uge/ew-1/hardware/exports/voltage_map_heatmap.png

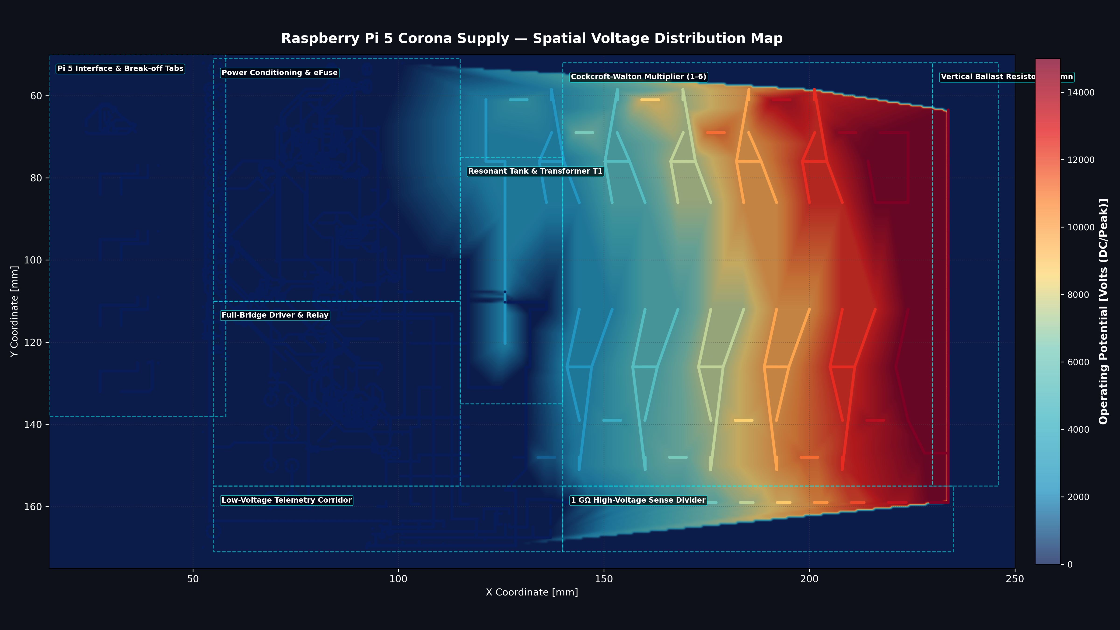
hardware/exports/voltage_map_heatmap.png
