uge/ew-1/hardware/pi5_corona_hat_direct/exports/voltage_map_heatmap.png

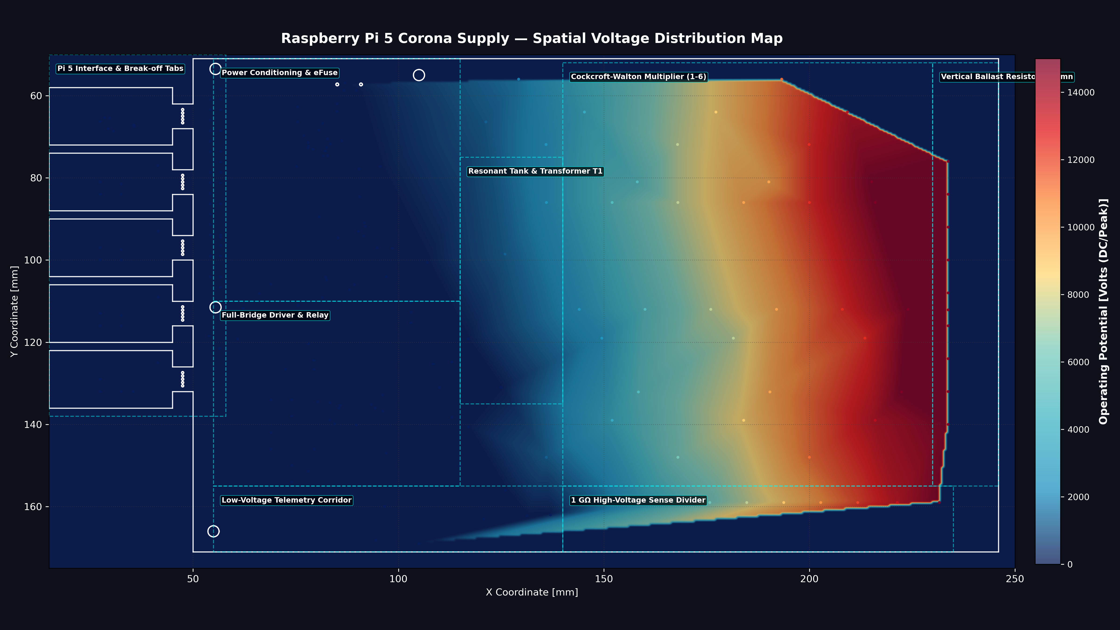
hardware/pi5_corona_hat_direct/exports/voltage_map_heatmap.png
