uge/ew-1/hardware/erc_report.txt

ERC report (2026-09-27T11:31:40, Encoding UTF8)
Report includes: Errors, Warnings

***** Sheet /
[lib_symbol_mismatch]: Symbol 'SRN6028-3R9M' doesn't match copy in library 'ionic_thrust_hv'
    ; warning
    @(76.20 mm, 88.90 mm): Symbol L1 [SRN6028-3R9M]

***** Sheet /01_power_mcu/

***** Sheet /02_drive_transformer/

***** Sheet /03_multiplier/

***** Sheet /04_sense_safety/

 ** ERC messages: 1  Errors 0  Warnings 1

 ** Ignored checks:
    - Global label only appears once in the schematic
    - Four connection points are joined together
    - SPICE model issue
    - Assigned footprint doesn't match footprint filters
