uge/ew-1/docs/ionic_thrust_hv_kicad_handoff.docx

# Ionic Thrust High Voltage Supply KiCad Engineering Handoff

ESP32 controlled 12 V to 15 kV DC corona supply

Item | Value
Document status | Pre schematic engineering handoff
Revision | A
Prepared | 27 September 2026
Intended use | Supervised ionic plasma thrust demonstration in a closed polycarbonate enclosure
Electrical target | 12 V input, approximately 10 to 15 kV positive DC, 150 microampere maximum intended corona current
Primary CAD target | KiCad project with JLCPCB assembly outputs and manually installed high voltage parts

Release condition. Do not order the PCB from this document alone. The KiCad project must complete the open electrical decisions, add the listed safety ECOs, pass ERC and custom high voltage DRC, and complete footprint and polarity reviews.

# Purpose and handoff decision

This document converts the current component workbook and design discussion into a KiCad implementation specification. The baseline is a low current corona source for ionic thrust experiments. It is not an arc generator and should shut down on an arc. The main design path is viable, but the schematic is not ready for fabrication until the bleeder network, current sensing, hardware interlock, exact multiplier polarity, and output connector arrangement are resolved.

The KiCad designer should preserve the existing selected parts unless a conflict is found, annotate all symbols from the schematic, and regenerate the BOM from KiCad. Reference designators in the current workbook are provisional where no schematic yet exists.

## Current design status

Area | Status | Handoff requirement
Power and controller | Defined | Capture AP63203 typical application, ESP32 boot and programming circuits, and always on 3.3 V rail.
Bridge and transformer | Defined with verification | Use DRV8220 DSG and FL2015-4LD. Confirm the primary connection and C11 series resonance on the bench.
Multiplier | Topology pending capture | Draw a positive six stage Cockcroft Walton ladder and independently review every diode and capacitor orientation.
Voltage measurement | Defined | Implement the 1 G ohm divider, TLV9001 follower, ADC isolation resistor, clamp, and RC filtering.
Current measurement | Incomplete | Add a protected ADC path from the 10 k ohm return shunt before claiming active current limiting.
Stored energy discharge | Incomplete | Add one 100 M ohm 3.5 kV resistor across each multiplier capacitor.
Lid interlock | Specified but absent from BOM | Add two normally open lid switches and a DPDT 12 V relay that removes bridge power in hardware.
HV connector | Off board choice | Use a recessed source side socket and prevent energization while disconnected.

# System architecture

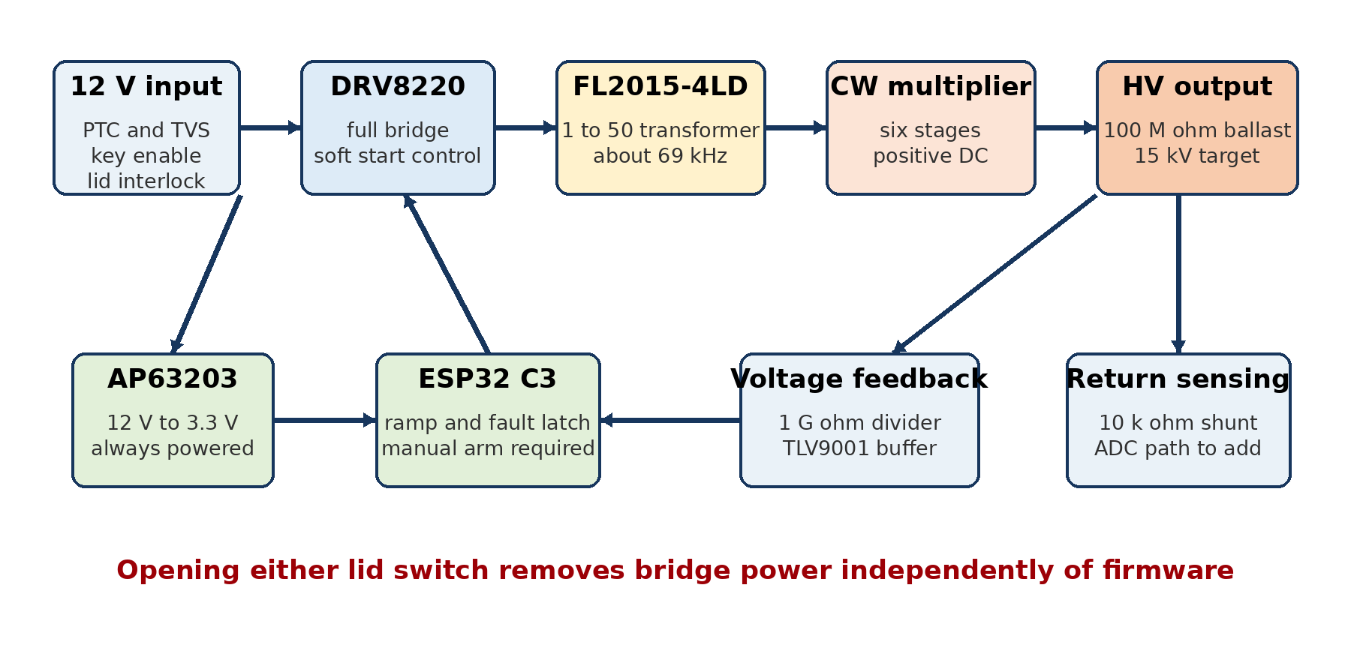
[picture p3: figure]

Figure 1 Electrical and safety architecture

## Nominal calculations

Check | Basis | Nominal result
Primary resonance | 44 microhenry and 120 nanofarad | 69.3 kHz
Ideal unloaded multiplier | 2 times 6 stages times 1000 V RMS times square root of 2 | 17.0 kV
Output setting | Firmware regulated below ideal no load voltage | 10 to 15 kV
Ballast short circuit limit | 15 kV divided by 100 megohm | 150 microampere
Ballast dissipation at short circuit | 15 kV squared divided by 100 megohm | 2.25 W total or 0.225 W per resistor
Divider output at 15 kV | 1 G ohm high side and 164 k ohm low side | 2.46 V
Divider current and loss | 15 kV across 1.000164 G ohm | 15.0 microampere and 0.225 W
Current shunt at target current | 150 microampere through 10 k ohm | 1.50 V

# KiCad project organization

Create one hierarchical project with the high voltage boundary visible at the top level. Avoid a single flat schematic because the physical isolation, return path, and interlock are easier to review when each function has a dedicated sheet.

File or sheet | Purpose | Primary contents
ionic_thrust_hv.kicad_pro | Project configuration | ERC exclusions, text variables, board setup, net classes, fabrication settings
ionic_thrust_hv.kicad_sch | Top level | Functional blocks, hierarchical labels, power partition, test points
01_power_mcu.kicad_sch | Always on low voltage | J1, F1, D2, AP63203, ESP32, reset, boot, UART header, arm switch and LED
02_drive_transformer.kicad_sch | Isolated AC generation | DRV8220, local bypassing, MODE and nSLEEP, C11 and T1
03_multiplier.kicad_sch | High voltage generation | D10 through D21, C20 through C31, per capacitor bleeders and ladder test nodes
04_sense_safety.kicad_sch | Feedback and shutdown | Ballast, voltage divider, TLV9001, current shunt ADC path, interlock relay and connector
ionic_thrust_hv.kicad_sym | Project symbols | FL2015-4LD and any field installable HV device symbols
ionic_thrust_hv.pretty | Project footprints | Transformer, HV diode, HV capacitors, HV resistors, slots and warning markings

## Named nets

Net | Meaning | Layout treatment
VIN_12 | Unprotected 12 V input | Short path to PTC and TVS
VIN_PROTECTED | Protected 12 V and relay coil source | Feeds always on buck and safety chain
HV_VM | Relay switched bridge supply | Bulk and 100 nF bypass at DRV8220
3V3 | Controller and analog rail | Solid low voltage ground reference
DRV_A and DRV_B | Bridge outputs | Short symmetric high di dt loop
PRI_A and PRI_B | Transformer primary ends | C11 is in the chosen resonant path
SEC_A and SEC_B | Floating transformer secondary | Enter multiplier without crossing low voltage copper
CW_P1 through CW_P6 | Multiplier pump nodes | Number explicitly in the schematic and silk
CW_S1 through CW_S6 | Multiplier stack nodes | Use stage based voltage spacing
HV_RAW | Multiplier output before ballast | No external connector
HV_OUT | Current limited positive output | After the ten resistor ballast string
HV_RETURN | Experiment and multiplier return | Connect to GND only through the defined shunt path
HV_SENSE_RAW | Divider low node | Guard from switching nodes and buffer immediately
HV_SENSE_ADC | Protected ESP32 ADC input | After R7 and D1 clamps
INTERLOCK_OK | Hardware interlock feedback | 3.3 V contact logic with physical pulldown

## Proposed ESP32 pin map

This map avoids the GPIO8 and GPIO9 boot strap combination except for the dedicated boot button. Confirm peripheral routing in firmware before final annotation.

Module signal | Function | Notes
GPIO0 ADC1 CH0 | HV voltage sense | Existing design assignment
GPIO1 ADC1 CH1 | HV return current sense | Required ECO with input protection
GPIO3 | INTERLOCK_OK | Pulldown gives open or unpowered state as false
GPIO4 | DRV IN1 or PH | Driver control
GPIO5 | DRV IN2 or EN | Driver control
GPIO6 | ARM input | Momentary switch, active level documented in firmware
GPIO7 | Status LED | Do not use as the only HV safe indication
GPIO9 | BOOT | Momentary switch to ground; retain normal boot pullup
GPIO20 and GPIO21 | UART RX and TX | 3.3 V programming header
EN | Reset | Pullup and reset switch

# Schematic capture requirements

## Power and controller sheet

- Route J1 through F1 to VIN_PROTECTED. Place D2 across VIN_PROTECTED and GND with the cathode at VIN_PROTECTED.
- Implement the AP63203 fixed 3.3 V application from the manufacturer reference: 3.9 microhenry L1, 10 microfarad input capacitance, two 22 microfarad output capacitors, 100 nanofarad bootstrap capacitor, and local grounding.
- Keep the ESP32 module antenna at the board edge and reproduce the manufacturer antenna keepout in every copper, mask, and component layer.
- J2 is a 3.3 V UART programming header for 3V3, GND, TX, RX, EN, and GPIO9. Label the connector pin one and voltage on silk.
- The MCU rail remains powered while the hardware interlock removes HV_VM. This allows fault logging and discharge monitoring after a lid trip.

## Bridge and transformer sheet

- Use the DRV8220 DSG WSON package and include the exposed pad in the footprint and ground connection. Place 100 nanofarad and bulk capacitance directly at VM and GND.
- Provide a physical pulldown on nSLEEP. The relay auxiliary contact must force nSLEEP low when the enclosure is open, regardless of MCU state.
- Select and document one DRV8220 interface mode. The baseline workbook assumes complementary IN1 and IN2 drive. PH and EN mode is an acceptable alternative only after firmware and startup behavior are reviewed.
- Use T1 primary pins 1 and 3 for full winding excitation and leave primary center tap pin 2 unused for the full bridge configuration. Confirm this mapping against Coilcraft schematic A and by continuity before assembly.
- Treat C11 as a provisional series resonant component in the full bridge path. Simulate and bench verify switching current before final release. Add a DNI option or jumper arrangement if direct drive must be compared during bring up.
- T1 secondary pins are 5 and 8 and feedback pins are 4 and 9 under Coilcraft schematic A. Unused physical pads remain present and marked no connect only after the footprint review.

## Multiplier and polarity review

Capture a standard positive half wave six stage Cockcroft Walton multiplier using D10 through D21 and C20 through C31. Use explicit SEC_A, SEC_B, CW_Pn, and CW_Sn labels instead of relying on wire shape. Place a polarity arrow beside every diode and identify HV_RAW and HV_RETURN on both schematic and silk.

- Simulate the ladder with the intended transformer amplitude before assigning the final PCB. Confirm positive HV_OUT relative to HV_RETURN.
- Add one 100 megohm 3.5 kV resistor directly across each C20 through C31. Suggested designators are R40 through R51.
- Do not series connect ordinary low voltage capacitors as substitutes. The selected 1 nanofarad 6 kV parts are manually installed.
- Expose no finger accessible test point. Any HV test pad stays inside the interlocked enclosure and receives a danger marking and keepout.

## Voltage and current measurement

- Place R30 through R39 as a physical ten resistor 1 G ohm string from HV_OUT to HV_SENSE_RAW. Maintain stage appropriate spacing between every resistor body and adjacent copper.
- Use R8 and R9 in series for the 164 k ohm low leg. Place C13 and the TLV9001 input at the low end of the divider, not beside the HV string.
- Configure U4 as a unity gain follower. Route its output through R7 to HV_SENSE_ADC and place the BAT54S clamp at the ESP32 side of R7.
- Add a separate protected current sense path from the 10 k ohm HV_RETURN shunt to GPIO1. Include a series resistor, RC filter, and clamp sized for plausible fault transients. Do not reuse the voltage sense clamp without checking simultaneous injection current.
- Use ADC calibration against a rated external HV probe. Firmware conversion starts near 6.099 kV per ADC volt but must use measured resistor ratios and ADC calibration data.

# Hardware safety interlock

Use two mechanically actuated normally open lid switches at opposite corners. Both must be depressed before the 12 V relay can energize. The switches and relay act only on the low voltage side. No inexpensive microswitch or PCB relay in this design is permitted to switch the 15 kV output.

Reference | Suggested part | LCSC | Connection
S3 and S4 | Omron D2F L lever microswitch | C231337 | COM and NO contacts in series with K1 coil
K1 | N4078 2C DC12V 0.2W DPDT relay | C52195125 | Pole A switches HV_VM; pole B provides nSLEEP and interlock logic
D3 | 1N4148WS or suitable coil flyback diode | Select during capture | Across K1 coil, cathode toward positive supply
S5 | Key enable or latching emergency stop | Off board | In series ahead of the lid switch chain
S6 | Momentary ARM switch | Select during capture | MCU input only; closing the lid must not restart HV

## Interlock sequence

1. Closing and latching the lid depresses both S3 and S4 and permits K1 to energize.

2. K1 supplies HV_VM and releases the hard nSLEEP pulldown. The ESP32 remains disarmed.

3. The operator presses ARM. Firmware checks both interlock state and measured discharge state before starting a controlled voltage ramp.

4. Opening either side of the lid drops K1, removes HV_VM, drives nSLEEP low, and records an interlock fault independently of firmware control outputs.

5. Closing the lid again does not restart the bridge. A new ARM action is required after the measured voltage is safe.

## Mechanical requirements

- Mount the two switches near opposite corners so a flexible lid cannot remain energized when partly open.
- Set the actuators to open within the first 1 to 2 mm of lid travel. Use an overlapping 25 to 40 mm lip so the circuit opens before a hand can reach the HV area.
- Use two latches. Do not use a magnet and reed switch as the sole interlock because a loose magnet can defeat it.
- Polycarbonate is preferred to acrylic for impact resistance. Account for ozone and nitrogen oxide ventilation without creating a finger access path.

# High voltage output connection

For the 15 kV baseline, the stocked TE LGH pair 5-861610-3 and 5-862197-3 is rated 20 kVDC. Because the bulkhead receptacle uses a pin contact, do not place an energized exposed pin on the generator panel. Use a permanently attached generator pigtail terminated in the recessed socket plug, or select a source side female bulkhead system.

Option | Use | Decision
TE LGH 20 kV | Baseline at a controlled 15 kV maximum | Accept only with recessed source contact, clean dry mating surfaces, and interlock disable while disconnected
Amphenol Alden B series 35 to 40 kV | Preferred where arcs or contamination are expected | Higher margin and cost; suitable upgrade before intentional arc tests
Permanent potted HV lead | Lowest cost supervised prototype | Often safer and cheaper than a removable connector when the electrode assembly is fixed

# PCB layout and KiCad design rules

Use a two layer board unless a later review establishes an inner layer isolation strategy. Keep low voltage ground pours in the controller and driver region only. Do not place copper, vias, planes, mounting hardware, or silkscreen text beneath the multiplier, divider string, transformer secondary, or HV connector region.

Rule group | Starting rule | Implementation note
LV_SIGNAL | 0.20 mm clearance and 0.20 mm track | ESP32, analog, UART and control
12V_POWER | 0.25 mm clearance and at least 0.50 mm track | Increase bridge supply width from measured input current
PRIMARY_SWITCH | 0.50 mm clearance and 0.75 to 1.00 mm track | Minimize DRV8220, C11 and T1 loop area
HV_STAGE | At least 4 mm between adjacent ladder stage copper | Assumes about 2.8 kV maximum capacitor stress; enlarge where board area permits
HV_HIGH_TO_LV | At least 20 mm plus routed isolation slots | Use 25 mm if operation may reach 20 kV
HV_OUT_TO_EDGE | At least 10 mm | More near mounting holes, fasteners, vents, and enclosure seams
HV_DIVIDER | Stage the resistor string physically | No single resistor or pad sees the entire output voltage

These are conservative project rules for a clean, enclosed laboratory prototype, not an IEC or UL compliance claim. Pollution degree, altitude, material group, coating qualification, enclosure geometry, and manufacturing residue can require larger distances. Do not reduce spacing because conformal coating is planned.

## Placement order

1. Place ESP32 and its antenna keepout at one board edge.

2. Place J1, F1, D2, AP63203, and the low voltage controls together.

3. Place DRV8220, local bypassing, C11, and T1 primary as one compact switching region.

4. Rotate T1 so its secondary faces directly into the first multiplier stage.

5. Arrange the six multiplier stages as a straight or gently folded ladder with monotonically increasing physical voltage.

6. Place the output ballast and divider as separate long strings leading away from the low voltage section.

7. Place U4 and low side sensing at the grounded end of the divider behind an isolation slot.

## Custom footprint requirements

Footprint | Requirement
Coilcraft FL2015-4LD Package 1 | Create from the current manufacturer drawing. Package uses 2.50 mm terminal pitch and manufacturer recommended lands. Include complete pad numbering, courtyard, pin one mark, body outline, and secondary side marking. Print 1 to 1 and verify against a sample.
DO 722 HVM12 | Use the manufacturer body and lead dimensions. Provide adequate lead forming and keep the body raised only if the assembly procedure specifies it.
6 kV disc capacitor | Verify lead pitch, body diameter, thickness, and body to board spacing from the selected Vishay part. Do not substitute a generic 10 mm pitch footprint without the body check.
3.5 kV axial resistor | Use the actual body length and 15.24 mm lead pitch. Keep exposed leads short while preserving pad to pad clearance.
Isolation slots | Use Edge Cuts geometry with rounded slot ends. Obtain JLCPCB minimum routed slot capability before finalizing width.

# Existing component mapping

The following tables reproduce the current workbook selections. KiCad annotation remains authoritative after schematic capture. Any changed reference, quantity, footprint, or MPN must be reconciled back into the assembly BOM.

Ref | MPN or value | Footprint | LCSC | Qty
U1 | ESP32-C3-WROOM-02-H4 | ESP32-C3-WROOM-02 | C2944070 | 1
U2 | DRV8220DSGR | WSON-8-EP_2x2mm_P0.5mm | C3681269 | 1
U3 | AP63203WU-7 | TSOT-23-6 | C780769 | 1
L1 | SRN6028-3R9M | Inductor_SMD_6x6mm | C2046441 | 1
C1,C2 | CC0805KKX5R8BB106 | C_0805_2012Metric | C89831 | 2
C3,C4 | TCC0805X5R226M100FT | C_0805_2012Metric | C380338 | 2
C5,C6,C7,C8,C9,C10,C12,C13 | CC0603KRX7R9BB104 | C_0603_1608Metric | C14663 | 8
R1,R2,R3,R4,R5 | 0603WAF1002T5E | R_0603_1608Metric | C25804 | 5
R6,R7 | 0603WAF1001T5E | R_0603_1608Metric | C21190 | 2
R8,R9 | 0603WAF8202T5E | R_0603_1608Metric | C23254 | 2
D1 | BAT54S | SOT-23 | C83935 | 1
D2 | SMAJ18A | SMA | C173513 | 1
F1 | nSMD100-16V | Fuse_1206_3216Metric | C70082 | 1
LED1 | 19-217/GHC-YR1S2/3T | LED_0603_1608Metric | C72043 | 1
SW1,SW2 | TS-1187A-B-A-B | SW_SMD_5.1x5.1mm | C318884 | 2
U4 | TLV9001IDBVR | SOT-23-5 | C398363 | 1

## Manual high voltage and through hole parts

Ref | MPN | Footprint | LCSC or source | Qty
J1 | WJ500V-5.08-2P | TerminalBlock_1x02_P5.08mm | C8465 | 1
J2 | DS1021-1x6SF11-B | PinHeader_1x06_P2.54mm_Vertical | C7430362 | 1
T1 | FL2015-4LD | Coilcraft_FL2015-4L_custom | Customer supplied | 1
C11 | BFC236821124 | C_Radial_P10.0mm | C3771644 | 1
D10-D21 | HVM12 | DO-722_custom | C7436450 | 12
C20-C31 | S102M59Z5UU83L0R | C_Disc_P10.0mm | C1620009 | 12
R20-R29 | MGR0W2J0106A10 | R_Axial_D3.5xL9.5_P15.24mm | C51904770 | 10
R30-R39 | MGR0W2J0107A10 | R_Axial_D3.5xL9.5_P15.24mm | C51904773 | 10

## Required BOM changes before fabrication

Change | Part or quantity | Reason
Add | 12 additional 100 M ohm 3.5 kV resistors, suggested R40 to R51 | One permanent bleeder across every multiplier capacitor
Add | Two Omron D2F L lid switches | Redundant case closure detection
Add | One 12 V DPDT relay and one coil diode | Hardware removal of bridge power and nSLEEP release
Add | Current sense filter and clamp parts | Protected ADC measurement of the 10 k ohm return shunt
Add | MODE strap and optional tuning or DNI components | Unambiguous DRV8220 interface selection and controlled bring up
Add or document | ARM switch, key enable or emergency stop, HV cable and connector | Off board safety and enclosure wiring
Review | F1 1 A trip margin | Confirm against measured resonant startup and steady state current

# Firmware interface and fault behavior

Firmware supports the electrical safety system but does not replace it. K1 must remove HV_VM even if the ESP32 is halted, rebooting, or holding a driver input active.

State | Bridge action | Exit condition
SAFE | HV_VM removed or nSLEEP low; PWM outputs low | Both lid switches closed and operator requests ARM
ARMED | K1 energized, bridge still idle | Interlock stable and measured voltage below safe threshold
RAMP | Increase drive gradually from zero | Target voltage reached or any limit trips
CORONA RUN | Regulate at the lowest stable corona voltage | Stop request, interlock opening, overvoltage, overcurrent, or arc signature
FAULT | PWM low and nSLEEP low; K1 drops where hardware chain is open | Voltage verified safe and operator manually rearms

- Start near the measured transformer resonance, expected around 69 kHz, and tune only within the validated transformer and driver range.
- Set the software voltage ceiling at or below 15 kV for the 20 kV connector baseline.
- Treat a rapid voltage collapse accompanied by rising current as an arc. Disable the bridge and latch the fault instead of attempting to sustain the arc.
- Do not display HV SAFE until the calibrated divider reports below 50 V continuously for at least one second. The indicator is supplemental; the discharge procedure still requires verification during service.
- Closing the lid never causes automatic restart.

# Bring up and validation plan

1. Run KiCad ERC. Resolve every power input, unconnected pin, and hierarchical label warning deliberately. Do not blanket suppress warnings.

2. Run standard DRC and the project specific HV clearance rules. Inspect the Gerbers and drill files for copper under slots, unexpected pours, and solder mask openings.

3. Assemble only the low voltage supply and ESP32. Verify 3.3 V, reset, boot mode, UART programming, and arm input behavior from a current limited 12 V source.

4. Populate DRV8220 without T1. Verify nSLEEP defaults low and opening either lid switch removes HV_VM. Exercise both switches separately and flex the lid at every edge.

5. Install T1 and test at reduced input voltage. Observe primary current with isolated instrumentation. Tune frequency and duty while remaining below transformer and driver limits.

6. Install the multiplier, ballast, divider, and bleeders. Begin with low drive and use only a probe rated above the maximum output. Never attach a normal oscilloscope ground lead to an HV node.

7. Calibrate voltage ADC gain and offset. Verify current sense at several known microampere loads made from suitably rated resistor strings.

8. Measure discharge time after shutdown and after an interlock trip. Require less than 50 V within five seconds or revise the bleeder network and indication logic.

9. Operate into the intended corona electrode inside the closed enclosure. Confirm stable corona, no visible arc, no surface tracking, and no reset or communication upset.

## Acceptance checklist

Check | Acceptance
Low voltage rail | 3.3 V remains within regulator tolerance during WiFi activity and bridge startup
Interlock | Either lid switch independently removes HV_VM and forces driver sleep without firmware cooperation
No automatic restart | Lid reclosure leaves the bridge idle until a new ARM command
Voltage limit | Calibrated output cannot exceed the approved 15 kV setting in normal control
Current limit | Ballast and measured current hold the intended corona current at or below 150 microampere
Arc response | Intentional small fault gap causes prompt shutdown and a latched fault, not repeated striking
Discharge | All multiplier sections and HV_OUT measure below 50 V within the approved interval
EMI behavior | ESP32 does not reset and interlock input does not chatter during corona operation
Thermal | DRV8220, transformer, resistors, and regulator remain within rated temperature at continuous operation
Documentation | Schematic, PCB, BOM, CPL, Gerbers, drill files, firmware pin map, calibration constants, and test results share one revision

# KiCad release deliverables

Deliverable | Required content
Schematic PDF | All hierarchical sheets, net names, resistor chain order, diode polarity, interlock contacts, connector pinout, and design notes
KiCad source | Project, schematic sheets, PCB, project symbol library, project footprint library, 3D models where available
Fabrication package | Gerbers, drill and route files, board drawing, stackup note, HV slot dimensions, and fabrication readme
JLCPCB assembly package | BOM and CPL generated from the released PCB with LCSC numbers and DNP status
Manual assembly list | Transformer, film capacitor, multiplier components, HV resistor strings, connector, relay, switches, wire, and enclosure hardware
Firmware interface | GPIO assignment, driver mode, fault thresholds, ADC calibration, arm sequence, and safe state behavior
Test record | Rail checks, waveforms, calibrated HV readings, current readings, interlock tests, discharge time, thermal observations

# Open decisions requiring signoff

Decision | Owner evidence needed
DRV8220 control mode and C11 placement | Schematic simulation and reduced voltage primary current waveform
Exact Cockcroft Walton node topology and polarity | Independent schematic review plus simulated positive output
Current sense input protection | Worst case transient calculation and bench injection test
HV connector or permanent lead | Enclosure drawing showing recessed source contact and interlock relationship
Final creepage and clearance | PCB review using actual enclosure, altitude, contamination, materials, and fabrication constraints
Discharge network | Measured capacitor and output decay to below 50 V
Arc testing scope | If intentional arcs remain required, upgrade the connector and protection plan before testing

# Manufacturer references

- Texas Instruments DRV8220 datasheet, https://www.ti.com/lit/ds/symlink/drv8220.pdf
- Diodes Incorporated AP63200 AP63201 AP63203 AP63205 datasheet, https://www.diodes.com/assets/Datasheets/AP63200-AP63201-AP63203-AP63205.pdf
- Espressif ESP32 C3 WROOM 02 datasheet, https://documentation.espressif.com/esp32-c3-wroom-02_datasheet_en.html
- Coilcraft FL Series CCFL transformer datasheet, https://www.coilcraft.com/getmedia/6651db01-d153-47d9-8a27-4758c28bff0d/fl.pdf
- TE Connectivity LGH 20 kV plug 5-861610-3 and receptacle 5-862197-3 product documentation
- Current project BOM workbook, jlcpcb_ionic_thrust_hv_supply_bom.xlsx, version 1

High voltage warning. This circuit can retain hazardous charge after input power is removed. Work only with the enclosure closed during operation, use appropriately rated probes and insulated tools, and verify discharge before service. Corona and arcs generate ozone, nitrogen oxides, heat, ultraviolet light, and electromagnetic interference.

Revision A | 27 September 2026 | Page

Ionic thrust high voltage supply KiCad engineering handoff
