uge/ew-1/docs/README.md

# Reference documents

The active editable project is [N-layout-17-hv-warnings](../hardware/pi5_corona_hat_direct/README.md).
Use its [validation workflow](../hardware/pi5_corona_hat_direct/layout/README.md)
and [current design status](../hardware/pi5_corona_hat_direct/AUDIT.md).

The original handoff documents, PDF, media and older runbook in this directory
are historical reference. Their older controller, layer-stack, filenames and
production-readiness statements do not override the active native design.
