uge/ew-1/hardware/archives/README.md

# Project archives

- `pi5-corona-hv-N-layout-14-surge-2026-10-19.tar.gz`: complete versioned working-tree checkpoint of **N-layout-14-surge**, created 2026-10-19. Includes 542 project files plus an archive README and per-file SHA-256 manifest.

Verify the archive with `sha256sum -c pi5-corona-hv-N-layout-14-surge-2026-10-19.tar.gz.sha256` from this directory. Extract it and open `pi5_corona_hat_direct/pi5_corona_hv.kicad_pro` in KiCad 10. Standard KiCad libraries are required.

This is a design checkpoint. Existing HV insulation/arc qualification remains open; included manufacturing exports may represent earlier revisions.
