uge/ew-1/hardware/pi5_corona_hat_direct/01_power_mcu.png

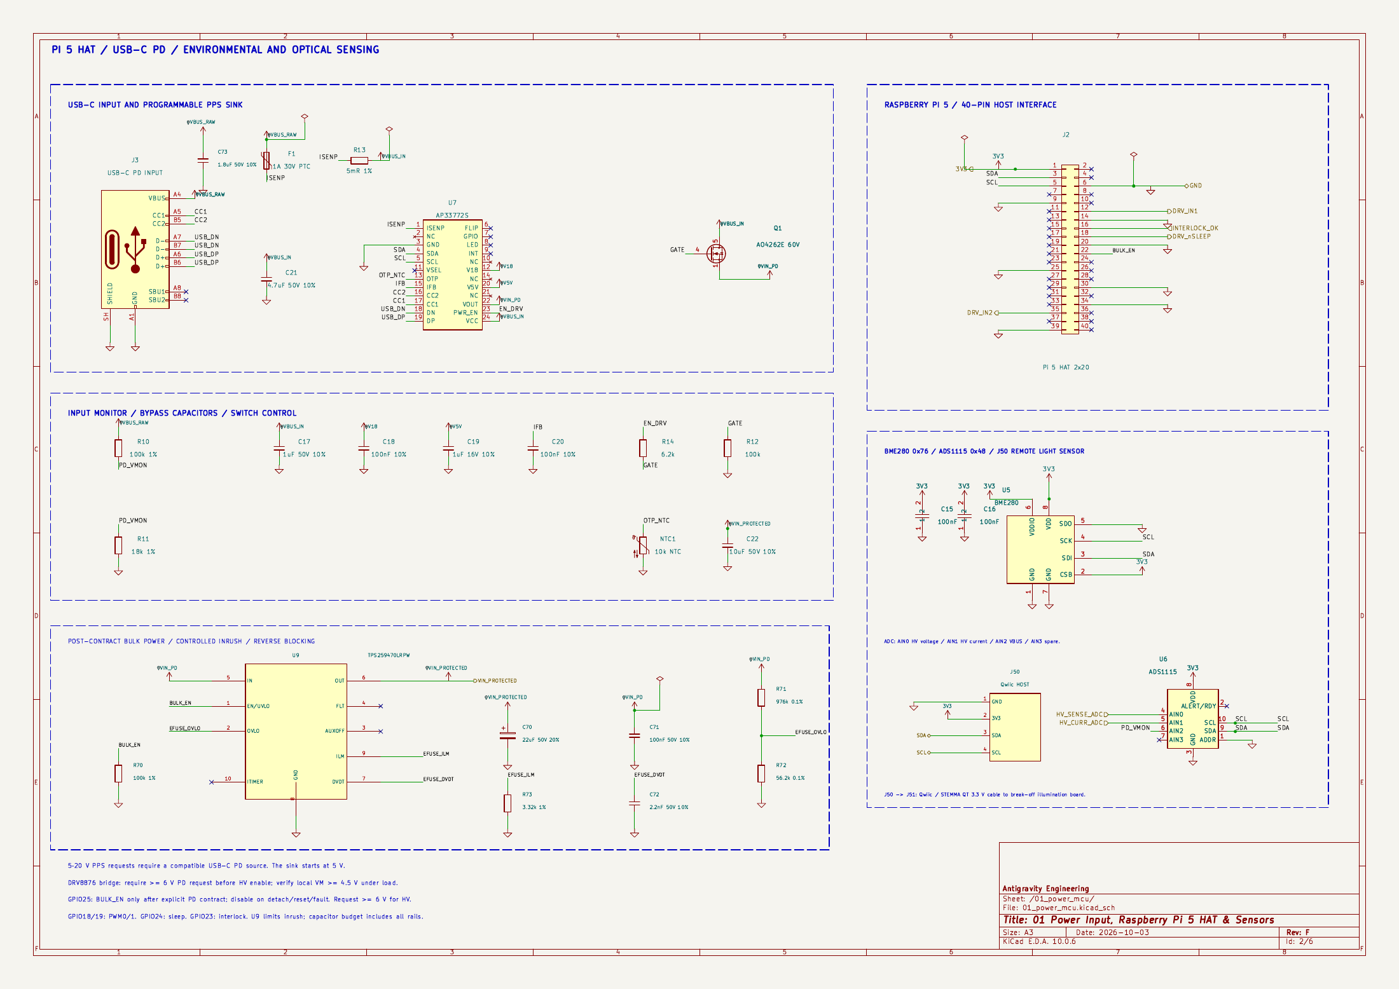
hardware/pi5_corona_hat_direct/01_power_mcu.png
