uge/ew-1/hardware/pi5_corona_hat_direct/exports/00_system_overview.png

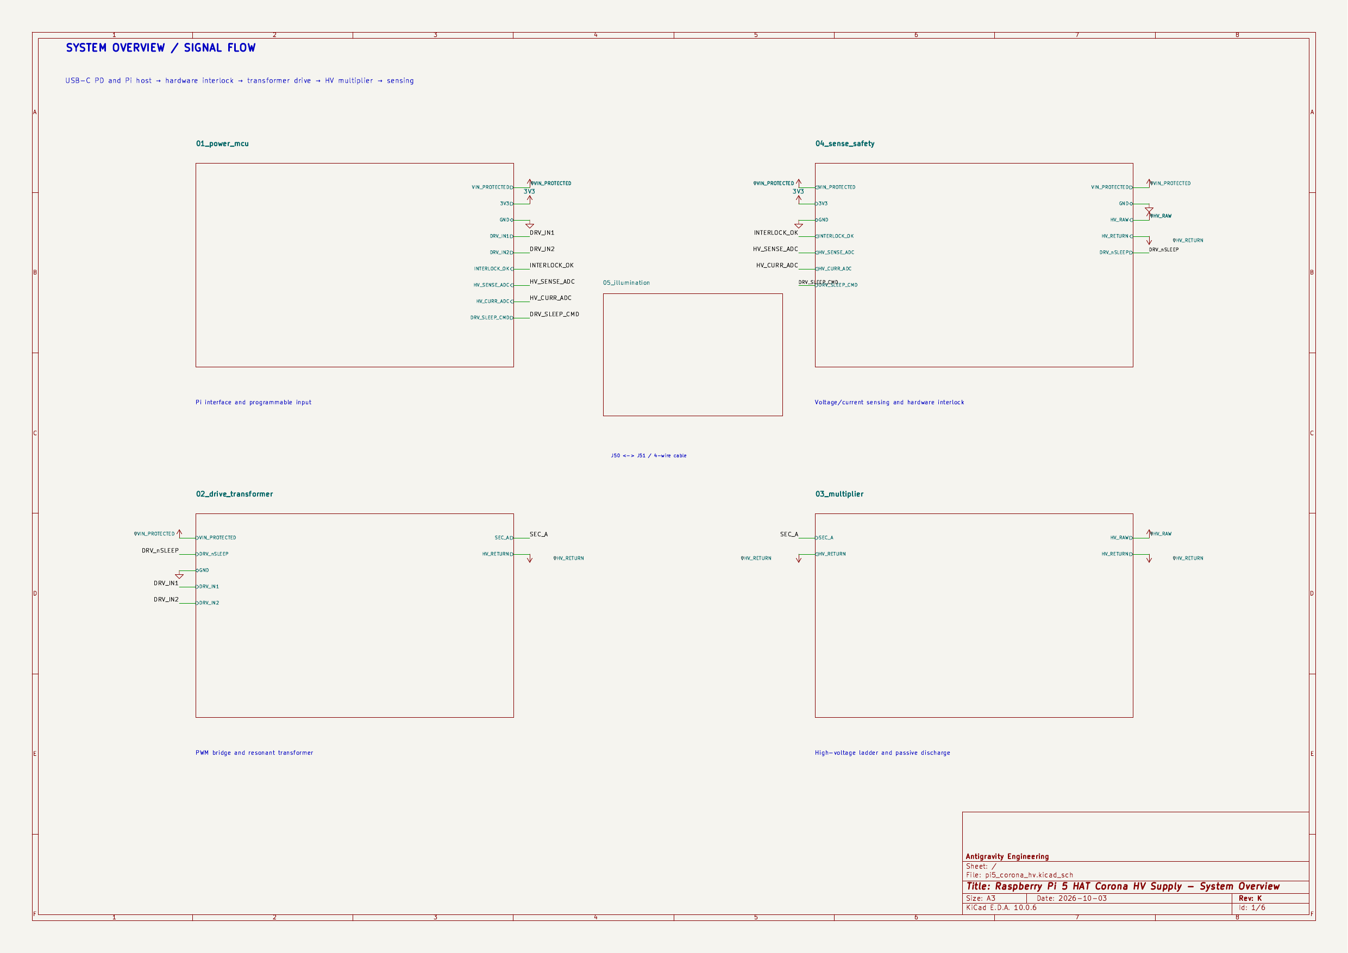
hardware/pi5_corona_hat_direct/exports/00_system_overview.png
