uge/ew-1/hardware/pi5_corona_hat_direct/exports/02_drive_transformer.png

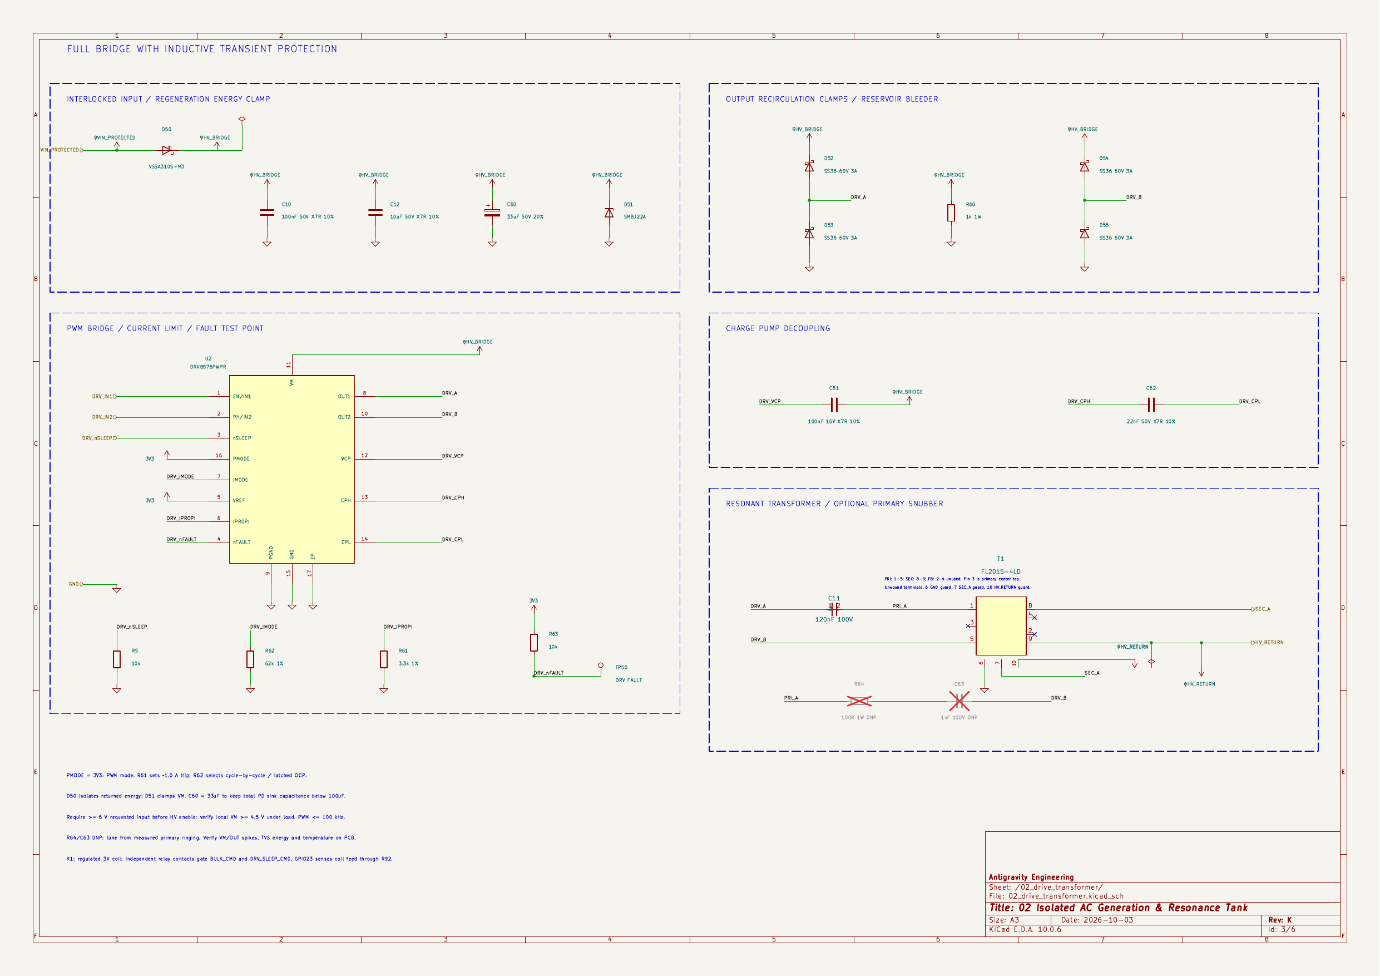
hardware/pi5_corona_hat_direct/exports/02_drive_transformer.png
