uge/ew-1/hardware/pi5_corona_hat_direct/exports/03_multiplier.png

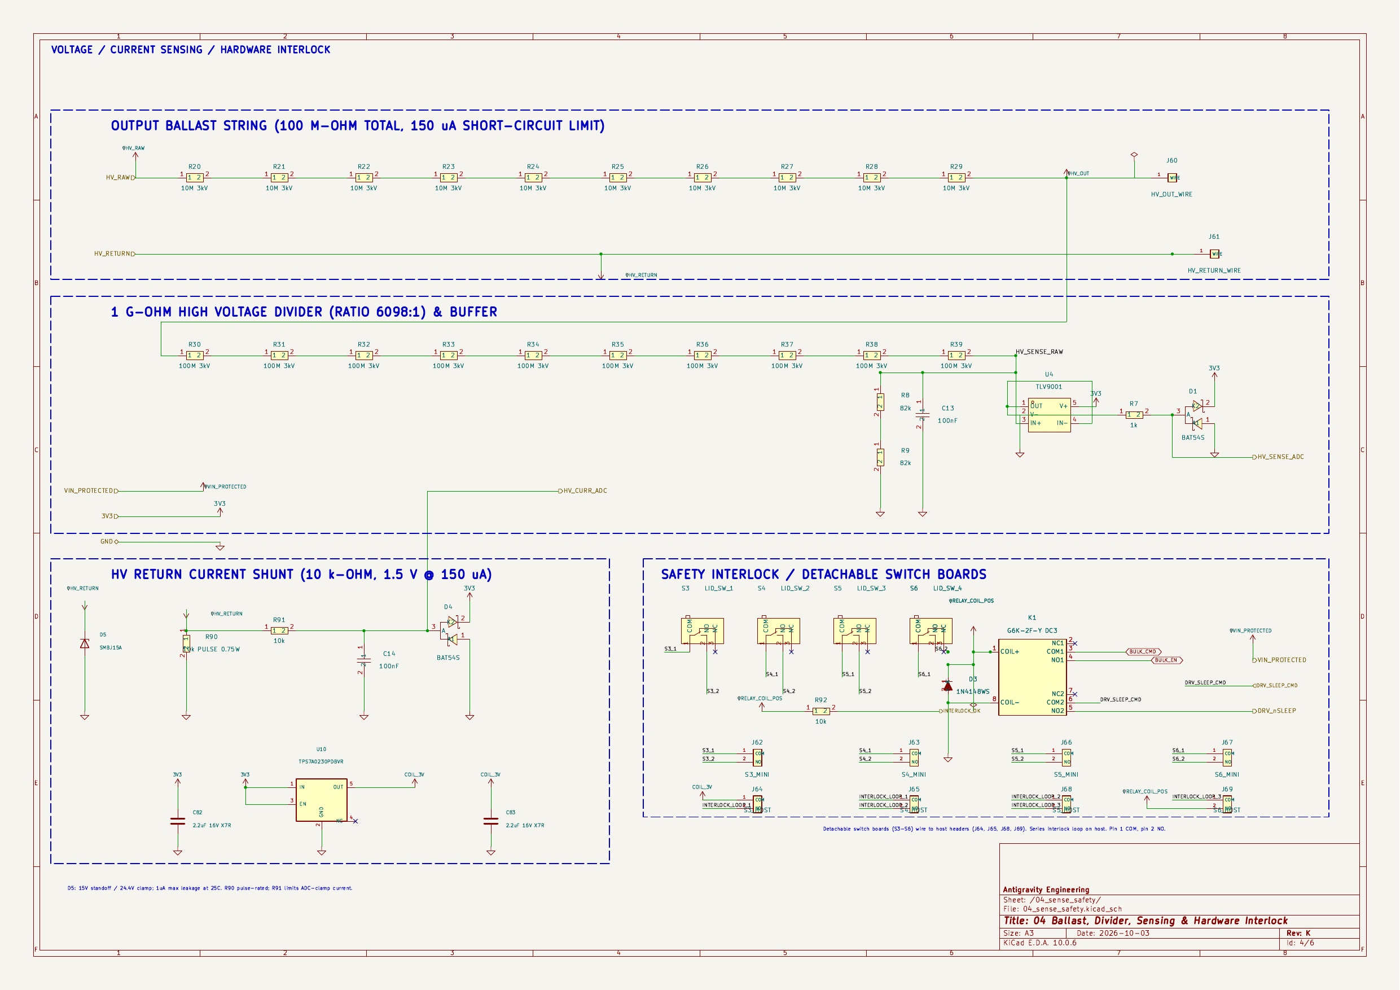
hardware/pi5_corona_hat_direct/exports/03_multiplier.png
