uge/ew-1/hardware/pi5_corona_hat_direct/exports/04_sense_safety.png

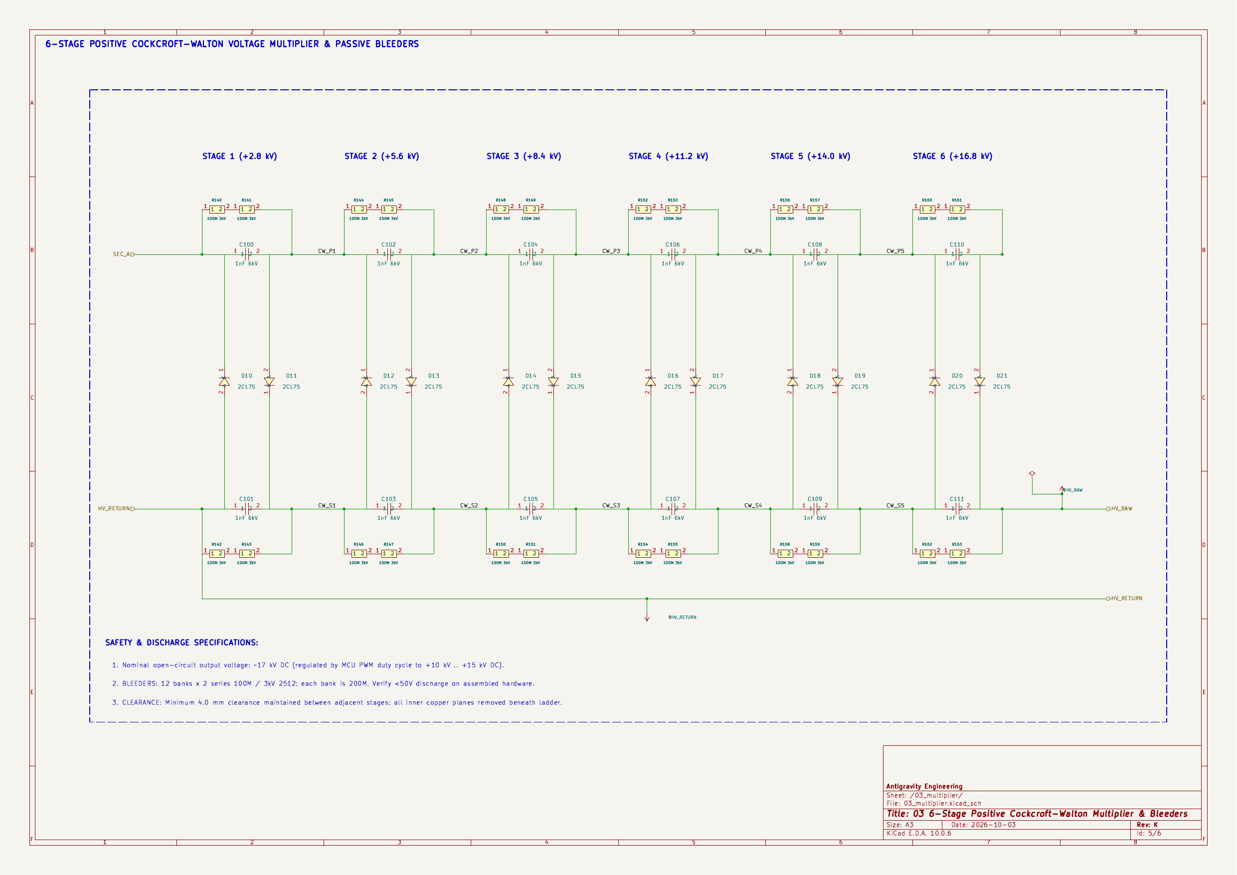
hardware/pi5_corona_hat_direct/exports/04_sense_safety.png
