uge/ew-1/hardware/pi5_corona_hat_direct/exports/05_illumination.png

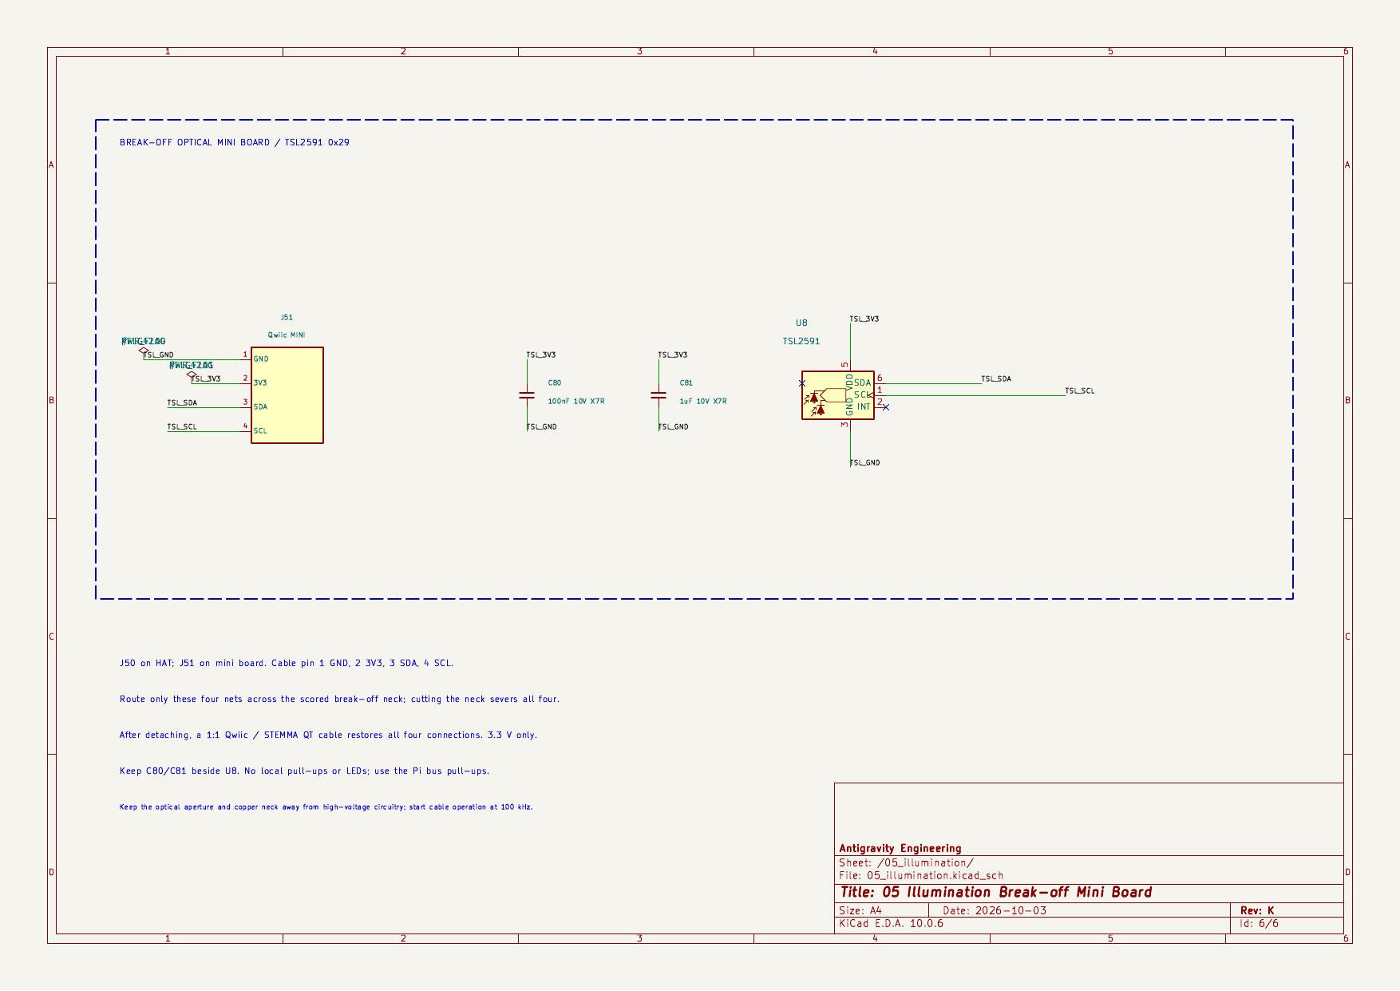
hardware/pi5_corona_hat_direct/exports/05_illumination.png
