uge/ew-1/hardware/pi5_corona_hat_direct/exports/hv-return-layout.png

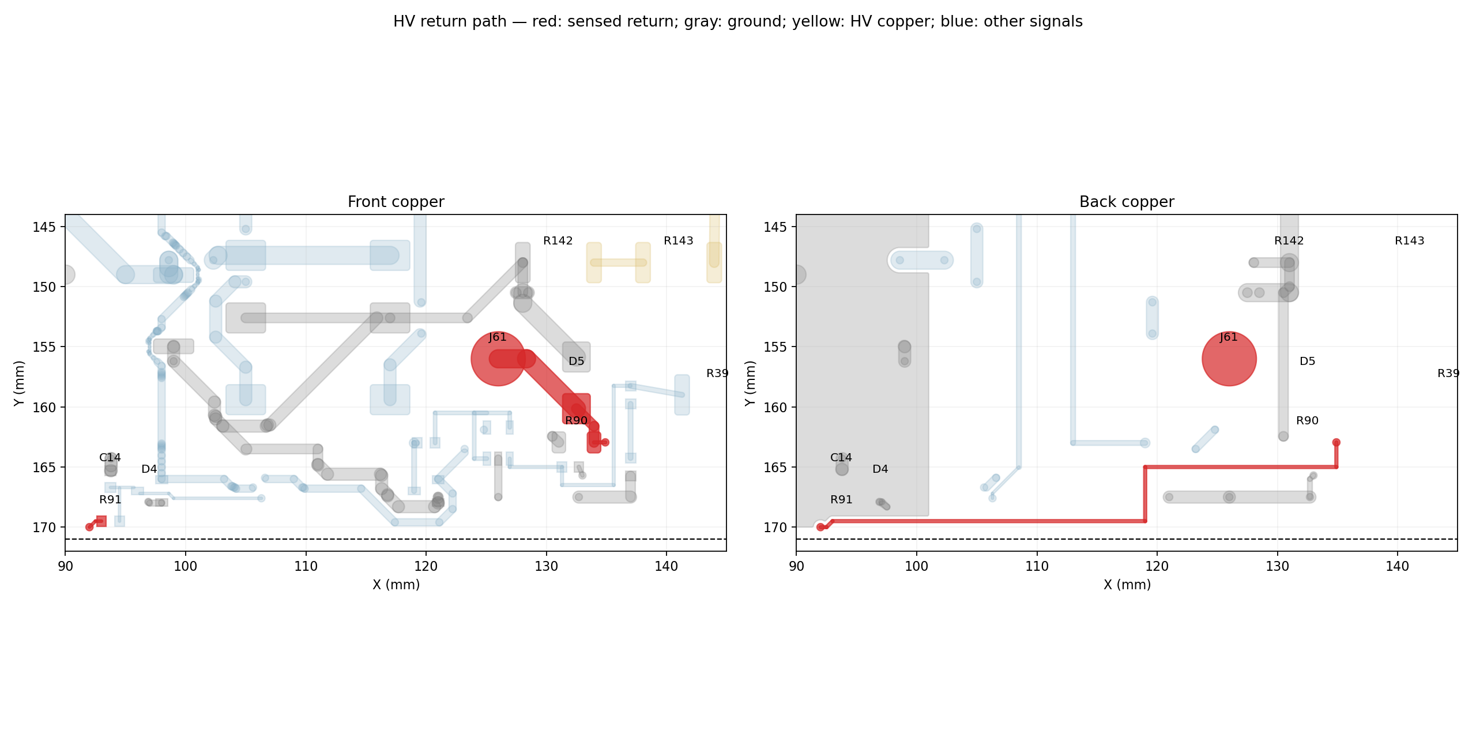
hardware/pi5_corona_hat_direct/exports/hv-return-layout.png
