uge/ew-1/hardware/pi5_corona_hat_direct/exports/initial-pcb-layout.png

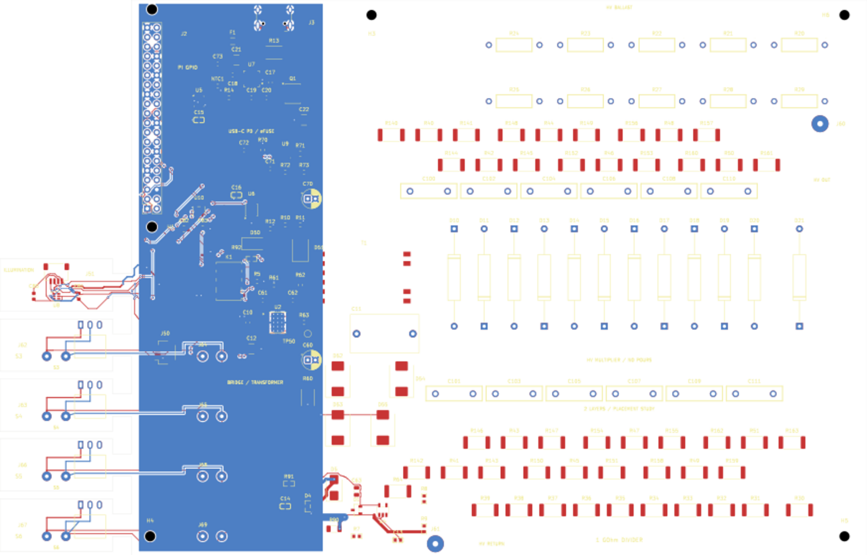
hardware/pi5_corona_hat_direct/exports/initial-pcb-layout.png
