uge/ew-1/hardware/pi5_corona_hat_direct/exports/jlcpcb-N-layout-17-hv-warnings/hv-warning-back.png

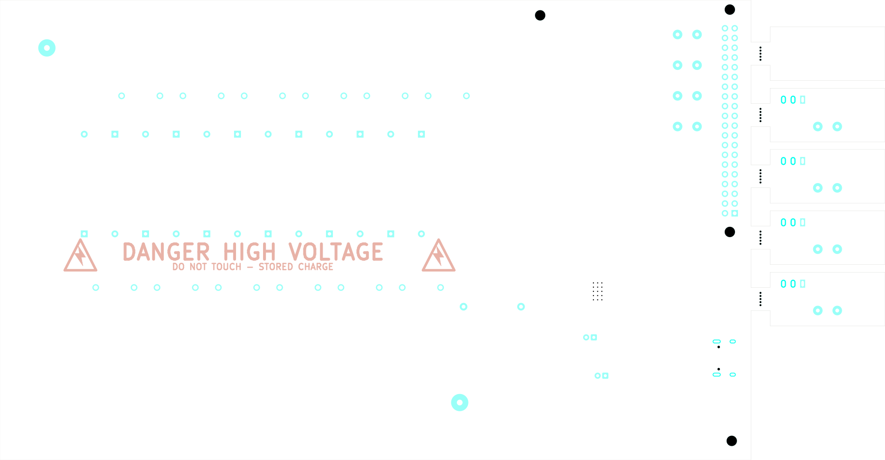
hardware/pi5_corona_hat_direct/exports/jlcpcb-N-layout-17-hv-warnings/hv-warning-back.png
