uge/ew-1/hardware/pi5_corona_hat_direct/exports/pi5-mechanical-bottom.png

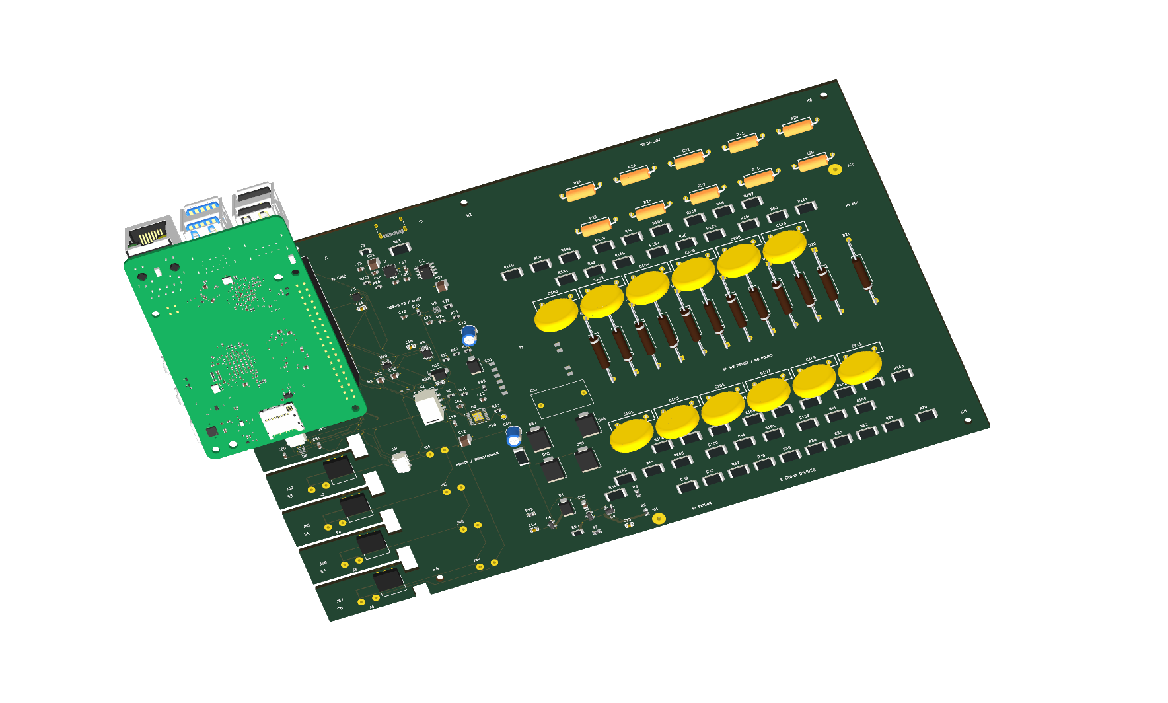
hardware/pi5_corona_hat_direct/exports/pi5-mechanical-bottom.png
