uge/ew-1/hardware/pi5_corona_hat_direct/exports/spice_multiplier_analysis.png

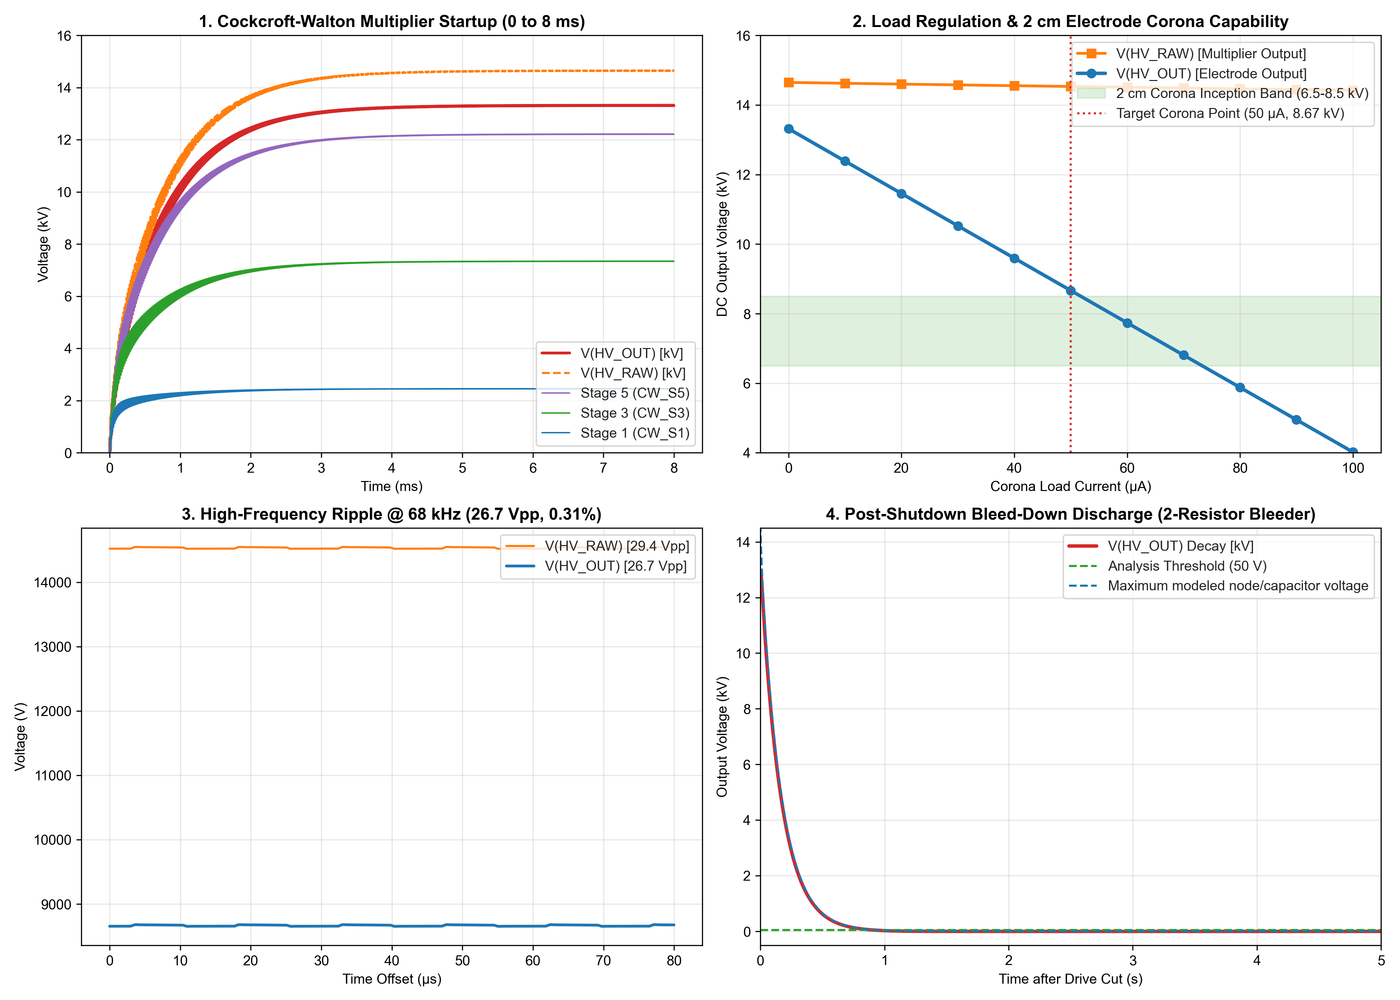
hardware/pi5_corona_hat_direct/exports/spice_multiplier_analysis.png
