uge/ew-1/hardware/pi5_corona_hat_direct/renders/board_bottom.png

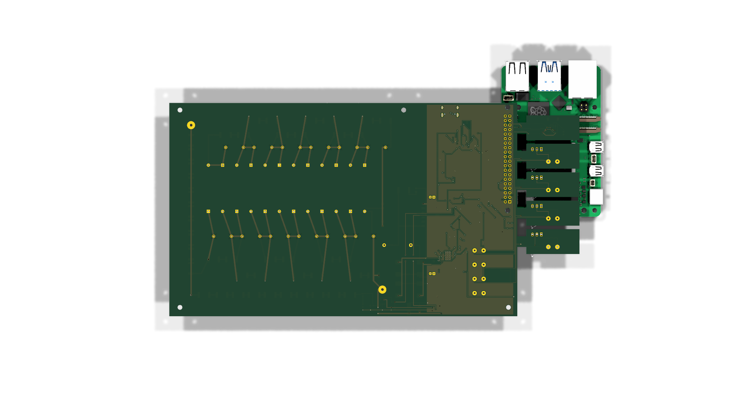
hardware/pi5_corona_hat_direct/renders/board_bottom.png
