uge/ew-1/hardware/pi5_corona_hat_direct/renders/hv-warning-front.png

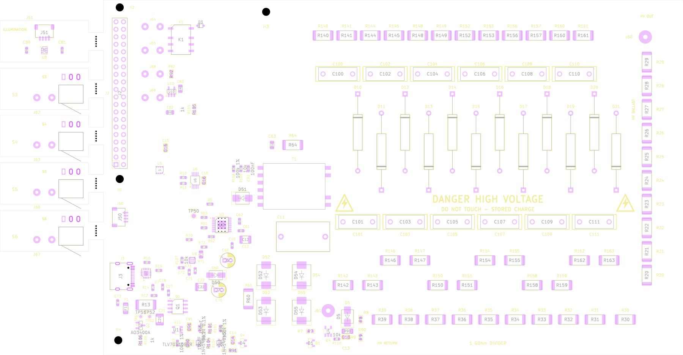
hardware/pi5_corona_hat_direct/renders/hv-warning-front.png
