uge/ew-1/hardware/pi5_corona_hat_direct/renders/pcb_render_iso.png

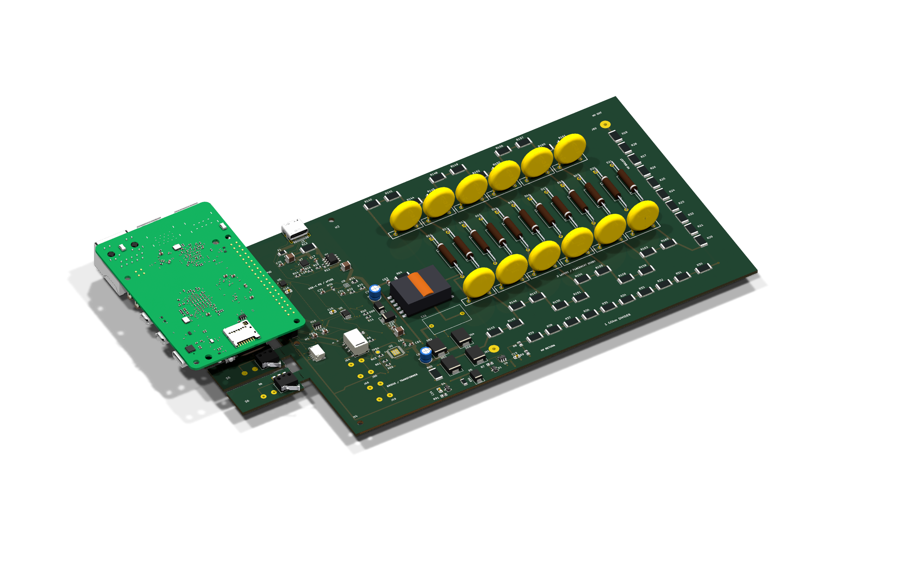
hardware/pi5_corona_hat_direct/renders/pcb_render_iso.png
