uge/ew-1/hardware/pi5_corona_hat_direct/renders/tabs_microswitches_closeup.png

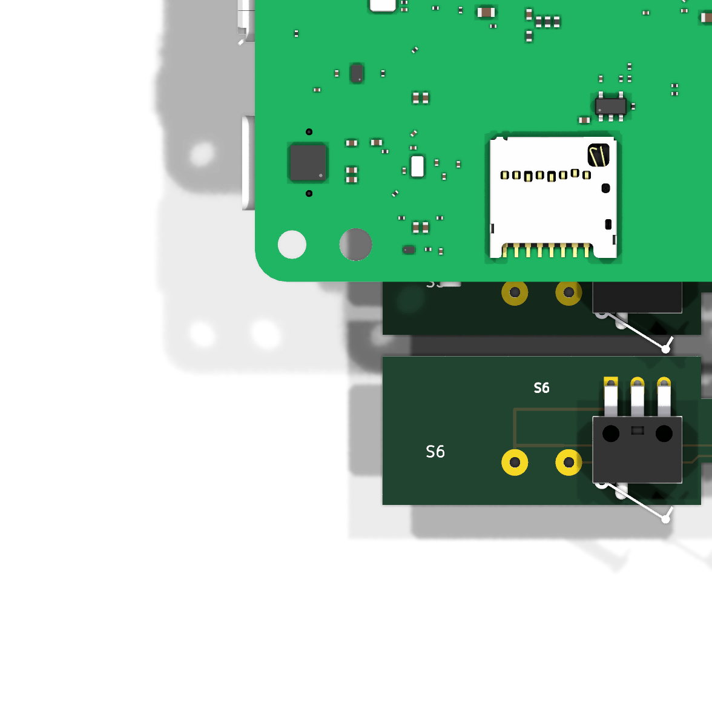
hardware/pi5_corona_hat_direct/renders/tabs_microswitches_closeup.png
