uge/ew-1/hardware/renders/sheet-1.png

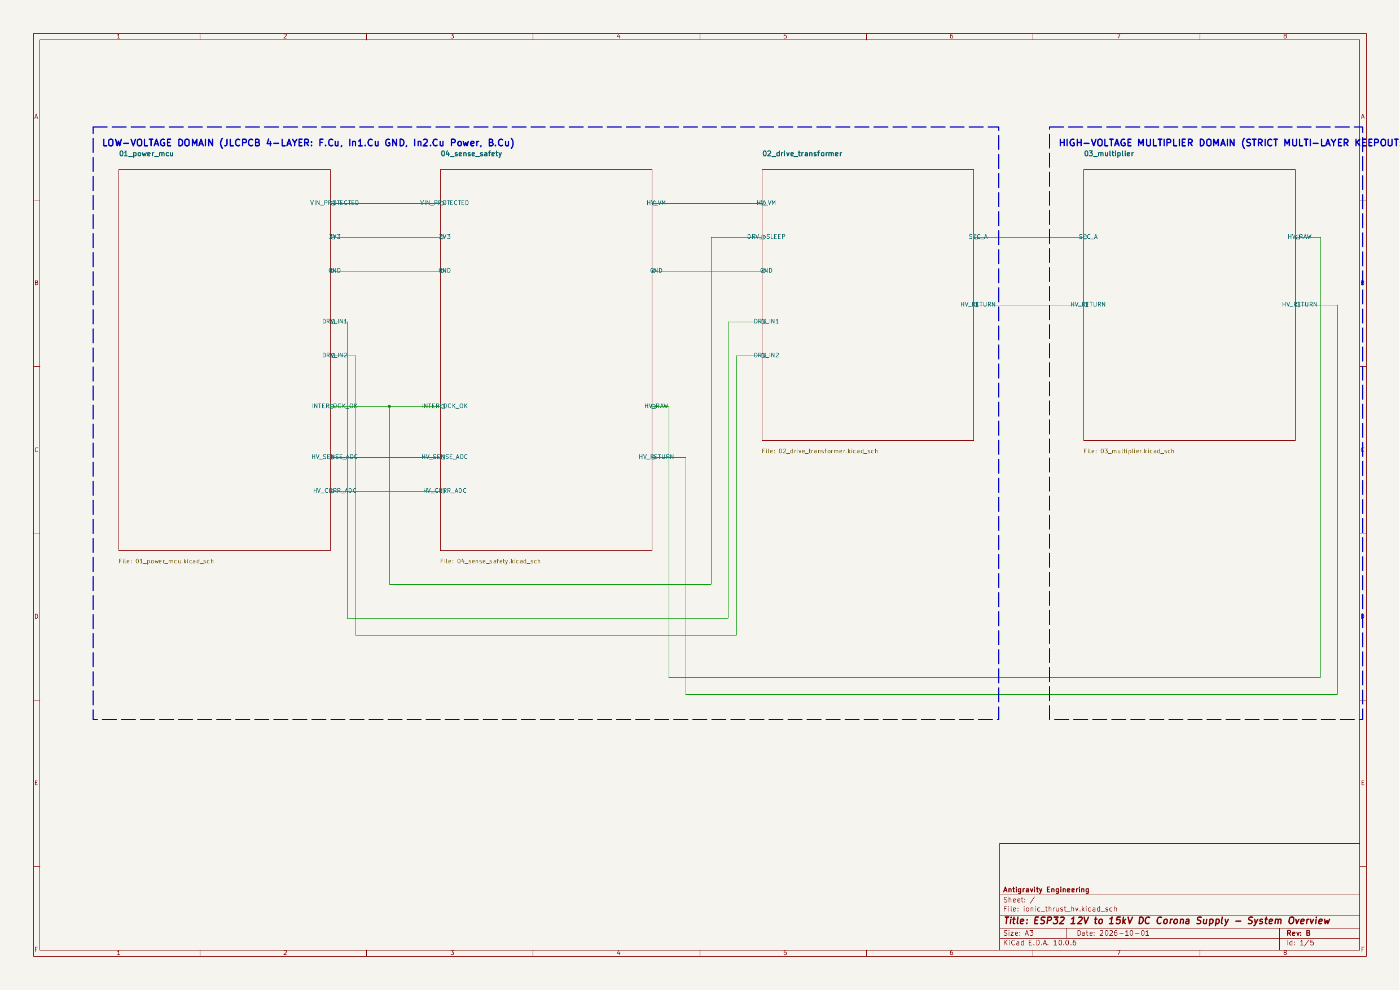
hardware/renders/sheet-1.png
