uge/ew-1/hardware/renders/sheet-2.png

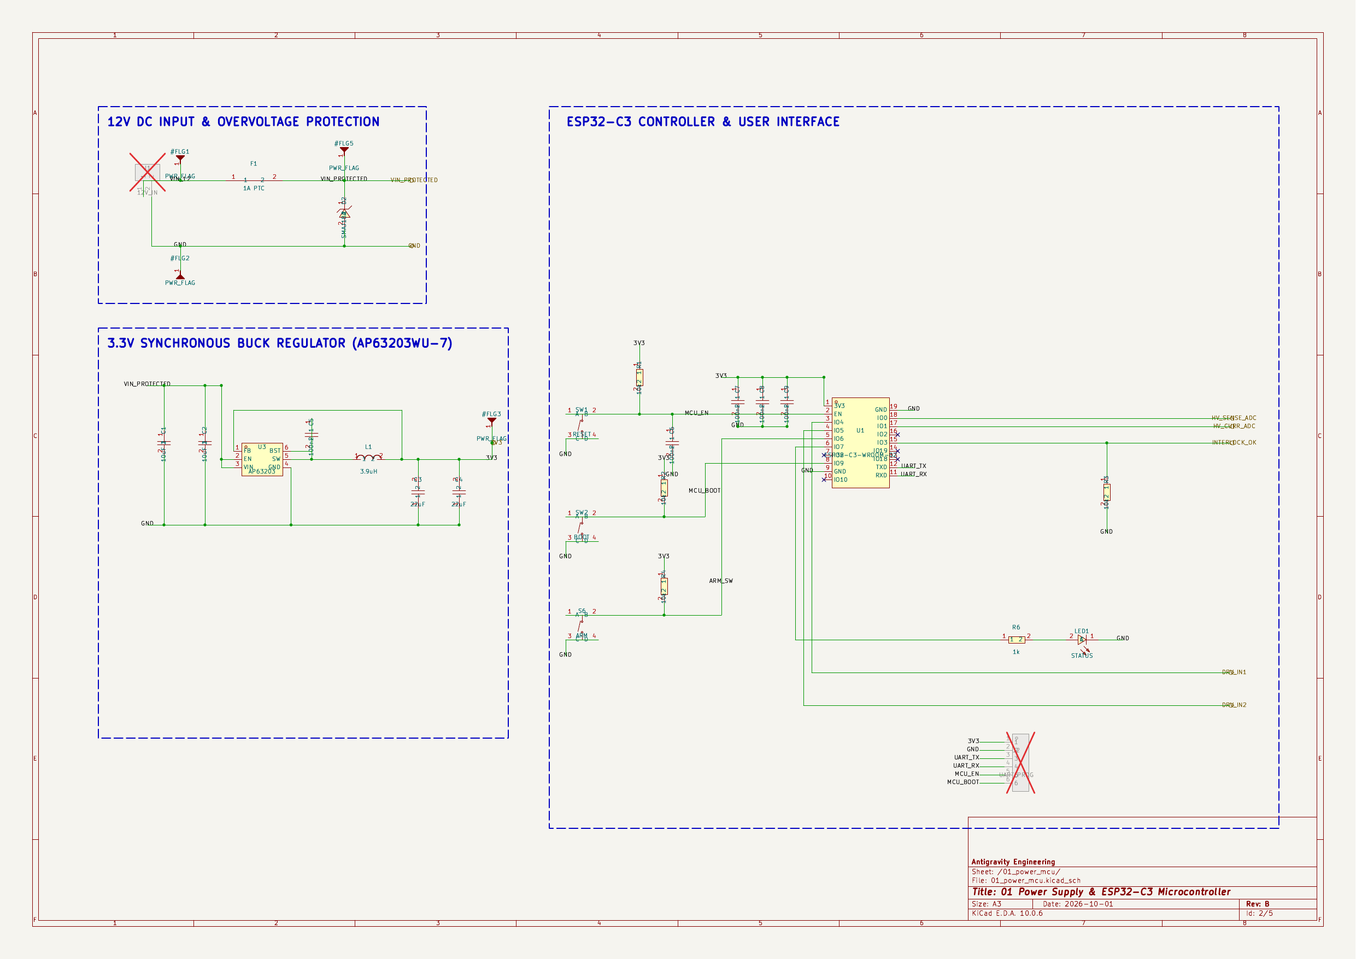
hardware/renders/sheet-2.png
