uge/ew-1/hardware/renders/sheet-3.png

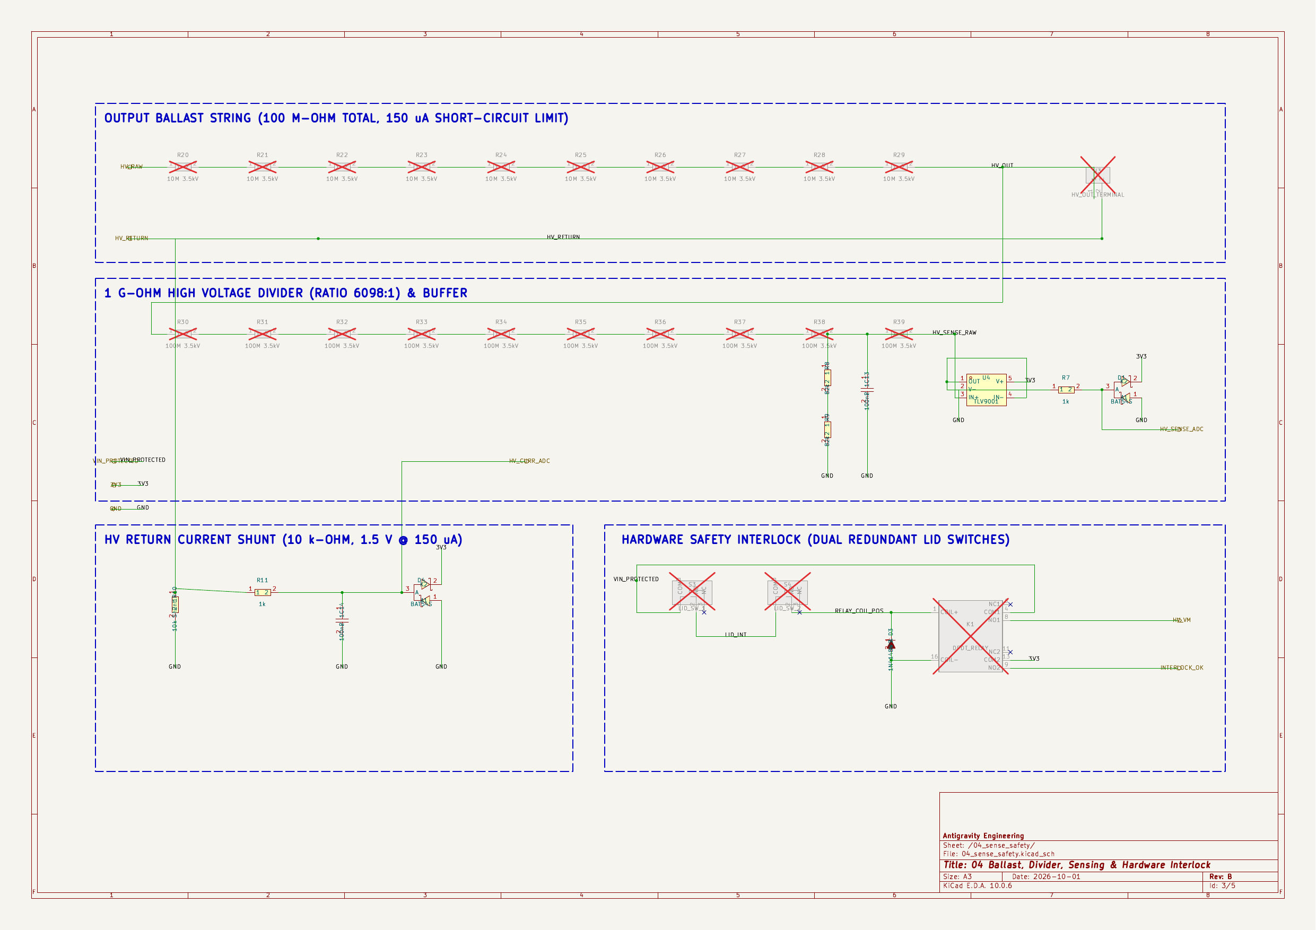
hardware/renders/sheet-3.png
