uge/ew-1/hardware/renders/sheet-4.png

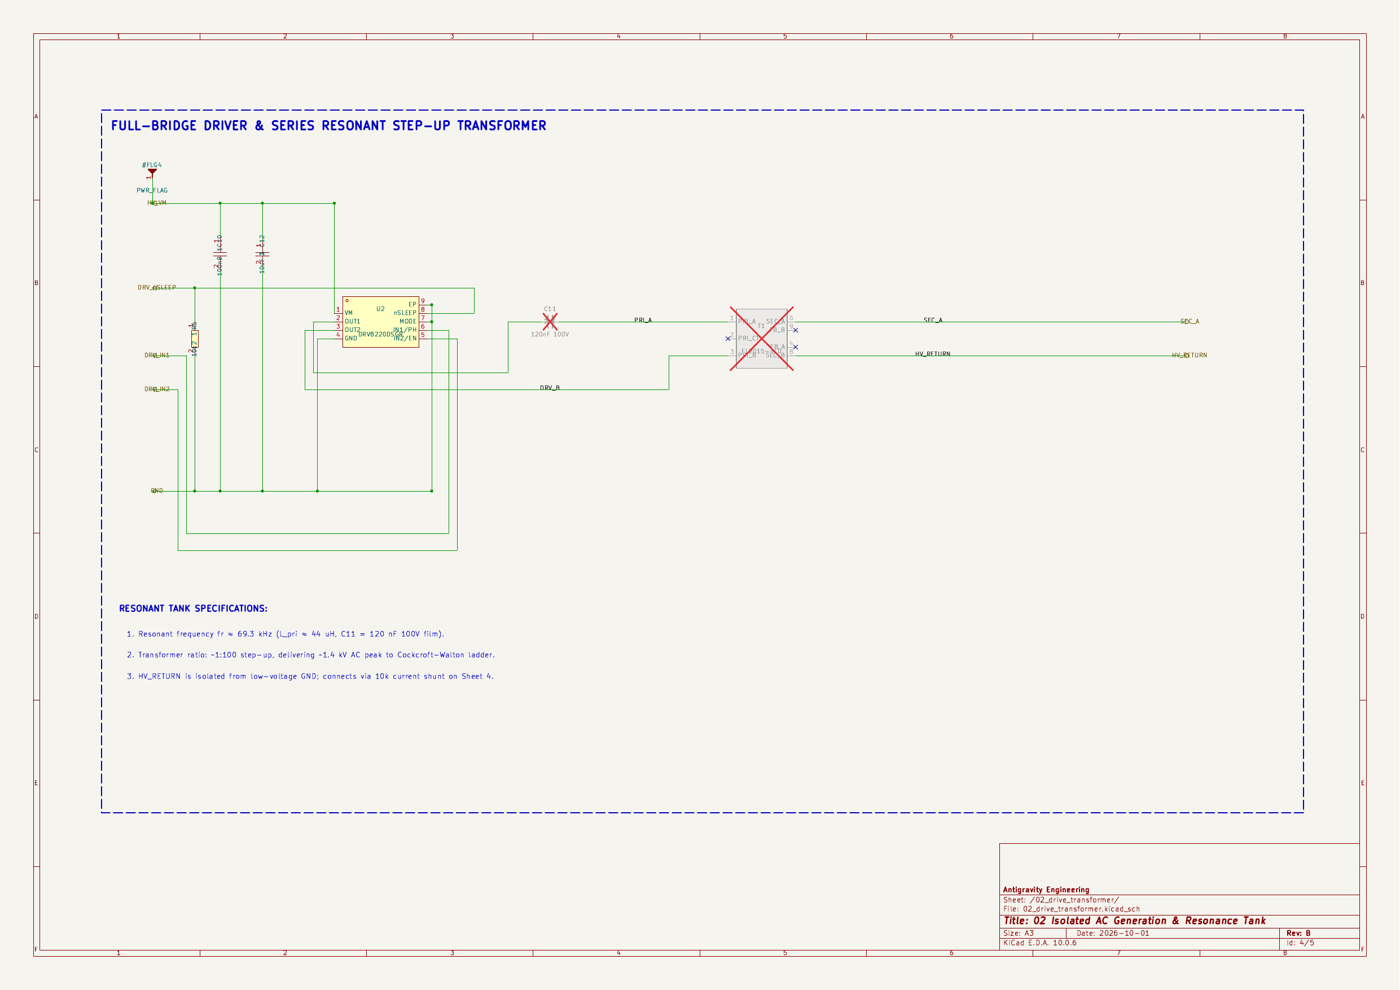
hardware/renders/sheet-4.png
