uge/ew-1/hardware/renders/sheet-5.png

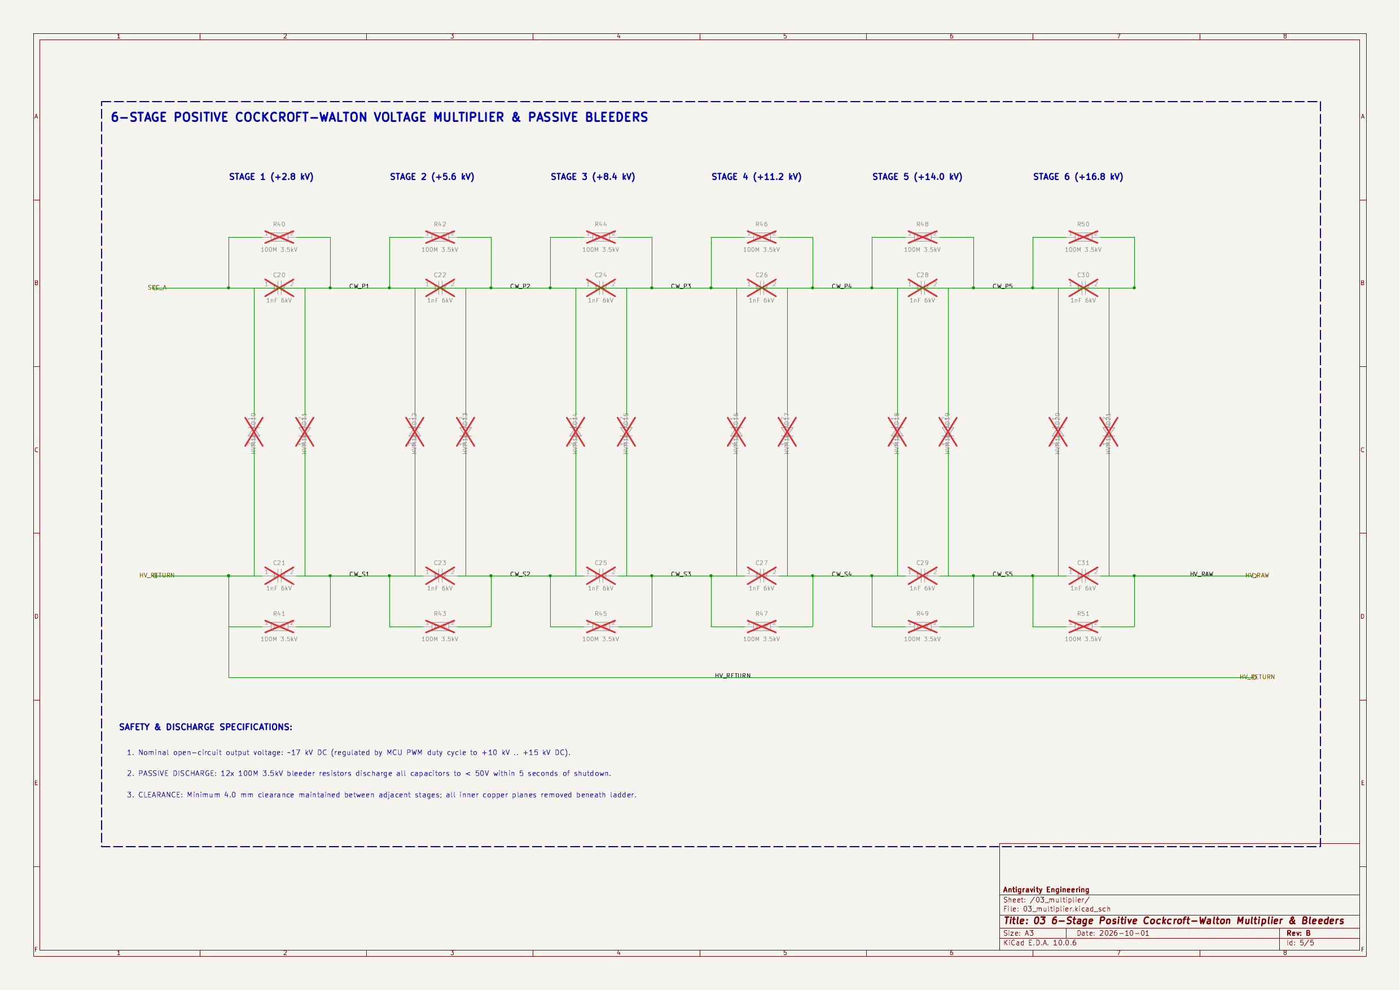
hardware/renders/sheet-5.png
