uge/ew-1/hardware/pi5_corona_hat_direct/exports/jlcpcb-bom.csv

Comment | Designator | Footprint | LCSC Part #
4.7uF 50V 10% | C21 | Capacitor_SMD:C_1210_3225Metric | C126618
VSSA310S-M3 | D50 | Diode_SMD:D_SMA | C145232
100nF | C10,C13,C14,C15,C16,C61,C71,C80 | ionic_thrust_hv:C0603 | C14663
1uF 16V 10% | C18 | Capacitor_SMD:C_0603_1608Metric | C15849
2.2nF 50V 10% | C72 | Capacitor_SMD:C_0603_1608Metric | C1604
SM04B-SRSS-TB(LF)(SN) | J50,J51 | Connector_JST:JST_SH_SM04B-SRSS-TB_1x04-1MP_P1.00mm_Horizontal | C160404
AO4407A | Q1 | Package_SO:SO-8_3.9x4.9mm_P1.27mm | C16072
SS36 60V 3A | D52,D53,D54,D55 | Diode_SMD:D_SMC | C16237
USB-C PD INPUT | J3 | ionic_thrust_hv:USB_C_Receptacle_HRO_TYPE-C-31-M-12 | C165948
TSL2591 | U8 | OptoDevice:AMS_TSL25911FN | C176812
TK-0013-R | S3,S4,S5,S6 | ionic_thrust_hv:SW_TK-0013-R | C19724218
100M 3kV | R30,R31,R32,R33,R34,R35,R36,R37,R38,R39,R140,R141,R142,R143,R144,R145,R146,R147,R148,R149,R150,R151,R152,R153,R154,R155,R156,R157,R158,R159,R160,R161,R162,R163 | Resistor_SMD:R_2512_6332Metric | C2089706
22nF 50V X7R 10% | C62 | Capacitor_SMD:C_0603_1608Metric | C21122
1k | R7 | ionic_thrust_hv:R0603 | C21190
1N4148WS | D3 | ionic_thrust_hv:D_SOD-323 | C2128
SMBJ22A | D51 | Diode_SMD:D_SMB | C224015
1.2k 1% | R73 | Resistor_SMD:R_0603_1608Metric | C22765
1.5k 1% | R61 | Resistor_SMD:R_0603_1608Metric | C22843
1M 1% | R15,R16 | Resistor_SMD:R_0603_1608Metric | C22935
62k 1% | R62 | Resistor_SMD:R_0603_1608Metric | C23221
82k | R8,R9 | ionic_thrust_hv:R0603 | C23254
HUSB238A-BB001-QN16R | U7 | ionic_thrust_hv:QFN-16-1EP_3x3mm_P0.5mm_EP1.7x1.7mm | C24833806
100k 1% | R10,R12,R70 | Resistor_SMD:R_0603_1608Metric | C25803
10k | R5,R63,R91,R92 | Resistor_SMD:R_0603_1608Metric | C25804
18k 1% | R11 | Resistor_SMD:R_0603_1608Metric | C25810
47k 1% | R14 | Resistor_SMD:R_0603_1608Metric | C25816
33uF 50V 20% | C60 | Capacitor_THT:CP_Radial_D5.0mm_P2.00mm | C2839476
SMBJ15A | D5 | Diode_SMD:D_SMB | C2912077
Pi 5 HAT 2x20 | J2 | Connector_PinSocket_2.54mm:PinSocket_2x20_P2.54mm_Vertical | C2977589
120nF 630V | C11 | ionic_thrust_hv:Film_KYET_18x10mm_P15mm | C2991056
10k PULSE 0.75W | R90 | Resistor_SMD:R_1206_3216Metric | C313977
TPS259470LRPW | U9 | ionic_thrust_hv:Texas_RPW0010A_VQFN-HR-10_2x2mm | C3662793
TPS7A0230PDBVR | U10 | Package_TO_SOT_SMD:SOT-23-5 | C3747031
ADS1115 | U6 | Package_SO:TSSOP-10_3x3mm_P0.5mm | C37593
2.2uF 50V X5R | C82,C83 | Capacitor_SMD:C_0805_2012Metric | C377773
10uF 50V 10% | C12,C22 | Capacitor_SMD:C_1210_3225Metric | C386166
5mR 1% | R13 | Resistor_SMD:R_2512_6332Metric | C393074
TLV9001 | U4 | ionic_thrust_hv:SOT-23-5_L3.0-W1.7-P0.95-LS2.8-BR | C398363
2A 24V PTC | F1 | Fuse:Fuse_1206_3216Metric | C42396578
2CL75 | D10,D11,D12,D13,D14,D15,D16,D17,D18,D19,D20,D21 | ionic_thrust_hv:Sunmate_2CL75_D3_L12_P26 | C424512
1uF 50V 10% | C17,C73,C81 | Capacitor_SMD:C_0603_1608Metric | C5199872
1k 1W | R60 | Resistor_SMD:R_2512_6332Metric | C54315
DRV8876PWPR | U2 | Package_SO:HTSSOP-16-1EP_4.4x5mm_P0.65mm_EP3.4x5mm_Mask3x3mm_ThermalVias | C575551
56.2k 0.1% | R72 | Resistor_SMD:R_0603_1608Metric | C705784
BAT54S | D1,D4 | ionic_thrust_hv:SOT-23-3_L2.9-W1.3-P1.90-LS2.4-BR | C83935
976k 0.1% | R71 | Resistor_SMD:R_0805_2012Metric | C865713
22uF 50V 20% | C70 | Capacitor_THT:CP_Radial_D5.0mm_P2.00mm | C88755
BME280 | U5 | Package_LGA:Bosch_LGA-8_2.5x2.5mm_P0.65mm_ClockwisePinNumbering | C92489
G6K-2F-Y DC3 | K1 | Relay_SMD:Relay_DPDT_Omron_G6K-2F-Y | C93168
