uge/ew-1/hardware/pi5_corona_hat_direct/exports/pi5_corona_hv_bom.csv

Refs | Value | Footprint | Qty | DNP
C10 | 100nF 50V X7R 10% | Capacitor_SMD:C_0603_1608Metric | 1
C11 | 120nF 100V | ionic_thrust_hv:Film_KYET_18x10mm_P15mm | 1
C12 | 10uF 50V X7R 10% | Capacitor_SMD:C_1210_3225Metric | 1
C13 | 100nF | ionic_thrust_hv:C0603 | 1
C14 | 100nF | ionic_thrust_hv:C0603 | 1
C15 | 100nF | ionic_thrust_hv:C0603 | 1
C16 | 100nF | ionic_thrust_hv:C0603 | 1
C17 | 1uF 50V 10% | Capacitor_SMD:C_0603_1608Metric | 1
C18 | 1uF 16V 10% | Capacitor_SMD:C_0603_1608Metric | 1
C21 | 4.7uF 50V 10% | Capacitor_SMD:C_1210_3225Metric | 1
C22 | 10uF 50V 10% | Capacitor_SMD:C_1210_3225Metric | 1
C60 | 33uF 50V 20% | Capacitor_THT:CP_Radial_D5.0mm_P2.00mm | 1
C61 | 100nF 16V X7R 10% | Capacitor_SMD:C_0603_1608Metric | 1
C62 | 22nF 50V X7R 10% | Capacitor_SMD:C_0603_1608Metric | 1
C63 | 1nF 100V DNP | Capacitor_SMD:C_0805_2012Metric | 1 | DNP
C70 | 22uF 50V 20% | Capacitor_THT:CP_Radial_D5.0mm_P2.00mm | 1
C71 | 100nF 50V 10% | Capacitor_SMD:C_0603_1608Metric | 1
C72 | 2.2nF 50V 10% | Capacitor_SMD:C_0603_1608Metric | 1
C73 | 1uF 50V X7R 10% | Capacitor_SMD:C_0603_1608Metric | 1
C80 | 100nF 10V X7R | Capacitor_SMD:C_0603_1608Metric | 1
C81 | 1uF 10V X7R | Capacitor_SMD:C_0603_1608Metric | 1
C82 | 2.2uF 50V X5R | Capacitor_SMD:C_0805_2012Metric | 1
C83 | 2.2uF 50V X5R | Capacitor_SMD:C_0805_2012Metric | 1
C100 | 1nF 6kV | ionic_thrust_hv:CAP-TH_L15.0-W4.0-P10.00-D0.6 | 1
C101 | 1nF 6kV | ionic_thrust_hv:CAP-TH_L15.0-W4.0-P10.00-D0.6 | 1
C102 | 1nF 6kV | ionic_thrust_hv:CAP-TH_L15.0-W4.0-P10.00-D0.6 | 1
C103 | 1nF 6kV | ionic_thrust_hv:CAP-TH_L15.0-W4.0-P10.00-D0.6 | 1
C104 | 1nF 6kV | ionic_thrust_hv:CAP-TH_L15.0-W4.0-P10.00-D0.6 | 1
C105 | 1nF 6kV | ionic_thrust_hv:CAP-TH_L15.0-W4.0-P10.00-D0.6 | 1
C106 | 1nF 6kV | ionic_thrust_hv:CAP-TH_L15.0-W4.0-P10.00-D0.6 | 1
C107 | 1nF 6kV | ionic_thrust_hv:CAP-TH_L15.0-W4.0-P10.00-D0.6 | 1
C108 | 1nF 6kV | ionic_thrust_hv:CAP-TH_L15.0-W4.0-P10.00-D0.6 | 1
C109 | 1nF 6kV | ionic_thrust_hv:CAP-TH_L15.0-W4.0-P10.00-D0.6 | 1
C110 | 1nF 6kV | ionic_thrust_hv:CAP-TH_L15.0-W4.0-P10.00-D0.6 | 1
C111 | 1nF 6kV | ionic_thrust_hv:CAP-TH_L15.0-W4.0-P10.00-D0.6 | 1
D1 | BAT54S | ionic_thrust_hv:SOT-23-3_L2.9-W1.3-P1.90-LS2.4-BR | 1
D3 | 1N4148WS | ionic_thrust_hv:D_SOD-323 | 1
D4 | BAT54S | ionic_thrust_hv:SOT-23-3_L2.9-W1.3-P1.90-LS2.4-BR | 1
D5 | SMBJ15A | Diode_SMD:D_SMB | 1
D10 | 2CL75 | ionic_thrust_hv:Sunmate_2CL75_D3_L12_P26 | 1
D11 | 2CL75 | ionic_thrust_hv:Sunmate_2CL75_D3_L12_P26 | 1
D12 | 2CL75 | ionic_thrust_hv:Sunmate_2CL75_D3_L12_P26 | 1
D13 | 2CL75 | ionic_thrust_hv:Sunmate_2CL75_D3_L12_P26 | 1
D14 | 2CL75 | ionic_thrust_hv:Sunmate_2CL75_D3_L12_P26 | 1
D15 | 2CL75 | ionic_thrust_hv:Sunmate_2CL75_D3_L12_P26 | 1
D16 | 2CL75 | ionic_thrust_hv:Sunmate_2CL75_D3_L12_P26 | 1
D17 | 2CL75 | ionic_thrust_hv:Sunmate_2CL75_D3_L12_P26 | 1
D18 | 2CL75 | ionic_thrust_hv:Sunmate_2CL75_D3_L12_P26 | 1
D19 | 2CL75 | ionic_thrust_hv:Sunmate_2CL75_D3_L12_P26 | 1
D20 | 2CL75 | ionic_thrust_hv:Sunmate_2CL75_D3_L12_P26 | 1
D21 | 2CL75 | ionic_thrust_hv:Sunmate_2CL75_D3_L12_P26 | 1
D50 | VSSA310S-M3 | Diode_SMD:D_SMA | 1
D51 | SMBJ22A | Diode_SMD:D_SMB | 1
D52 | SS36 60V 3A | Diode_SMD:D_SMC | 1
D53 | SS36 60V 3A | Diode_SMD:D_SMC | 1
D54 | SS36 60V 3A | Diode_SMD:D_SMC | 1
D55 | SS36 60V 3A | Diode_SMD:D_SMC | 1
F1 | 2A 24V PTC | Fuse:Fuse_1206_3216Metric | 1
J2 | Pi 5 HAT 2x20 | Connector_PinSocket_2.54mm:PinSocket_2x20_P2.54mm_Vertical | 1
J3 | USB-C PD INPUT | ionic_thrust_hv:USB_C_Receptacle_HRO_TYPE-C-31-M-12 | 1
J50 | Qwiic HOST | Connector_JST:JST_SH_SM04B-SRSS-TB_1x04-1MP_P1.00mm_Horizontal | 1
J51 | Qwiic MINI | Connector_JST:JST_SH_SM04B-SRSS-TB_1x04-1MP_P1.00mm_Horizontal | 1
J60 | HV_OUT_WIRE | ionic_thrust_hv:HV_Wire_Termination_1P | 1
J61 | HV_RETURN_WIRE | ionic_thrust_hv:HV_Wire_Termination_1P | 1
J62 | S3_MINI | ionic_thrust_hv:Solder_Pads_2P_P5.08 | 1
J63 | S4_MINI | ionic_thrust_hv:Solder_Pads_2P_P5.08 | 1
J64 | S3_HOST | ionic_thrust_hv:Solder_Pads_2P_P5.08 | 1
J65 | S4_HOST | ionic_thrust_hv:Solder_Pads_2P_P5.08 | 1
J66 | S5_MINI | ionic_thrust_hv:Solder_Pads_2P_P5.08 | 1
J67 | S6_MINI | ionic_thrust_hv:Solder_Pads_2P_P5.08 | 1
J68 | S5_HOST | ionic_thrust_hv:Solder_Pads_2P_P5.08 | 1
J69 | S6_HOST | ionic_thrust_hv:Solder_Pads_2P_P5.08 | 1
K1 | G6K-2F-Y DC3 | Relay_SMD:Relay_DPDT_Omron_G6K-2F-Y | 1
Q1 | AO4407A | Package_SO:SO-8_3.9x4.9mm_P1.27mm | 1
R5 | 10k | Resistor_SMD:R_0603_1608Metric | 1
R7 | 1k | ionic_thrust_hv:R0603 | 1
R8 | 82k | ionic_thrust_hv:R0603 | 1
R9 | 82k | ionic_thrust_hv:R0603 | 1
R10 | 100k 1% | Resistor_SMD:R_0603_1608Metric | 1
R11 | 18k 1% | Resistor_SMD:R_0603_1608Metric | 1
R12 | 100k 1% | Resistor_SMD:R_0603_1608Metric | 1
R13 | 5mR 1% | Resistor_SMD:R_2512_6332Metric | 1
R14 | 47k 1% | Resistor_SMD:R_0603_1608Metric | 1
R15 | 1M 1% | Resistor_SMD:R_0603_1608Metric | 1
R16 | 1M 1% | Resistor_SMD:R_0603_1608Metric | 1
R20 | 10M 3kV | Resistor_SMD:R_2512_6332Metric | 1
R21 | 10M 3kV | Resistor_SMD:R_2512_6332Metric | 1
R22 | 10M 3kV | Resistor_SMD:R_2512_6332Metric | 1
R23 | 10M 3kV | Resistor_SMD:R_2512_6332Metric | 1
R24 | 10M 3kV | Resistor_SMD:R_2512_6332Metric | 1
R25 | 10M 3kV | Resistor_SMD:R_2512_6332Metric | 1
R26 | 10M 3kV | Resistor_SMD:R_2512_6332Metric | 1
R27 | 10M 3kV | Resistor_SMD:R_2512_6332Metric | 1
R28 | 10M 3kV | Resistor_SMD:R_2512_6332Metric | 1
R29 | 10M 3kV | Resistor_SMD:R_2512_6332Metric | 1
R30 | 100M 3kV | Resistor_SMD:R_2512_6332Metric | 1
R31 | 100M 3kV | Resistor_SMD:R_2512_6332Metric | 1
R32 | 100M 3kV | Resistor_SMD:R_2512_6332Metric | 1
R33 | 100M 3kV | Resistor_SMD:R_2512_6332Metric | 1
R34 | 100M 3kV | Resistor_SMD:R_2512_6332Metric | 1
R35 | 100M 3kV | Resistor_SMD:R_2512_6332Metric | 1
R36 | 100M 3kV | Resistor_SMD:R_2512_6332Metric | 1
R37 | 100M 3kV | Resistor_SMD:R_2512_6332Metric | 1
R38 | 100M 3kV | Resistor_SMD:R_2512_6332Metric | 1
R39 | 100M 3kV | Resistor_SMD:R_2512_6332Metric | 1
R60 | 1k 1W | Resistor_SMD:R_2512_6332Metric | 1
R61 | 1.2k 1% | Resistor_SMD:R_0603_1608Metric | 1
R62 | 62k 1% | Resistor_SMD:R_0603_1608Metric | 1
R63 | 10k | Resistor_SMD:R_0603_1608Metric | 1
R64 | 100R 1W DNP | Resistor_SMD:R_2512_6332Metric | 1 | DNP
R70 | 100k 1% | Resistor_SMD:R_0603_1608Metric | 1
R71 | 976k 0.1% | Resistor_SMD:R_0805_2012Metric | 1
R72 | 56.2k 0.1% | Resistor_SMD:R_0603_1608Metric | 1
R73 | 4.99k 1% | Resistor_SMD:R_0603_1608Metric | 1
R90 | 10k PULSE 0.75W | Resistor_SMD:R_1206_3216Metric | 1
R91 | 10k | ionic_thrust_hv:R0603 | 1
R92 | 10k | ionic_thrust_hv:R0603 | 1
R140 | 100M 3kV | Resistor_SMD:R_2512_6332Metric | 1
R141 | 100M 3kV | Resistor_SMD:R_2512_6332Metric | 1
R142 | 100M 3kV | Resistor_SMD:R_2512_6332Metric | 1
R143 | 100M 3kV | Resistor_SMD:R_2512_6332Metric | 1
R144 | 100M 3kV | Resistor_SMD:R_2512_6332Metric | 1
R145 | 100M 3kV | Resistor_SMD:R_2512_6332Metric | 1
R146 | 100M 3kV | Resistor_SMD:R_2512_6332Metric | 1
R147 | 100M 3kV | Resistor_SMD:R_2512_6332Metric | 1
R148 | 100M 3kV | Resistor_SMD:R_2512_6332Metric | 1
R149 | 100M 3kV | Resistor_SMD:R_2512_6332Metric | 1
R150 | 100M 3kV | Resistor_SMD:R_2512_6332Metric | 1
R151 | 100M 3kV | Resistor_SMD:R_2512_6332Metric | 1
R152 | 100M 3kV | Resistor_SMD:R_2512_6332Metric | 1
R153 | 100M 3kV | Resistor_SMD:R_2512_6332Metric | 1
R154 | 100M 3kV | Resistor_SMD:R_2512_6332Metric | 1
R155 | 100M 3kV | Resistor_SMD:R_2512_6332Metric | 1
R156 | 100M 3kV | Resistor_SMD:R_2512_6332Metric | 1
R157 | 100M 3kV | Resistor_SMD:R_2512_6332Metric | 1
R158 | 100M 3kV | Resistor_SMD:R_2512_6332Metric | 1
R159 | 100M 3kV | Resistor_SMD:R_2512_6332Metric | 1
R160 | 100M 3kV | Resistor_SMD:R_2512_6332Metric | 1
R161 | 100M 3kV | Resistor_SMD:R_2512_6332Metric | 1
R162 | 100M 3kV | Resistor_SMD:R_2512_6332Metric | 1
R163 | 100M 3kV | Resistor_SMD:R_2512_6332Metric | 1
S3 | TK-0013-R | ionic_thrust_hv:SW_TK-0013-R | 1
S4 | TK-0013-R | ionic_thrust_hv:SW_TK-0013-R | 1
S5 | TK-0013-R | ionic_thrust_hv:SW_TK-0013-R | 1
S6 | TK-0013-R | ionic_thrust_hv:SW_TK-0013-R | 1
T1 | FL2015-4LD | ionic_thrust_hv:Coilcraft_FL2015_Package1_SMT | 1
TP50 | DRV FAULT | TestPoint:TestPoint_Pad_D1.5mm | 1
U2 | DRV8876PWPR | Package_SO:HTSSOP-16-1EP_4.4x5mm_P0.65mm_EP3.4x5mm_Mask3x3mm_ThermalVias | 1
U4 | TLV9001 | ionic_thrust_hv:SOT-23-5_L3.0-W1.7-P0.95-LS2.8-BR | 1
U5 | BME280 | Package_LGA:Bosch_LGA-8_2.5x2.5mm_P0.65mm_ClockwisePinNumbering | 1
U6 | ADS1115 | Package_SO:TSSOP-10_3x3mm_P0.5mm | 1
U7 | HUSB238A-BB001-QN16R | ionic_thrust_hv:QFN-16-1EP_3x3mm_P0.5mm_EP1.7x1.7mm | 1
U8 | TSL2591 | OptoDevice:AMS_TSL25911FN | 1
U9 | TPS259470LRPW | ionic_thrust_hv:Texas_RPW0010A_VQFN-HR-10_2x2mm | 1
U10 | TPS7A0230PDBVR | Package_TO_SOT_SMD:SOT-23-5 | 1
