uge/ew-1/hardware/pi5_corona_hat_direct/exports/procurement-bom.csv

Comment | Designator | Footprint | LCSC Part # | Manufacturer | MPN | Quantity | DNP | Procurement Status | Catalog Stock | JLCPCB Library | Assembly Process | Source | Notes
18k 1% | R11 | Resistor_SMD:R_0603_1608Metric | C25810 | UNI-ROYAL(Uniroyal Elec) | 0603WAF1802T5E | 1 | No | CATALOG_MATCH | 832401 | Basic | smtWeld | https://jlcpcb.com/partdetail/C25810
AO4407A | Q1 | Package_SO:SO-8_3.9x4.9mm_P1.27mm | C16072 | Alpha & Omega Semicon | AO4407A | 1 | No | CATALOG_MATCH | 25000 | Basic | smtWeld | https://jlcpcb.com/partdetail/C16072 | P-MOSFET: G=4, S=1/2/3 on VBUS_IN, D=5/6/7/8 on VIN_PD. Driven by HUSB238A GATE pin.
10uF 50V 10% | C12,C22 | Capacitor_SMD:C_1210_3225Metric | C386166 | Taiyo Yuden | UMK325AB7106KMHP | 2 | No | CATALOG_MATCH | 176509 | Extended | smtWeld | https://jlcpcb.com/partdetail/C386166
100k 1% | R10,R12,R70 | Resistor_SMD:R_0603_1608Metric | C25803 | UNI-ROYAL(Uniroyal Elec) | 0603WAF1003T5E | 3 | No | CATALOG_MATCH | 22123082 | Basic | smtWeld | https://jlcpcb.com/partdetail/C25803
1M 1% | R15,R16 | Resistor_SMD:R_0603_1608Metric | C22935 | UNI-ROYAL(Uniroyal Elec) | 0603WAF1004T5E | 2 | No | CATALOG_MATCH | 1000000 | Basic | smtWeld | https://jlcpcb.com/partdetail/C22935 | 1M 1% 0603 pulldown resistor on HUSB238A DEBUG_N pin.
USB-C PD INPUT | J3 | ionic_thrust_hv:USB_C_Receptacle_HRO_TYPE-C-31-M-12 | C165948 | Korean Hroparts Elec | TYPE-C-31-M-12 | 1 | No | CATALOG_MATCH | 408639 | Extended | smtWeld | https://jlcpcb.com/partdetail/Korean_Hroparts_Elec-TYPE_C_31_M_12/C165948
5mR 1% | R13 | Resistor_SMD:R_2512_6332Metric | C393074 | TA-I Tech | RLP25FEGMR005 | 1 | No | CATALOG_MATCH | 222289 | Extended | smtWeld | https://jlcpcb.com/partdetail/C393074
SM04B-SRSS-TB(LF)(SN) | J50,J51 | Connector_JST:JST_SH_SM04B-SRSS-TB_1x04-1MP_P1.00mm_Horizontal | C160404 | JST | SM04B-SRSS-TB(LF)(SN) | 2 | No | CATALOG_MATCH | 34960 | Extended | smtWeld | https://jlcpcb.com/partdetail/C160404
4.7uF 50V 10% | C21 | Capacitor_SMD:C_1210_3225Metric | C126618 | Murata Electronics | GCM32ER71H475KA55L | 1 | No | CATALOG_MATCH | 202439 | Extended | smtWeld | https://jlcpcb.com/partdetail/C126618
47k 1% | R14 | Resistor_SMD:R_0603_1608Metric | C25816 | UNI-ROYAL(Uniroyal Elec) | 0603WAF4702T5E | 1 | No | CATALOG_MATCH | 1000000 | Basic | smtWeld | https://jlcpcb.com/partdetail/C25816 | 47k 1% 0603 series gate resistor between GATE and EN_DRV.
1uF 50V 10% | C17,C73,C81 | Capacitor_SMD:C_0603_1608Metric | C5199872 | Samsung Electro-Mechanics | CL10B105KB8NQNC | 3 | No | CATALOG_MATCH | 2633183 | Extended | smtWeld | https://jlcpcb.com/partdetail/C5199872
HUSB238A-BB001-QN16R | U7 | ionic_thrust_hv:QFN-16-1EP_3x3mm_P0.5mm_EP1.7x1.7mm | C24833806 | Hynetek(慧能泰) | HUSB238A-BB001-QN16R | 1 | No | CATALOG_MATCH | 2934 | Extended | smtWeld | https://jlcpcb.com/partdetail/C24833806 | HUSB238A-BB001-QN16R in QFN-16 (3x3mm). VDD powered by 3V3; default 5V startup, I2C programmable (0x42) from 5V to 20V with PPS support.
976k 0.1% | R71 | Resistor_SMD:R_0805_2012Metric | C865713 | YAGEO | RT0805BRD07976KL | 1 | No | CATALOG_MATCH | 2652 | Extended | smtWeld | https://jlcpcb.com/partdetail/C865713 | 0805 selected to preserve 976k / 0.1% requirement.
ADS1115 | U6 | Package_SO:TSSOP-10_3x3mm_P0.5mm | C37593 | Texas Instruments | ADS1115IDGSR | 1 | No | CATALOG_MATCH | 25963 | Extended | smtWeld | https://jlcpcb.com/partdetail/C37593
2.2nF 50V 10% | C72 | Capacitor_SMD:C_0603_1608Metric | C1604 | FH (Guangdong Fenghua Advanced Tech) | 0603B222K500NT | 1 | No | CATALOG_MATCH | 1146919 | Basic | smtWeld | https://jlcpcb.com/partdetail/C1604
2A 24V PTC | F1 | Fuse:Fuse_1206_3216Metric | C42396578 | LUTE | 1206L200/24NR | 1 | No | CATALOG_MATCH | 35961 | Extended | smtWeld | https://jlcpcb.com/partdetail/C42396578 | 2A hold, 3.5A trip, 24V PPTC resettable fuse in 1206 footprint. Rated across 5V-20V VBUS range and coordinated with U9 eFuse (2.78A limit) and U2 DRV8876 (2.20A limit).
1.2k 1% | R73 | Resistor_SMD:R_0603_1608Metric | C22765 | UNI-ROYAL(Uniroyal Elec) | 0603WAF1201T5E | 1 | No | CATALOG_MATCH | 2480437 | Basic | smtWeld | https://jlcpcb.com/partdetail/C22765 | 1.2k 1% 0603 sets U9 TPS259470 eFuse current limit to 2.78A typ (2.53A min), above U2 2.20A IPROPI limit.
100nF | C10,C13,C14,C15,C16,C61,C71,C80 | ionic_thrust_hv:C0603 | C14663 | YAGEO | CC0603KRX7R9BB104 | 8 | No | CATALOG_MATCH | 58124227 | Basic | smtWeld | https://jlcpcb.com/partdetail/C14663
BME280 | U5 | Package_LGA:Bosch_LGA-8_2.5x2.5mm_P0.65mm_ClockwisePinNumbering | C92489 | Bosch Sensortec | BME280 | 1 | No | CATALOG_MATCH | 4363 | Extended | smtWeld | https://jlcpcb.com/partdetail/C92489
TPS259470LRPW | U9 | ionic_thrust_hv:Texas_RPW0010A_VQFN-HR-10_2x2mm | C3662793 | Texas Instruments | TPS259470LRPWR | 1 | No | CATALOG_MATCH | 2745 | Extended | smtWeld | https://jlcpcb.com/partdetail/C3662793
56.2k 0.1% | R72 | Resistor_SMD:R_0603_1608Metric | C705784 | YAGEO | RT0603BRD0756K2L | 1 | No | CATALOG_MATCH | 9905 | Extended | smtWeld | https://jlcpcb.com/partdetail/C705784
Pi 5 HAT 2x20 | J2 | Connector_PinSocket_2.54mm:PinSocket_2x20_P2.54mm_Vertical | C2977589 | ZHOURI | 2.54-2*20 | 1 | No | CATALOG_MATCH | 35073 | Extended | manualWeld | https://jlcpcb.com/partdetail/C2977589 | 8.5mm female socket; verify HAT standoff and Pi 5 clearance in PCB/mechanical layout.
22uF 50V 20% | C70 | Capacitor_THT:CP_Radial_D5.0mm_P2.00mm | C88755 | Rubycon | 50YXF22MEFC5X11 | 1 | No | CATALOG_MATCH | 167801 | Extended | manualWeld | https://jlcpcb.com/partdetail/C88755
1uF 16V 10% | C18 | Capacitor_SMD:C_0603_1608Metric | C15849 | SAMSUNG | CL10A105KA8NNNC | 1 | No | CATALOG_MATCH | 100000 | Basic | smtWeld | https://jlcpcb.com/partdetail/C15849 | 1uF 16V 0603 X5R ceramic bypass for HUSB238A VDD.
100R 1W DNP | R64 | Resistor_SMD:R_2512_6332Metric | C35218 | UNI-ROYAL(Uniroyal Elec) | 25121WF1000T4E | 1 | Yes | CATALOG_MATCH | 32164 | Extended | smtWeld | https://jlcpcb.com/partdetail/C35218
SMBJ22A | D51 | Diode_SMD:D_SMB | C224015 | Littelfuse | SMBJ22A | 1 | No | CATALOG_MATCH | 66 | Extended | smtWeld | https://jlcpcb.com/partdetail/C224015
10k | R5,R63,R91,R92 | Resistor_SMD:R_0603_1608Metric | C25804 | UNI-ROYAL(Uniroyal Elec) | 0603WAF1002T5E | 4 | No | CATALOG_MATCH | 23027280 | Basic | smtWeld | https://jlcpcb.com/partdetail/C25804
SS36 60V 3A | D52,D53,D54,D55 | Diode_SMD:D_SMC | C16237 | MDD(Microdiode Semiconductor) | SS36C | 4 | No | CATALOG_MATCH | 77392 | Extended | smtWeld | https://jlcpcb.com/partdetail/C16237 | SS36C is the SMC package version; 60V / 3A retained.
1nF 100V DNP | C63 | Capacitor_SMD:C_0805_2012Metric | C162289 | Murata Electronics | GRM2165C2A102JA01D | 1 | Yes | CATALOG_MATCH | 0 | Extended | smtWeld | https://jlcpcb.com/partdetail/C162289
DRV8876PWPR | U2 | Package_SO:HTSSOP-16-1EP_4.4x5mm_P0.65mm_EP3.4x5mm_Mask3x3mm_ThermalVias | C575551 | Texas Instruments | DRV8876PWPR | 1 | No | CATALOG_MATCH | 29786 | Extended | smtWeld | https://jlcpcb.com/partdetail/C575551
FL2015-4LD | T1 | ionic_thrust_hv:Coilcraft_FL2015_Package1_SMT |  | Coilcraft | FL2015-4LD | 1 | No | EXTERNAL_SOURCE |  | Unknown |  | https://www.coilcraft.com/en-us/products/transformers/power-transformers/ccfl-transformers/fl/fl2015-4l/ | No exact FL2015-4LD JLCPCB catalog match found. Coilcraft sourcing/consignment or manual fit; do not substitute a PFL2015 inductor.
120nF 630V | C11 | ionic_thrust_hv:Film_KYET_18x10mm_P15mm | C2991056 | KYET | MMKP124J2J1501 | 1 | No | CATALOG_MATCH | 1631 | Extended | manualWeld | https://jlcpcb.com/partdetail/C2991056 | 120nF 630V / 5% metallized polypropylene. 18x10mm body, 15mm pitch; validate resonant RMS current and heating.
62k 1% | R62 | Resistor_SMD:R_0603_1608Metric | C23221 | UNI-ROYAL(Uniroyal Elec) | 0603WAF6202T5E | 1 | No | CATALOG_MATCH | 417242 | Extended | smtWeld | https://jlcpcb.com/partdetail/C23221
22nF 50V X7R 10% | C62 | Capacitor_SMD:C_0603_1608Metric | C21122 | Samsung Electro-Mechanics | CL10B223KB8NNNC | 1 | No | CATALOG_MATCH | 882069 | Basic | smtWeld | https://jlcpcb.com/partdetail/C21122
1k 1W | R60 | Resistor_SMD:R_2512_6332Metric | C54315 | UNI-ROYAL(Uniroyal Elec) | 25121WF1001T4E | 1 | No | CATALOG_MATCH | 87498 | Extended | smtWeld | https://jlcpcb.com/partdetail/C54315
1.5k 1% | R61 | Resistor_SMD:R_0603_1608Metric | C22843 | UNI-ROYAL(Uniroyal Elec) | 0603WAF1501T5E | 1 | No | CATALOG_MATCH | 4118584 | Basic | smtWeld | https://jlcpcb.com/partdetail/C22843 | 1.5k 1% 0603 sets U2 DRV8876 IPROPI trip threshold to 2.20A, above primary magnetizing current and below U9 eFuse 2.78A limit.
DRV FAULT | TP50 | TestPoint:TestPoint_Pad_D1.5mm |  |  |  | 1 | No | PCB_FEATURE |  | Unknown |  |  | Copper test pad; no purchased or placed component.
VSSA310S-M3 | D50 | Diode_SMD:D_SMA | C145232 | Vishay Intertech | VSSA310S-M3/61T | 1 | No | CATALOG_MATCH | 1021 | Extended | smtWeld | https://jlcpcb.com/partdetail/C145232
33uF 50V 20% | C60 | Capacitor_THT:CP_Radial_D5.0mm_P2.00mm | C2839476 | Rubycon | 50YXJ33M5X11 | 1 | No | CATALOG_MATCH | 14482 | Extended | manualWeld | https://jlcpcb.com/partdetail/C2839476 | 33uF 50V / 20%, Rubycon YXJ, 5x11mm, 2mm pitch. Validate ripple/ESR against measured transformer current.
100M 3kV | R30,R31,R32,R33,R34,R35,R36,R37,R38,R39,R140,R141,R142,R143,R144,R145,R146,R147,R148,R149,R150,R151,R152,R153,R154,R155,R156,R157,R158,R159,R160,R161,R162,R163 | Resistor_SMD:R_2512_6332Metric | C2089706 | Bourns | CHV2512-JW-107ELF | 34 | No | CATALOG_MATCH | 5109 | Extended | smtWeld | https://jlcpcb.com/partdetail/C2089706 | Bourns 100M / 5%, 1W, 3kV continuous maximum. VCR calibration/voltage sharing and PCB leakage require bench validation.
1nF 6kV | C100,C101,C102,C103,C104,C105,C106,C107,C108,C109,C110,C111 | ionic_thrust_hv:CAP-TH_L15.0-W4.0-P10.00-D0.6 |  | Generic / STE / JEC | CT81-6KV-Y5P-102K | 12 | No | DIRECT_PROCUREMENT | 0 | Manual | manualWeld | https://www.lcsc.com/datasheet/CT81.pdf | 1nF 6kV / 20%, 10mm pitch; THT/manual assembly. Domestic equivalent CT81.
2CL75 | D10,D11,D12,D13,D14,D15,D16,D17,D18,D19,D20,D21 | ionic_thrust_hv:Sunmate_2CL75_D3_L12_P26 | C424512 | SUNMATE Elec | 2CL75 | 12 | No | CATALOG_MATCH | 1006 | Extended | manualWeld | https://jlcpcb.com/partdetail/SUNMATEElec-2CL75/C424512 | 16 kV, 5 mA average, 0.5 A surge; trr max 100 ns at 25 C; Cj 1 pF at 0 V / 1 MHz. 3 x 12 mm axial body, 0.6 mm leads, mounted at 26 mm pitch. Validate startup and repetitive charging-pulse currents before release.
HV_RETURN_WIRE | J61 | ionic_thrust_hv:HV_Wire_Termination_1P |  |  |  | 1 | No | PCB_FEATURE |  | PCB feature | Hand-soldered wire | Native PCB feature; no purchased component | Separate single solder-wire termination, far from J60. HV_RETURN is isolated from logic ground.
S6_HOST | J69 | ionic_thrust_hv:Solder_Pads_2P_P5.08 |  |  |  | 1 | No | PCB_FEATURE |  | PCB feature | Hand-soldered wire | Native PCB feature; no purchased component | J69: pin 1 COM, pin 2 NO; matching mini/host solder-pad pair for four-switch interlock.
TK-0013-R | S3,S4,S5,S6 | ionic_thrust_hv:SW_TK-0013-R | C19724218 | DEALON | TK-0013-R | 4 | No | CATALOG_MATCH | 910 | Extended | manualWeld | https://jlcpcb.com/partdetail/DEALON-TK_0013R/C19724218 | User-approved selection. Right-angle through-hole, parallel PCB actuation. Drawing shows COM/NO/NC despite SPST-NC catalog; electrical ratings absent from supplied drawing. Confirm actual contacts and ratings before production. Manual assembly; populated.
10M 3kV | R20,R21,R22,R23,R24,R25,R26,R27,R28,R29 | Resistor_SMD:R_2512_6332Metric |  | Bourns | CHV2512-FX-1005ELF | 10 | No | EXTERNAL_SOURCE | 46000 | Extended | smtWeld | https://www.digikey.com/en/products/detail/bourns-inc/CHV2512-FX-1005ELF/16892550 | Bourns 10M / 1%, 1W, 3kV continuous. DigiKey/Mouser global sourcing / consignment for automated SMT.
S5_MINI | J66 | ionic_thrust_hv:Solder_Pads_2P_P5.08 |  |  |  | 1 | No | PCB_FEATURE |  | PCB feature | Hand-soldered wire | Native PCB feature; no purchased component | J66: pin 1 COM, pin 2 NO; matching mini/host solder-pad pair for four-switch interlock.
S4_HOST | J65 | ionic_thrust_hv:Solder_Pads_2P_P5.08 |  |  |  | 1 | No | PCB_FEATURE |  | PCB feature | Hand-soldered wire | Native PCB feature; no purchased component | S4_HOST: pin 1 COM, pin 2 NO. Paired solderable plated holes; connect the matching host/mini pair with two wires after cutting its two-net neck. NC stays unused.
S3_HOST | J64 | ionic_thrust_hv:Solder_Pads_2P_P5.08 |  |  |  | 1 | No | PCB_FEATURE |  | PCB feature | Hand-soldered wire | Native PCB feature; no purchased component | S3_HOST: pin 1 COM, pin 2 NO. Paired solderable plated holes; connect the matching host/mini pair with two wires after cutting its two-net neck. NC stays unused.
S6_MINI | J67 | ionic_thrust_hv:Solder_Pads_2P_P5.08 |  |  |  | 1 | No | PCB_FEATURE |  | PCB feature | Hand-soldered wire | Native PCB feature; no purchased component | J67: pin 1 COM, pin 2 NO; matching mini/host solder-pad pair for four-switch interlock.
S4_MINI | J63 | ionic_thrust_hv:Solder_Pads_2P_P5.08 |  |  |  | 1 | No | PCB_FEATURE |  | PCB feature | Hand-soldered wire | Native PCB feature; no purchased component | S4_MINI: pin 1 COM, pin 2 NO. Paired solderable plated holes; connect the matching host/mini pair with two wires after cutting its two-net neck. NC stays unused.
HV_OUT_WIRE | J60 | ionic_thrust_hv:HV_Wire_Termination_1P |  |  |  | 1 | No | PCB_FEATURE |  | PCB feature | Hand-soldered wire | Native PCB feature; no purchased component | Single isolated solder-wire termination. External wire insulation, strain relief and enclosure must be validated for 15 kV; no generic low-voltage pin header.
1N4148WS | D3 | ionic_thrust_hv:D_SOD-323 | C2128 | Jiangsu Changjing Electronics Technology Co., Ltd. | 1N4148WS | 1 | No | CATALOG_MATCH | 2445156 | Basic | smtWeld | https://jlcpcb.com/partdetail/C2128
BAT54S | D1,D4 | ionic_thrust_hv:SOT-23-3_L2.9-W1.3-P1.90-LS2.4-BR | C83935 | ST(Semtech) | BAT54S | 2 | No | CATALOG_MATCH | 16790 | Extended | smtWeld | https://jlcpcb.com/partdetail/C83935
TLV9001 | U4 | ionic_thrust_hv:SOT-23-5_L3.0-W1.7-P0.95-LS2.8-BR | C398363 | Texas Instruments | TLV9001IDBVR | 1 | No | CATALOG_MATCH | 45046 | Extended | smtWeld | https://jlcpcb.com/partdetail/C398363
82k | R8,R9 | ionic_thrust_hv:R0603 | C23254 | UNI-ROYAL(Uniroyal Elec) | 0603WAF8202T5E | 2 | No | CATALOG_MATCH | 1317994 | Basic | smtWeld | https://jlcpcb.com/partdetail/C23254
2.2uF 50V X5R | C82,C83 | Capacitor_SMD:C_0805_2012Metric | C377773 | Samsung Electro-Mechanics | CL21A225KBQNNNE | 2 | No | CATALOG_MATCH | 50000 | Basic | smtWeld | https://jlcpcb.com/partdetail/C377773 | Samsung 2.2uF 50V X5R 10% 0805, JLCPCB Basic Library part. Pi rail only; no USB-PD capacitance increase. Verify effective capacitance >=0.5uF on COIL_3V.
SMBJ15A | D5 | Diode_SMD:D_SMB | C2912077 | LRC | SMBJ15A | 1 | No | CATALOG_MATCH | 3429 | Extended | smtWeld | https://jlcpcb.com/partdetail/C2912077 | Unidirectional TVS across HV_RETURN-GND; 15V standoff,24.4V clamp at24.6A,1uA max leakage at25C. Validate actual arc waveform and loop inductance.
TPS7A0230PDBVR | U10 | Package_TO_SOT_SMD:SOT-23-5 | C3747031 | Texas Instruments | TPS7A0230PDBVR | 1 | No | CATALOG_MATCH | 37473 | Extended | smtWeld | https://jlcpcb.com/partdetail/C3747031 | Pi 3V3 input, regulated 3.0V coil rail; DBV pin1 IN,2 GND,3 EN,4 NC,5 OUT.
S5_HOST | J68 | ionic_thrust_hv:Solder_Pads_2P_P5.08 |  |  |  | 1 | No | PCB_FEATURE |  | PCB feature | Hand-soldered wire | Native PCB feature; no purchased component | J68: pin 1 COM, pin 2 NO; matching mini/host solder-pad pair for four-switch interlock.
1k | R7 | ionic_thrust_hv:R0603 | C21190 | UNI-ROYAL(Uniroyal Elec) | 0603WAF1001T5E | 1 | No | CATALOG_MATCH | 21621023 | Basic | smtWeld | https://jlcpcb.com/partdetail/C21190
10k PULSE 0.75W | R90 | Resistor_SMD:R_1206_3216Metric | C313977 | Vishay Intertech | CRCW120610K0FKEAHP | 1 | No | CATALOG_MATCH | 11597 | Extended | smtWeld | https://jlcpcb.com/partdetail/C313977 | Vishay pulse-proof high power 1206,10k/1%,0.75W,200V. Parallel D5 limits pulse voltage; not an arc-energy certification.
S3_MINI | J62 | ionic_thrust_hv:Solder_Pads_2P_P5.08 |  |  |  | 1 | No | PCB_FEATURE |  | PCB feature | Hand-soldered wire | Native PCB feature; no purchased component | S3_MINI: pin 1 COM, pin 2 NO. Paired solderable plated holes; connect the matching host/mini pair with two wires after cutting its two-net neck. NC stays unused.
G6K-2F-Y DC3 | K1 | Relay_SMD:Relay_DPDT_Omron_G6K-2F-Y | C93168 | Omron Electronics | G6K-2F-Y DC3 | 1 | No | CATALOG_MATCH | 6440 | Extended | smtWeld | https://jlcpcb.com/partdetail/C93168 | Logic contacts only: pole 1 gates U9 BULK_CMD; pole 2 gates DRV_SLEEP_CMD. Coil is 3V regulated, 91 ohm nominal.
TSL2591 | U8 | OptoDevice:AMS_TSL25911FN | C176812 | AMS | TSL25911FN | 1 | No | CATALOG_MATCH | 182 | Extended | smtWeld | https://jlcpcb.com/partdetail/C176812
