uge/ew-1/hardware/pi5_corona_hat_direct/exports/breakoff-pd-bom.csv

Reference | Value | Footprint | Populate
U9 | TPS259470LRPW | ionic_thrust_hv:Texas_RPW0010A_VQFN-HR-10_2x2mm | Yes
J50 | Qwiic HOST | Connector_JST:JST_SH_SM04B-SRSS-TB_1x04-1MP_P1.00mm_Horizontal | Yes
J51 | Qwiic MINI | Connector_JST:JST_SH_SM04B-SRSS-TB_1x04-1MP_P1.00mm_Horizontal | Yes
C70 | 22uF 50V 20% | Capacitor_THT:CP_Radial_D5.0mm_P2.00mm | Yes
C71 | 100nF 50V 10% | Capacitor_SMD:C_0603_1608Metric | Yes
C72 | 2.2nF 50V 10% | Capacitor_SMD:C_0603_1608Metric | Yes
C73 | 1.8uF 50V 10% | Capacitor_SMD:C_2220_5750Metric | Yes
C80 | 100nF 10V X7R | Capacitor_SMD:C_0603_1608Metric | Yes
C81 | 1uF 10V X7R | Capacitor_SMD:C_0603_1608Metric | Yes
R70 | 100k 1% | Resistor_SMD:R_0603_1608Metric | Yes
R71 | 976k 0.1% | Resistor_SMD:R_0805_2012Metric | Yes
R72 | 56.2k 0.1% | Resistor_SMD:R_0603_1608Metric | Yes
R73 | 3.32k 1% | Resistor_SMD:R_0603_1608Metric | Yes
U8 | TSL2591 | OptoDevice:AMS_TSL25911FN | Yes
C21 | 4.7uF 50V 10% | Capacitor_SMD:C_1210_3225Metric | Yes
C17 | 1uF 50V 10% | Capacitor_SMD:C_0603_1608Metric | Yes
C18 | 100nF 10% | Capacitor_SMD:C_0603_1608Metric | Yes
C19 | 1uF 16V 10% | Capacitor_SMD:C_0603_1608Metric | Yes
C20 | 100nF 10% | Capacitor_SMD:C_0603_1608Metric | Yes
C22 | 10uF 50V 10% | Capacitor_SMD:C_1210_3225Metric | Yes
C10 | 100nF 50V X7R 10% | Capacitor_SMD:C_0603_1608Metric | Yes
C12 | 10uF 50V X7R 10% | Capacitor_SMD:C_1210_3225Metric | Yes
C60 | 33uF 50V 20% | Capacitor_THT:CP_Radial_D5.0mm_P2.00mm | Yes
C61 | 100nF 16V X7R 10% | Capacitor_SMD:C_0603_1608Metric | Yes
C62 | 22nF 50V X7R 10% | Capacitor_SMD:C_0603_1608Metric | Yes
