uge/ew-1/hardware/pi5_corona_hat_direct/exports/protection-bom.csv

Reference | Value | Footprint | Populate
D50 | VSSA310S-M3 | Diode_SMD:D_SMA | Yes
C10 | 100nF 50V X7R 10% | Capacitor_SMD:C_0603_1608Metric | Yes
C12 | 10uF 50V X7R 10% | Capacitor_SMD:C_1210_3225Metric | Yes
C60 | 33uF 50V 20% | Capacitor_THT:CP_Radial_D5.0mm_P2.00mm | Yes
D51 | SMBJ22A | Diode_SMD:D_SMB | Yes
D52 | SS36 60V 3A | Diode_SMD:D_SMC | Yes
D53 | SS36 60V 3A | Diode_SMD:D_SMC | Yes
D54 | SS36 60V 3A | Diode_SMD:D_SMC | Yes
D55 | SS36 60V 3A | Diode_SMD:D_SMC | Yes
U2 | DRV8876PWPR | Package_SO:HTSSOP-16-1EP_4.4x5mm_P0.65mm_EP3.4x5mm_Mask3x3mm_ThermalVias | Yes
R5 | 10k | Resistor_SMD:R_0603_1608Metric | Yes
R62 | 62k 1% | Resistor_SMD:R_0603_1608Metric | Yes
R61 | 3.3k 1% | Resistor_SMD:R_0603_1608Metric | Yes
R63 | 10k | Resistor_SMD:R_0603_1608Metric | Yes
TP50 | DRV FAULT | TestPoint:TestPoint_Pad_D1.5mm | Yes
C61 | 100nF 16V X7R 10% | Capacitor_SMD:C_0603_1608Metric | Yes
C62 | 22nF 50V X7R 10% | Capacitor_SMD:C_0603_1608Metric | Yes
R64 | 100R 1W DNP | Resistor_SMD:R_2512_6332Metric | No
C63 | 1nF 100V DNP | Capacitor_SMD:C_0805_2012Metric | No
R60 | 1k 1W | Resistor_SMD:R_2512_6332Metric | Yes
