uge/ew-1/hardware/ionic_thrust_hv_bom.csv

Refs | Value | Footprint | Qty | DNP
C1 | 10uF | ionic_thrust_hv:C0805 | 1
C2 | 10uF | ionic_thrust_hv:C0805 | 1
C3 | 22uF | ionic_thrust_hv:C0805 | 1
C4 | 22uF | ionic_thrust_hv:C0805 | 1
C5 | 100nF | ionic_thrust_hv:C0603 | 1
C6 | 100nF | ionic_thrust_hv:C0603 | 1
C7 | 100nF | ionic_thrust_hv:C0603 | 1
C8 | 100nF | ionic_thrust_hv:C0603 | 1
C9 | 100nF | ionic_thrust_hv:C0603 | 1
C10 | 100nF | ionic_thrust_hv:C0603 | 1
C11 | 120nF 100V | ionic_thrust_hv:C_Radial_P10.0mm | 1 | DNP
C12 | 10uF | ionic_thrust_hv:C0805 | 1
C13 | 100nF | ionic_thrust_hv:C0603 | 1
C14 | 100nF | ionic_thrust_hv:C0603 | 1
C15 | 100nF | ionic_thrust_hv:C0603 | 1
C16 | 100nF | ionic_thrust_hv:C0603 | 1
C20 | 1nF 6kV | ionic_thrust_hv:CAP-TH_L15.0-W4.0-P10.00-D0.6 | 1 | DNP
C21 | 1nF 6kV | ionic_thrust_hv:CAP-TH_L15.0-W4.0-P10.00-D0.6 | 1 | DNP
C22 | 1nF 6kV | ionic_thrust_hv:CAP-TH_L15.0-W4.0-P10.00-D0.6 | 1 | DNP
C23 | 1nF 6kV | ionic_thrust_hv:CAP-TH_L15.0-W4.0-P10.00-D0.6 | 1 | DNP
C24 | 1nF 6kV | ionic_thrust_hv:CAP-TH_L15.0-W4.0-P10.00-D0.6 | 1 | DNP
C25 | 1nF 6kV | ionic_thrust_hv:CAP-TH_L15.0-W4.0-P10.00-D0.6 | 1 | DNP
C26 | 1nF 6kV | ionic_thrust_hv:CAP-TH_L15.0-W4.0-P10.00-D0.6 | 1 | DNP
C27 | 1nF 6kV | ionic_thrust_hv:CAP-TH_L15.0-W4.0-P10.00-D0.6 | 1 | DNP
C28 | 1nF 6kV | ionic_thrust_hv:CAP-TH_L15.0-W4.0-P10.00-D0.6 | 1 | DNP
C29 | 1nF 6kV | ionic_thrust_hv:CAP-TH_L15.0-W4.0-P10.00-D0.6 | 1 | DNP
C30 | 1nF 6kV | ionic_thrust_hv:CAP-TH_L15.0-W4.0-P10.00-D0.6 | 1 | DNP
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
R49 | 100M 3.5kV | ionic_thrust_hv:RES-TH_BD3.5-L9.5-P13.50-D0.6 | 1 | DNP
R50 | 100M 3.5kV | ionic_thrust_hv:RES-TH_BD3.5-L9.5-P13.50-D0.6 | 1 | DNP
R51 | 100M 3.5kV | ionic_thrust_hv:RES-TH_BD3.5-L9.5-P13.50-D0.6 | 1 | DNP
S3 | LID_SW_1 | ionic_thrust_hv:SW-TH_D2F-L | 1 | DNP
S4 | LID_SW_2 | ionic_thrust_hv:SW-TH_D2F-L | 1 | DNP
S6 | ARM | ionic_thrust_hv:SW-SMD_4P-L5.1-W5.1-P3.70-LS6.5-TL_H1.5 | 1
SW1 | RESET | ionic_thrust_hv:SW-SMD_4P-L5.1-W5.1-P3.70-LS6.5-TL_H1.5 | 1
SW2 | BOOT | ionic_thrust_hv:SW-SMD_4P-L5.1-W5.1-P3.70-LS6.5-TL_H1.5 | 1
T1 | FL2015-4LD | ionic_thrust_hv:Coilcraft_FL2015-4L | 1 | DNP
U1 | ESP32-C3-WROOM-02 | ionic_thrust_hv:WIFIM-SMD_18P-L20.0-W18.0-P1.50 | 1
U2 | DRV8220DSGR | ionic_thrust_hv:WSON-8_L2.0-W2.0-P0.50-TL-EP | 1
U3 | AP63203 | ionic_thrust_hv:TSOT-26_L2.9-W1.6-P0.95-LS2.8-BL | 1
U4 | TLV9001 | ionic_thrust_hv:SOT-23-5_L3.0-W1.7-P0.95-LS2.8-BR | 1
U5 | BME280 | Package_LGA:Bosch_LGA-8_2.5x2.5mm_P0.65mm_ClockwisePinNumbering | 1
