uge/ew-1/(list of files, cad)

Other CAD files:
hardware/pi5_corona_hat_direct/exports/pi5_corona_hv.step
