uge/ew-1/hardware/pi5_corona_hat_direct/exports/compact-pi5-assembly.png

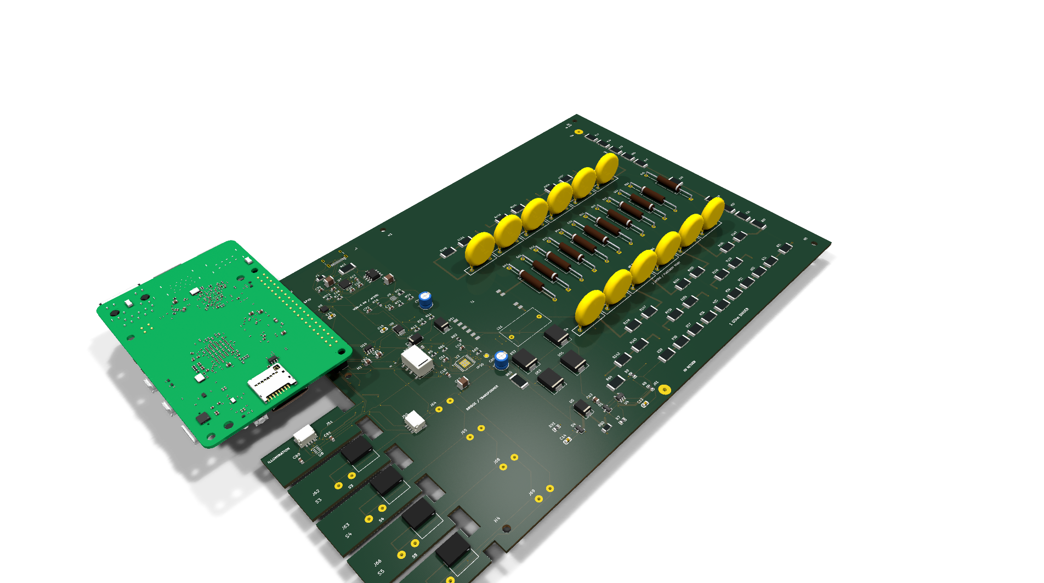
hardware/pi5_corona_hat_direct/exports/compact-pi5-assembly.png
