uge/ew-1/hardware/pi5_corona_hat_direct/exports/spice_sense_adc_verification.png

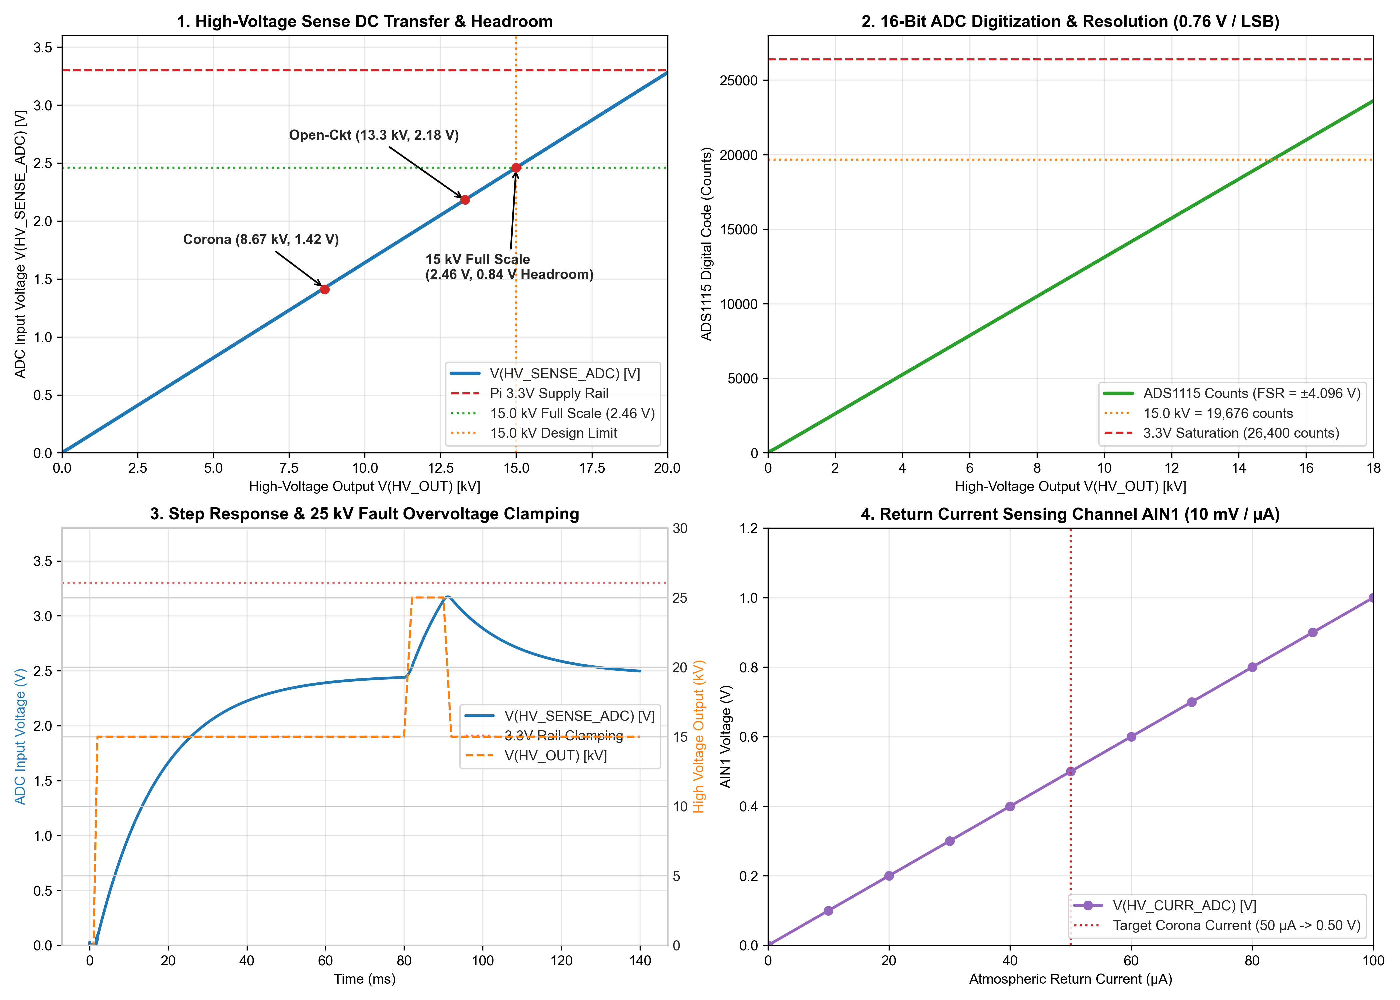
hardware/pi5_corona_hat_direct/exports/spice_sense_adc_verification.png
