uge/ew-1/hardware/pi5_corona_hat_direct/revisions/N-layout-12-before-LV-optimization/README.md

# Before low-voltage optimization

Exact working-board snapshot from 2026-10-19, including pre-existing uncommitted PCB/project edits. Baseline: 55 native DRC findings, 144 unconnected items. Preserved before N-layout-13-LV.
