uge/ew-1/hardware/pi5_corona_hat_direct/revisions/N-layout-13-before-surge-path/README.md

# N-layout-13-LV before surge-path improvement

Exact working-board/project/rules and HV-return review saved before N-layout-14-surge. Existing user edits and accepted LV routing are preserved in this snapshot.
