uge/ew-1/hardware/exports/arcing_risk_map.png

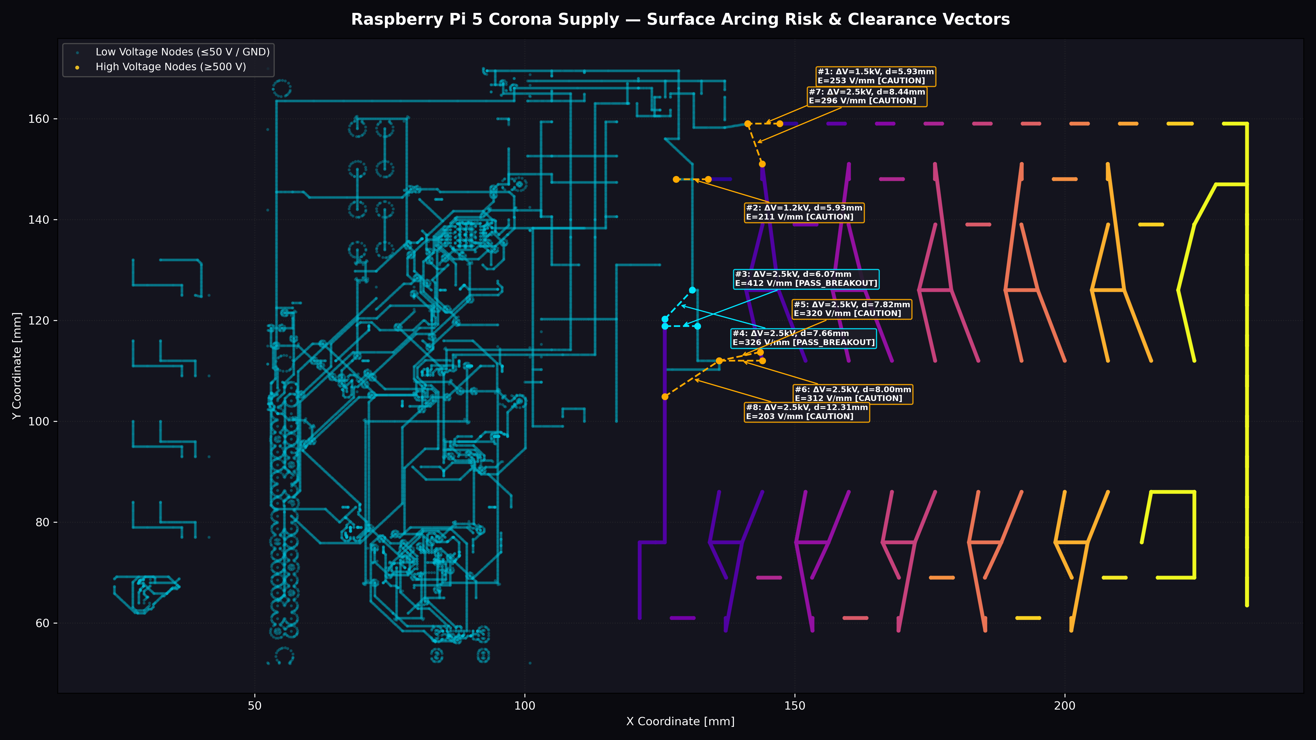
hardware/exports/arcing_risk_map.png
