uge/ew-1/hardware/pi5_corona_hat_direct/exports/arcing_risk_map.png

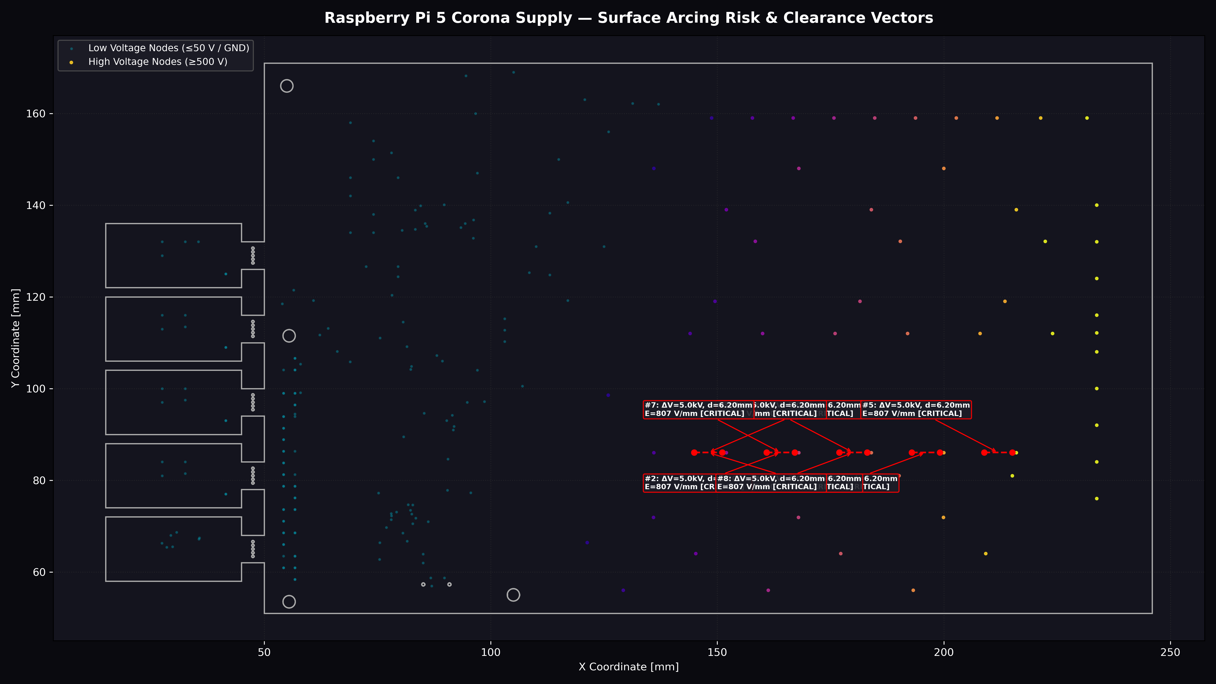
hardware/pi5_corona_hat_direct/exports/arcing_risk_map.png
