uge/ew-1/hardware/pi5_corona_hat_direct/revisions/N-layout-13-before-surge-path/hv-return-layout.png

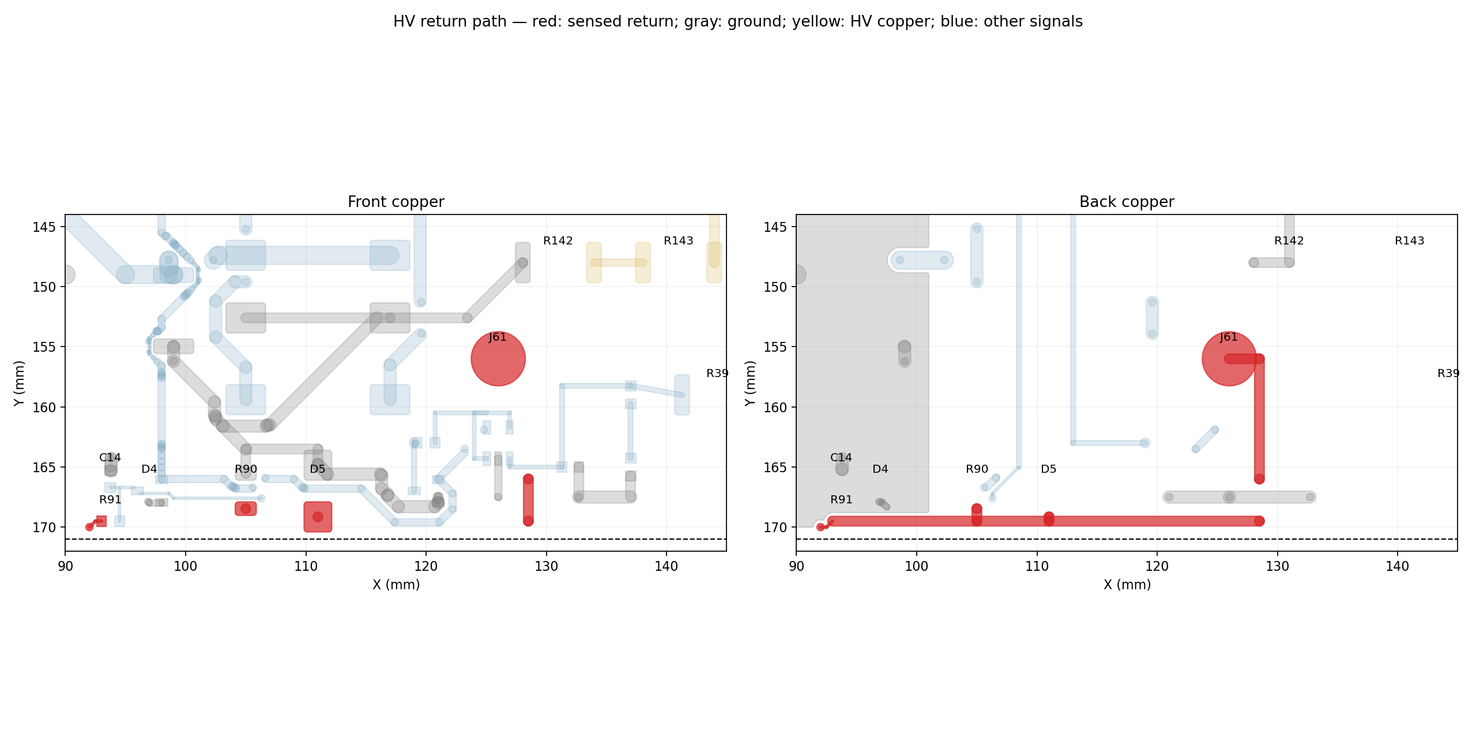
hardware/pi5_corona_hat_direct/revisions/N-layout-13-before-surge-path/hv-return-layout.png
