uge/ew-1/docs/ionic_thrust_hv_schematic.pdf

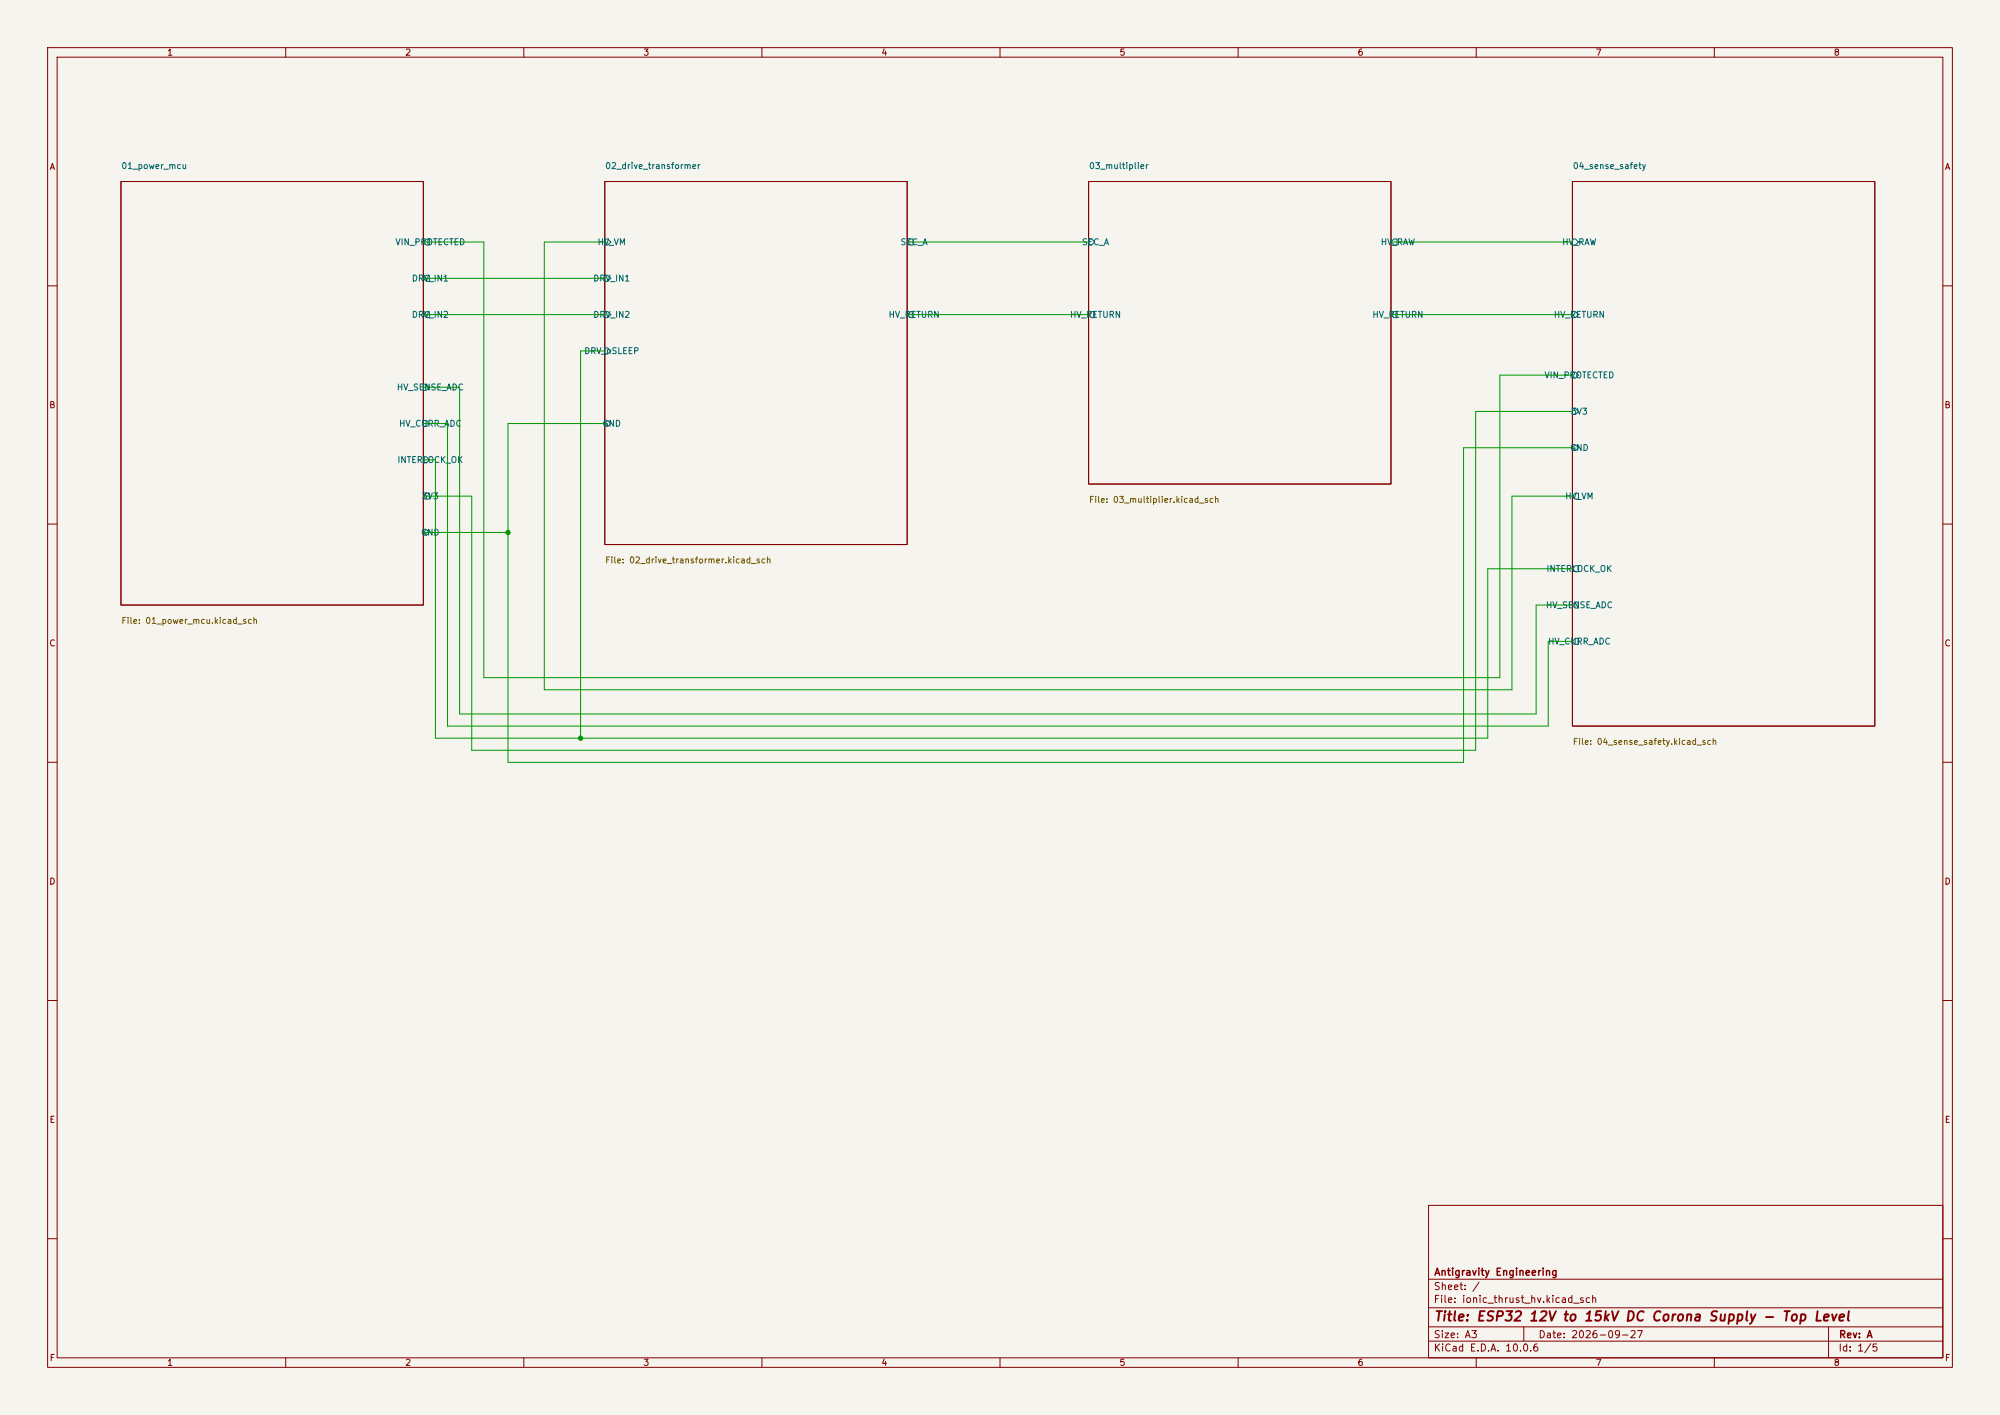
[picture p32: page 1]

Antigravity Engineering
Sheet: /
File: ionic_thrust_hv.kicad_sch
Title: ESP32 12V to 15kV DC Corona Supply - Top Level

Size: A3 | Rev: A | F Date: 2026-09-27
KiCad E.D.A. 10.0.6 | Id: 1/5

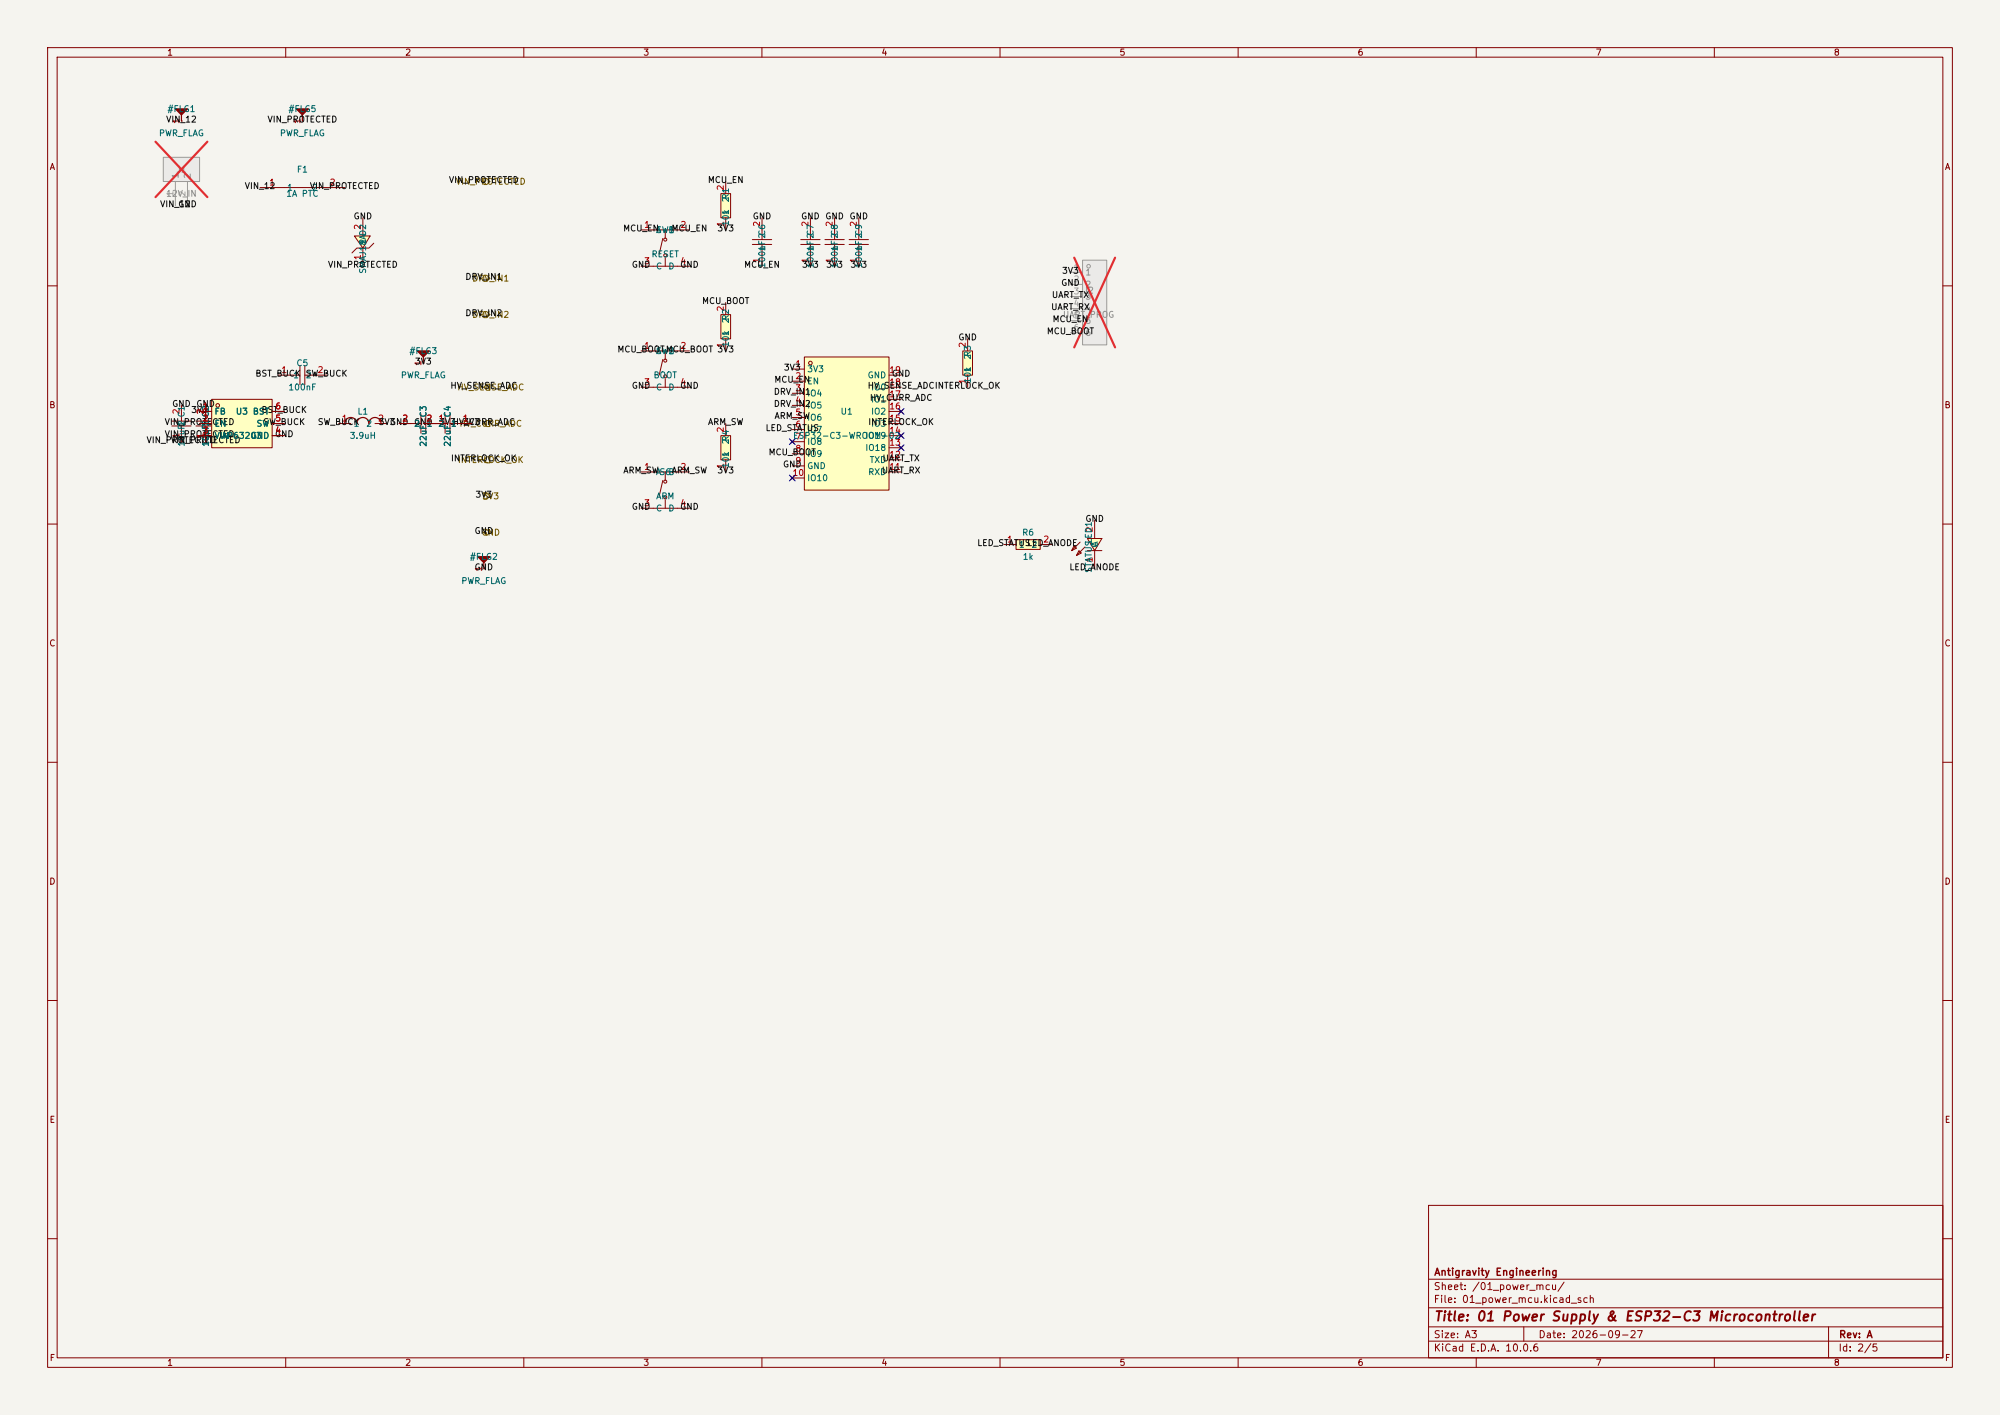
[picture p33: page 2]

Antigravity Engineering
Sheet: /01_power_mcu/
File: 01_power_mcu.kicad_sch
Title: 01 Power Supply & ESP32-C3 Microcontroller

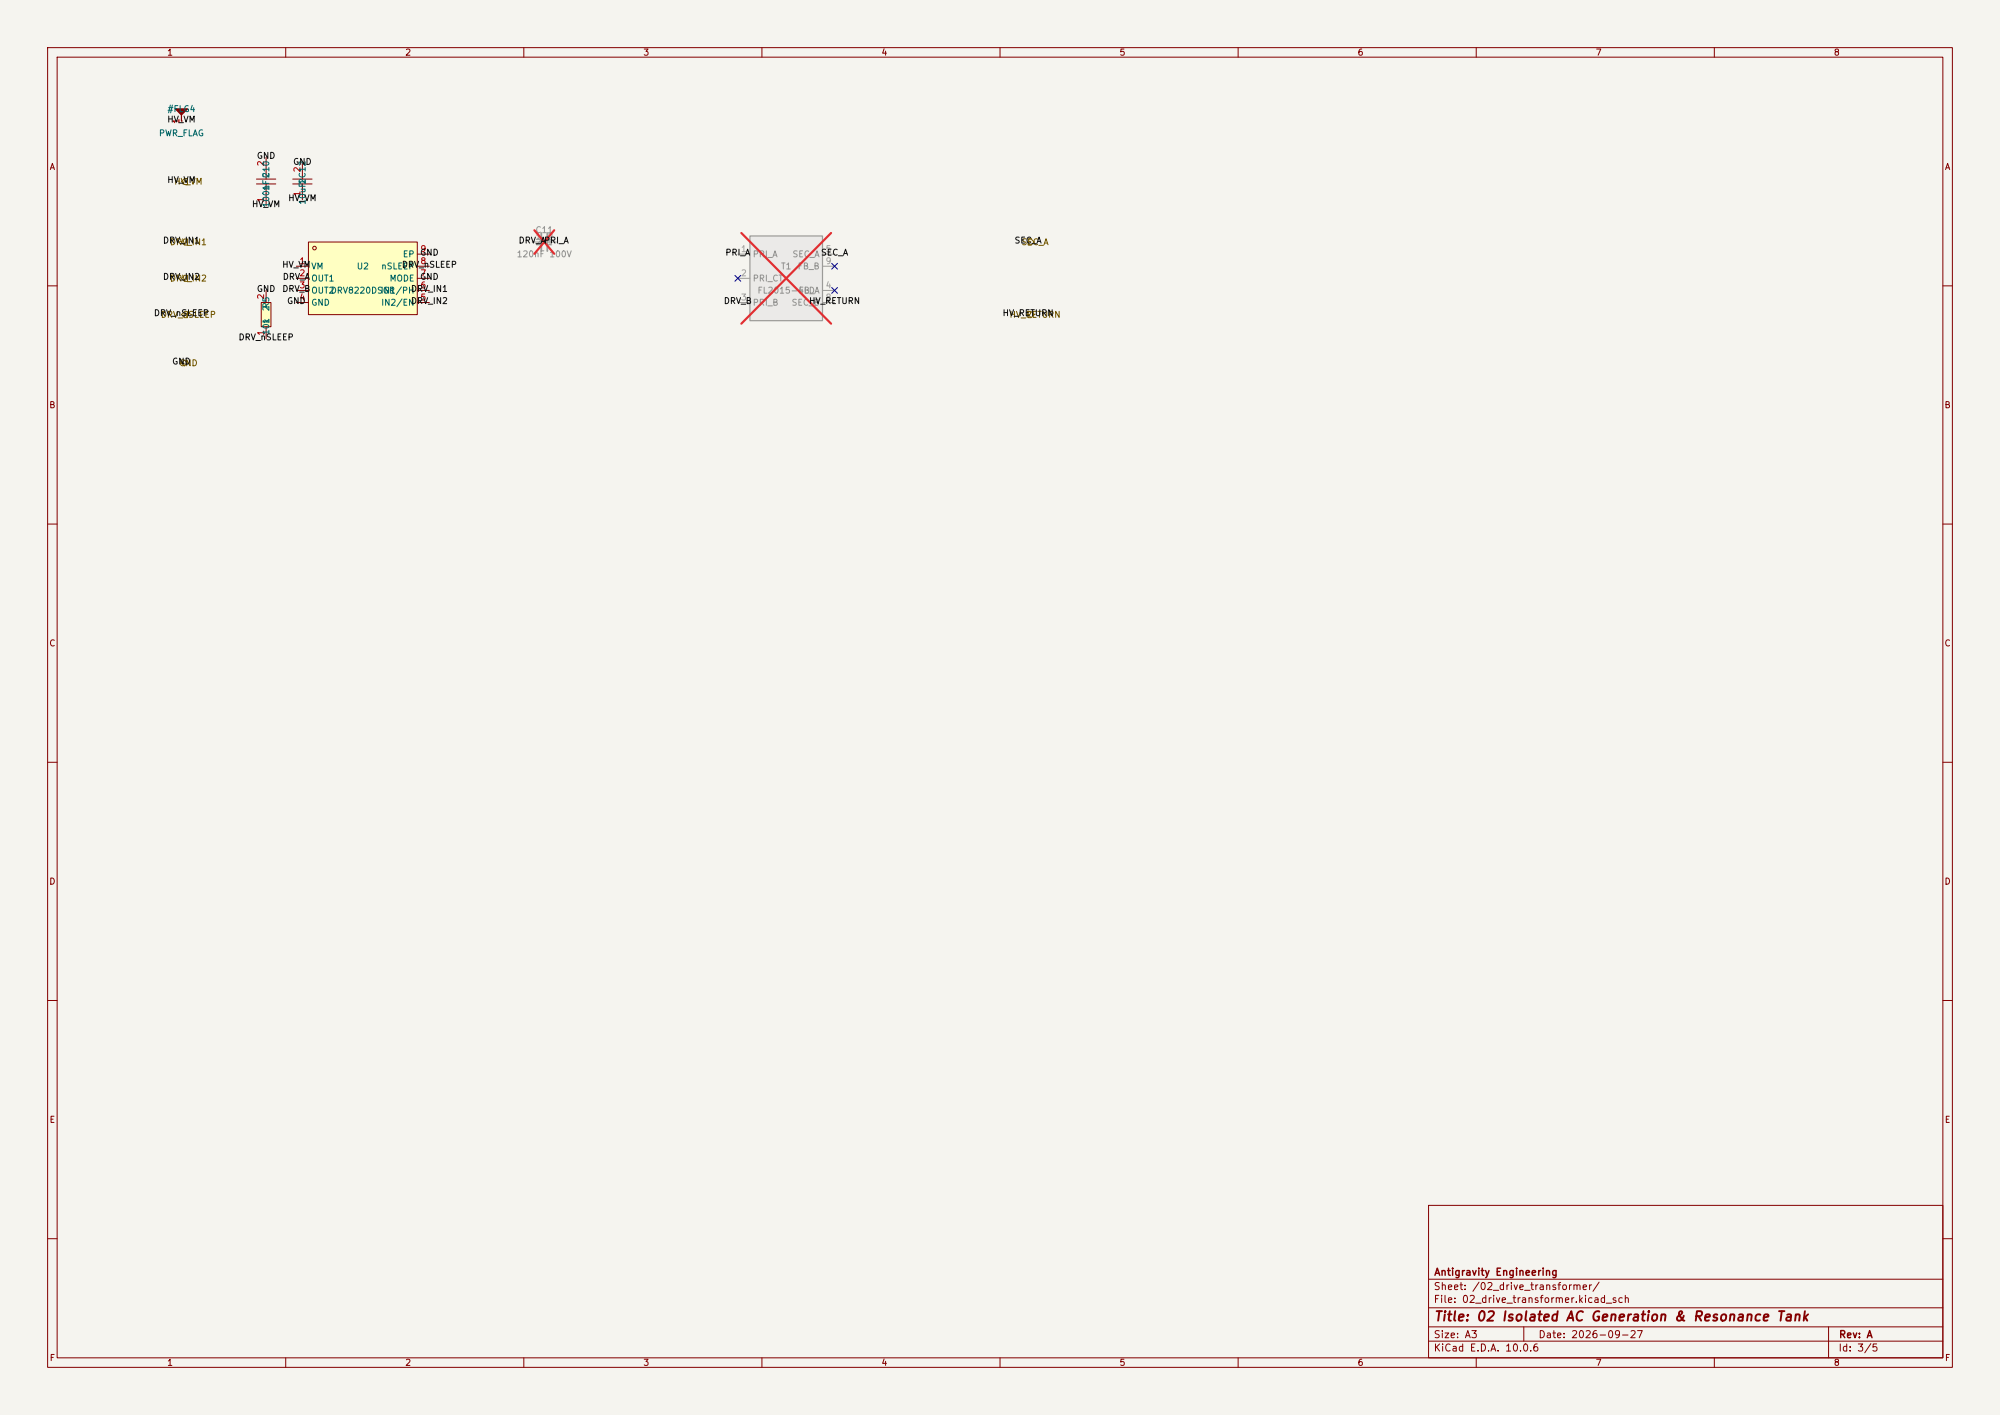
[picture p34: page 3]

Antigravity Engineering
Sheet: /02_drive_transformer/
File: 02_drive_transformer.kicad_sch
Title: 02 Isolated AC Generation & Resonance Tank

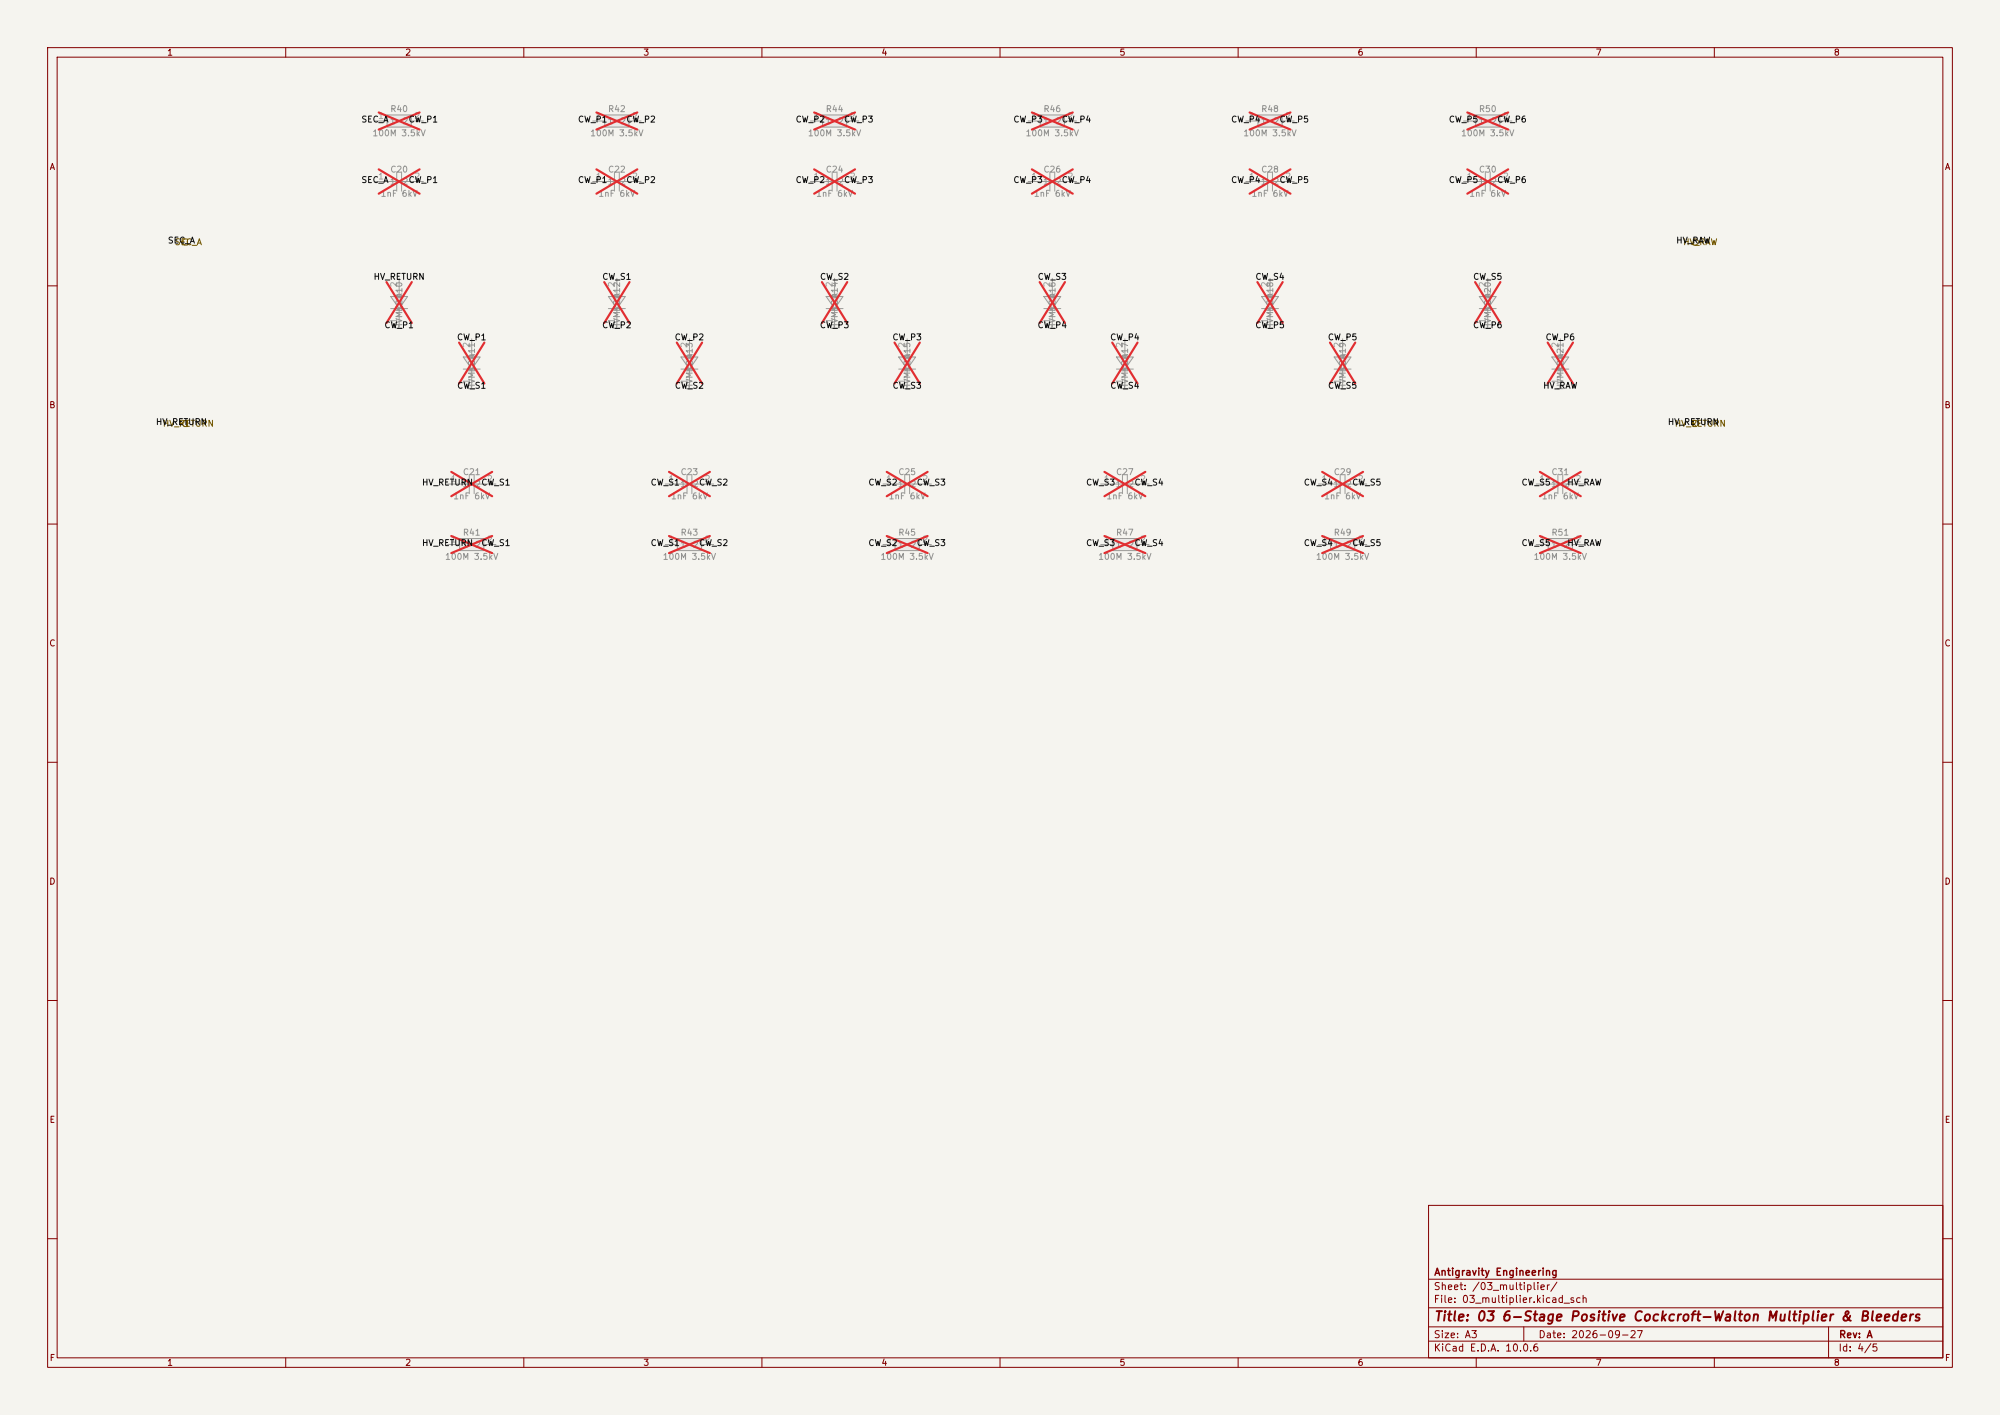
[picture p35: page 4]

Antigravity Engineering
Sheet: /03_multiplier/
File: 03_multiplier.kicad_sch
Title: 03 6-Stage Positive Cockcroft-Walton Multiplier & Bleeders

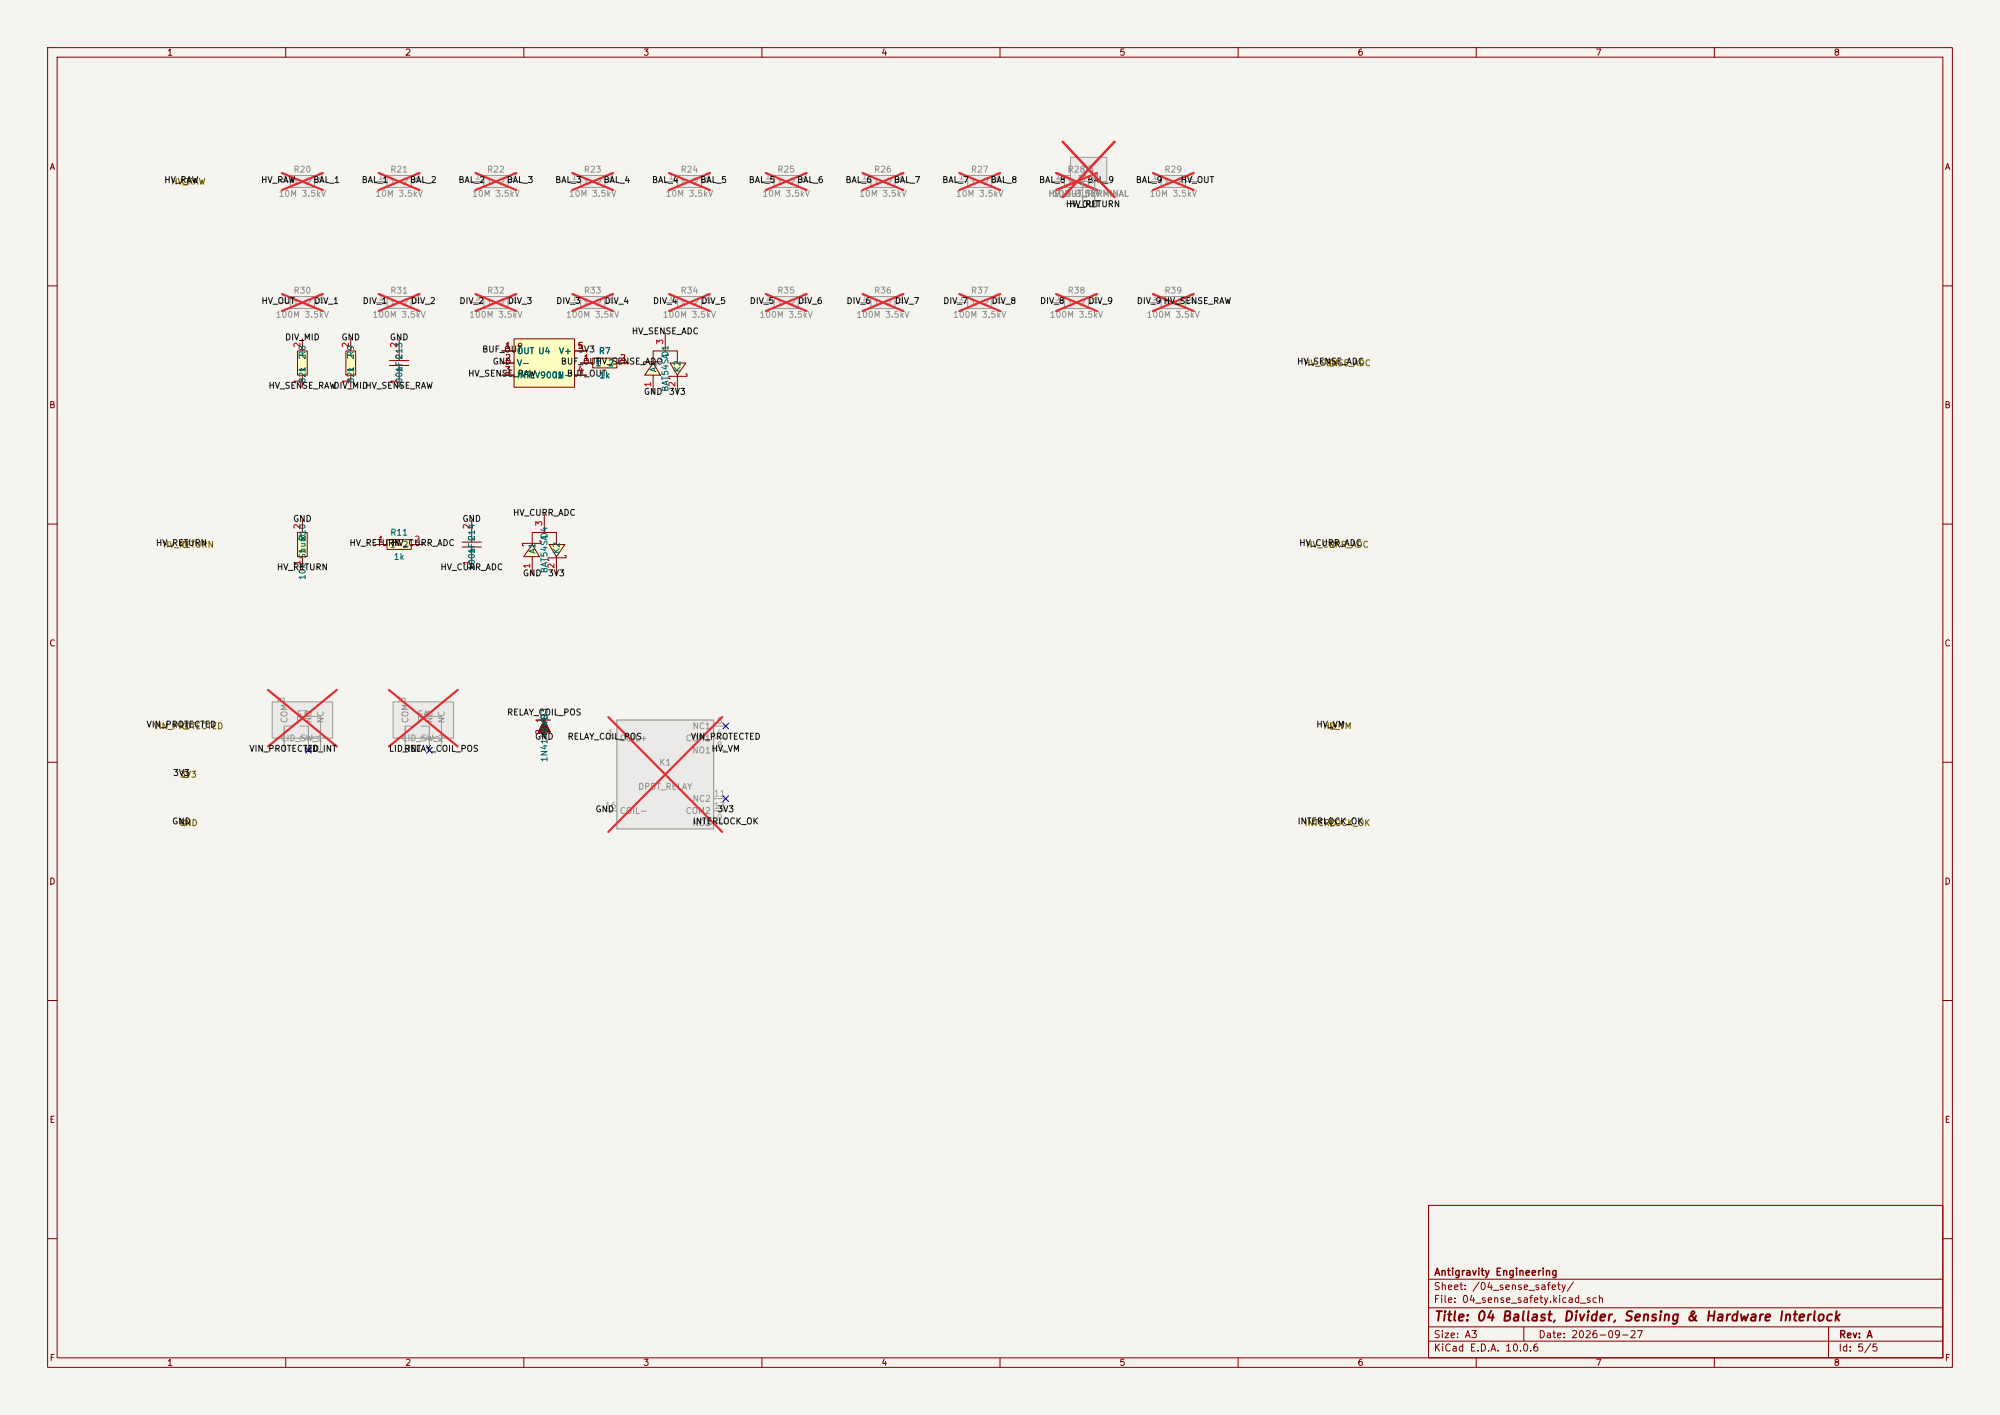
[picture p36: page 5]

Sheet: /04_sense_safety/
File: 04_sense_safety.kicad_sch
Title: 04 Ballast, Divider, Sensing & Hardware Interlock
