uge/ew-1/hardware/ionic_thrust_hv_schematic.pdf

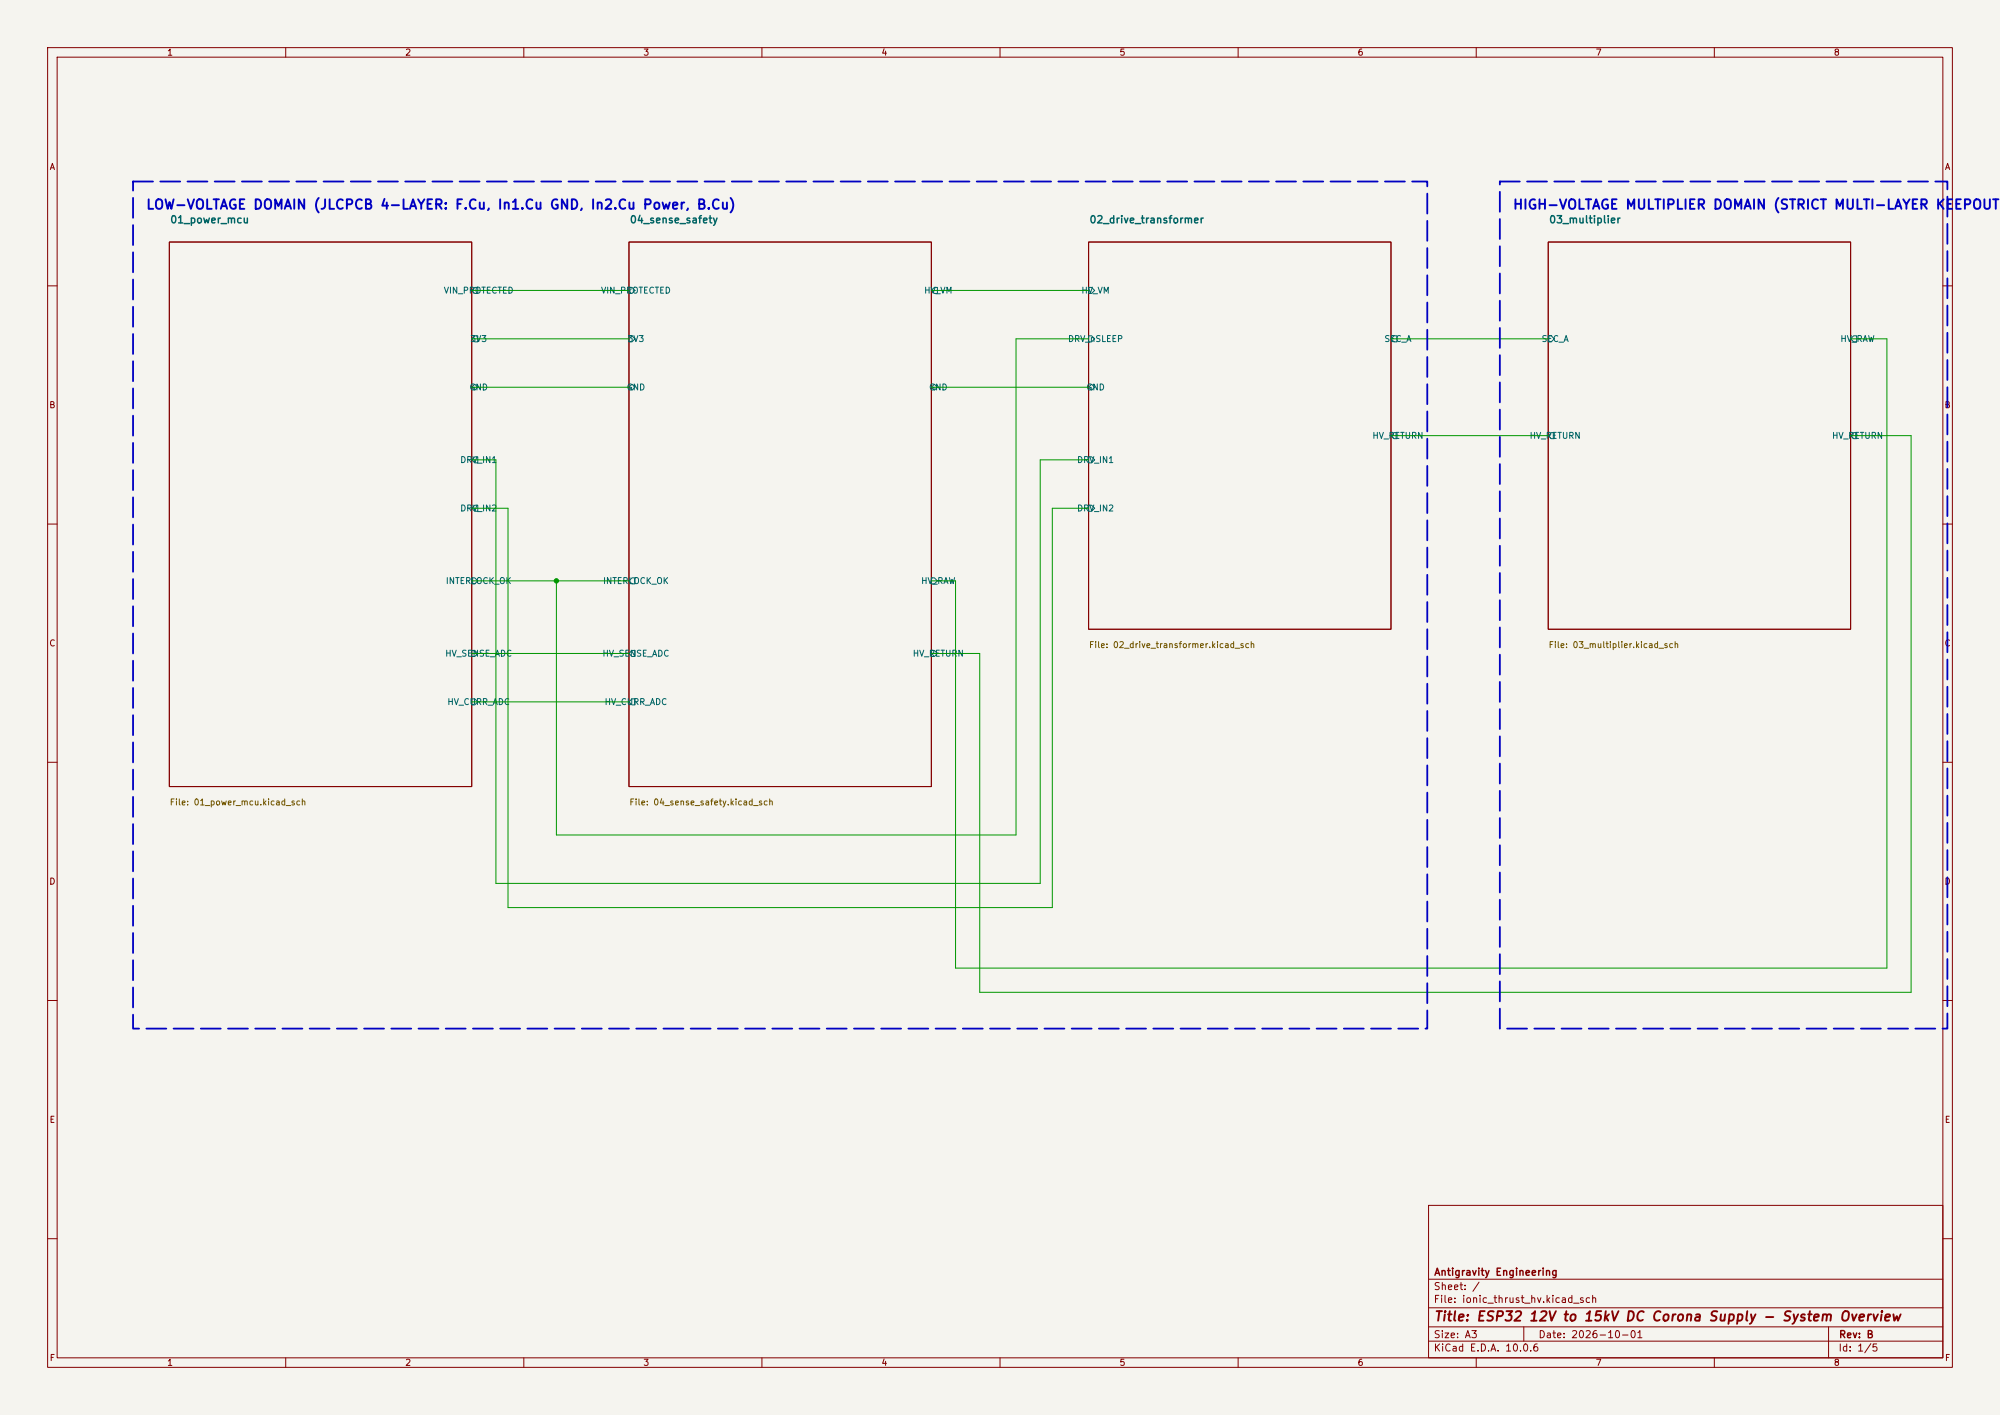
[picture p37: page 1]

Antigravity Engineering
Sheet: /
File: ionic_thrust_hv.kicad_sch
Title: ESP32 12V to 15kV DC Corona Supply - System Overview

Size: A3 | Rev: B | F Date: 2026-10-01
KiCad E.D.A. 10.0.6 | Id: 1/5

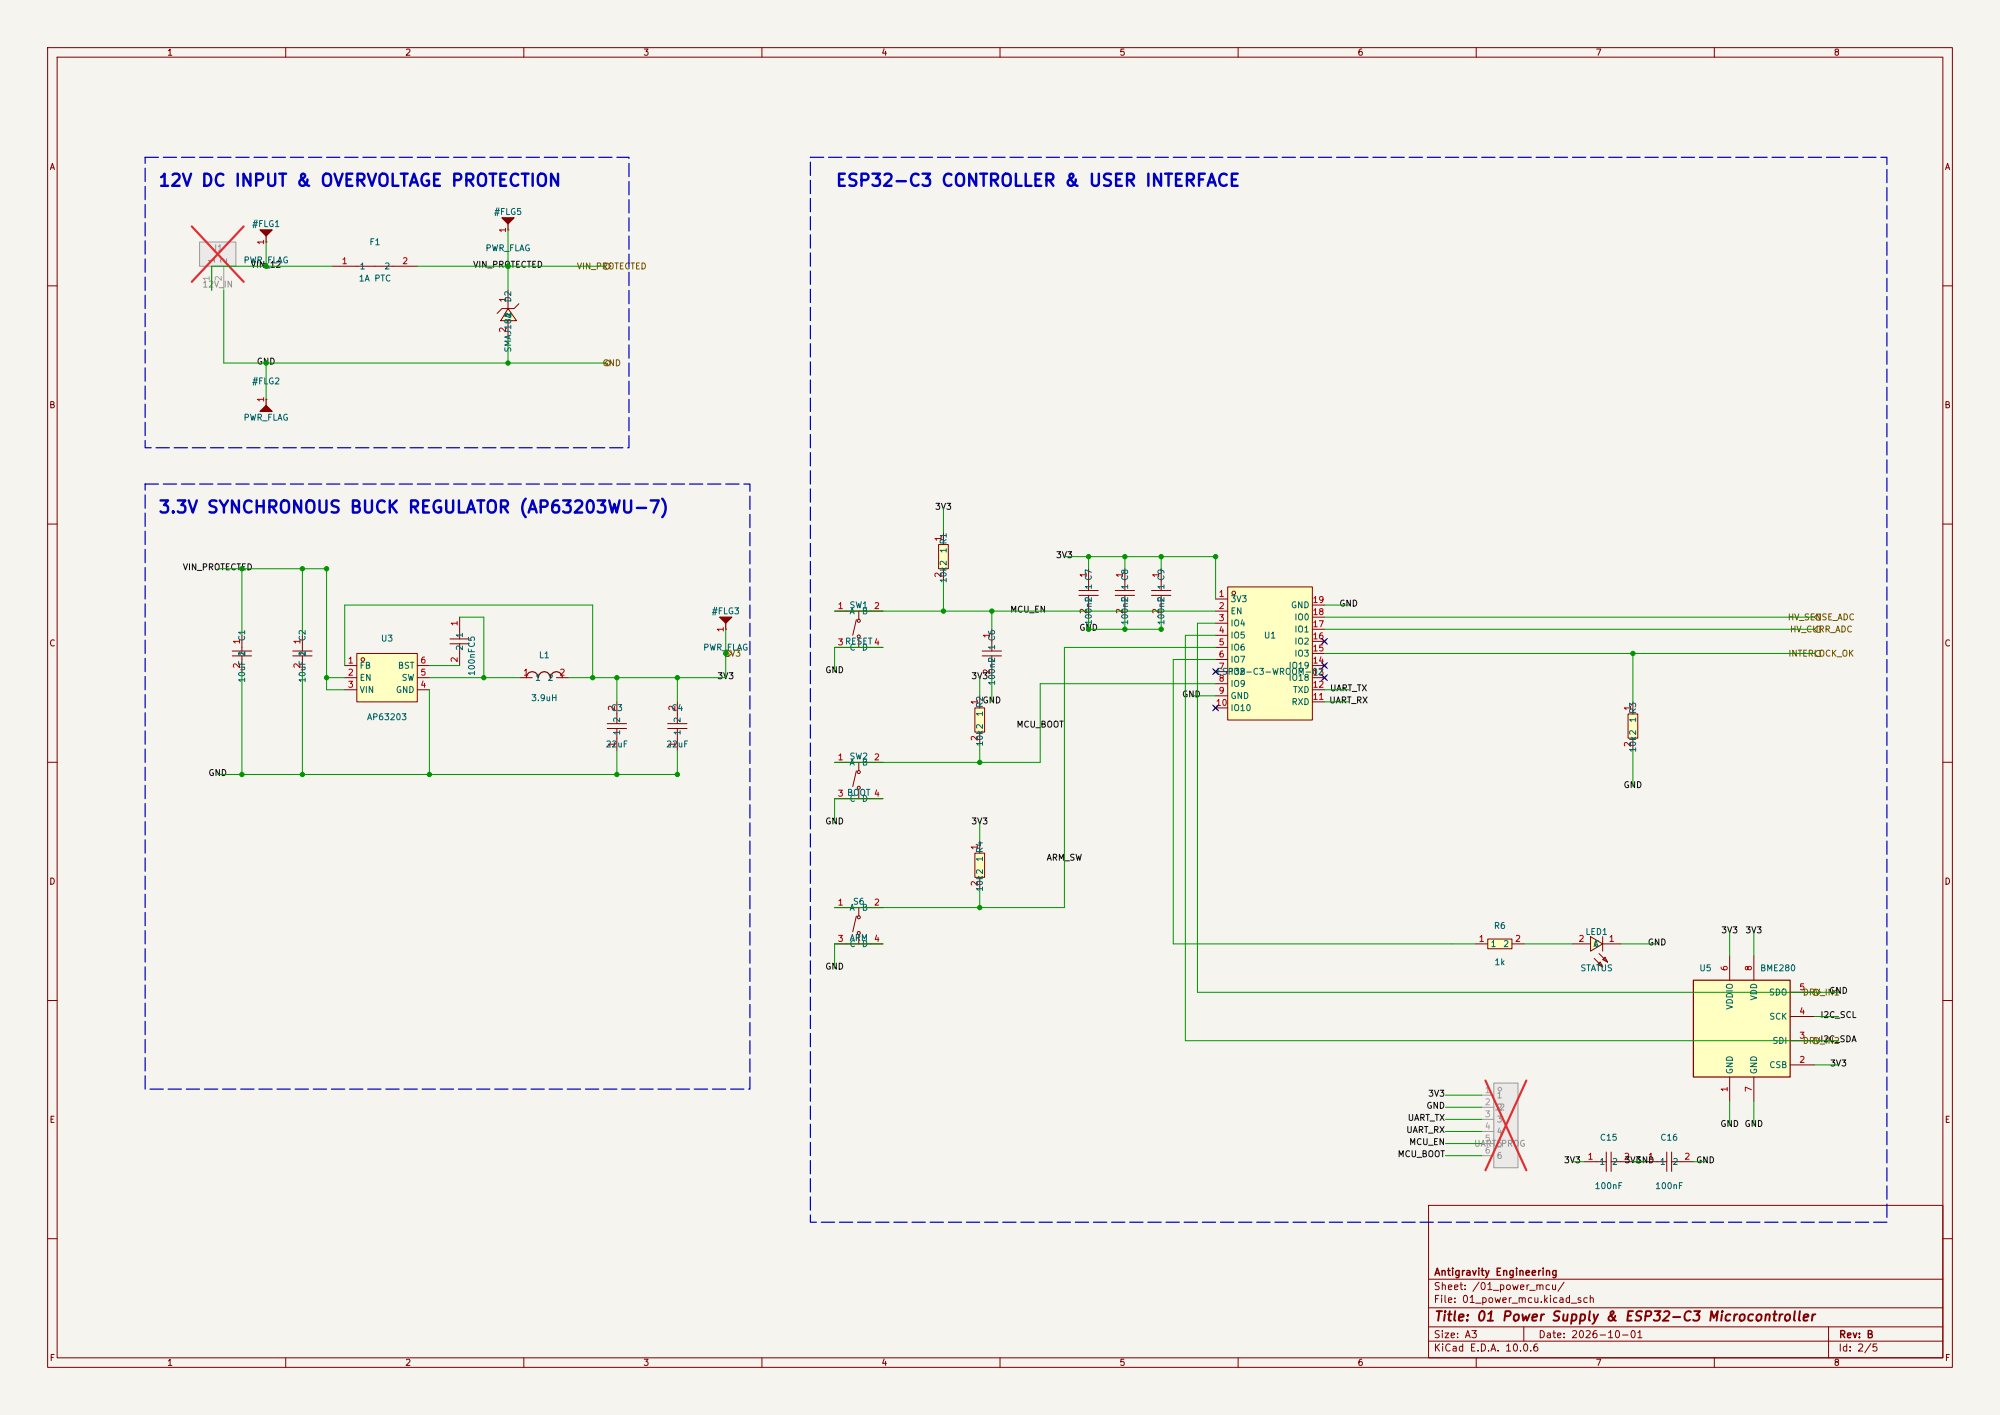
[picture p38: page 2]

12V DC INPUT & OVERVOLTAGE PROTECTION

IO6 5
IO7 6
IO8 7

Antigravity Engineering
Sheet: /01_power_mcu/
File: 01_power_mcu.kicad_sch
Title: 01 Power Supply & ESP32-C3 Microcontroller

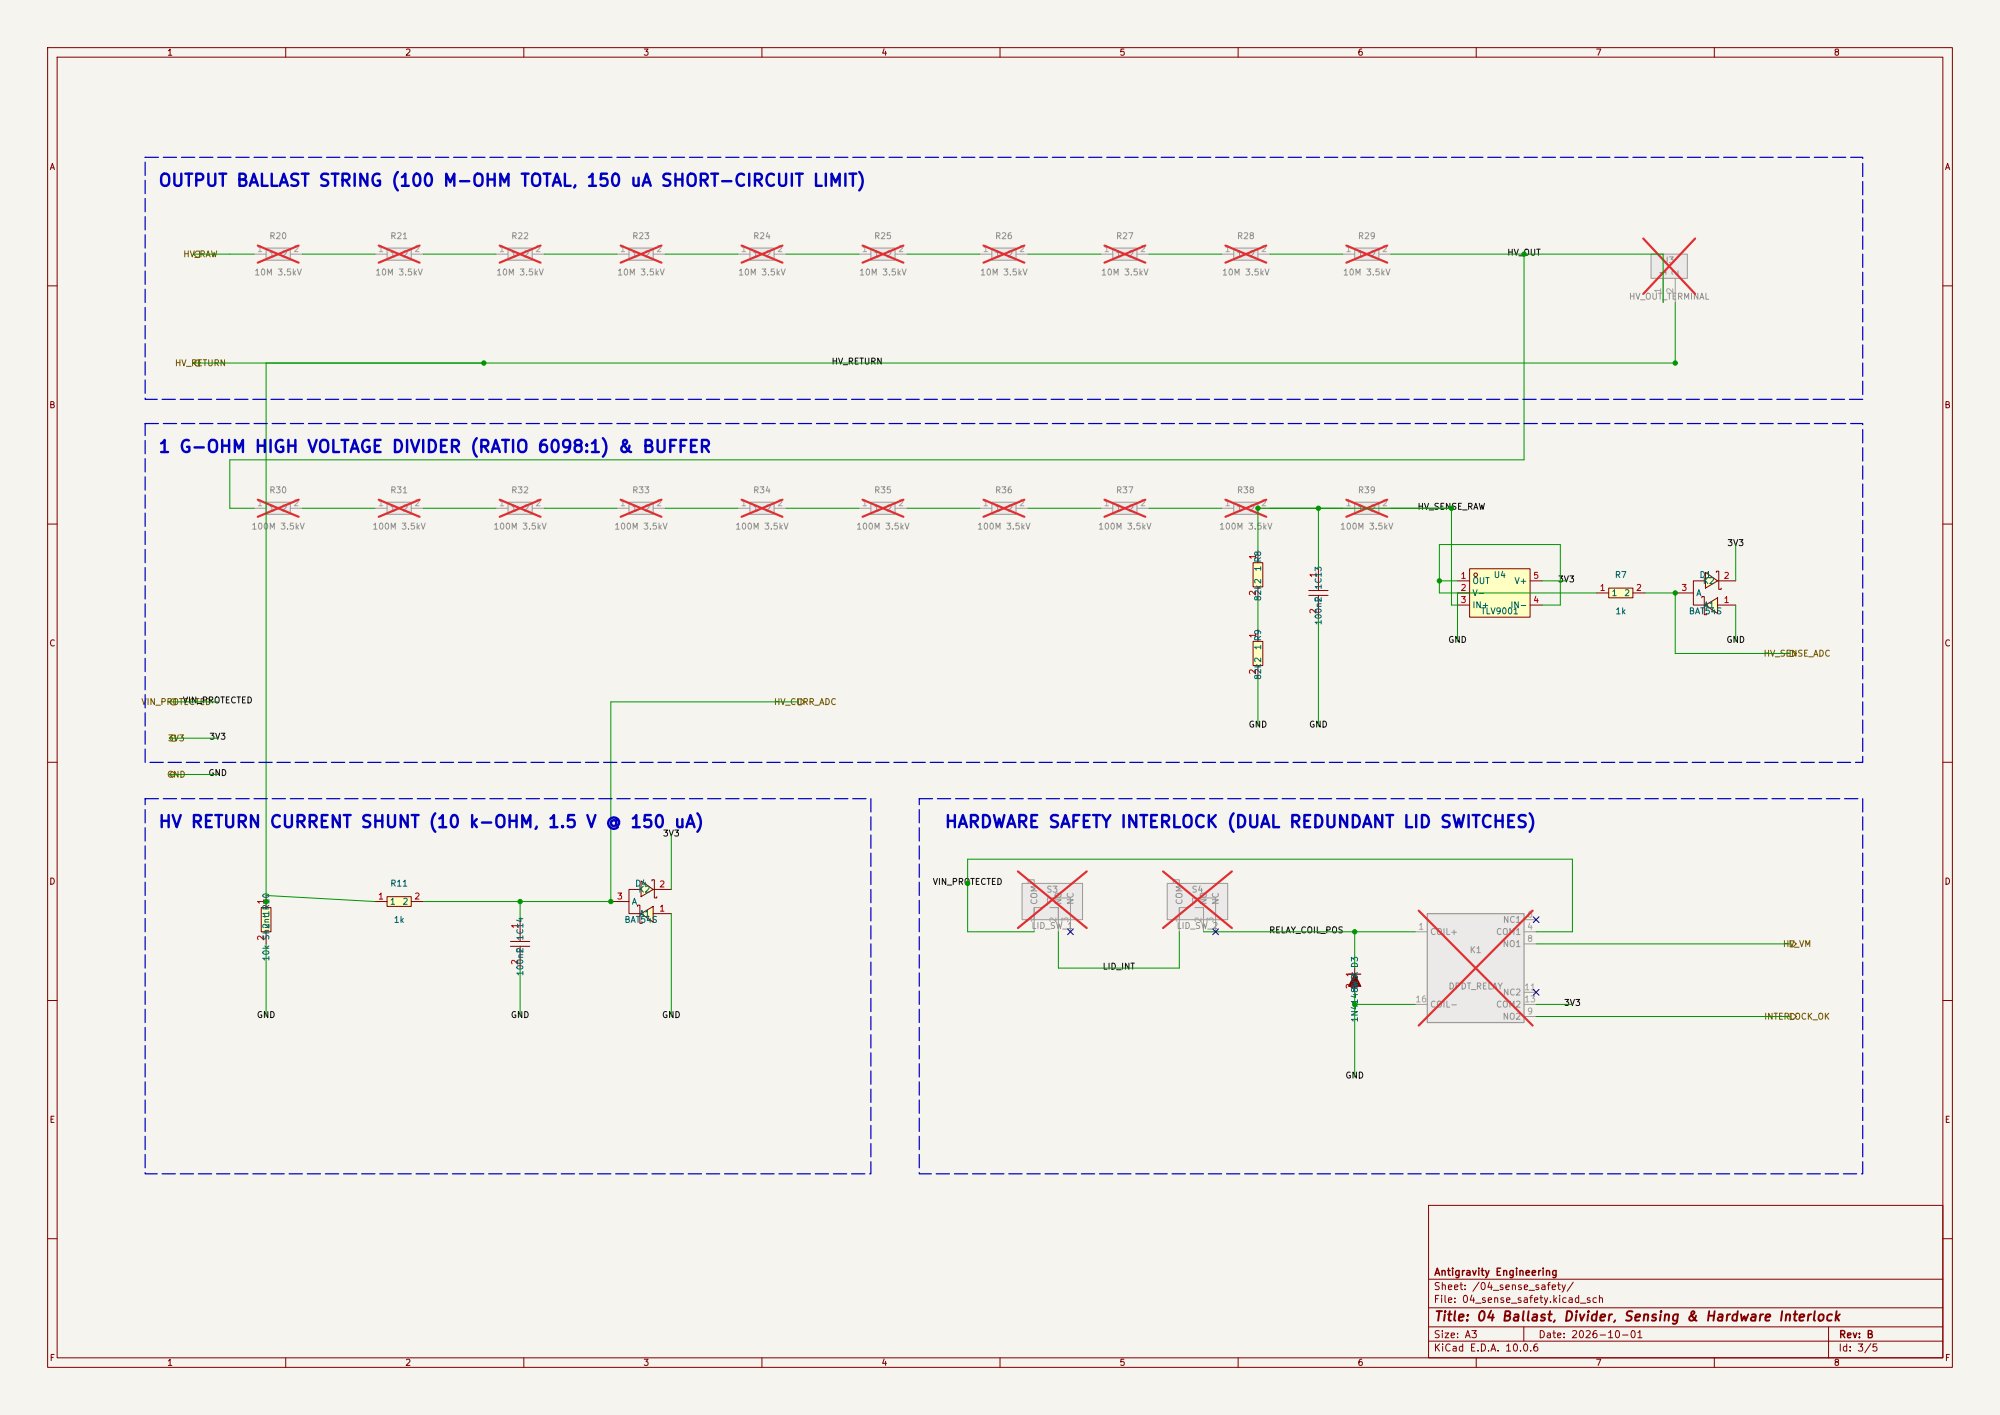
[picture p39: page 3]

OUTPUT BALLAST STRING (100 M-OHM TOTAL, 150 uA SHORT-CIRCUIT LIMIT)

3V3 1 G-OHM HIGH VOLTAGE DIVIDER (RATIO 6098:1) & BUFFER

V- 2
IN+ 3 TLV9001

Antigravity Engineering
Sheet: /04_sense_safety/
File: 04_sense_safety.kicad_sch
Title: 04 Ballast, Divider, Sensing & Hardware Interlock

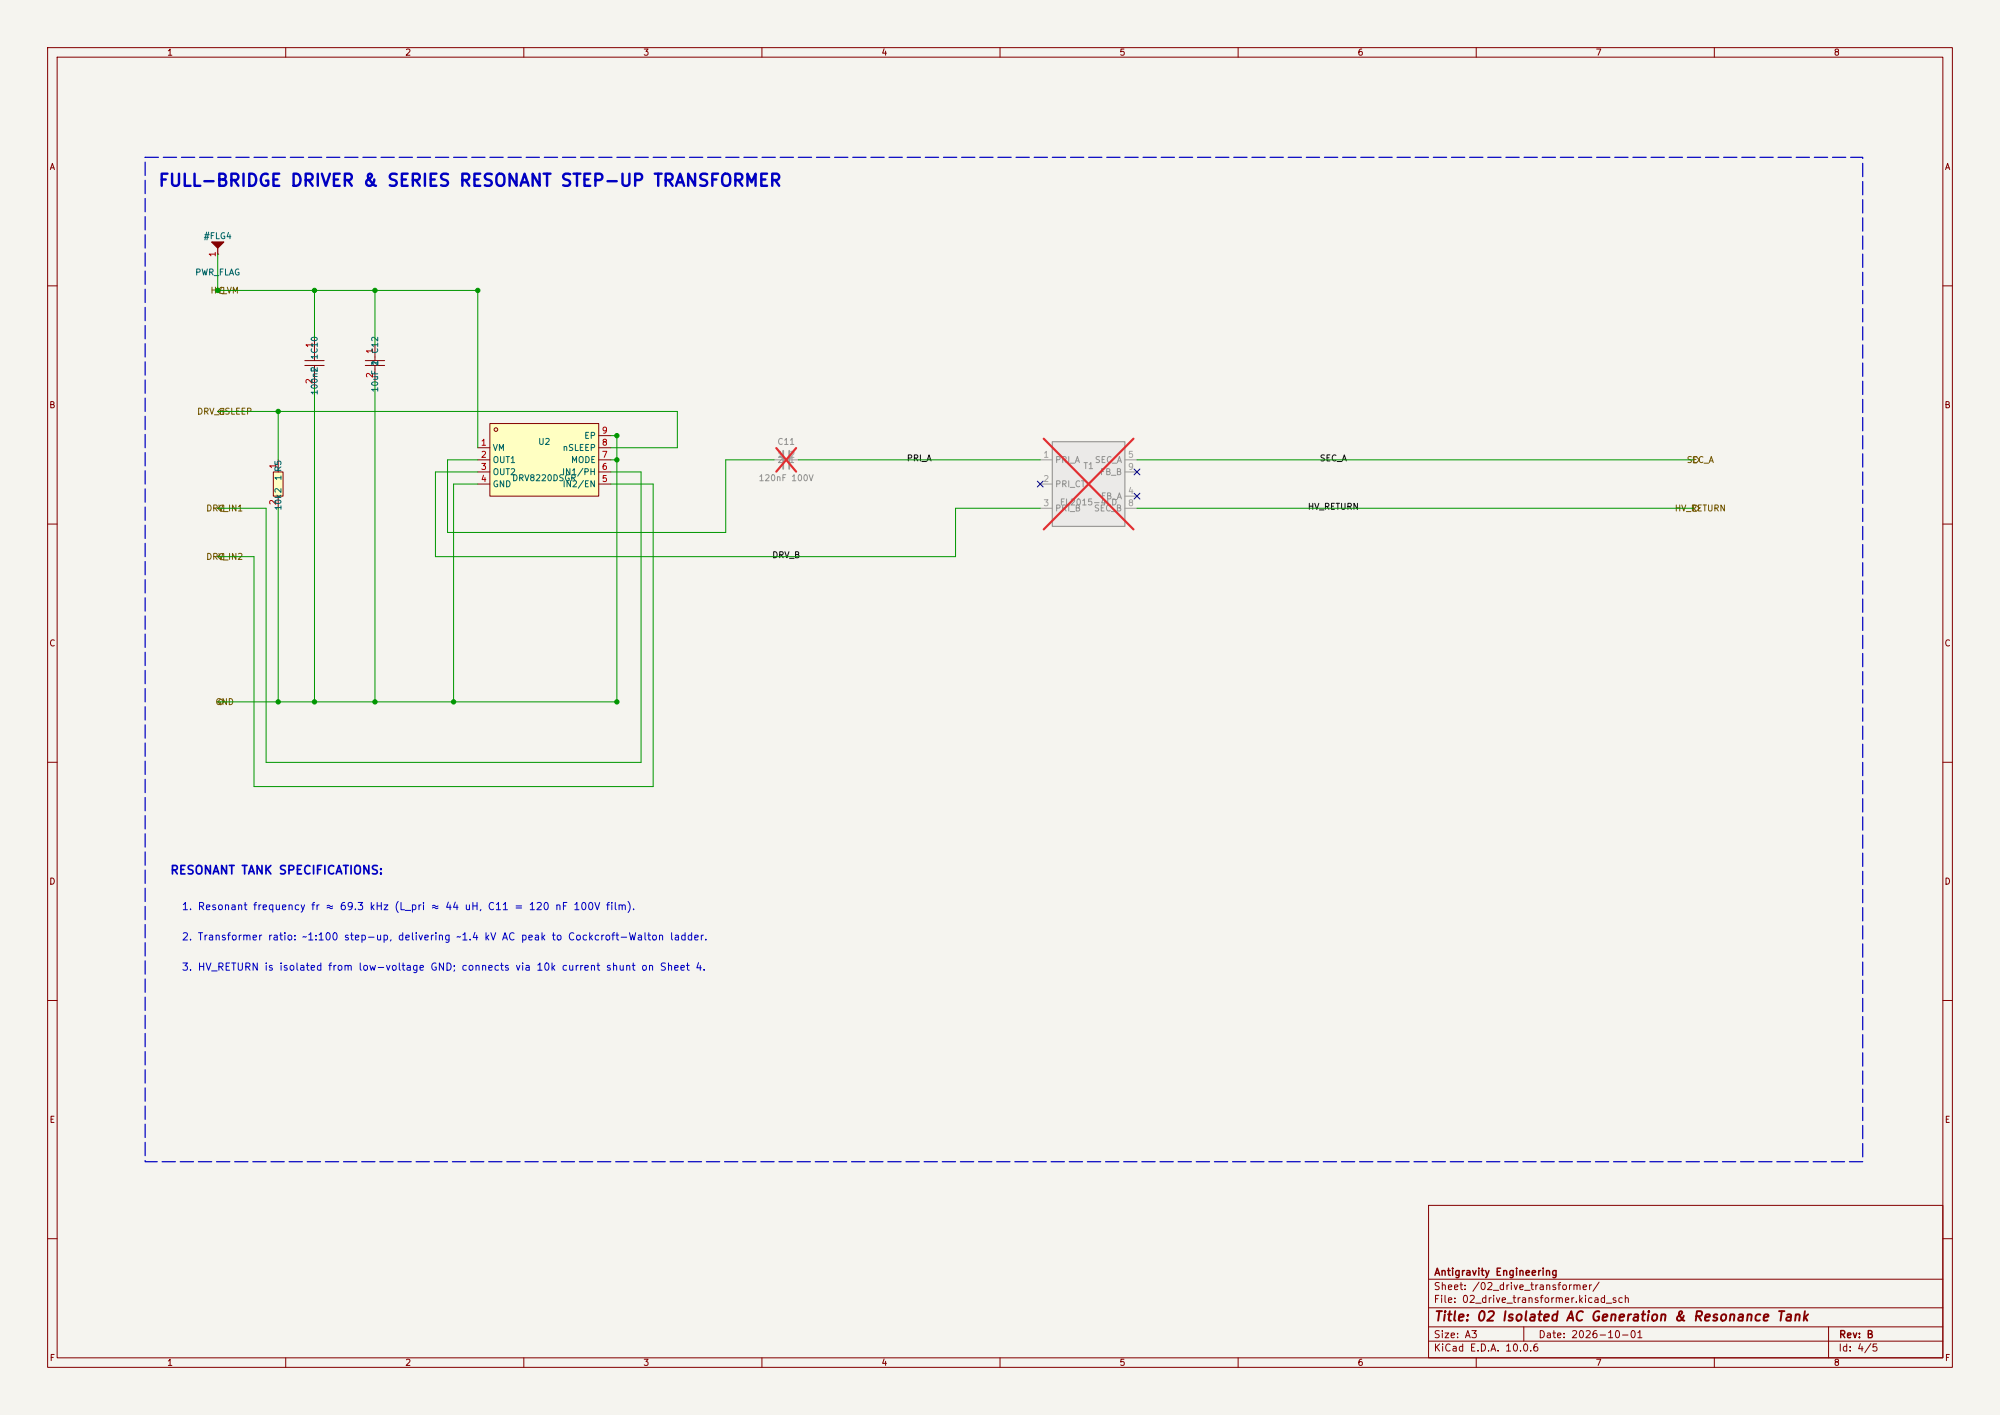
[picture p40: page 4]

FULL-BRIDGE DRIVER & SERIES RESONANT STEP-UP TRANSFORMER

SEC_A 1. Resonant frequency fr ≈ 69.3 kHz (L_pri ≈ 44 uH, C11 = 120 nF 100V film).

2. Transformer ratio: ~1:100 step-up, delivering ~1.4 kV AC peak to Cockcroft-Walton ladder.

3. HV_RETURN is isolated from low-voltage GND; connects via 10k current shunt on Sheet 4.

Antigravity Engineering
Sheet: /02_drive_transformer/
File: 02_drive_transformer.kicad_sch
Title: 02 Isolated AC Generation & Resonance Tank

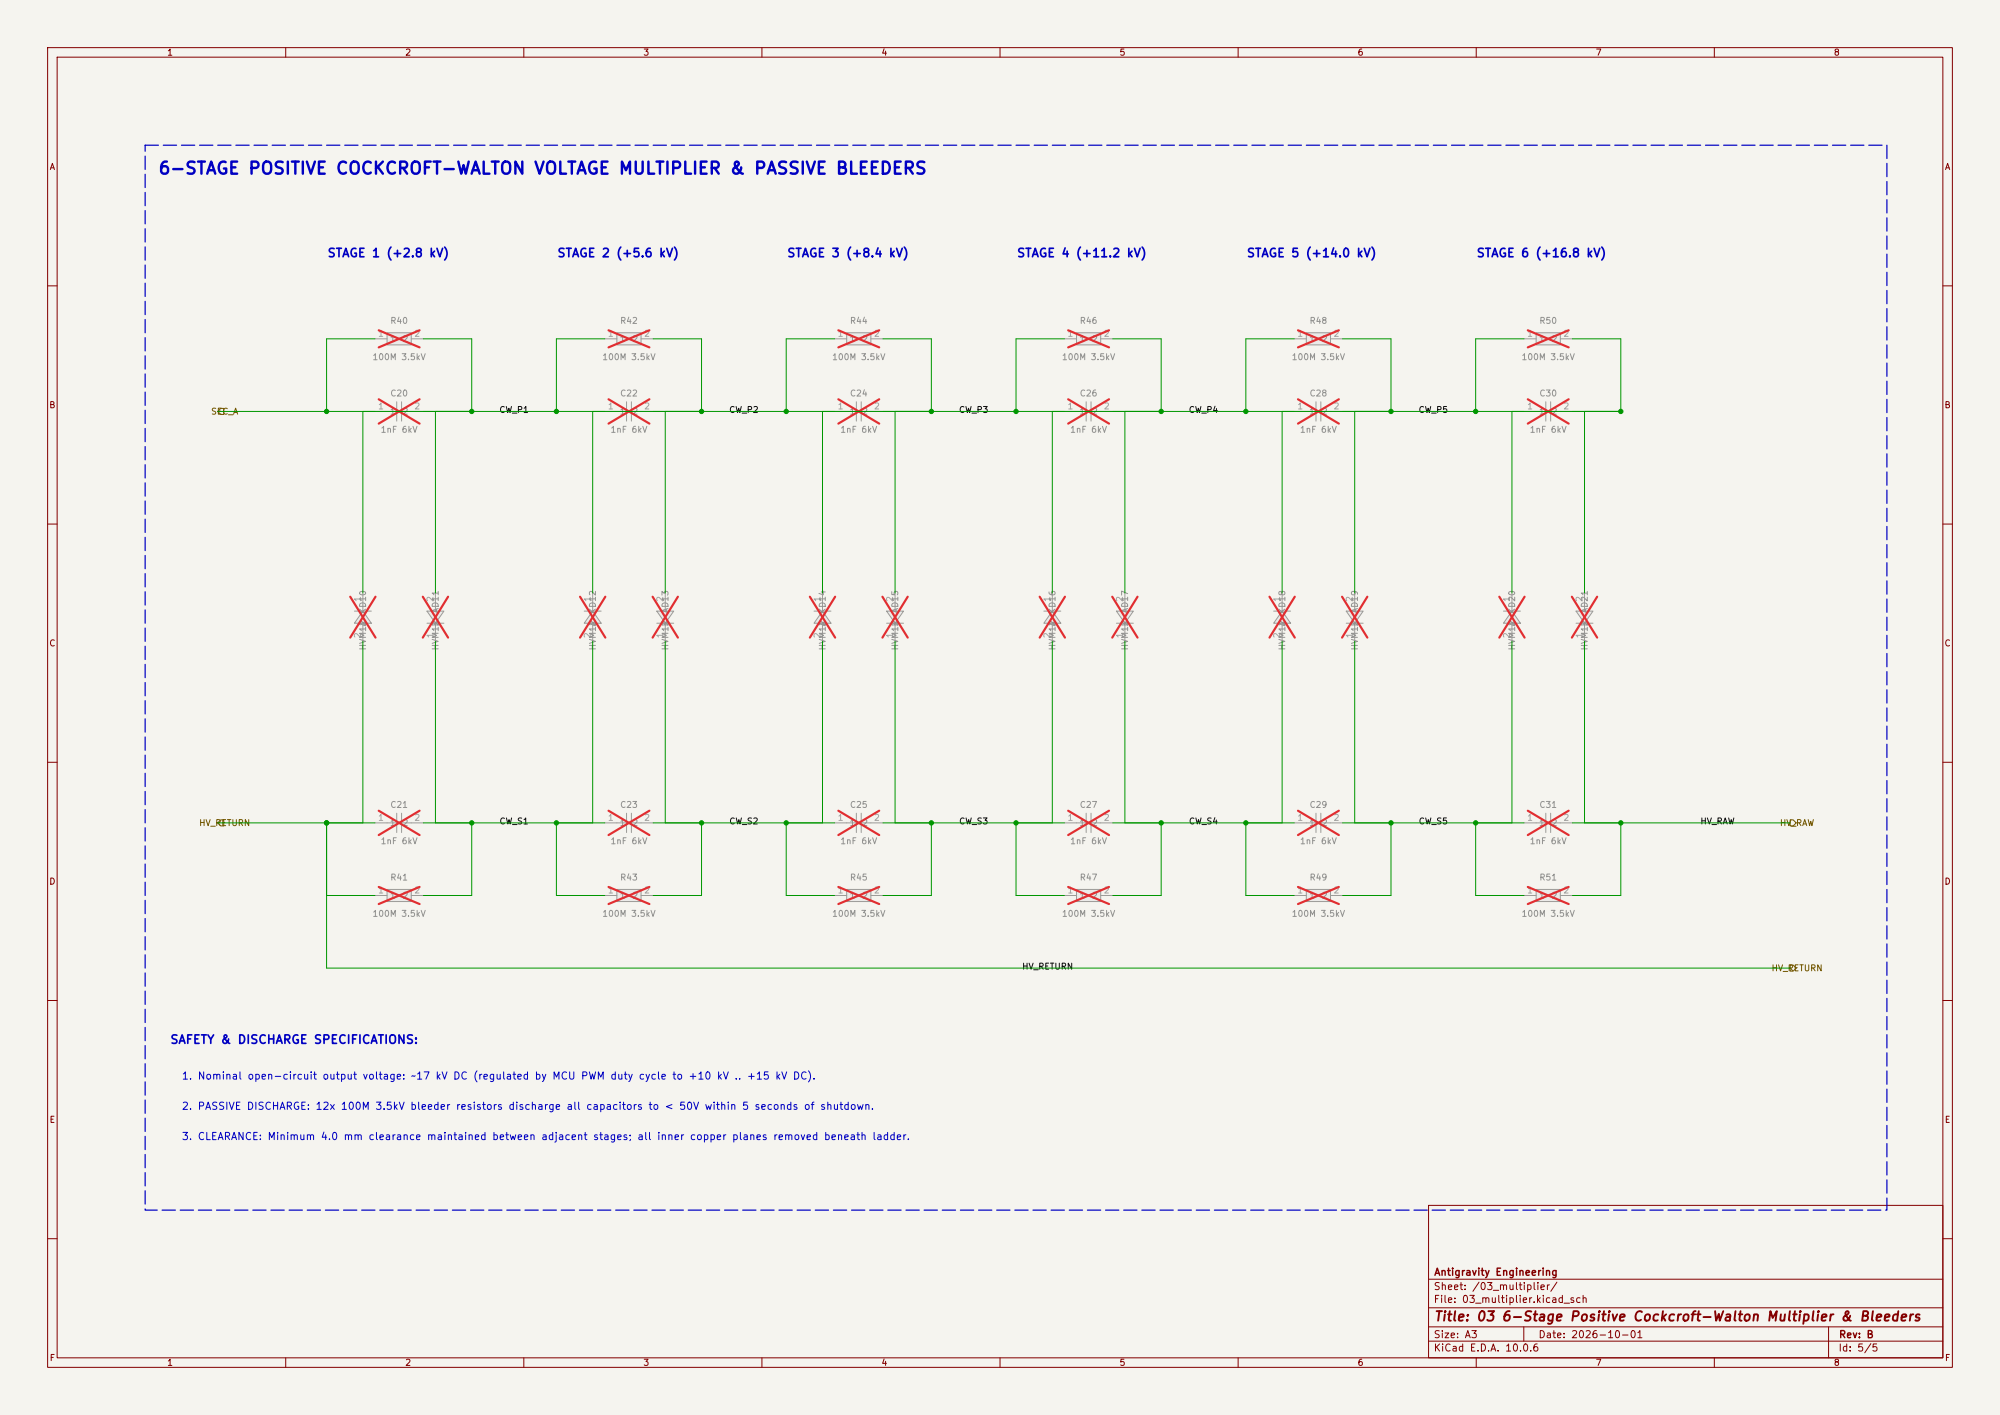
[picture p41: page 5]

6-STAGE POSITIVE COCKCROFT-WALTON VOLTAGE MULTIPLIER & PASSIVE BLEEDERS

1. Nominal open-circuit output voltage: ~17 kV DC (regulated by MCU PWM duty cycle to +10 kV .. +15 kV DC).

2. PASSIVE DISCHARGE: 12x 100M 3.5kV bleeder resistors discharge all capacitors to < 50V within 5 seconds of shutdown.

3. CLEARANCE: Minimum 4.0 mm clearance maintained between adjacent stages; all inner copper planes removed beneath ladder.

Antigravity Engineering
Sheet: /03_multiplier/
File: 03_multiplier.kicad_sch
Title: 03 6-Stage Positive Cockcroft-Walton Multiplier & Bleeders
