uge/ew-1/hardware/pi5_corona_hat_direct/exports/pi5_corona_hv_pcb.pdf

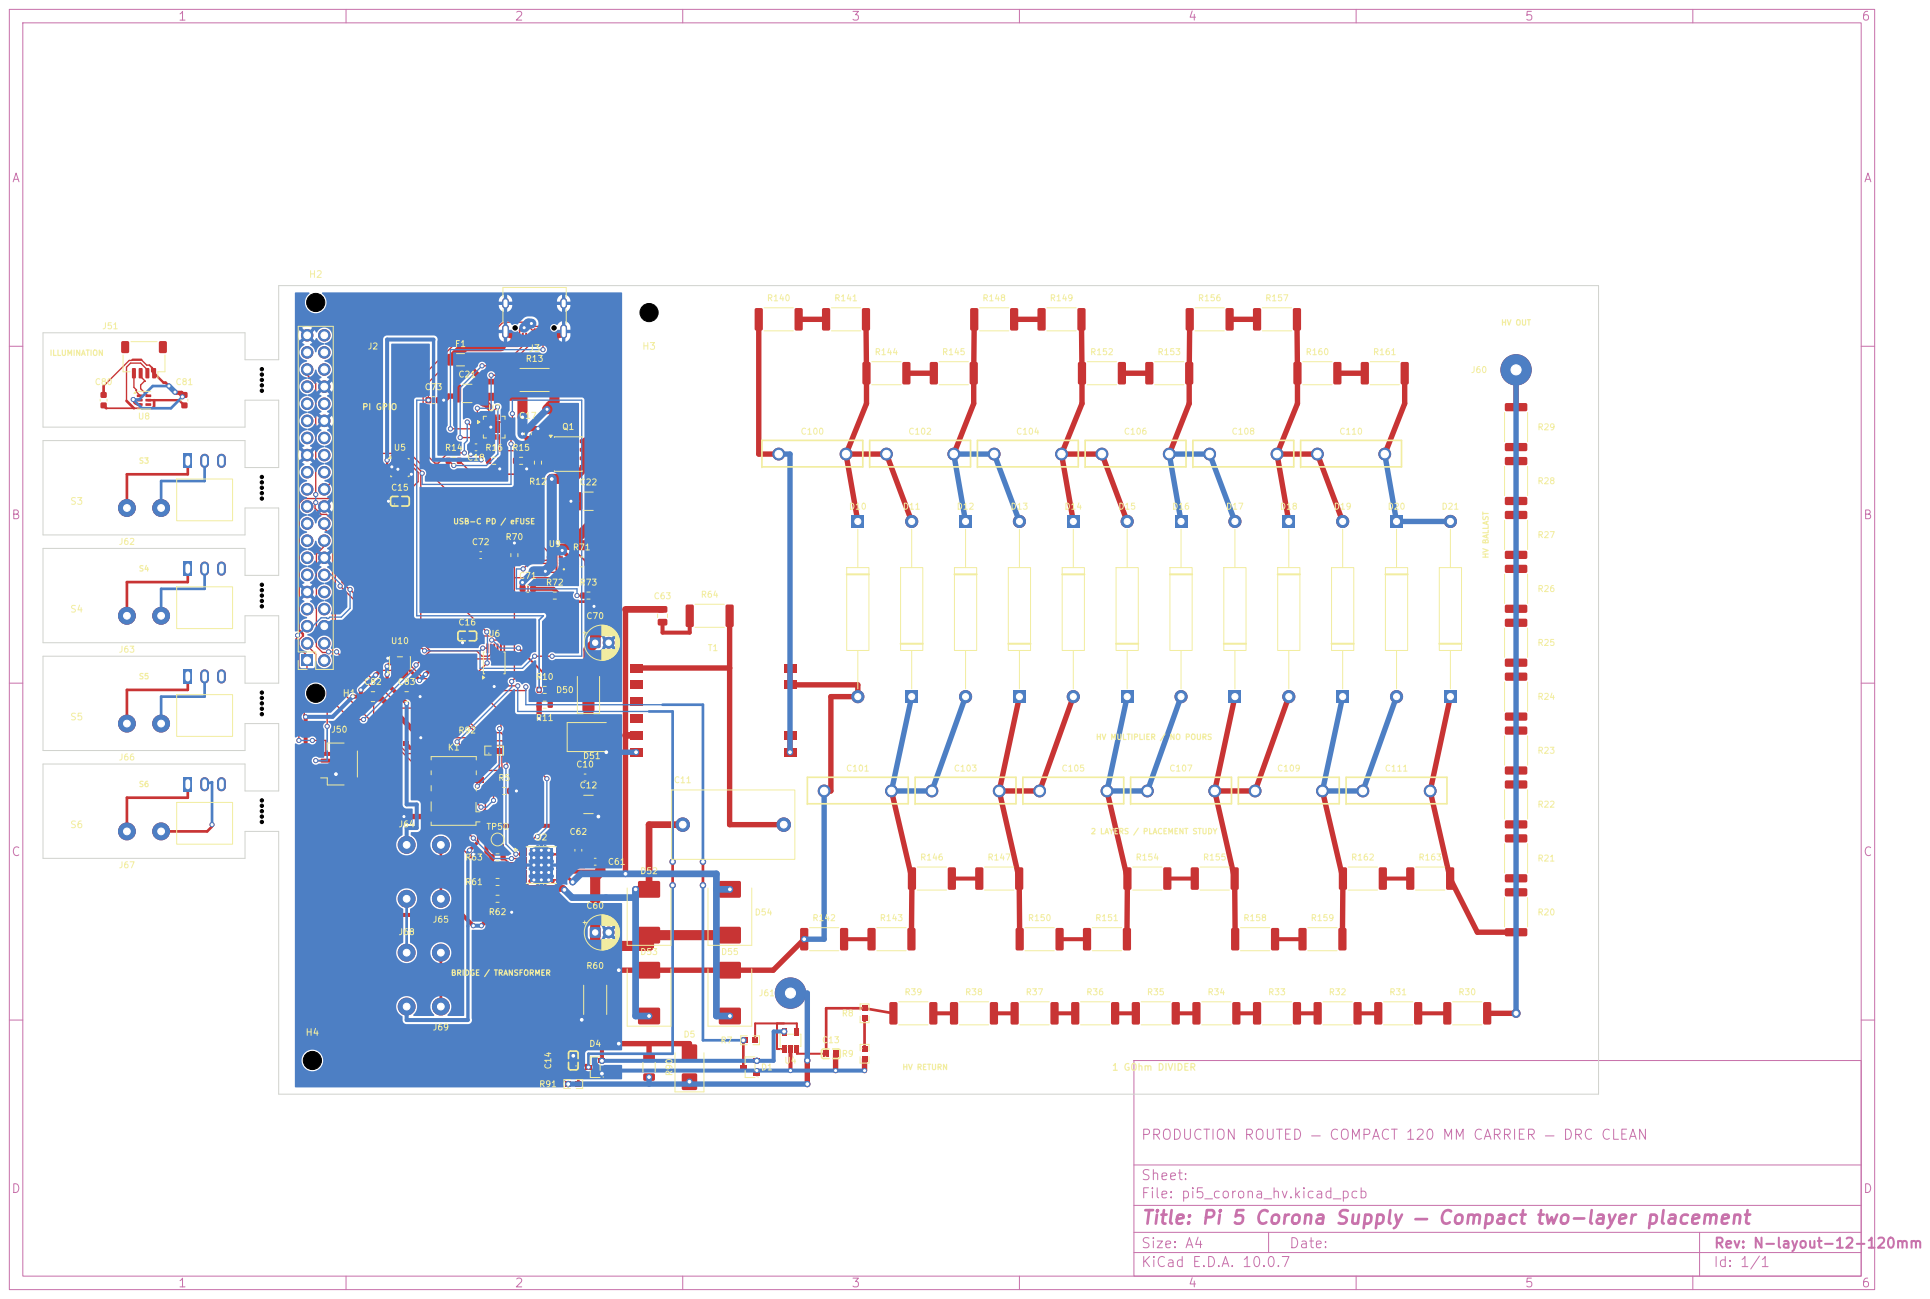
[picture p42: page 1]

HV OUT HV BALLAST

HV MULTIPLIER / NO POURS

PRODUCTION ROUTED — COMPACT 120 MM CARRIER — DRC CLEAN

Sheet:
File: pi5_corona_hv.kicad_pcb
Title: Pi 5 Corona Supply — Compact two-layer placement
KiCad E.D.A. 10.0.7
