uge/ew-1/hardware/pi5_corona_hat_direct/exports/pi5_corona_hv_sch.pdf

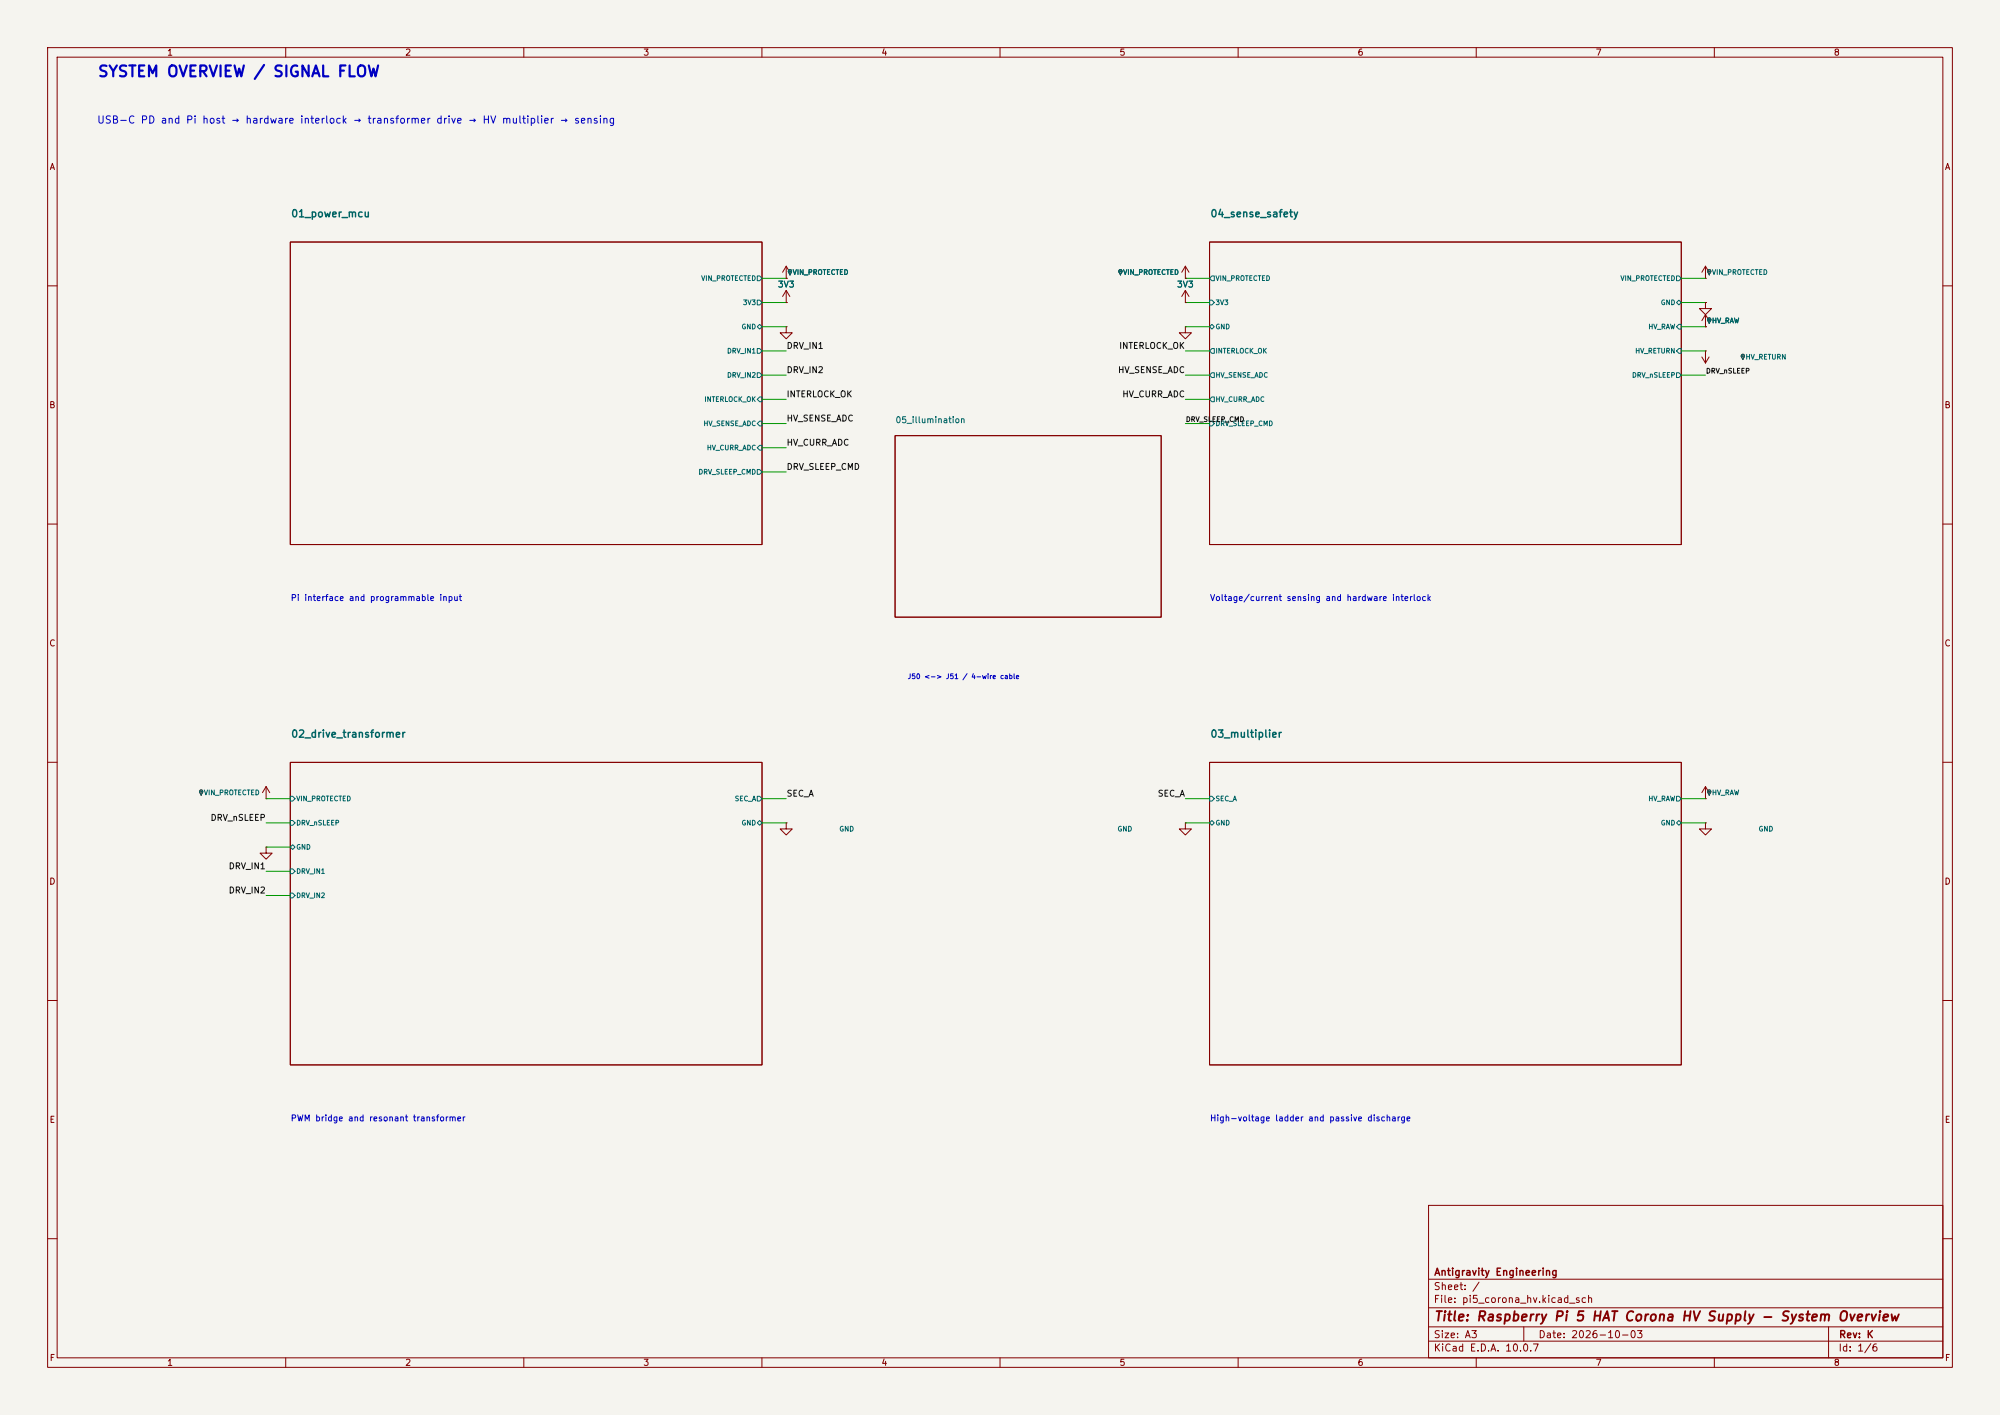
[picture p43: page 1]

Voltage/current sensing and hardware interlock SYSTEM OVERVIEW / SIGNAL FLOW

USB-C PD and Pi host → hardware interlock → transformer drive → HV multiplier → sensing

Pi interface and programmable input

PWM bridge and resonant transformer

Antigravity Engineering
Sheet: /
File: pi5_corona_hv.kicad_sch
Title: Raspberry Pi 5 HAT Corona HV Supply - System Overview

Size: A3 | Rev: K | F Date: 2026-10-03
KiCad E.D.A. 10.0.7 | Id: 1/6

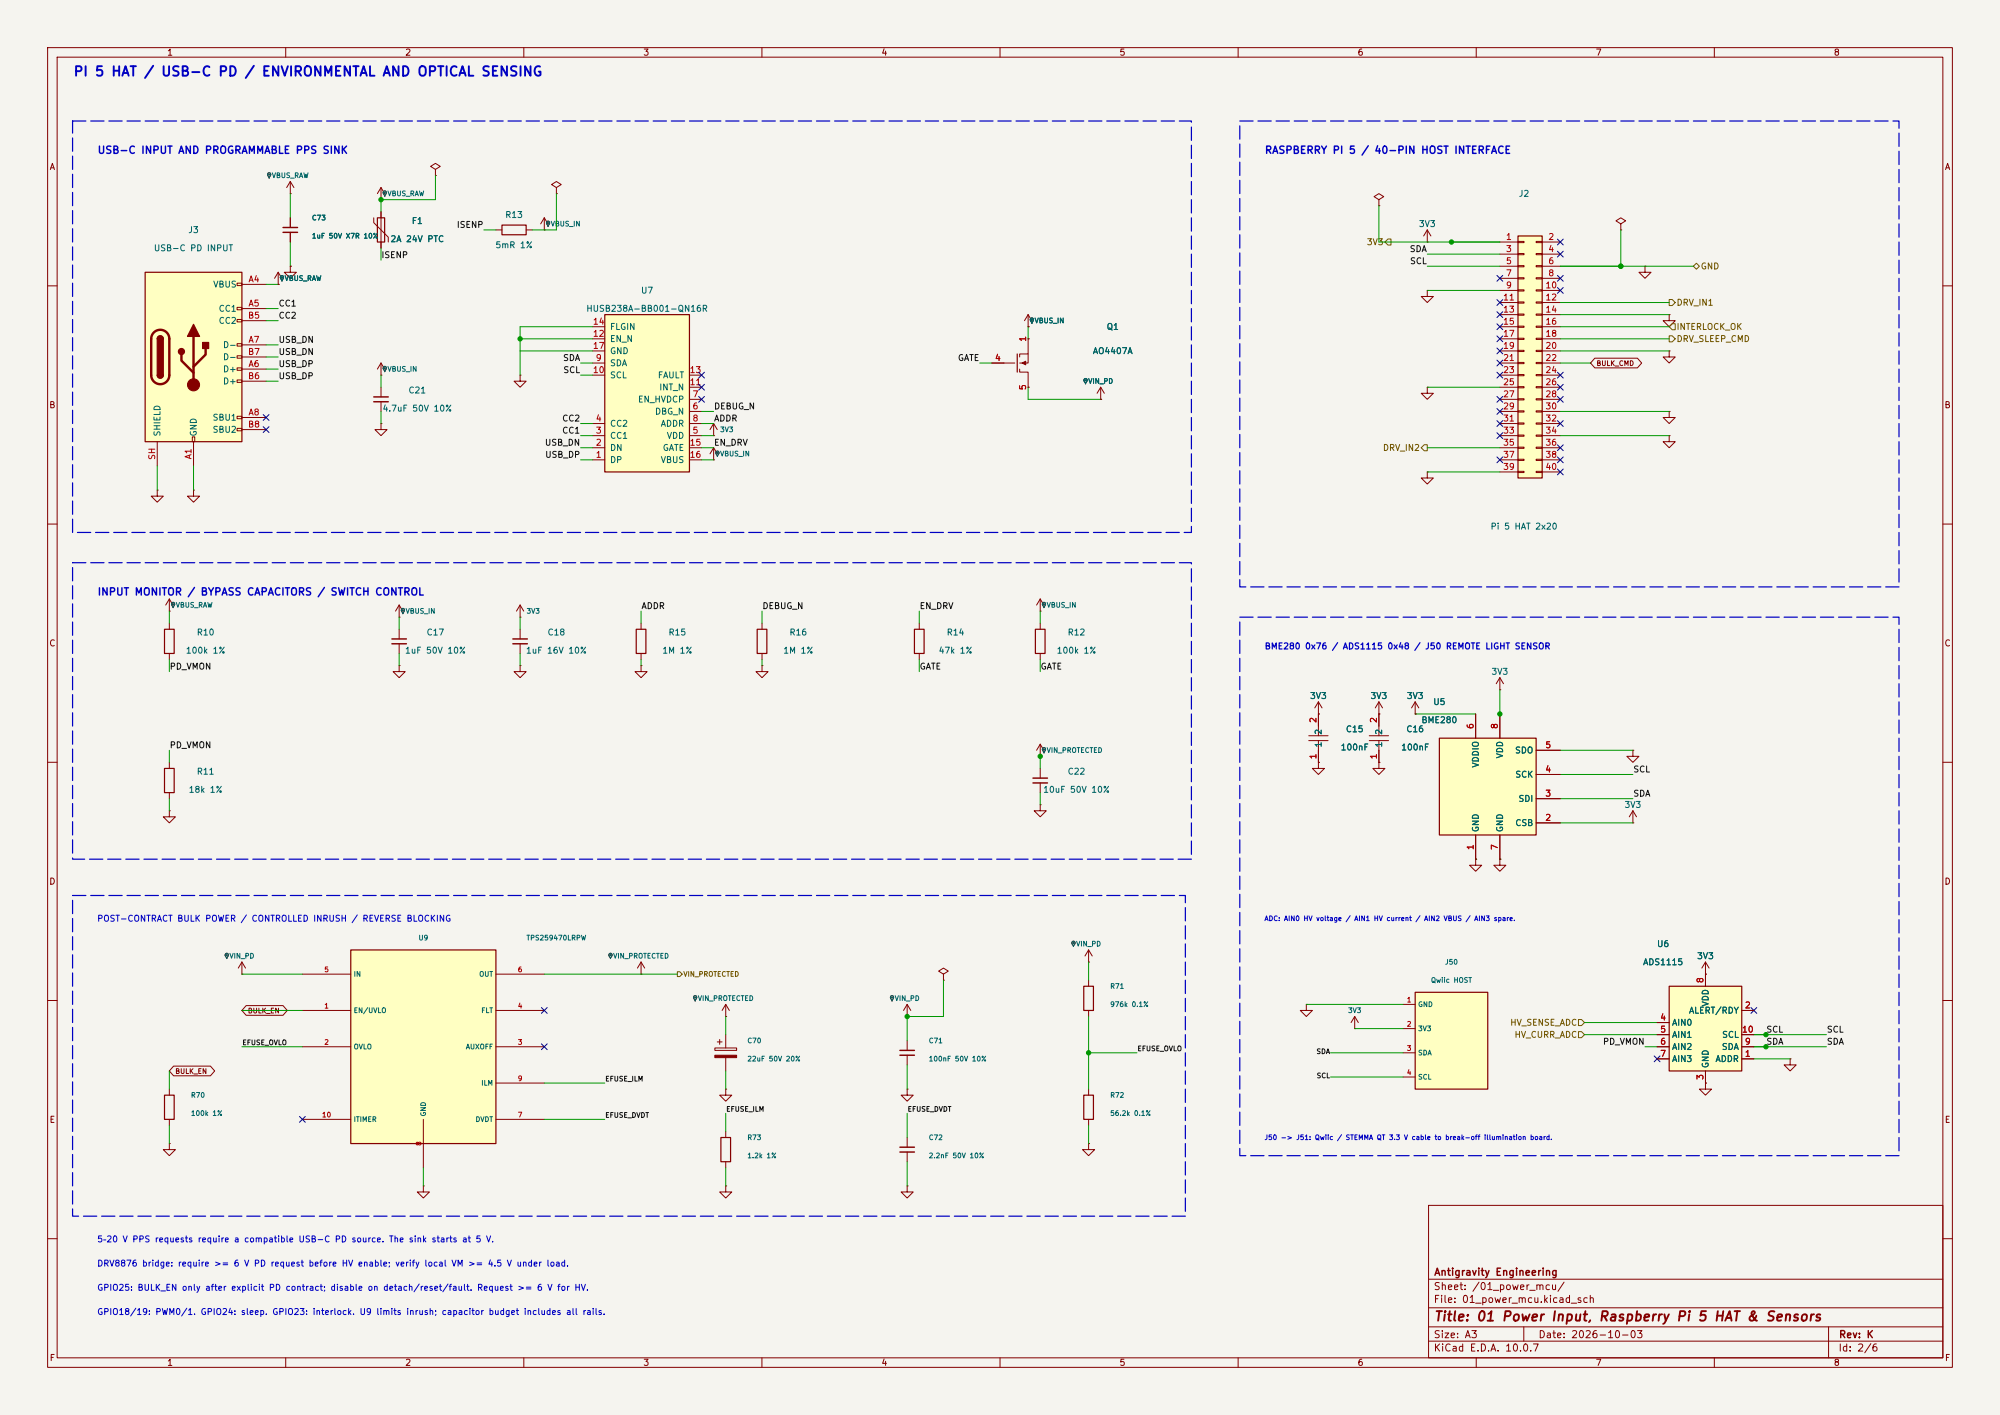
[picture p44: page 2]

PI 5 HAT / USB-C PD / ENVIRONMENTAL AND OPTICAL SENSING

USB-C INPUT AND PROGRAMMABLE PPS SINK

BME280 0x76 / ADS1115 0x48 / J50 REMOTE LIGHT SENSOR RASPBERRY PI 5 / 40-PIN HOST INTERFACE

SBU2 | B8 SHIELD SH

INPUT MONITOR / BYPASS CAPACITORS / SWITCH CONTROL

5–20 V PPS requests require a compatible USB-C PD source. The sink starts at 5 V. GPIO18/19: PWM0/1. GPIO24: sleep. GPIO23: interlock. U9 limits inrush; capacitor budget includes all rails. GPIO25: BULK_EN only after explicit PD contract; disable on detach/reset/fault. Request >= 6 V for HV. POST-CONTRACT BULK POWER / CONTROLLED INRUSH / REVERSE BLOCKING

ADC: AIN0 HV voltage / AIN1 HV current / AIN2 VBUS / AIN3 spare.

J50 -> J51: Qwiic / STEMMA QT 3.3 V cable to break-off illumination board.

DRV8876 bridge: require >= 6 V PD request before HV enable; verify local VM >= 4.5 V under load.

Antigravity Engineering
Sheet: /01_power_mcu/
File: 01_power_mcu.kicad_sch
Title: 01 Power Input, Raspberry Pi 5 HAT & Sensors

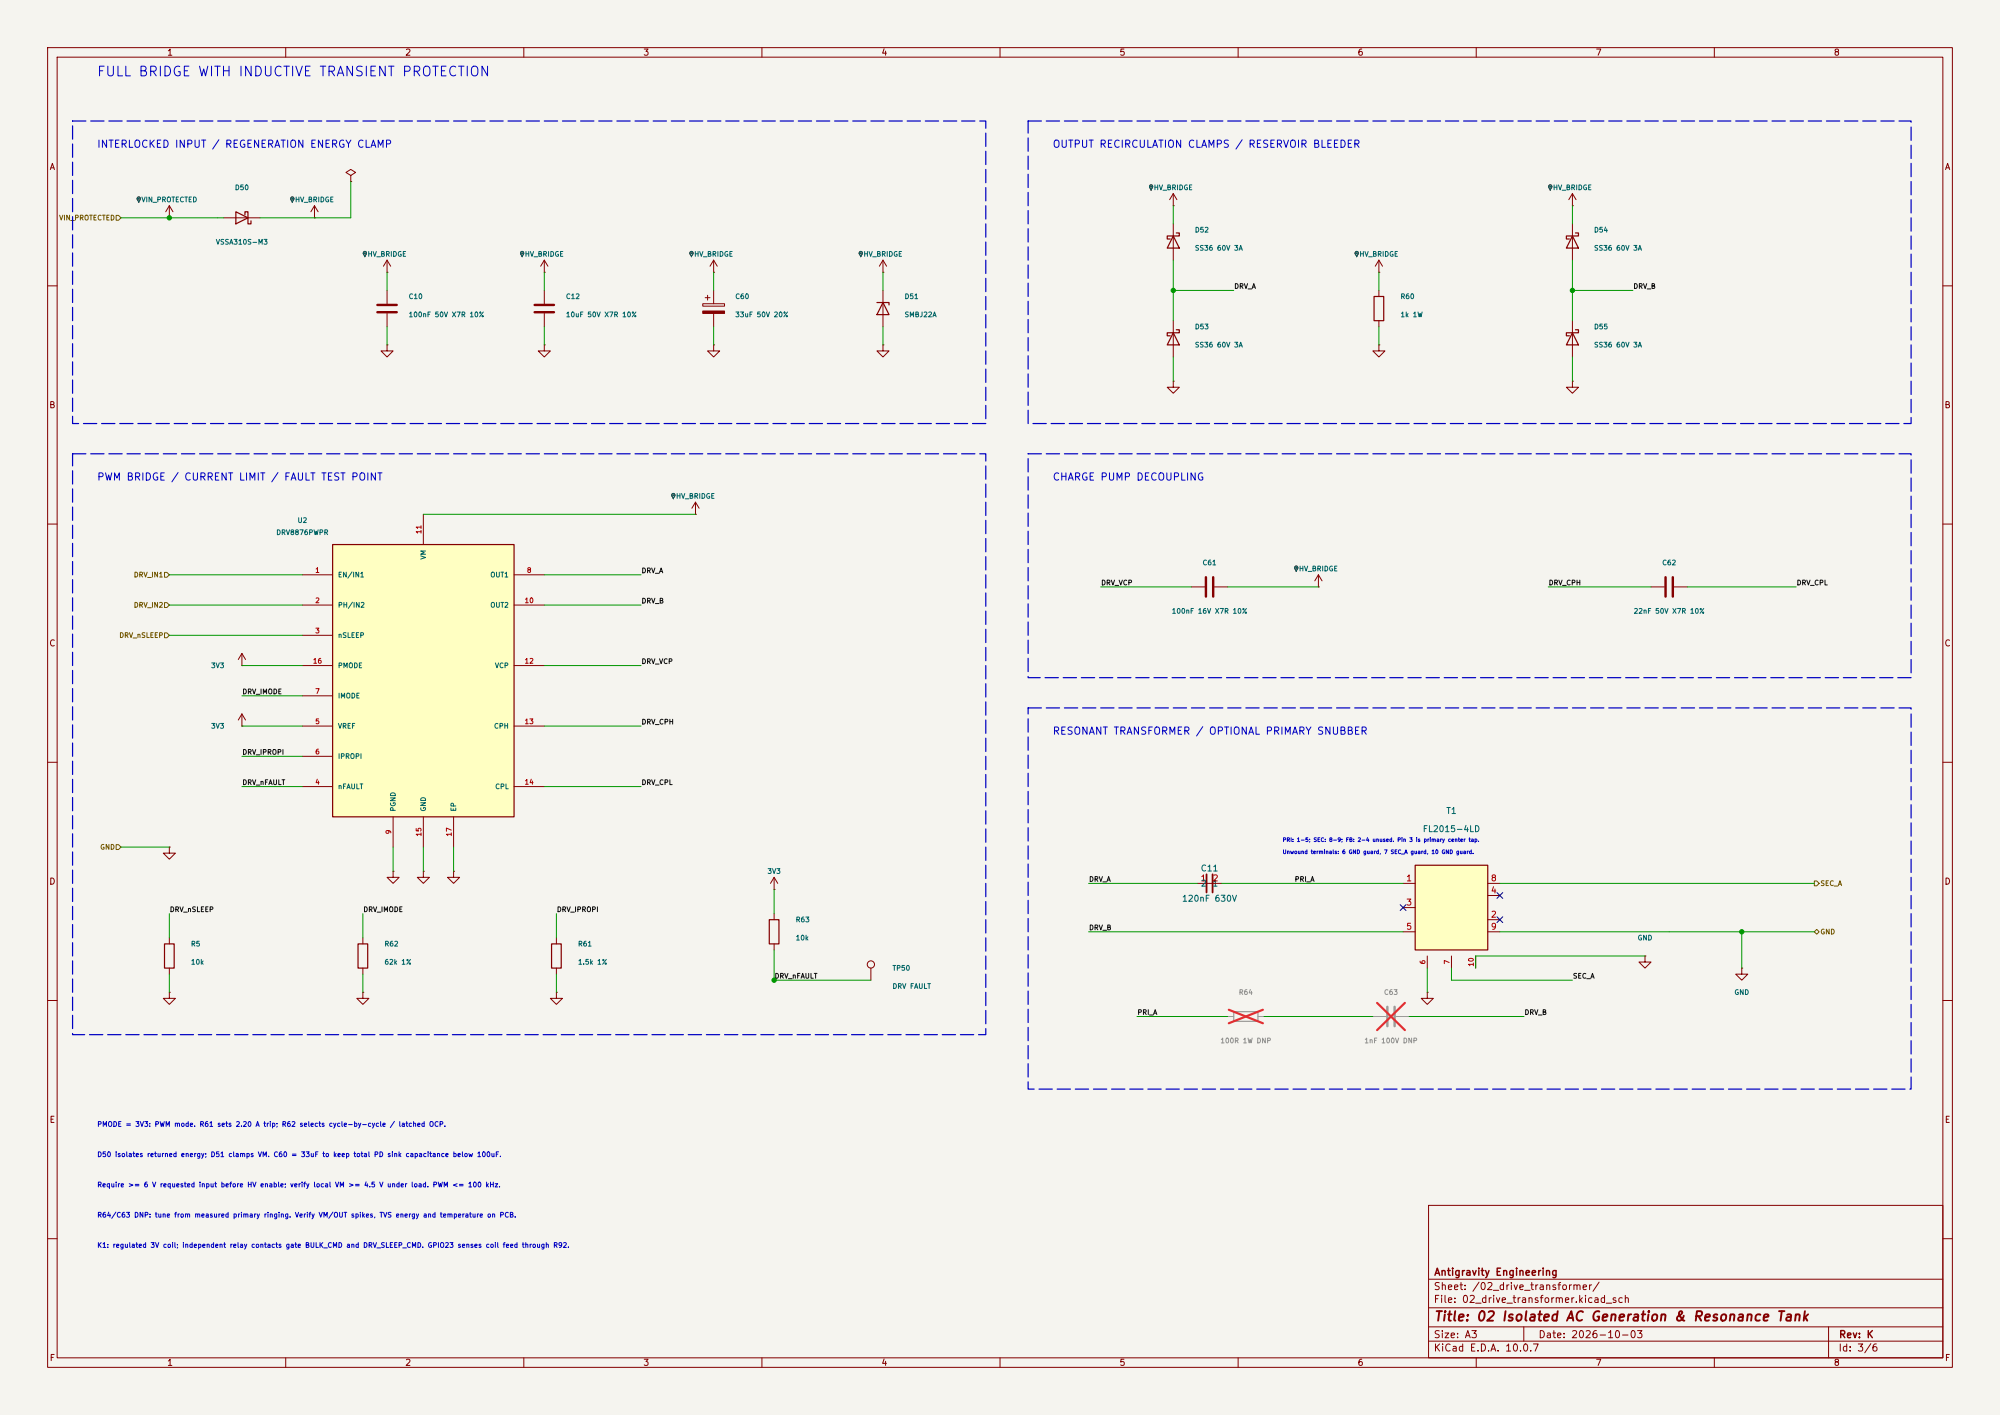
[picture p45: page 3]

FULL BRIDGE WITH INDUCTIVE TRANSIENT PROTECTION

RESONANT TRANSFORMER / OPTIONAL PRIMARY SNUBBER

Unwound terminals: 6 GND guard, 7 SEC_A guard, 10 GND guard. PRI: 1-5; SEC: 8-9; FB: 2-4 unused. Pin 3 is primary center tap. R64/C63 DNP: tune from measured primary ringing. Verify VM/OUT spikes, TVS energy and temperature on PCB. PMODE = 3V3: PWM mode. R61 sets 2.20 A trip; R62 selects cycle-by-cycle / latched OCP. K1: regulated 3V coil; independent relay contacts gate BULK_CMD and DRV_SLEEP_CMD. GPIO23 senses coil feed through R92. D50 isolates returned energy; D51 clamps VM. C60 = 33uF to keep total PD sink capacitance below 100uF. Require >= 6 V requested input before HV enable; verify local VM >= 4.5 V under load. PWM <= 100 kHz.
GND

Antigravity Engineering
Sheet: /02_drive_transformer/
File: 02_drive_transformer.kicad_sch
Title: 02 Isolated AC Generation & Resonance Tank

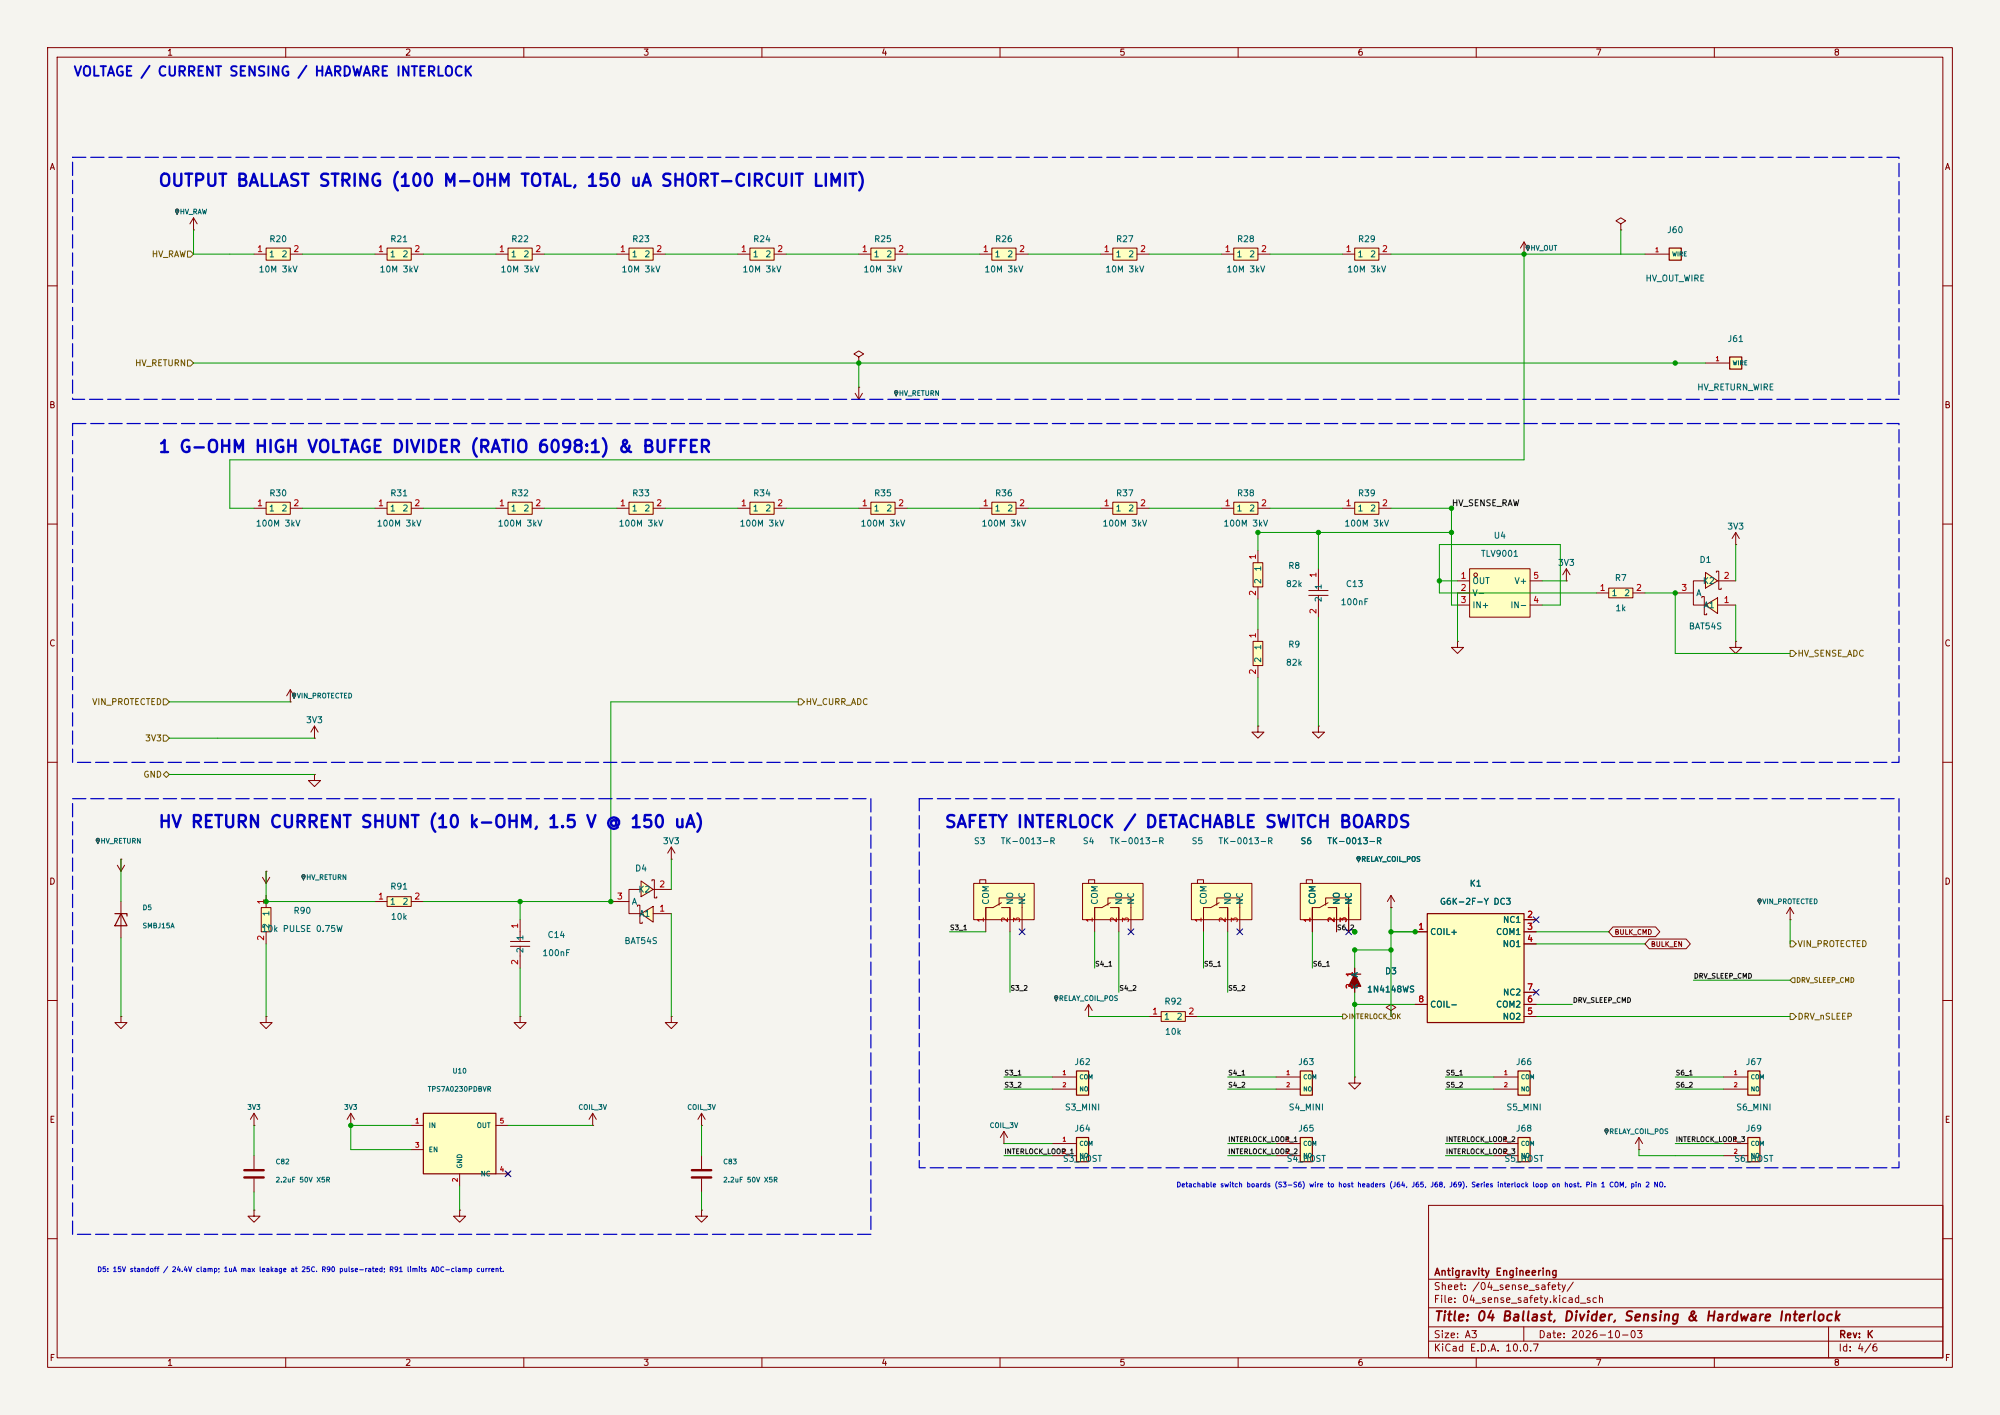
[picture p46: page 4]

VOLTAGE / CURRENT SENSING / HARDWARE INTERLOCK

OUTPUT BALLAST STRING (100 M-OHM TOTAL, 150 uA SHORT-CIRCUIT LIMIT)

1 G-OHM HIGH VOLTAGE DIVIDER (RATIO 6098:1) & BUFFER

HV RETURN CURRENT SHUNT (10 k-OHM, 1.5 V @ 150 uA)

Detachable switch boards (S3-S6) wire to host headers (J64, J65, J68, J69). Series interlock loop on host. Pin 1 COM, pin 2 NO.

Antigravity Engineering
Sheet: /04_sense_safety/
File: 04_sense_safety.kicad_sch
Title: 04 Ballast, Divider, Sensing & Hardware Interlock

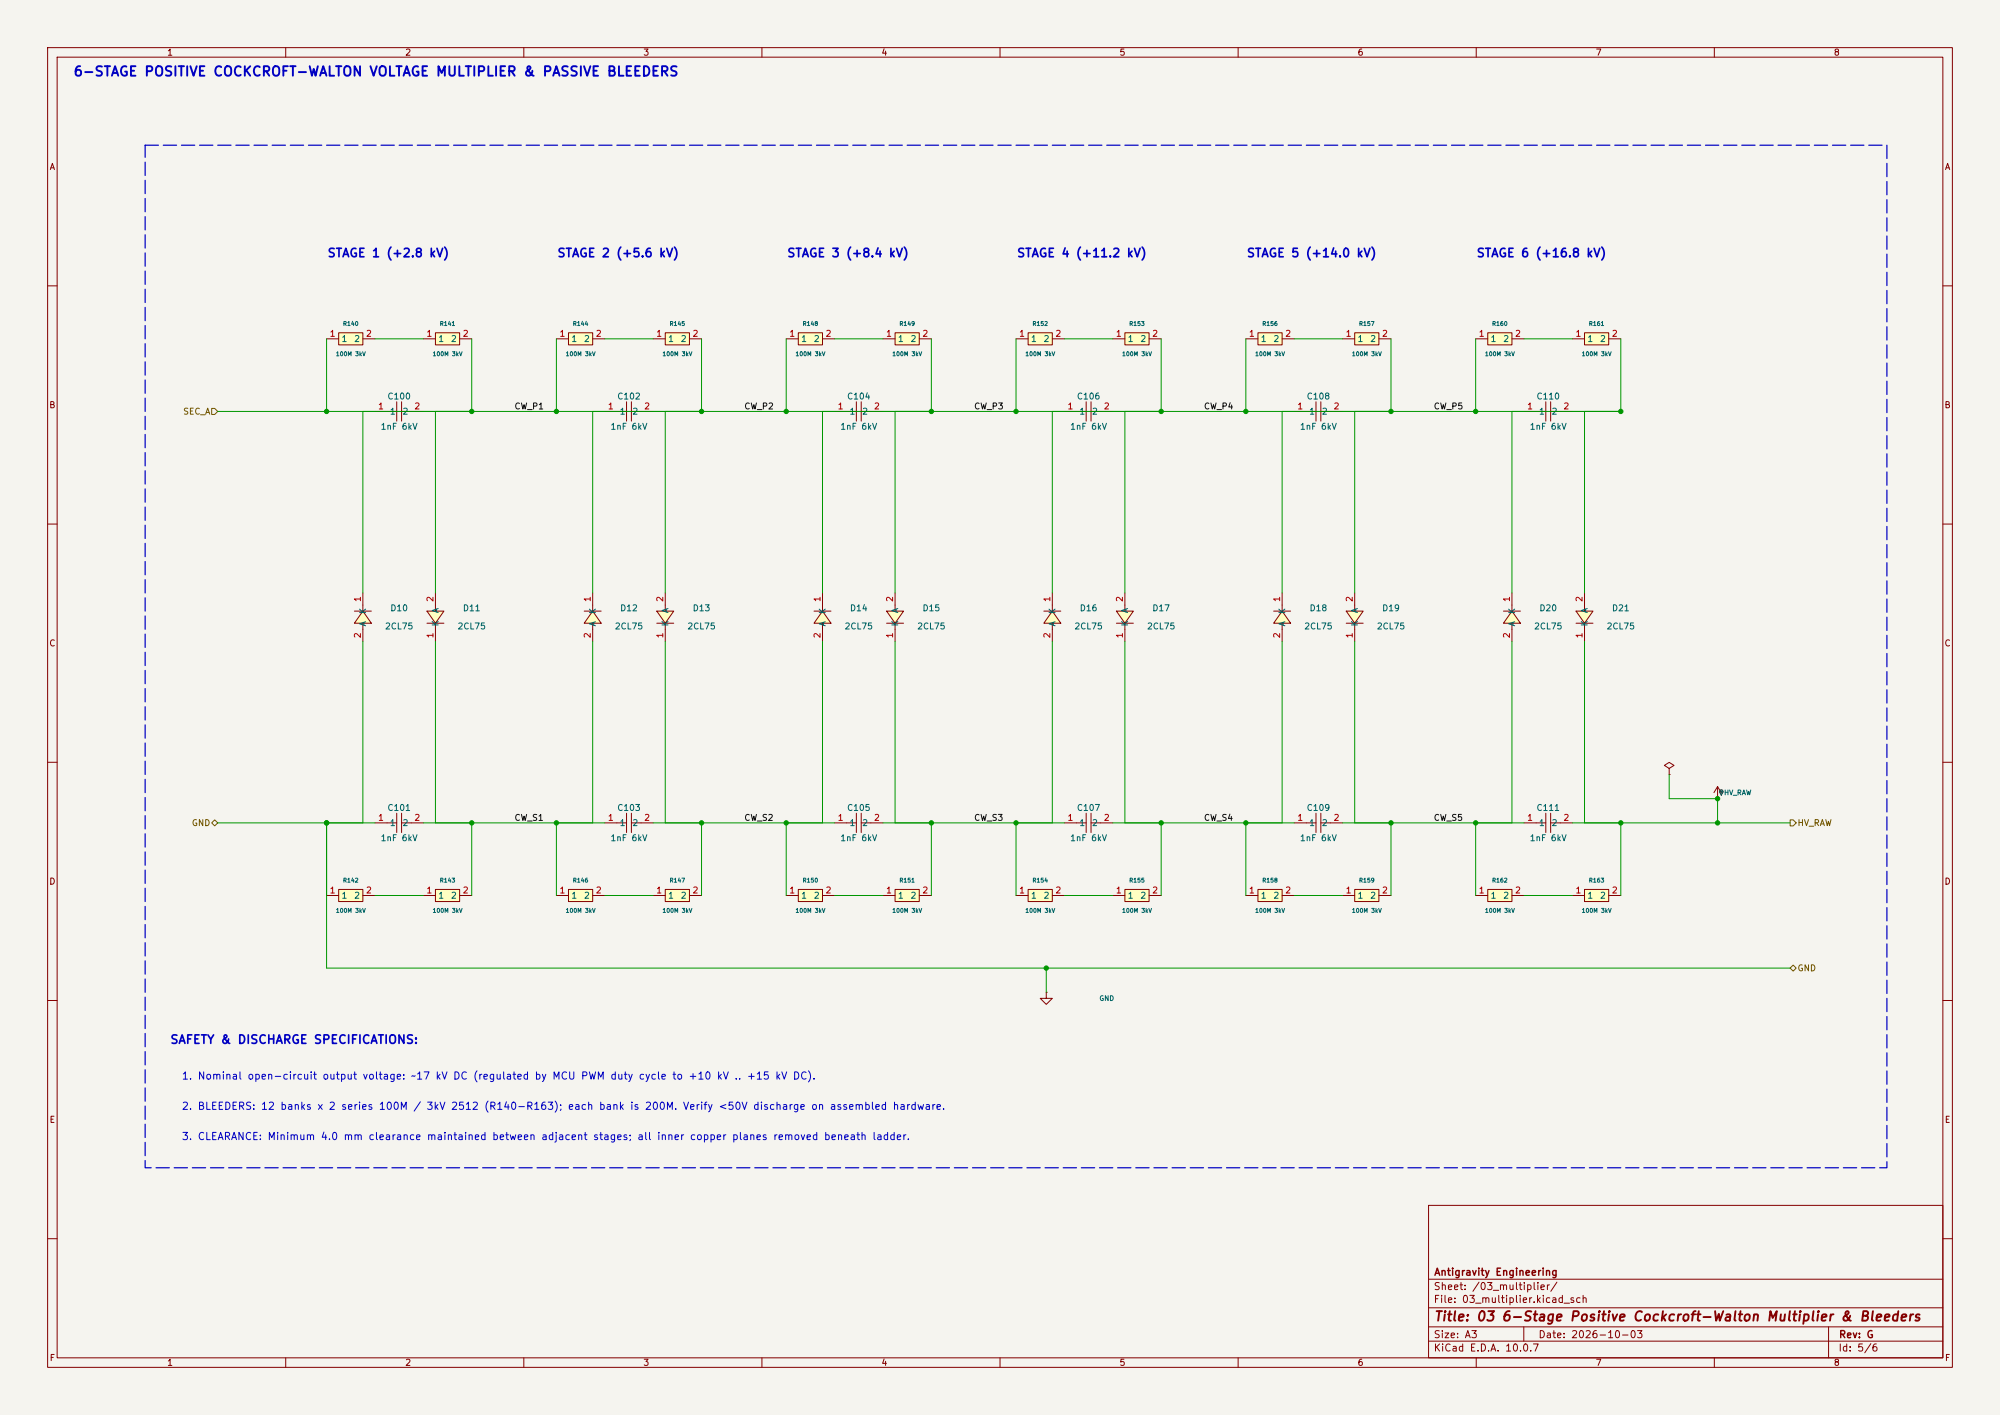
[picture p47: page 5]

6-STAGE POSITIVE COCKCROFT-WALTON VOLTAGE MULTIPLIER & PASSIVE BLEEDERS

2. BLEEDERS: 12 banks x 2 series 100M / 3kV 2512 (R140-R163); each bank is 200M. Verify <50V discharge on assembled hardware.

3. CLEARANCE: Minimum 4.0 mm clearance maintained between adjacent stages; all inner copper planes removed beneath ladder.

Antigravity Engineering
Sheet: /03_multiplier/
File: 03_multiplier.kicad_sch
Title: 03 6-Stage Positive Cockcroft-Walton Multiplier & Bleeders

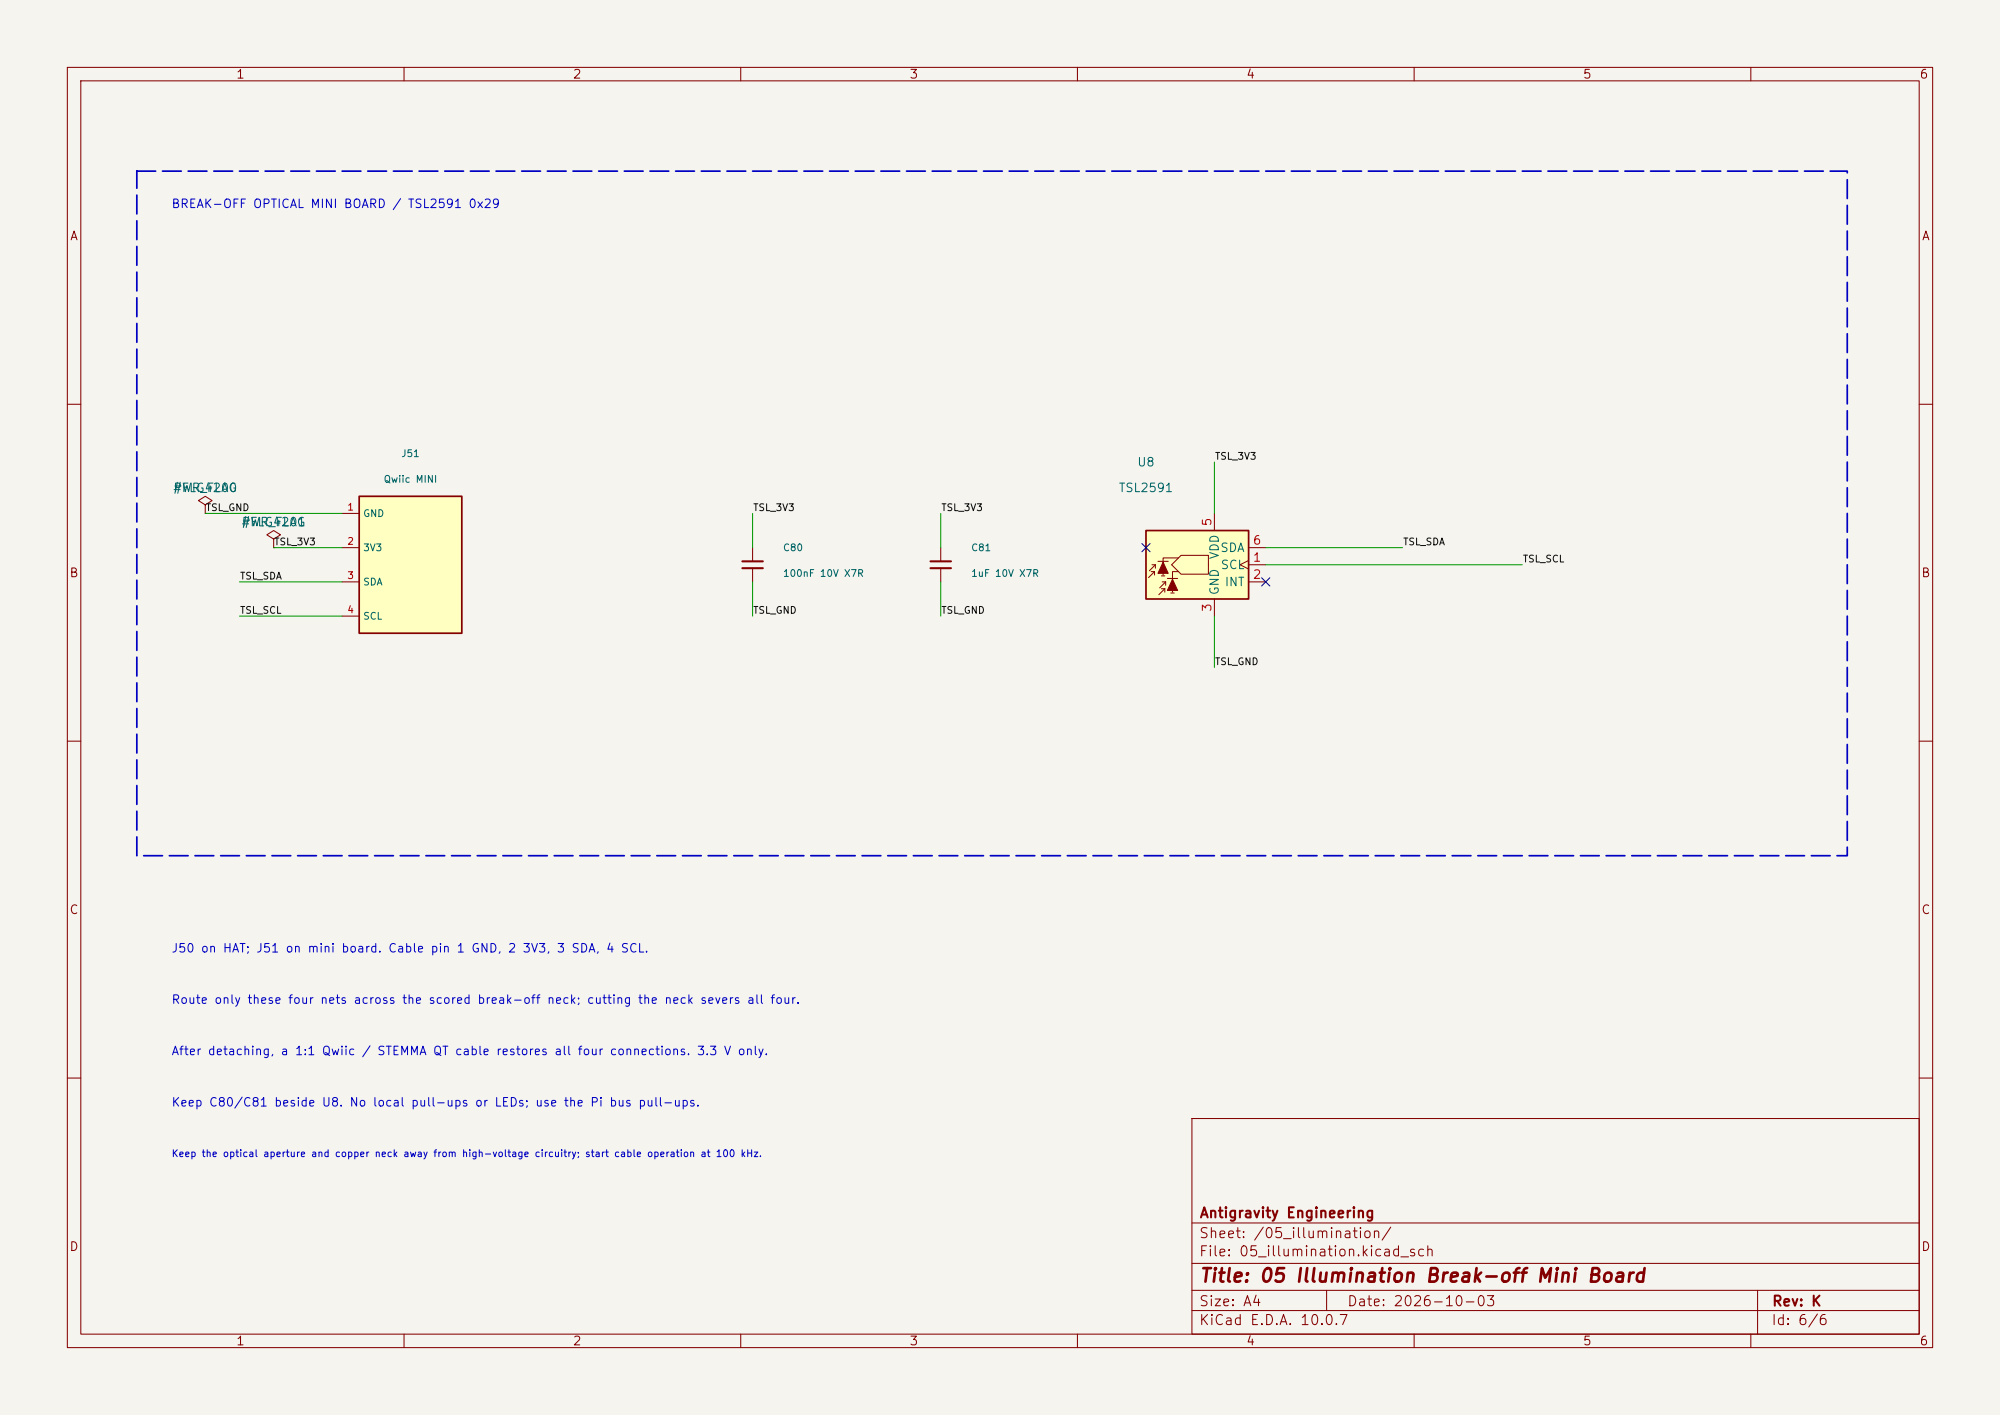
[picture p48: page 6]

TSL_SDA BREAK-OFF OPTICAL MINI BOARD / TSL2591 0x29 Route only these four nets across the scored break-off neck; cutting the neck severs all four. After detaching, a 1:1 Qwiic / STEMMA QT cable restores all four connections. 3.3 V only. Keep the optical aperture and copper neck away from high-voltage circuitry; start cable operation at 100 kHz. Keep C80/C81 beside U8. No local pull-ups or LEDs; use the Pi bus pull-ups. J50 on HAT; J51 on mini board. Cable pin 1 GND, 2 3V3, 3 SDA, 4 SCL.

Antigravity Engineering
Sheet: /05_illumination/
File: 05_illumination.kicad_sch
Title: 05 Illumination Break-off Mini Board
