uge/ew-1/hardware/pi5_corona_hat_direct/exports/pi5_corona_hv.pdf

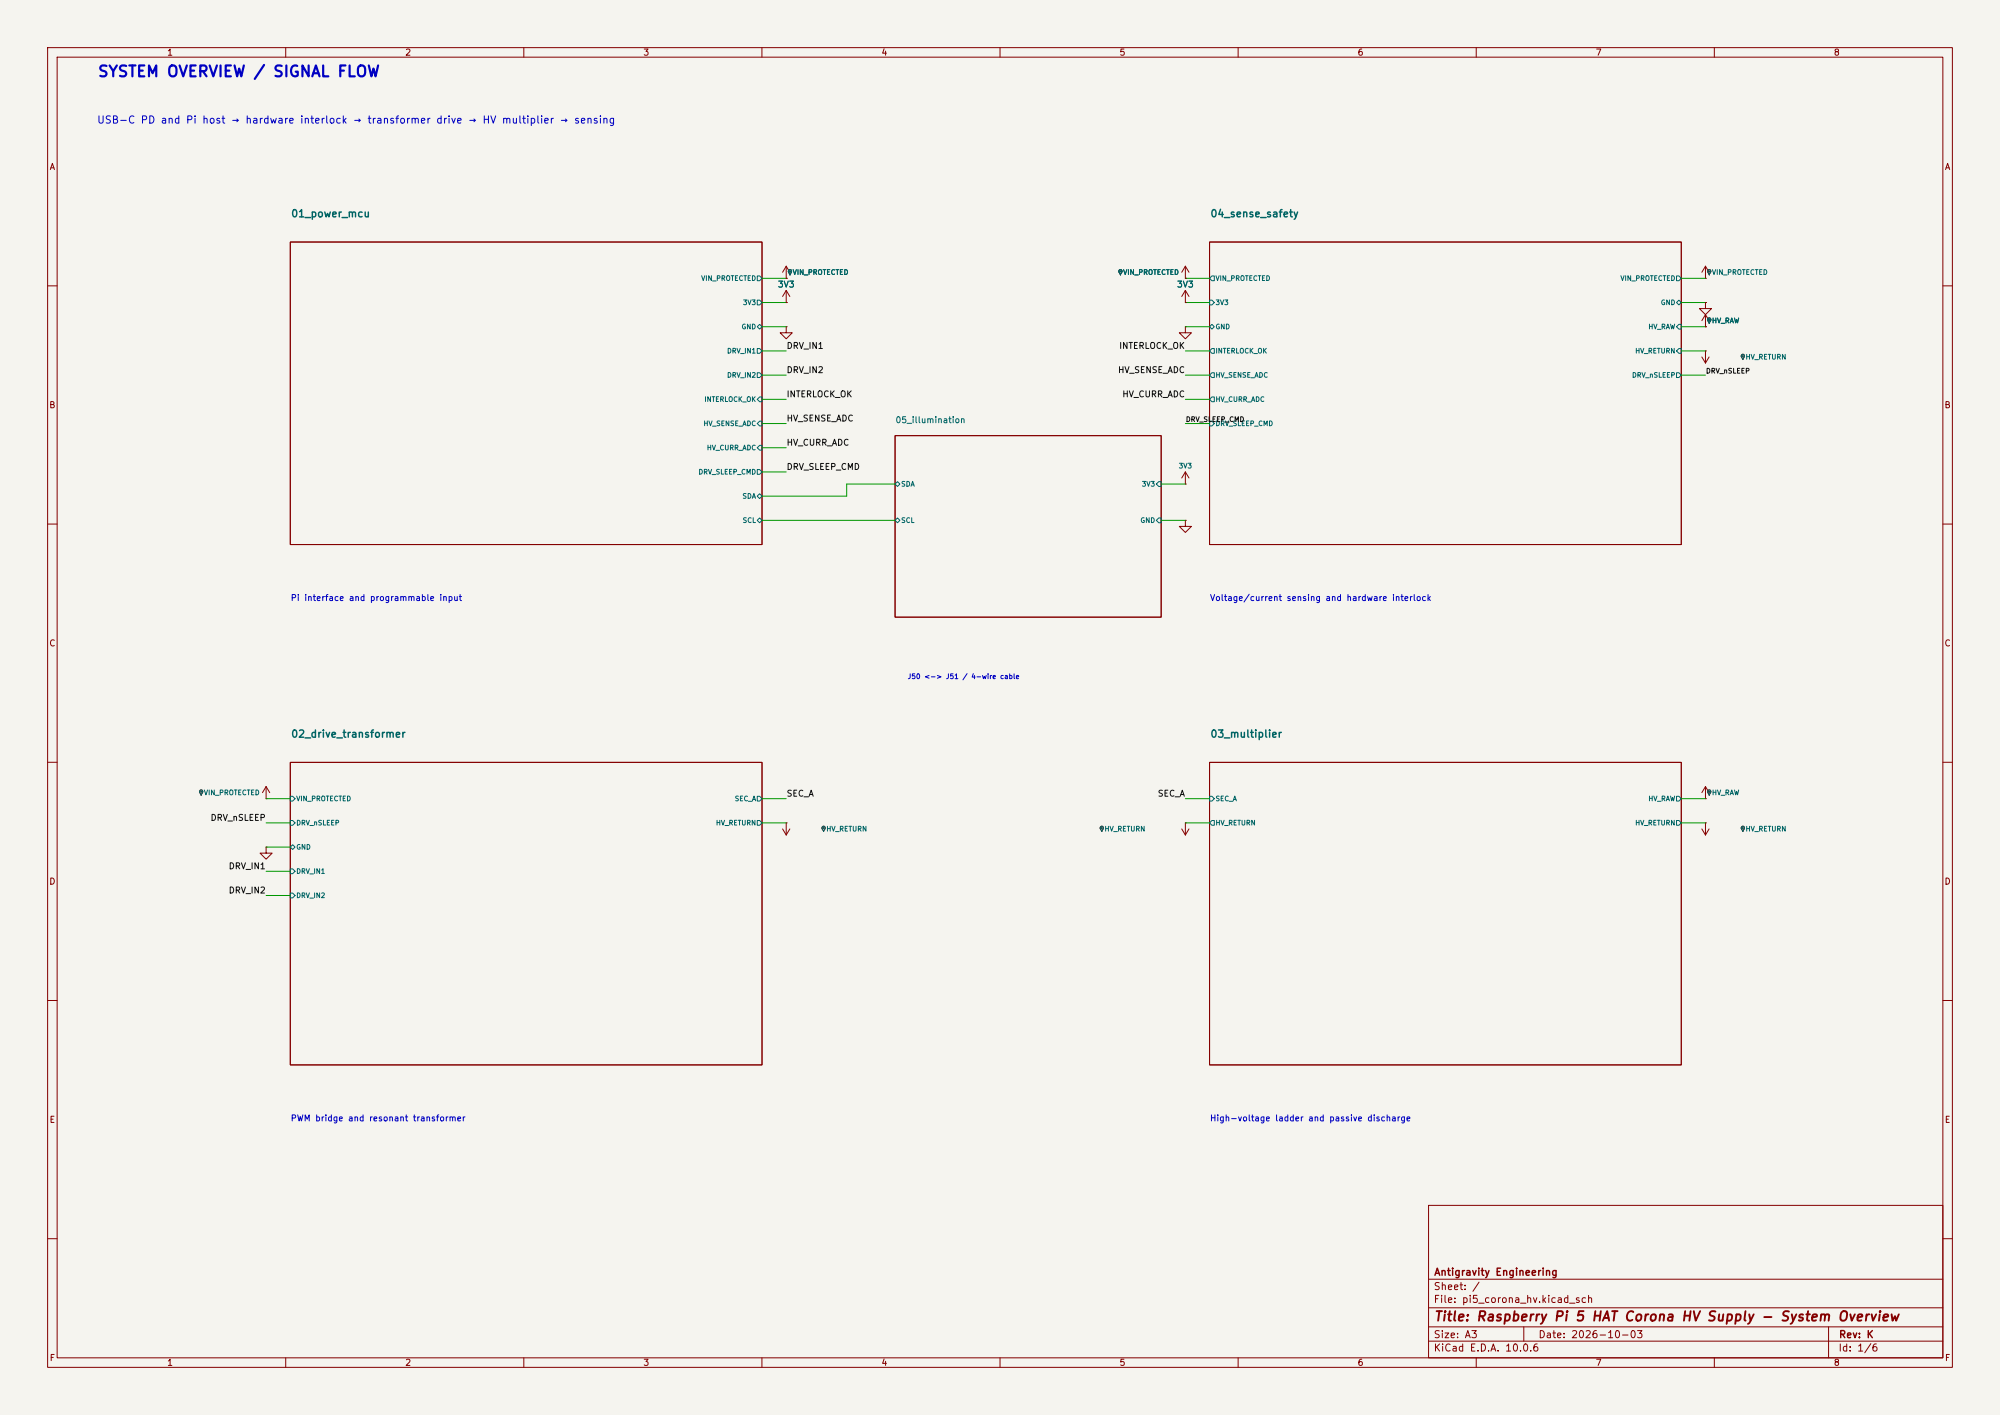
[picture p49: page 1]

SEC_A SYSTEM OVERVIEW / SIGNAL FLOW

USB-C PD and Pi host → hardware interlock → transformer drive → HV multiplier → sensing

High-voltage ladder and passive discharge

Antigravity Engineering
Sheet: /
File: pi5_corona_hv.kicad_sch
Title: Raspberry Pi 5 HAT Corona HV Supply - System Overview

Size: A3 | Rev: K | F Date: 2026-10-03
KiCad E.D.A. 10.0.6 | Id: 1/6

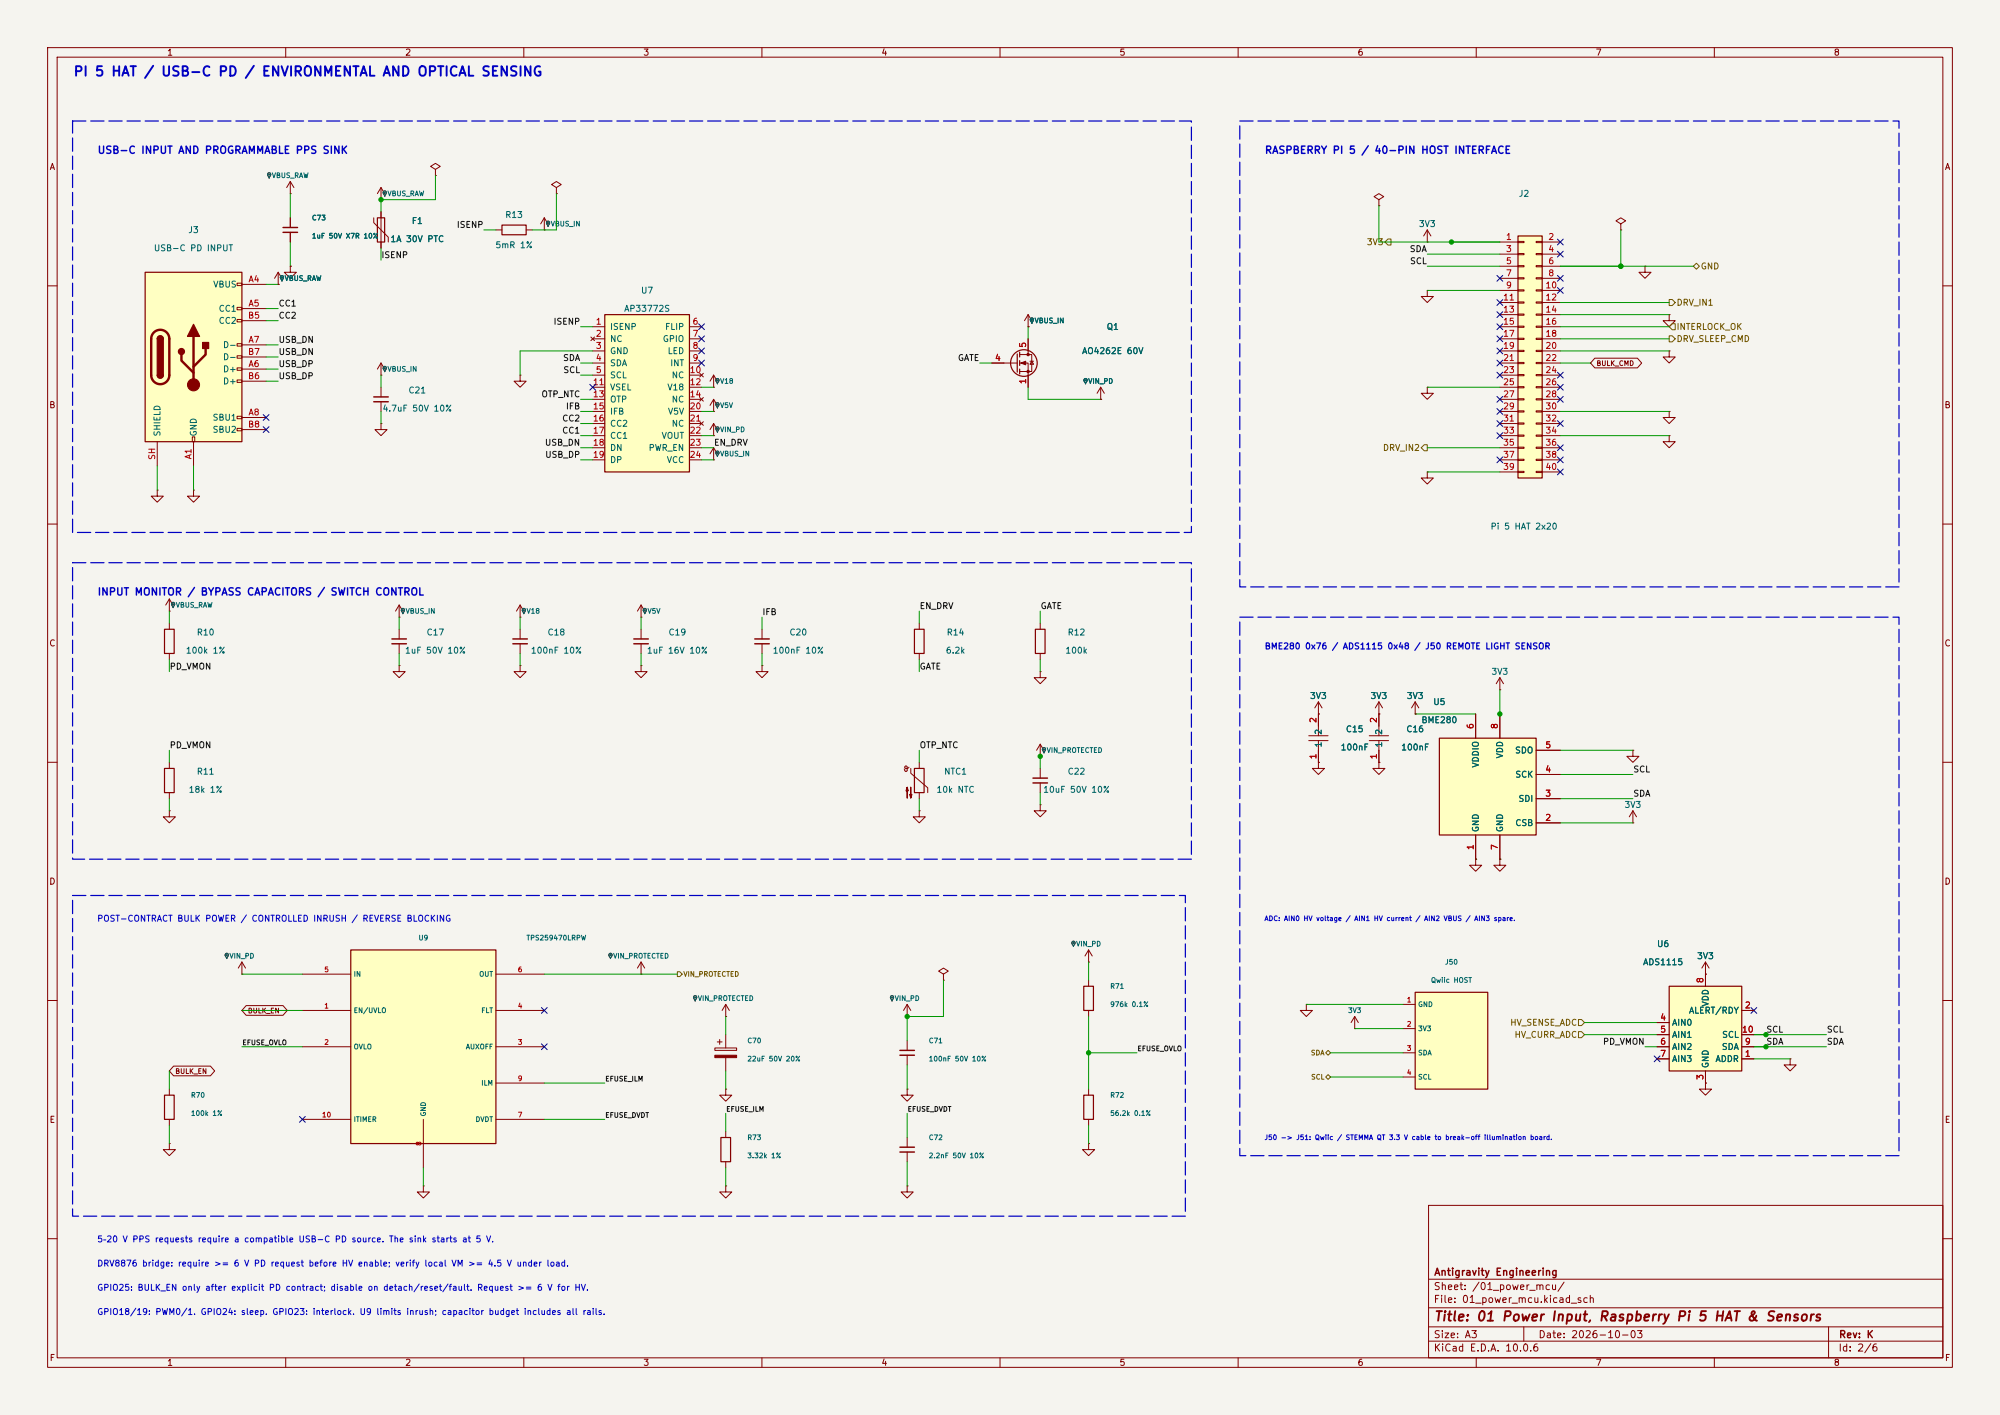
[picture p50: page 2]

PI 5 HAT / USB-C PD / ENVIRONMENTAL AND OPTICAL SENSING

USB-C INPUT AND PROGRAMMABLE PPS SINK

RASPBERRY PI 5 / 40-PIN HOST INTERFACE

INPUT MONITOR / BYPASS CAPACITORS / SWITCH CONTROL

POST-CONTRACT BULK POWER / CONTROLLED INRUSH / REVERSE BLOCKING

ADC: AIN0 HV voltage / AIN1 HV current / AIN2 VBUS / AIN3 spare.

J50 -> J51: Qwiic / STEMMA QT 3.3 V cable to break-off illumination board.

DRV8876 bridge: require >= 6 V PD request before HV enable; verify local VM >= 4.5 V under load. GPIO25: BULK_EN only after explicit PD contract; disable on detach/reset/fault. Request >= 6 V for HV. GPIO18/19: PWM0/1. GPIO24: sleep. GPIO23: interlock. U9 limits inrush; capacitor budget includes all rails.

Antigravity Engineering
Sheet: /01_power_mcu/
File: 01_power_mcu.kicad_sch
Title: 01 Power Input, Raspberry Pi 5 HAT & Sensors

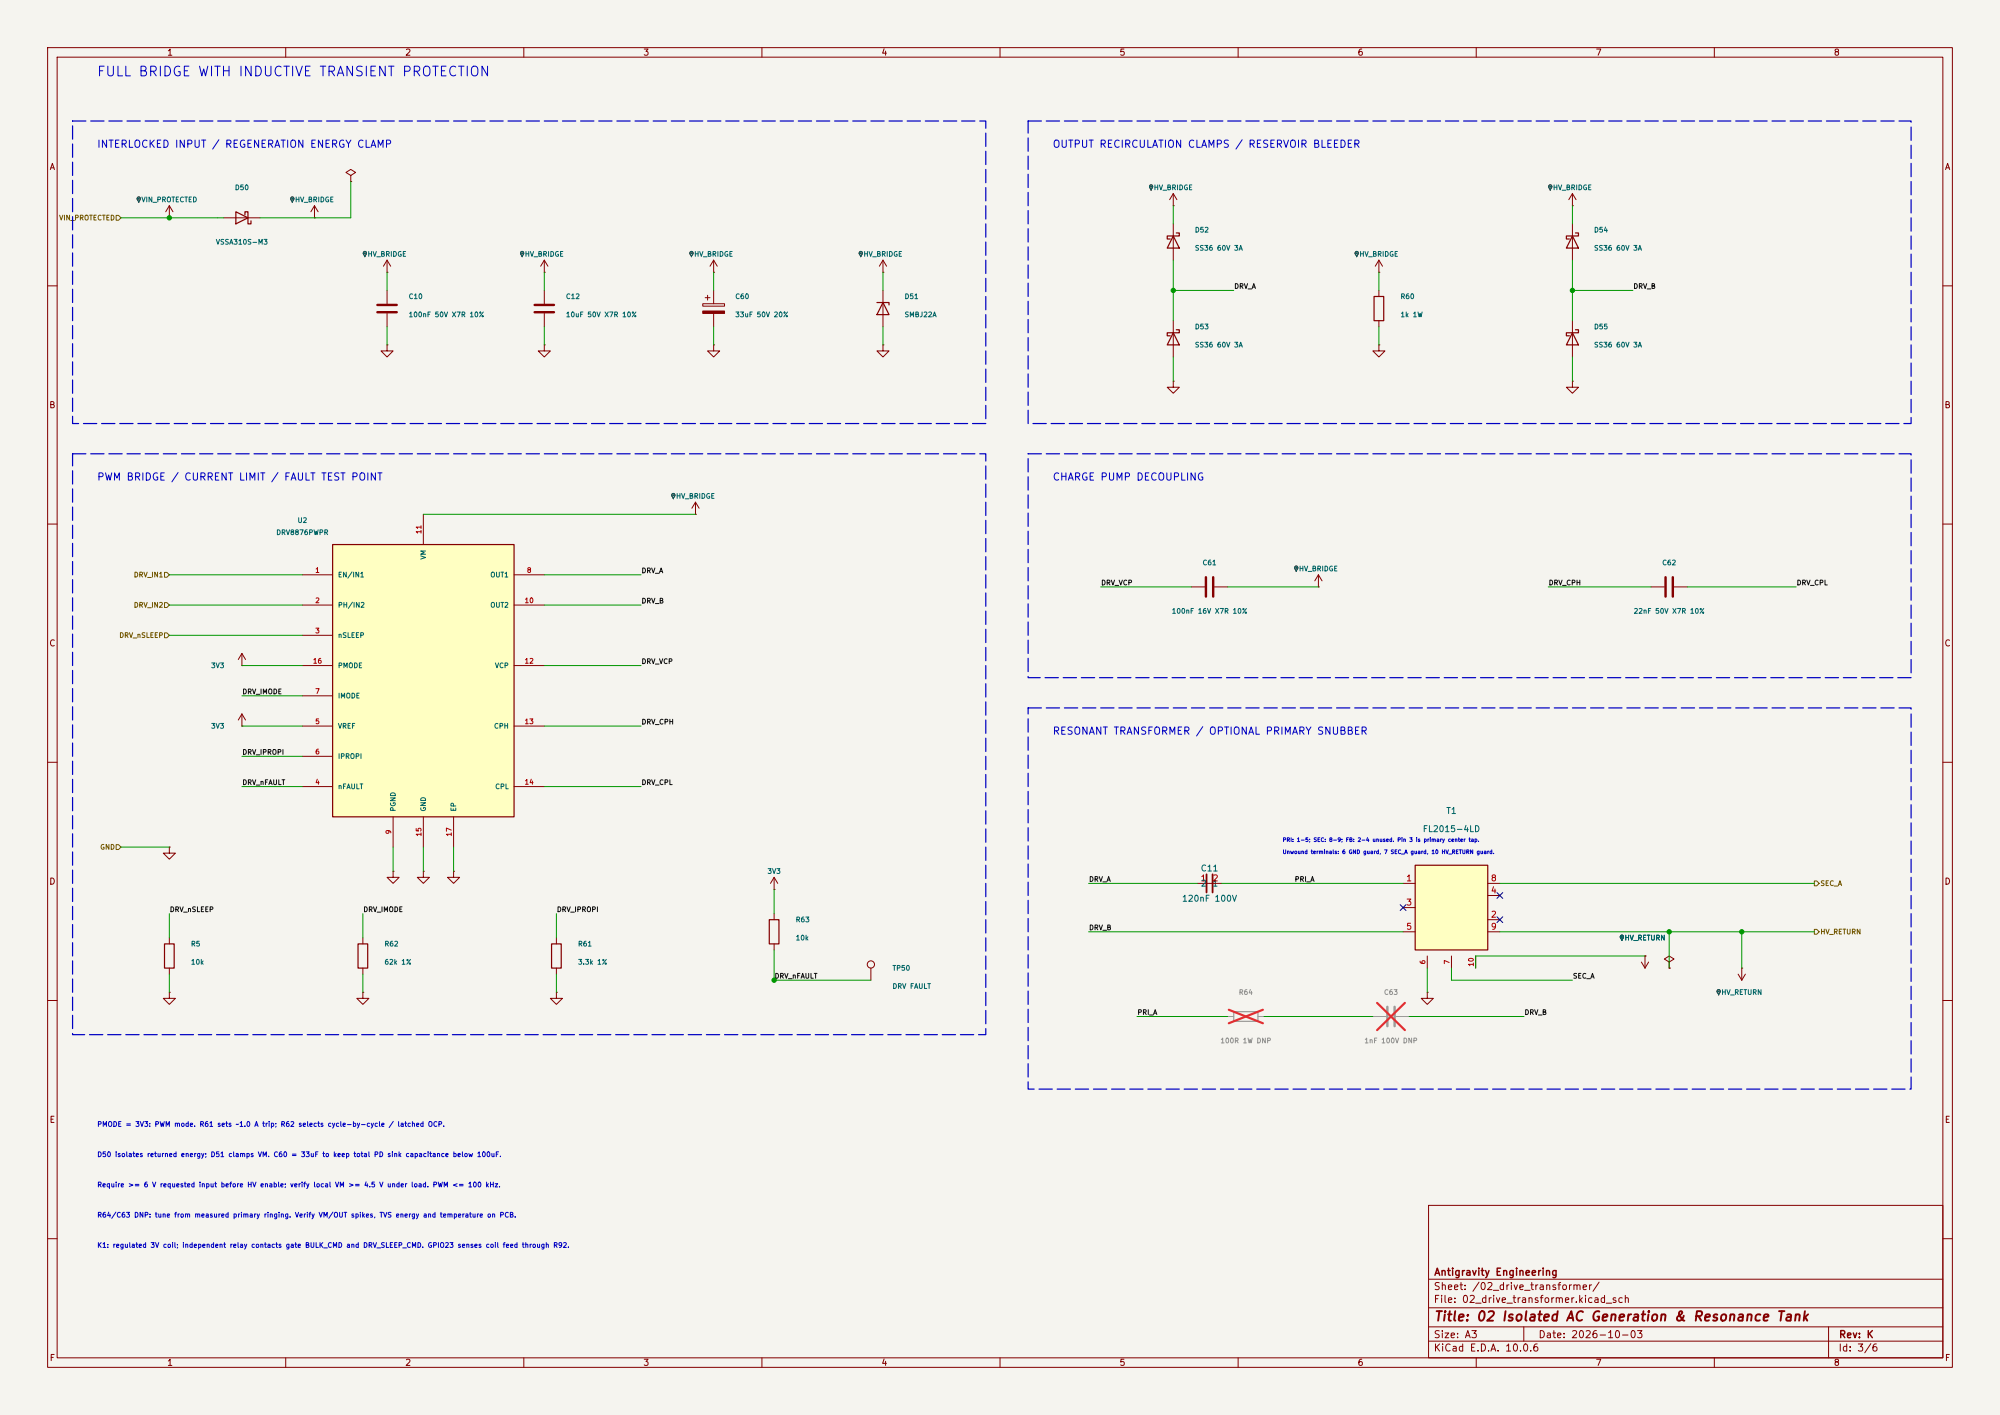
[picture p51: page 3]

FULL BRIDGE WITH INDUCTIVE TRANSIENT PROTECTION

INTERLOCKED INPUT / REGENERATION ENERGY CLAMP

OUTPUT RECIRCULATION CLAMPS / RESERVOIR BLEEDER

PRI: 1-5; SEC: 8-9; FB: 2-4 unused. Pin 3 is primary center tap. PWM BRIDGE / CURRENT LIMIT / FAULT TEST POINT

Unwound terminals: 6 GND guard, 7 SEC_A guard, 10 HV_RETURN guard. CHARGE PUMP DECOUPLING

Require >= 6 V requested input before HV enable; verify local VM >= 4.5 V under load. PWM <= 100 kHz.

R64/C63 DNP: tune from measured primary ringing. Verify VM/OUT spikes, TVS energy and temperature on PCB.

K1: regulated 3V coil; independent relay contacts gate BULK_CMD and DRV_SLEEP_CMD. GPIO23 senses coil feed through R92.

Antigravity Engineering
Sheet: /02_drive_transformer/
File: 02_drive_transformer.kicad_sch
Title: 02 Isolated AC Generation & Resonance Tank

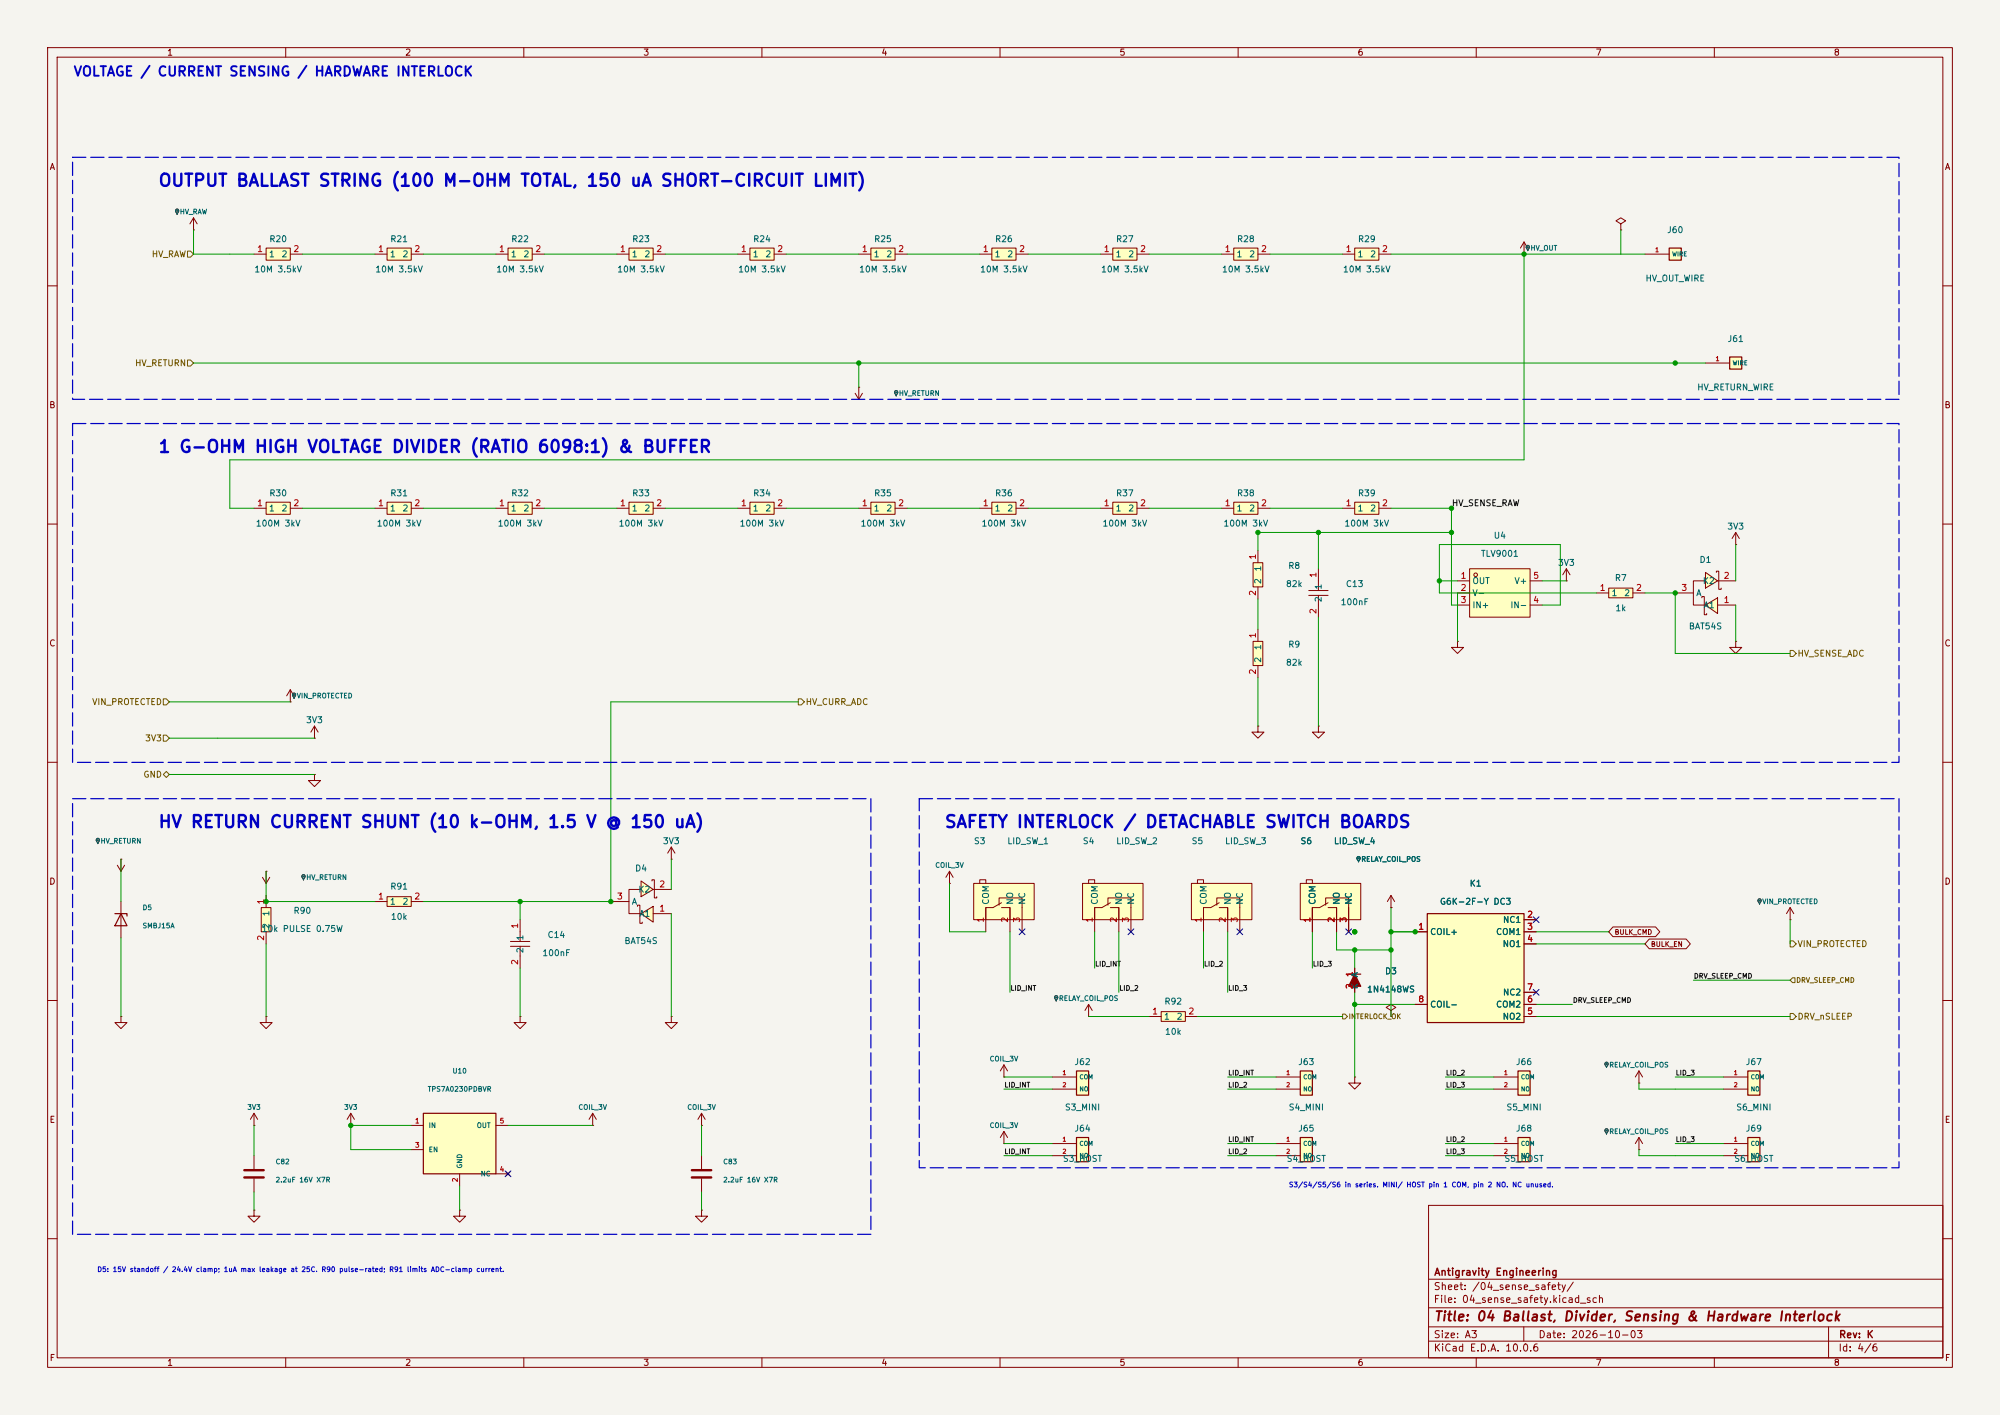
[picture p52: page 4]

VOLTAGE / CURRENT SENSING / HARDWARE INTERLOCK

OUTPUT BALLAST STRING (100 M-OHM TOTAL, 150 uA SHORT-CIRCUIT LIMIT)

1 G-OHM HIGH VOLTAGE DIVIDER (RATIO 6098:1) & BUFFER

D5: 15V standoff / 24.4V clamp; 1uA max leakage at 25C. R90 pulse-rated; R91 limits ADC-clamp current. HV RETURN CURRENT SHUNT (10 k-OHM, 1.5 V @ 150 uA)

SAFETY INTERLOCK / DETACHABLE SWITCH BOARDS

2 | TPS7A0230PDBVR

S3/S4/S5/S6 in series. MINI/ HOST pin 1 COM, pin 2 NO. NC unused.

Antigravity Engineering
Sheet: /04_sense_safety/
File: 04_sense_safety.kicad_sch
Title: 04 Ballast, Divider, Sensing & Hardware Interlock

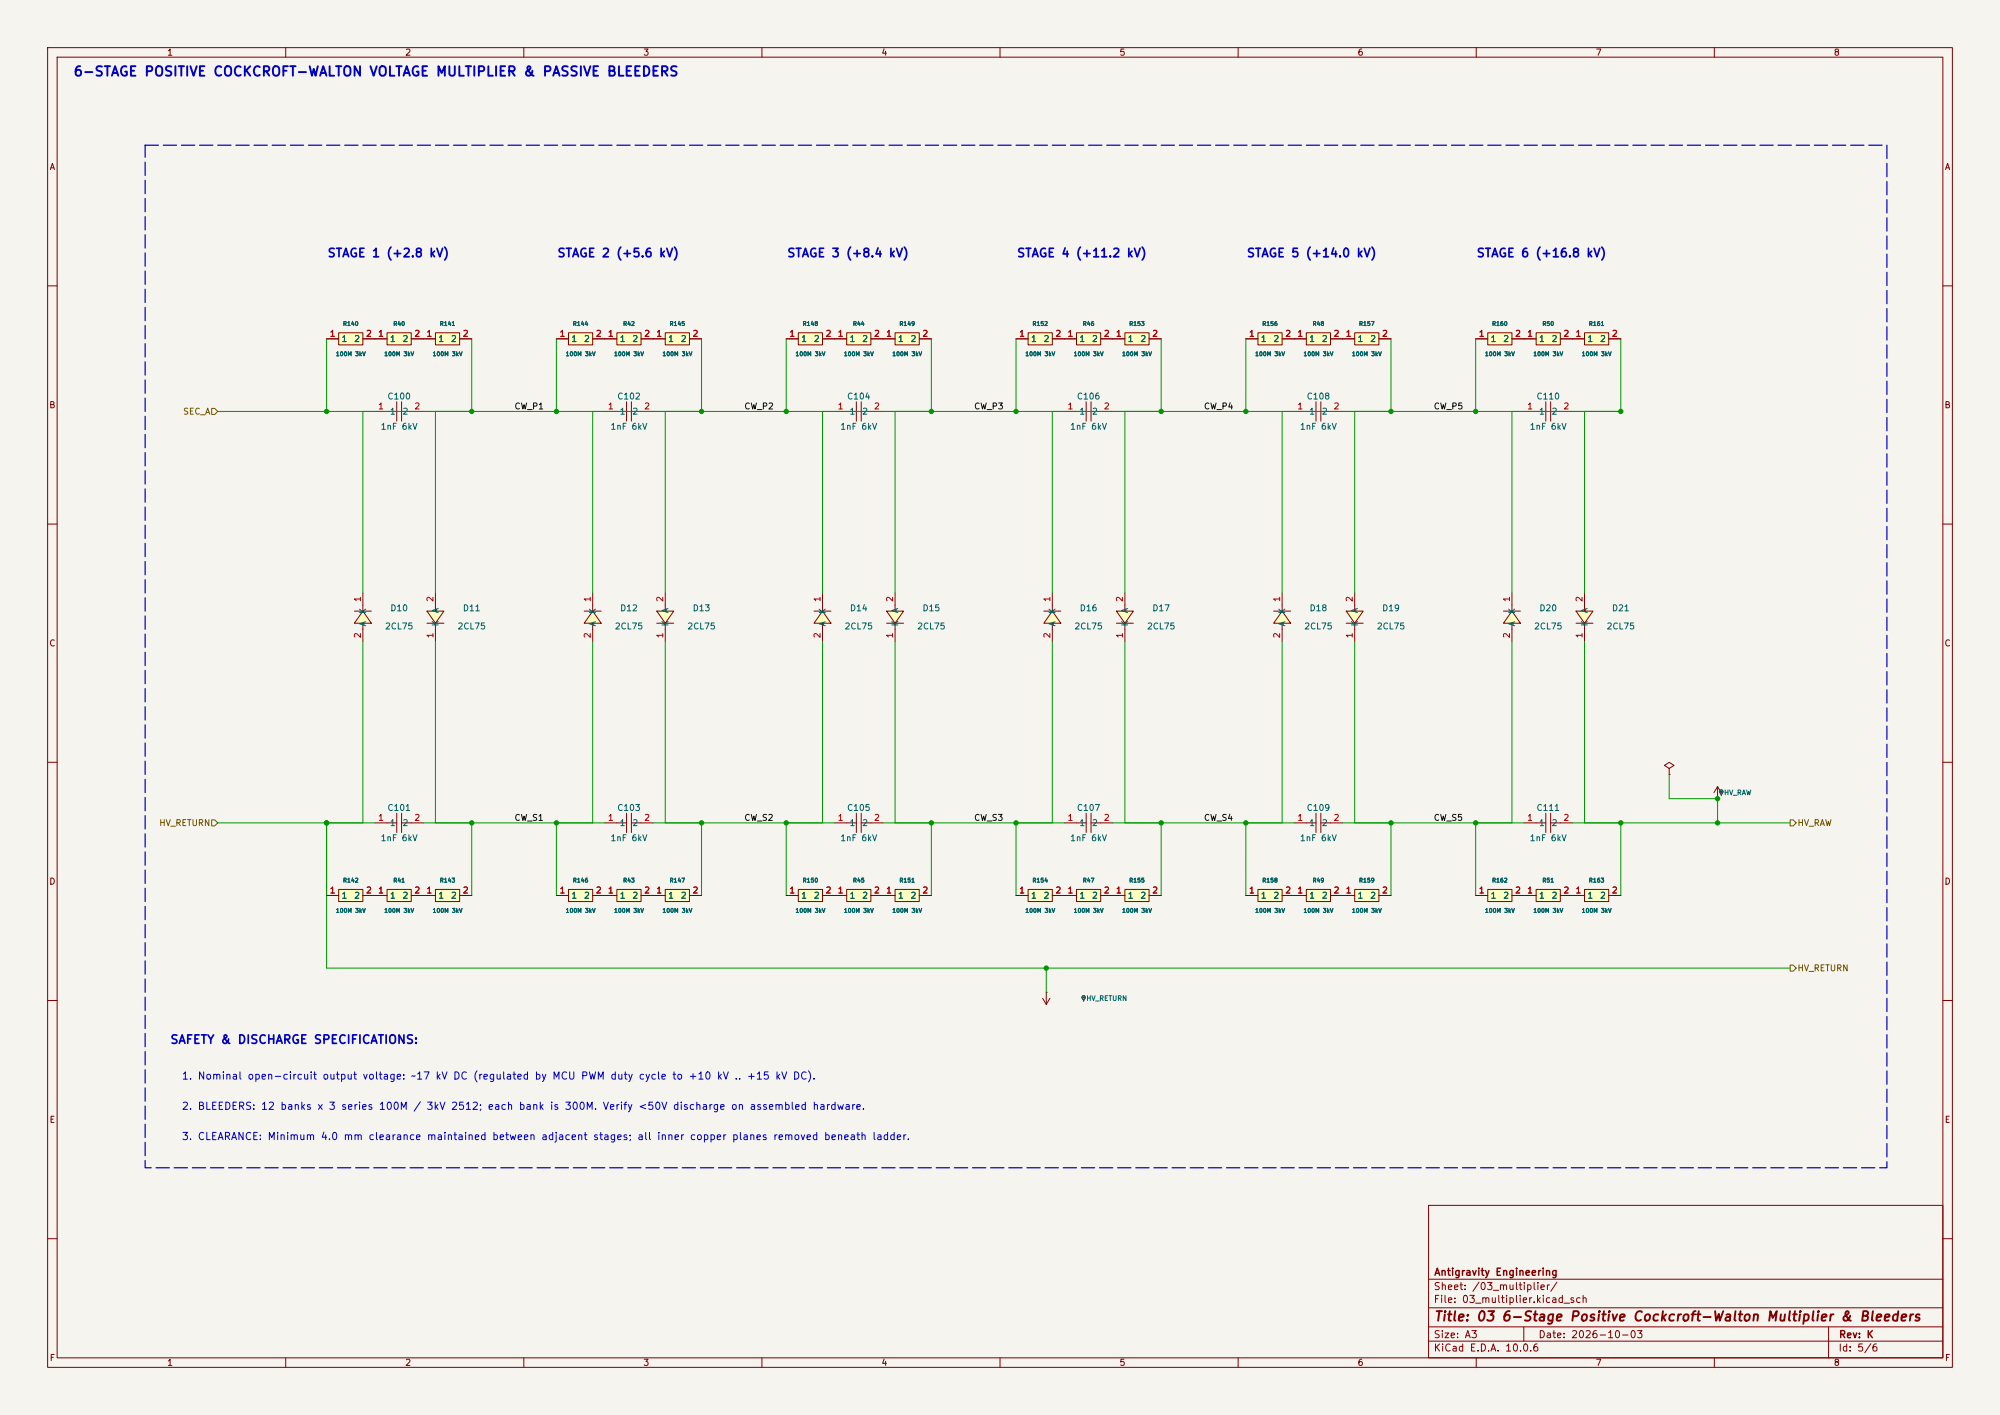
[picture p53: page 5]

6-STAGE POSITIVE COCKCROFT-WALTON VOLTAGE MULTIPLIER & PASSIVE BLEEDERS

1. Nominal open-circuit output voltage: ~17 kV DC (regulated by MCU PWM duty cycle to +10 kV .. +15 kV DC).

2. BLEEDERS: 12 banks x 3 series 100M / 3kV 2512; each bank is 300M. Verify <50V discharge on assembled hardware.

3. CLEARANCE: Minimum 4.0 mm clearance maintained between adjacent stages; all inner copper planes removed beneath ladder.

Antigravity Engineering
Sheet: /03_multiplier/
File: 03_multiplier.kicad_sch
Title: 03 6-Stage Positive Cockcroft-Walton Multiplier & Bleeders

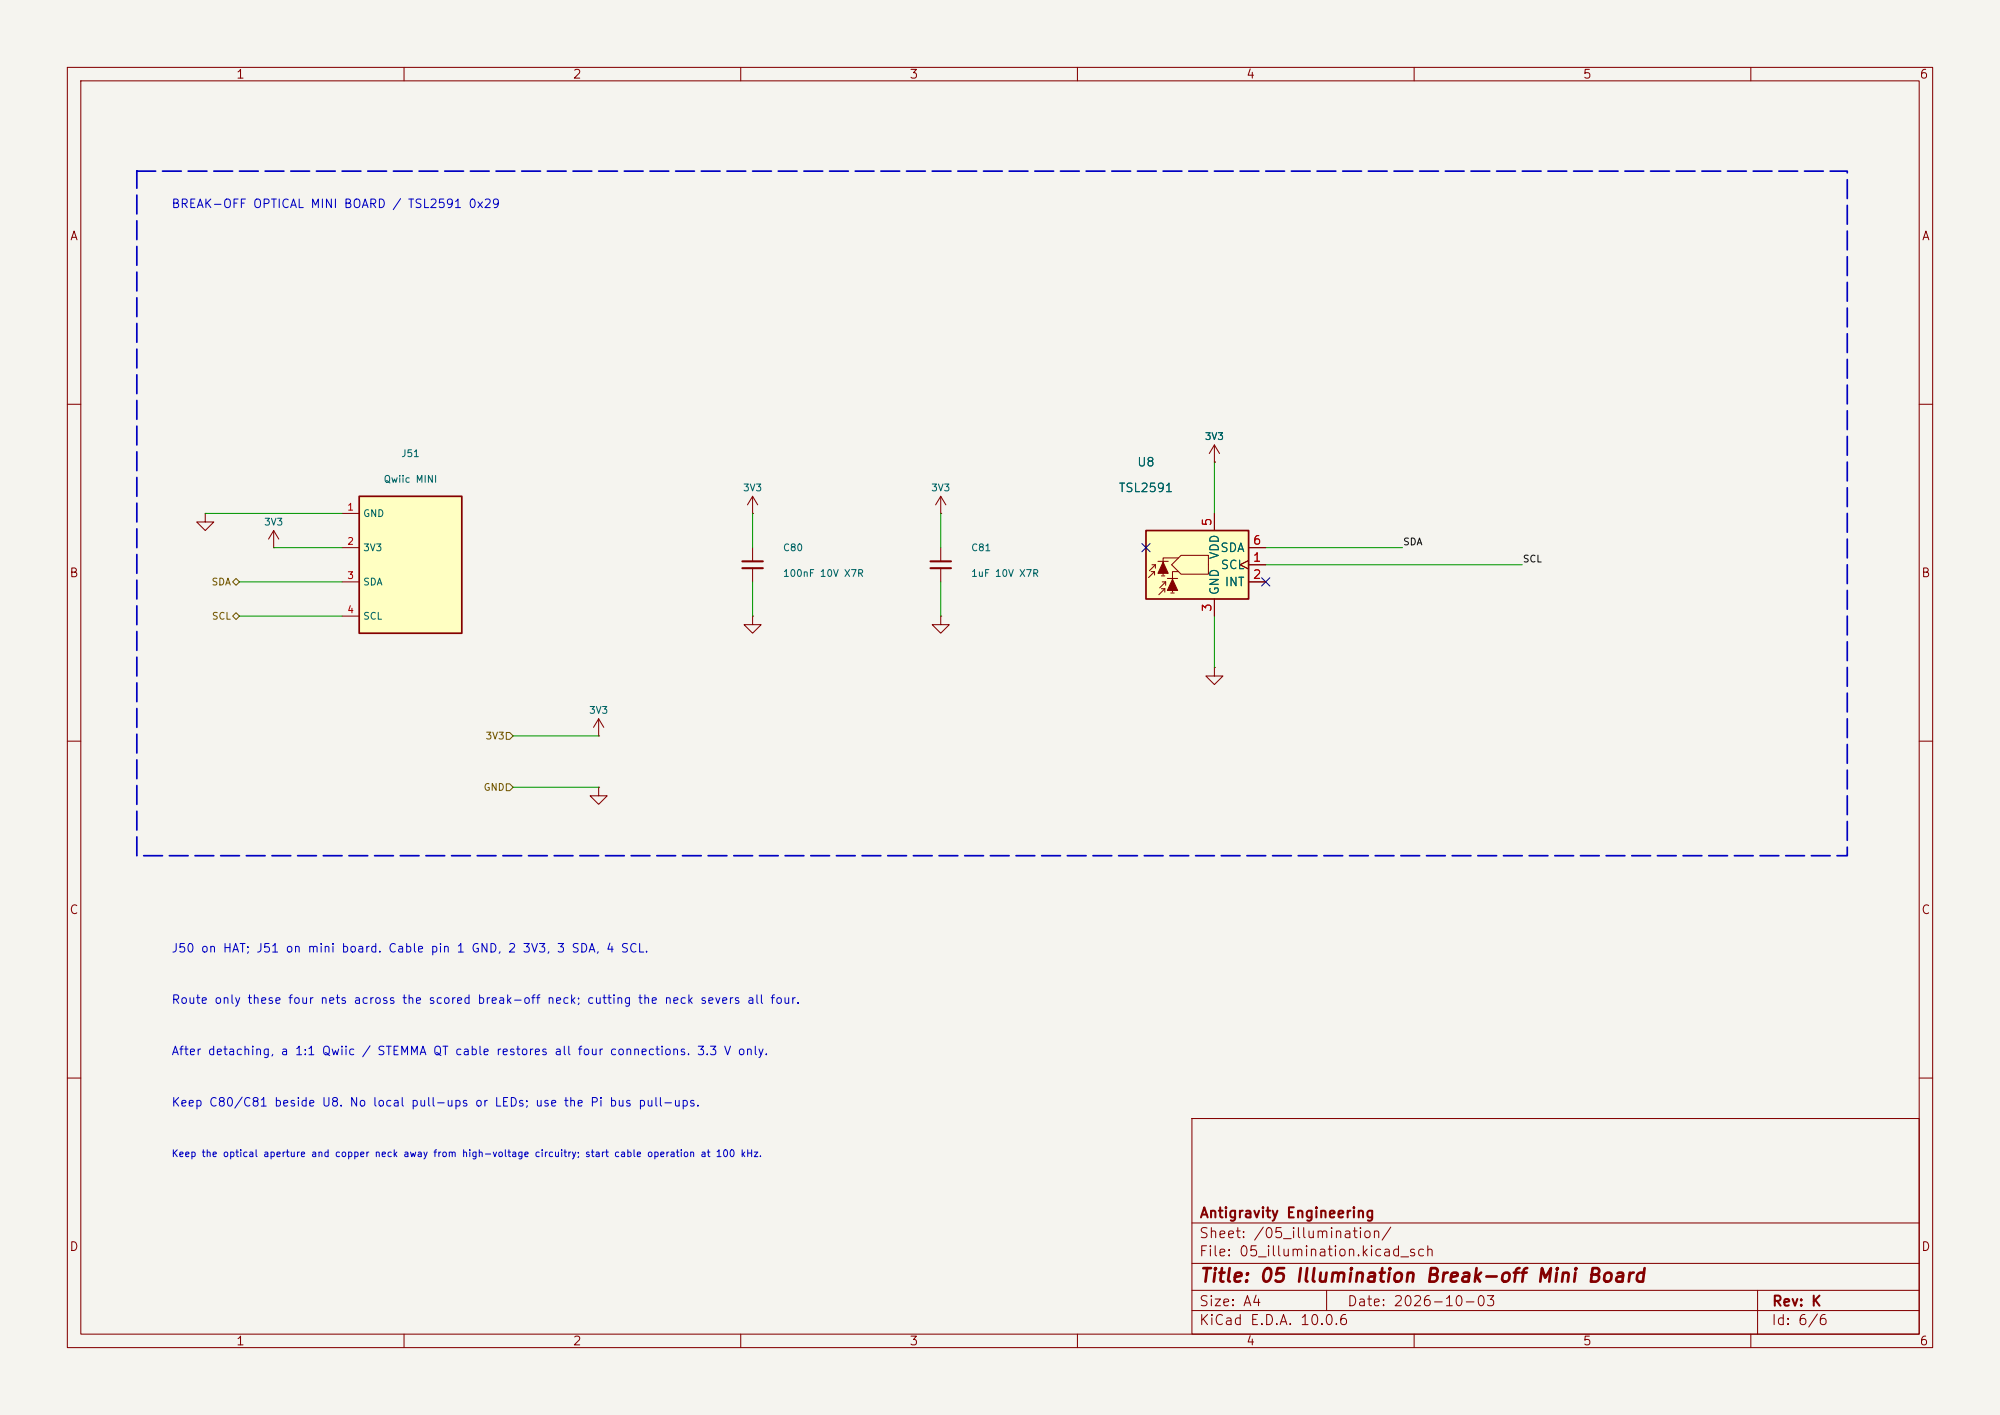
[picture p54: page 6]

BREAK-OFF OPTICAL MINI BOARD / TSL2591 0x29

Keep C80/C81 beside U8. No local pull-ups or LEDs; use the Pi bus pull-ups. Keep the optical aperture and copper neck away from high-voltage circuitry; start cable operation at 100 kHz.

Antigravity Engineering
Sheet: /05_illumination/
File: 05_illumination.kicad_sch
Title: 05 Illumination Break-off Mini Board
