uge/ew-1/hardware/pi5_corona_hat_direct/exports/compact-pcb-layout.pdf

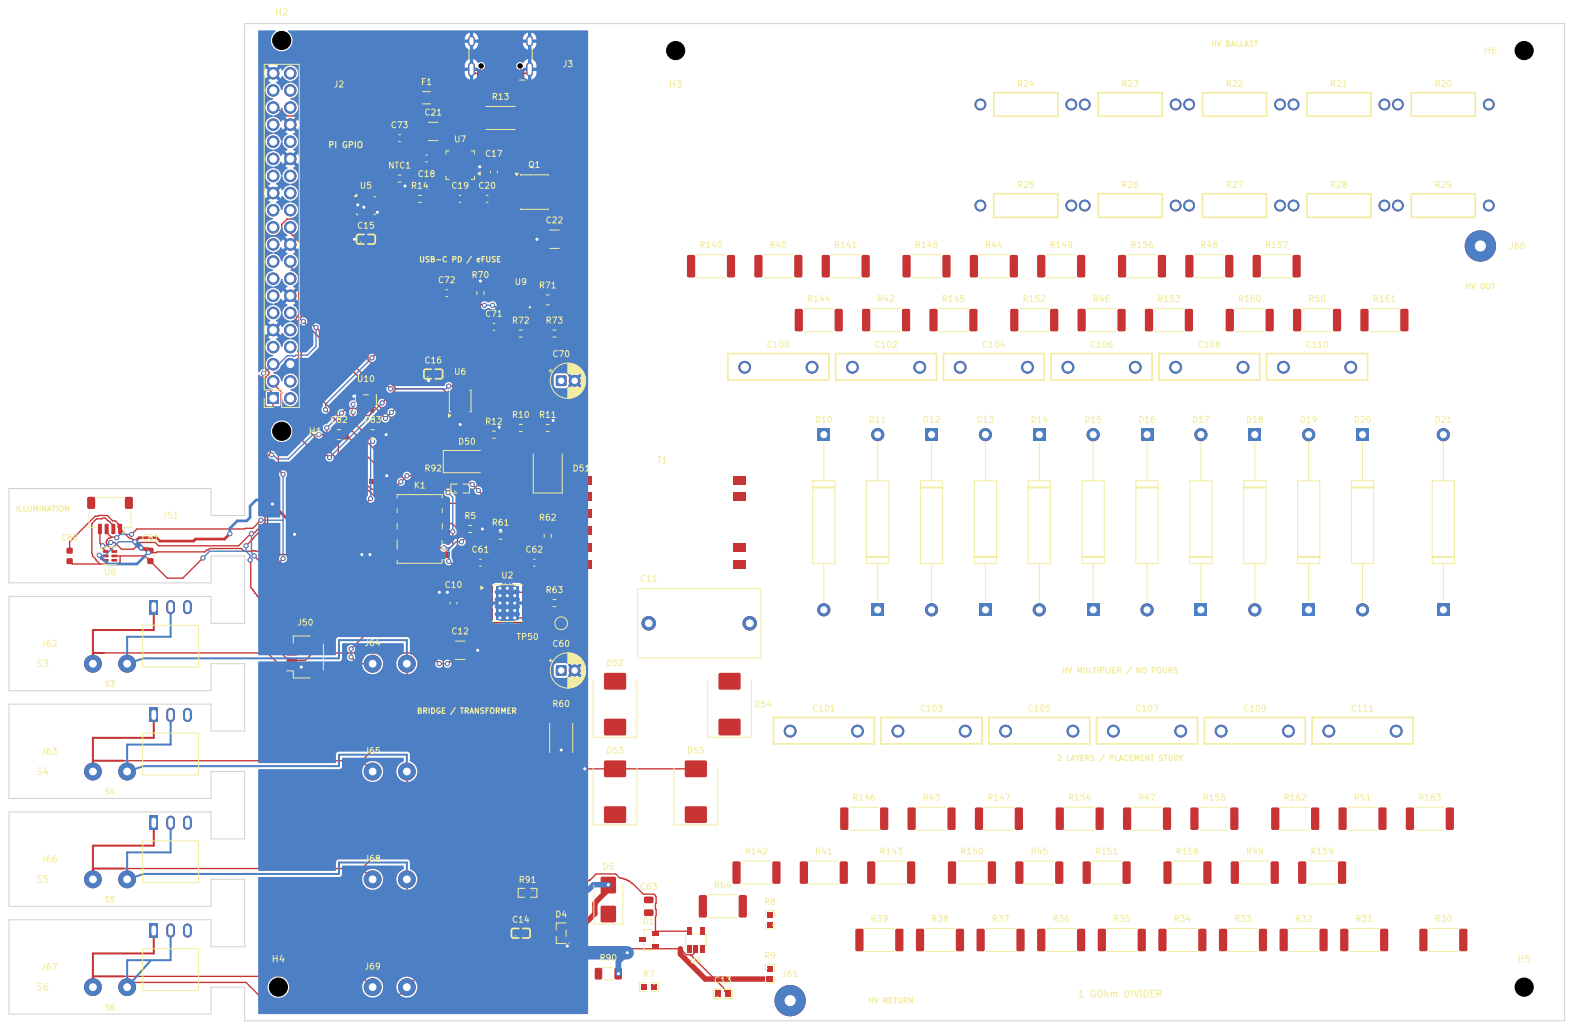
[picture p55: page 1]

HV MULTIPLIER / NO POURS
