uge/ew-1/hardware/pi5_corona_hat_direct/exports/initial-pcb-layout.pdf

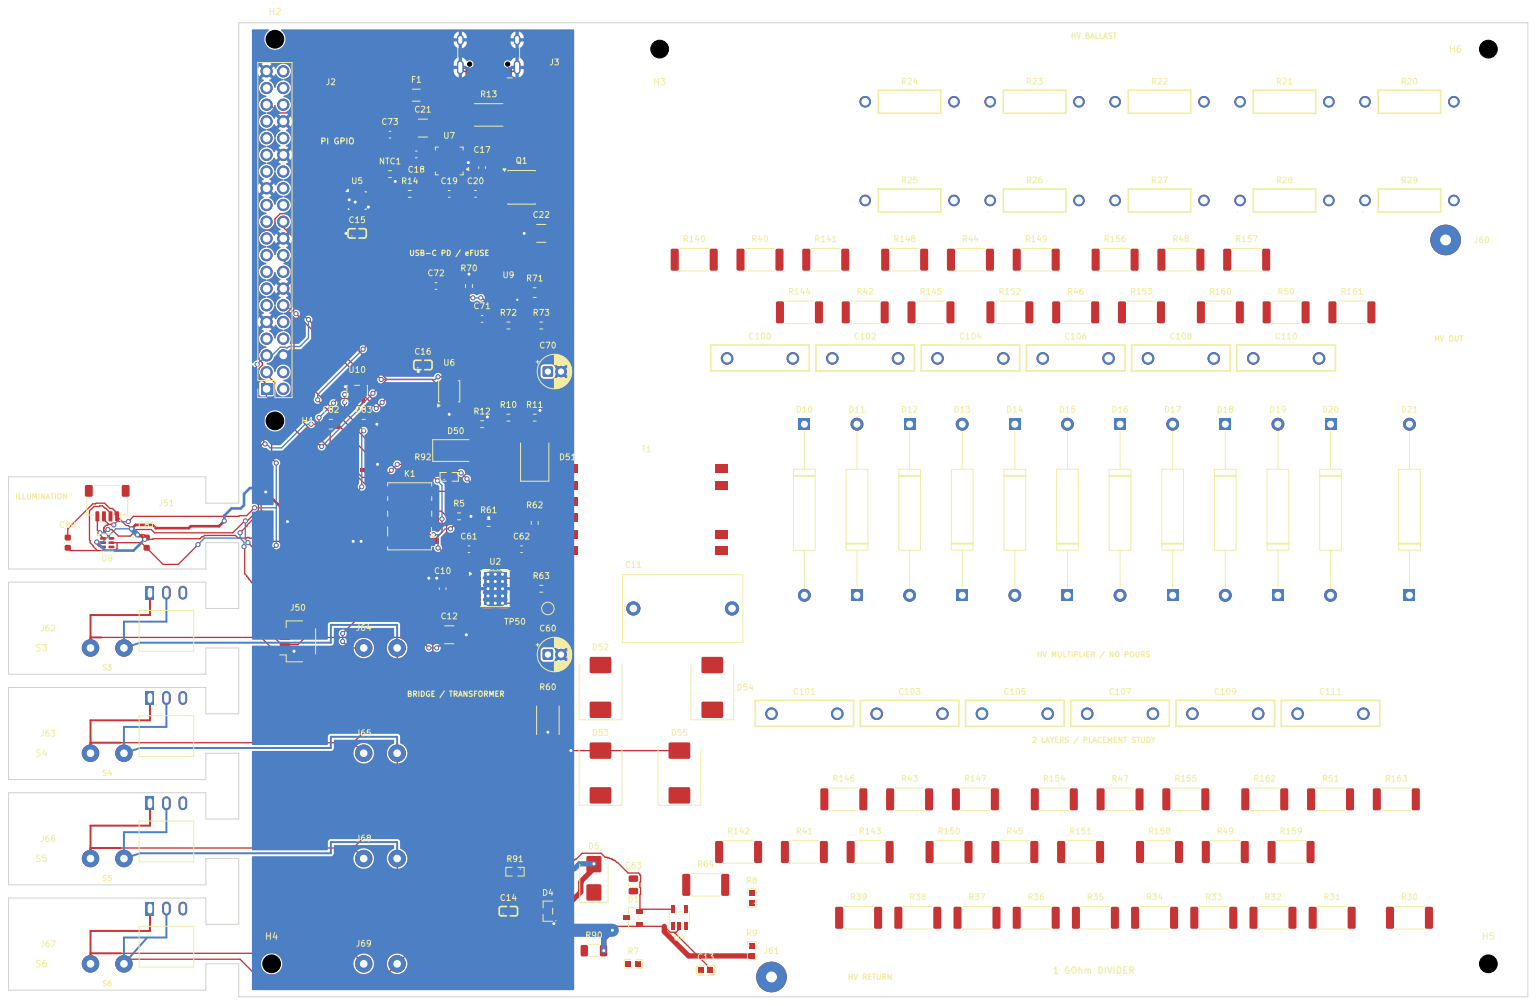
[picture p56: page 1]

HV OUT PI GPIO

HV MULTIPLIER / NO POURS
