uge/ew-1/hardware/pi5_corona_hat_direct/procurement/DEALON_TK-0013-R.pdf

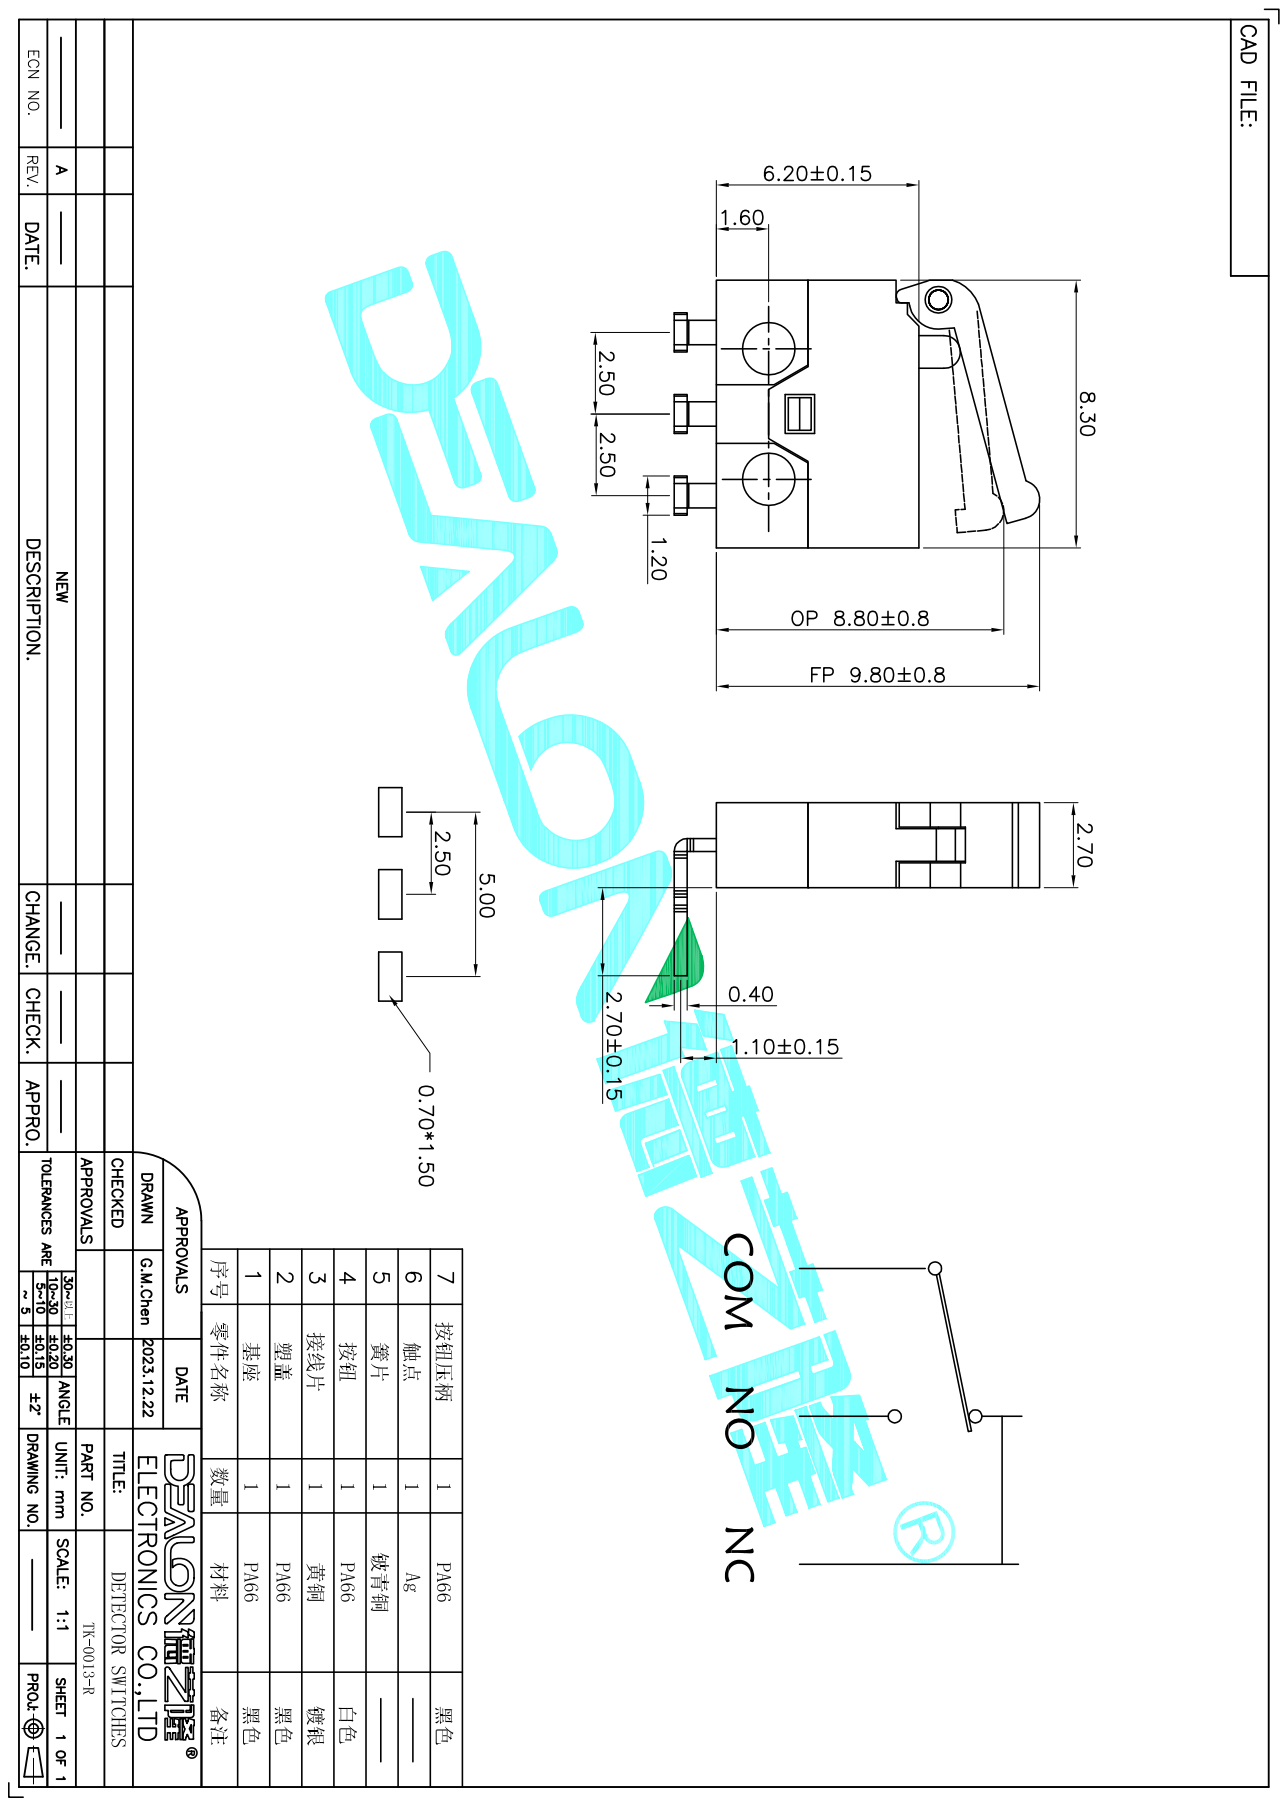
[picture p57: page 1]
