uge/ew-1/(list of files, drawings)

Other design files:
hardware/pi5_corona_hat_direct/layout/schematic-connectivity.json
