uge/ew-1/hardware/pi5_corona_hat_direct/pi5_corona_hv.kicad_pcb

## KiCad design hardware/pi5_corona_hat_direct/pi5_corona_hv.kicad_pcb (2026-10-21)

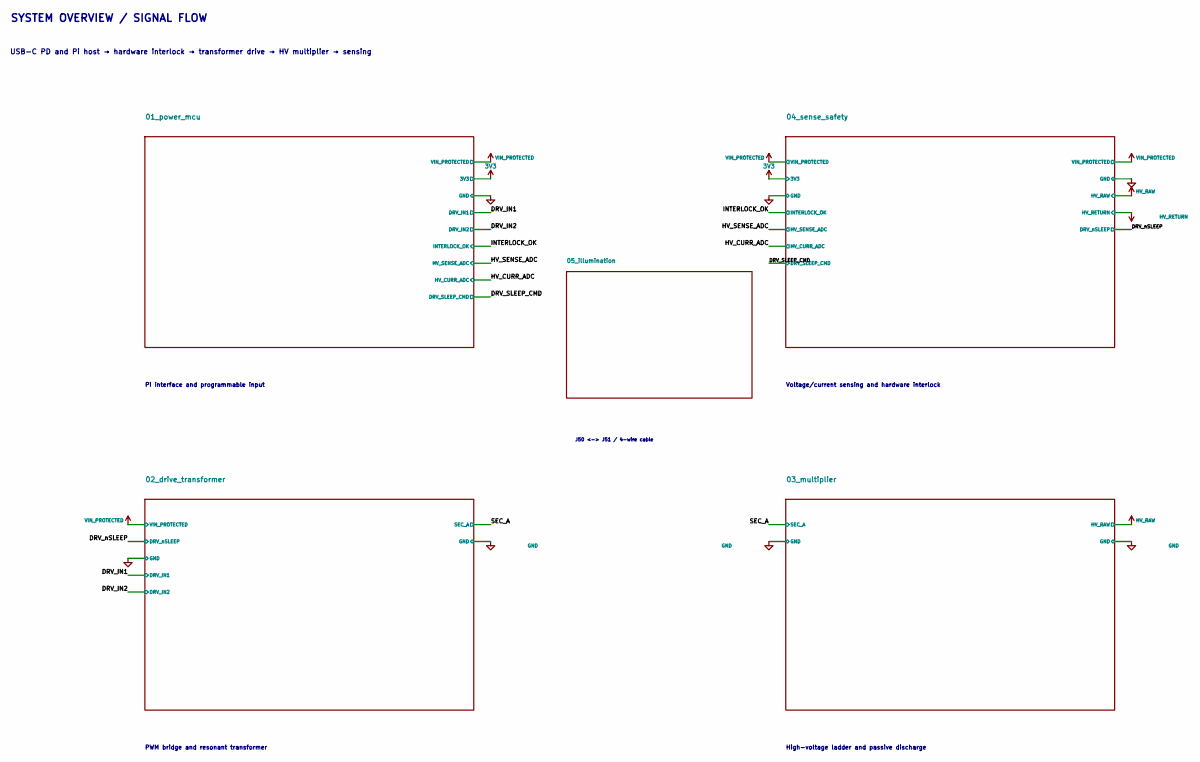
[picture p58: schematic pi5_corona_hv.kicad_sch, Raspberry Pi 5 HAT Corona HV Supply - System Overview]

Notes on the sheet:
SYSTEM OVERVIEW / SIGNAL FLOW
High-voltage ladder and passive discharge
Pi interface and programmable input
J50 <-> J51 / 4-wire cable
Voltage/current sensing and hardware interlock
USB-C PD and Pi host → hardware interlock → transformer drive → HV multiplier → sensing
PWM bridge and resonant transformer

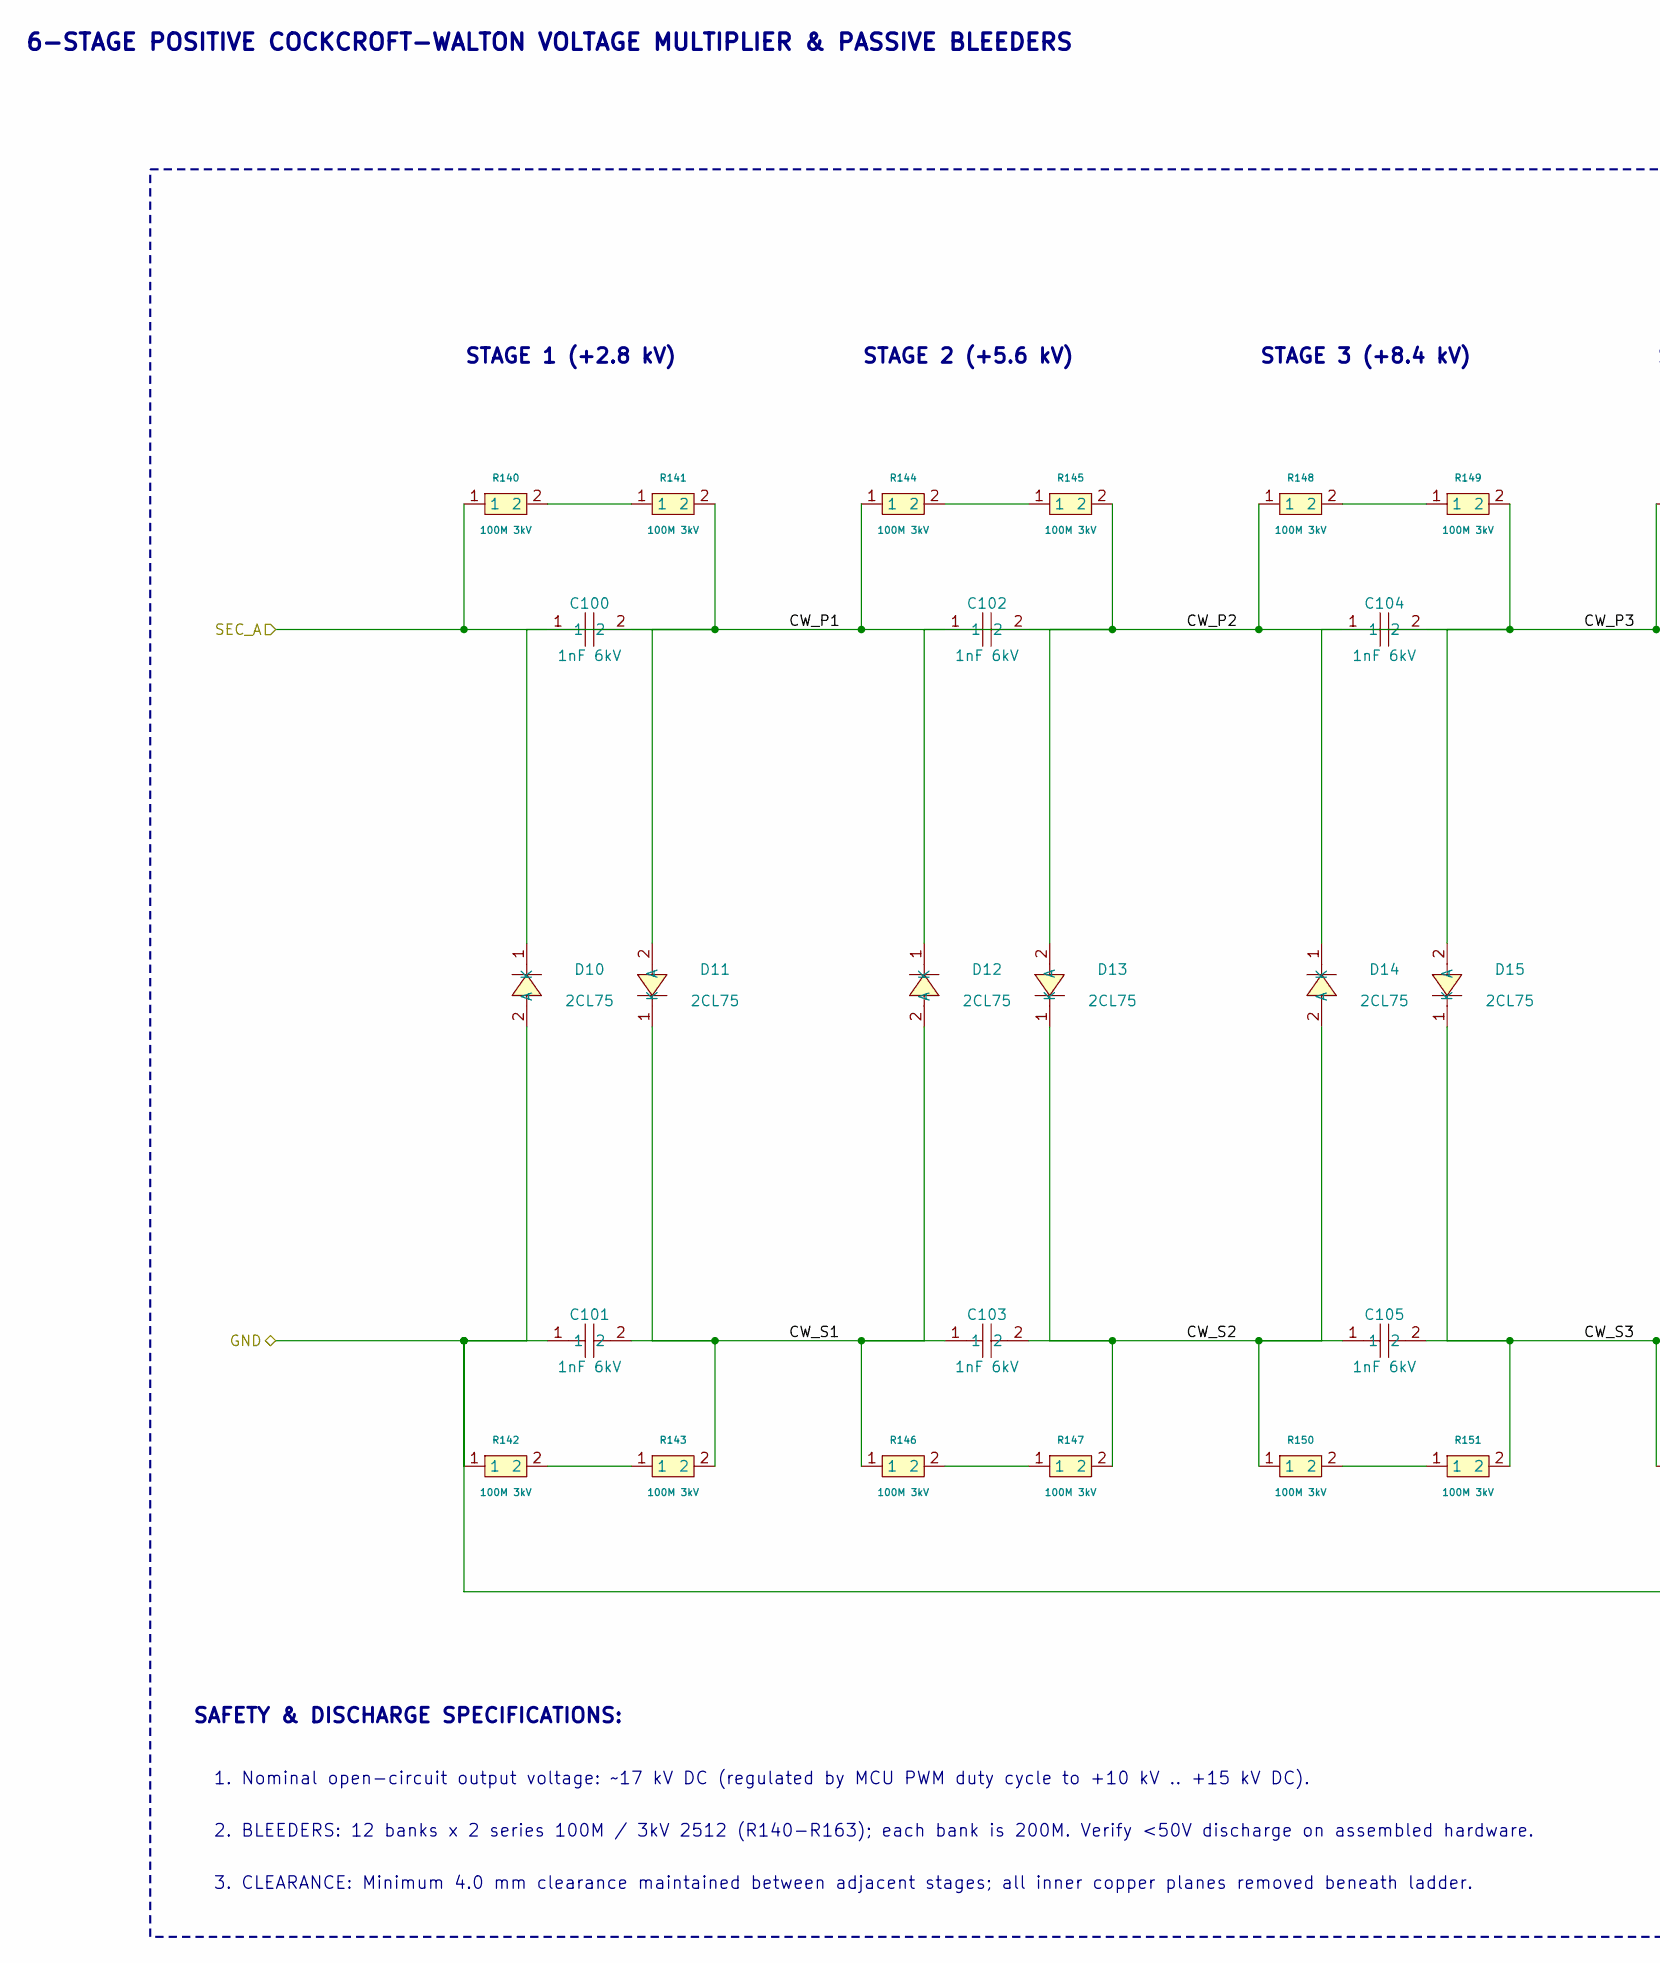
[picture p59: schematic 03_multiplier.kicad_sch, 03 6-Stage Positive Cockcroft-Walton Multiplier & Bleeders, part in row 1, column 1]

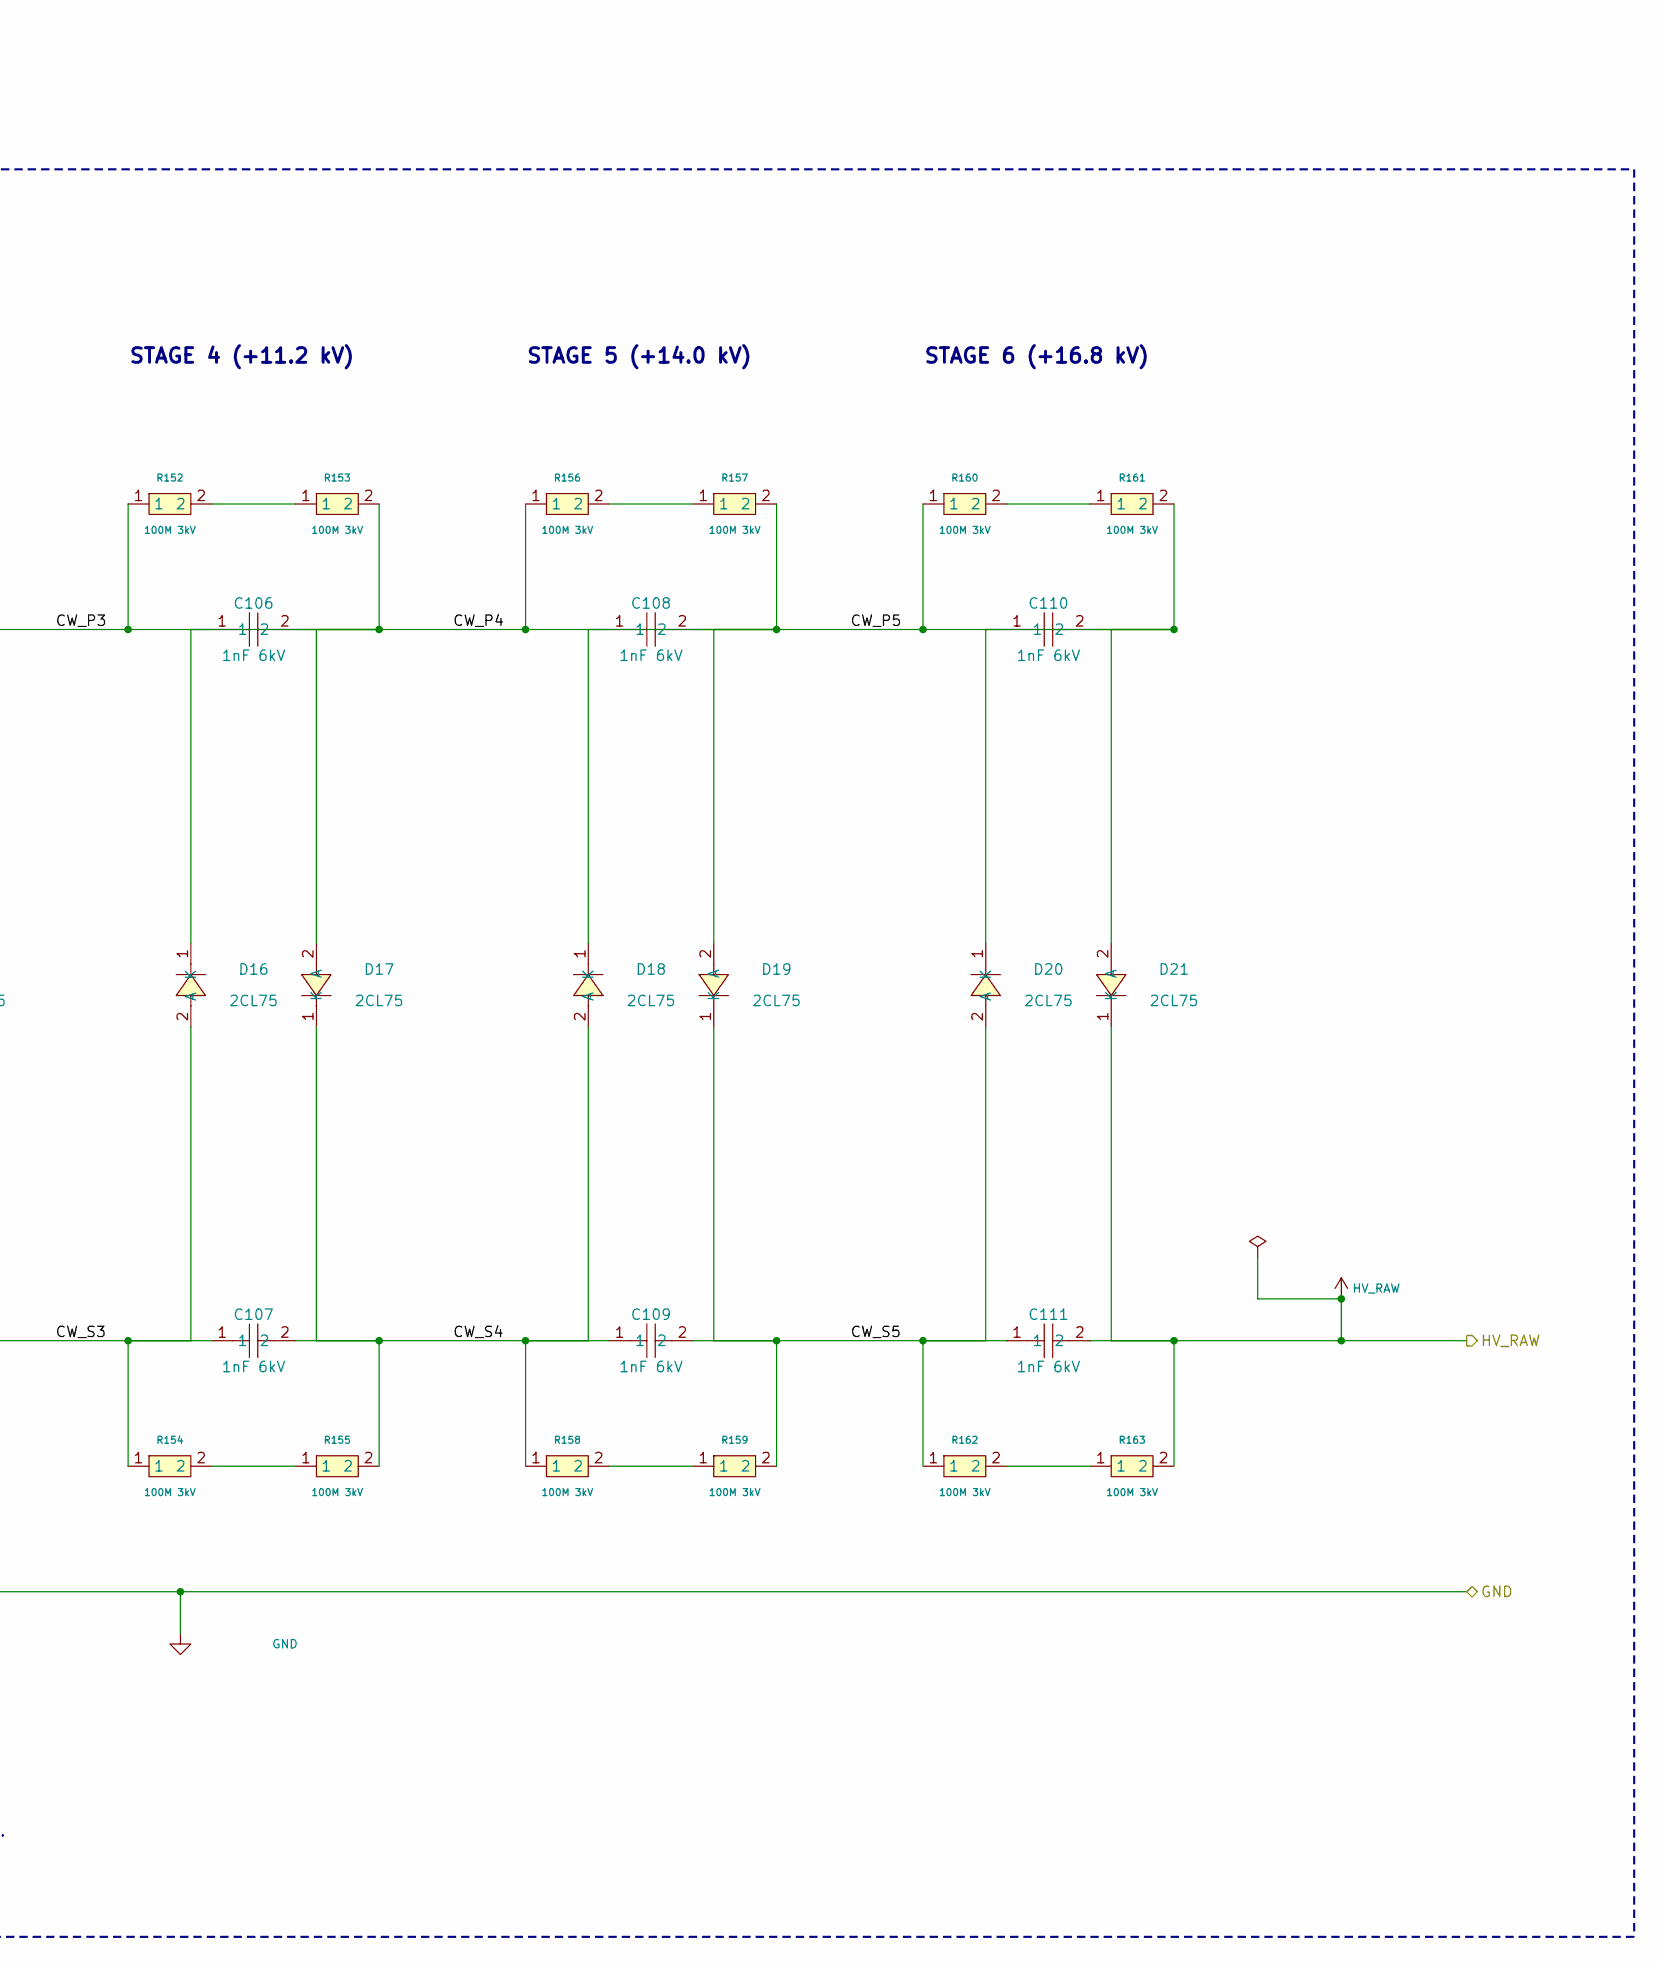
[picture p60: schematic 03_multiplier.kicad_sch, 03 6-Stage Positive Cockcroft-Walton Multiplier & Bleeders, part in row 1, column 2]

Parts:
C100, C101, C102, C103, C104, C105, C106, C107, C108, C109, C110, C111: 1nF 6kV; STE_A12B1D102K_P10.0mm; MPN A12B1D102KN0B0S0N0; LCSC Part C249245
D10, D11, D12, D13, D14, D15, D16, D17, D18, D19, D20, D21: 2CL75; Sunmate_2CL75_D3_L12_P26; MPN 2CL75; LCSC Part C424512
R140, R141, R142, R143, R144, R145, R146, R147, R148, R149, R150, R151, R152, R153, R154, R155, R156, R157, R158, R159, R160, R161, R162, R163: 100M 3kV; R_2512_6332Metric; MPN CHV2512-JW-107ELF; LCSC Part C2089706

Connections:
/03_multiplier/CW_P1: C100.2, C102.1, D10.1 (K), D11.2 (A), R141.2, R144.1
/03_multiplier/CW_P2: C102.2, C104.1, D12.1 (K), D13.2 (A), R145.2, R148.1
/03_multiplier/CW_P3: C104.2, C106.1, D14.1 (K), D15.2 (A), R149.2, R152.1
/03_multiplier/CW_P4: C106.2, C108.1, D16.1 (K), D17.2 (A), R153.2, R156.1
/03_multiplier/CW_P5: C108.2, C110.1, D18.1 (K), D19.2 (A), R157.2, R160.1
/03_multiplier/CW_S1: C101.2, C103.1, D11.1 (K), D12.2 (A), R143.2, R146.1
/03_multiplier/CW_S2: C103.2, C105.1, D13.1 (K), D14.2 (A), R147.2, R150.1
/03_multiplier/CW_S3: C105.2, C107.1, D15.1 (K), D16.2 (A), R151.2, R154.1
/03_multiplier/CW_S4: C107.2, C109.1, D17.1 (K), D18.2 (A), R155.2, R158.1
/03_multiplier/CW_S5: C109.2, C111.1, D19.1 (K), D20.2 (A), R159.2, R162.1
/HV_RAW: C111.2, D21.1 (K), R163.2; also elsewhere on the board
/SEC_A: C100.1, R140.1; also elsewhere on the board
GND: C101.1, D10.2 (A), R142.1; also elsewhere on the board
unnamed: C110.2, D20.1 (K), D21.2 (A), R161.2
unnamed: R140.2, R141.1
unnamed: R142.2, R143.1
unnamed: R144.2, R145.1
unnamed: R146.2, R147.1
unnamed: R148.2, R149.1
unnamed: R150.2, R151.1
unnamed: R152.2, R153.1
unnamed: R154.2, R155.1
unnamed: R156.2, R157.1
unnamed: R158.2, R159.1
unnamed: R160.2, R161.1
unnamed: R162.2, R163.1

Notes on the sheet:
SAFETY & DISCHARGE SPECIFICATIONS:
STAGE 2 (+5.6 kV)
STAGE 3 (+8.4 kV)
STAGE 4 (+11.2 kV)
STAGE 6 (+16.8 kV)
2. BLEEDERS: 12 banks x 2 series 100M / 3kV 2512 (R140-R163); each bank is 200M. Verify <50V discharge on assembled hardware.
STAGE 1 (+2.8 kV)
3. CLEARANCE: Minimum 4.0 mm clearance maintained between adjacent stages; all inner copper planes removed beneath ladder.
6-STAGE POSITIVE COCKCROFT-WALTON VOLTAGE MULTIPLIER & PASSIVE BLEEDERS
1. Nominal open-circuit output voltage: ~17 kV DC (regulated by MCU PWM duty cycle to +10 kV .. +15 kV DC).
STAGE 5 (+14.0 kV)

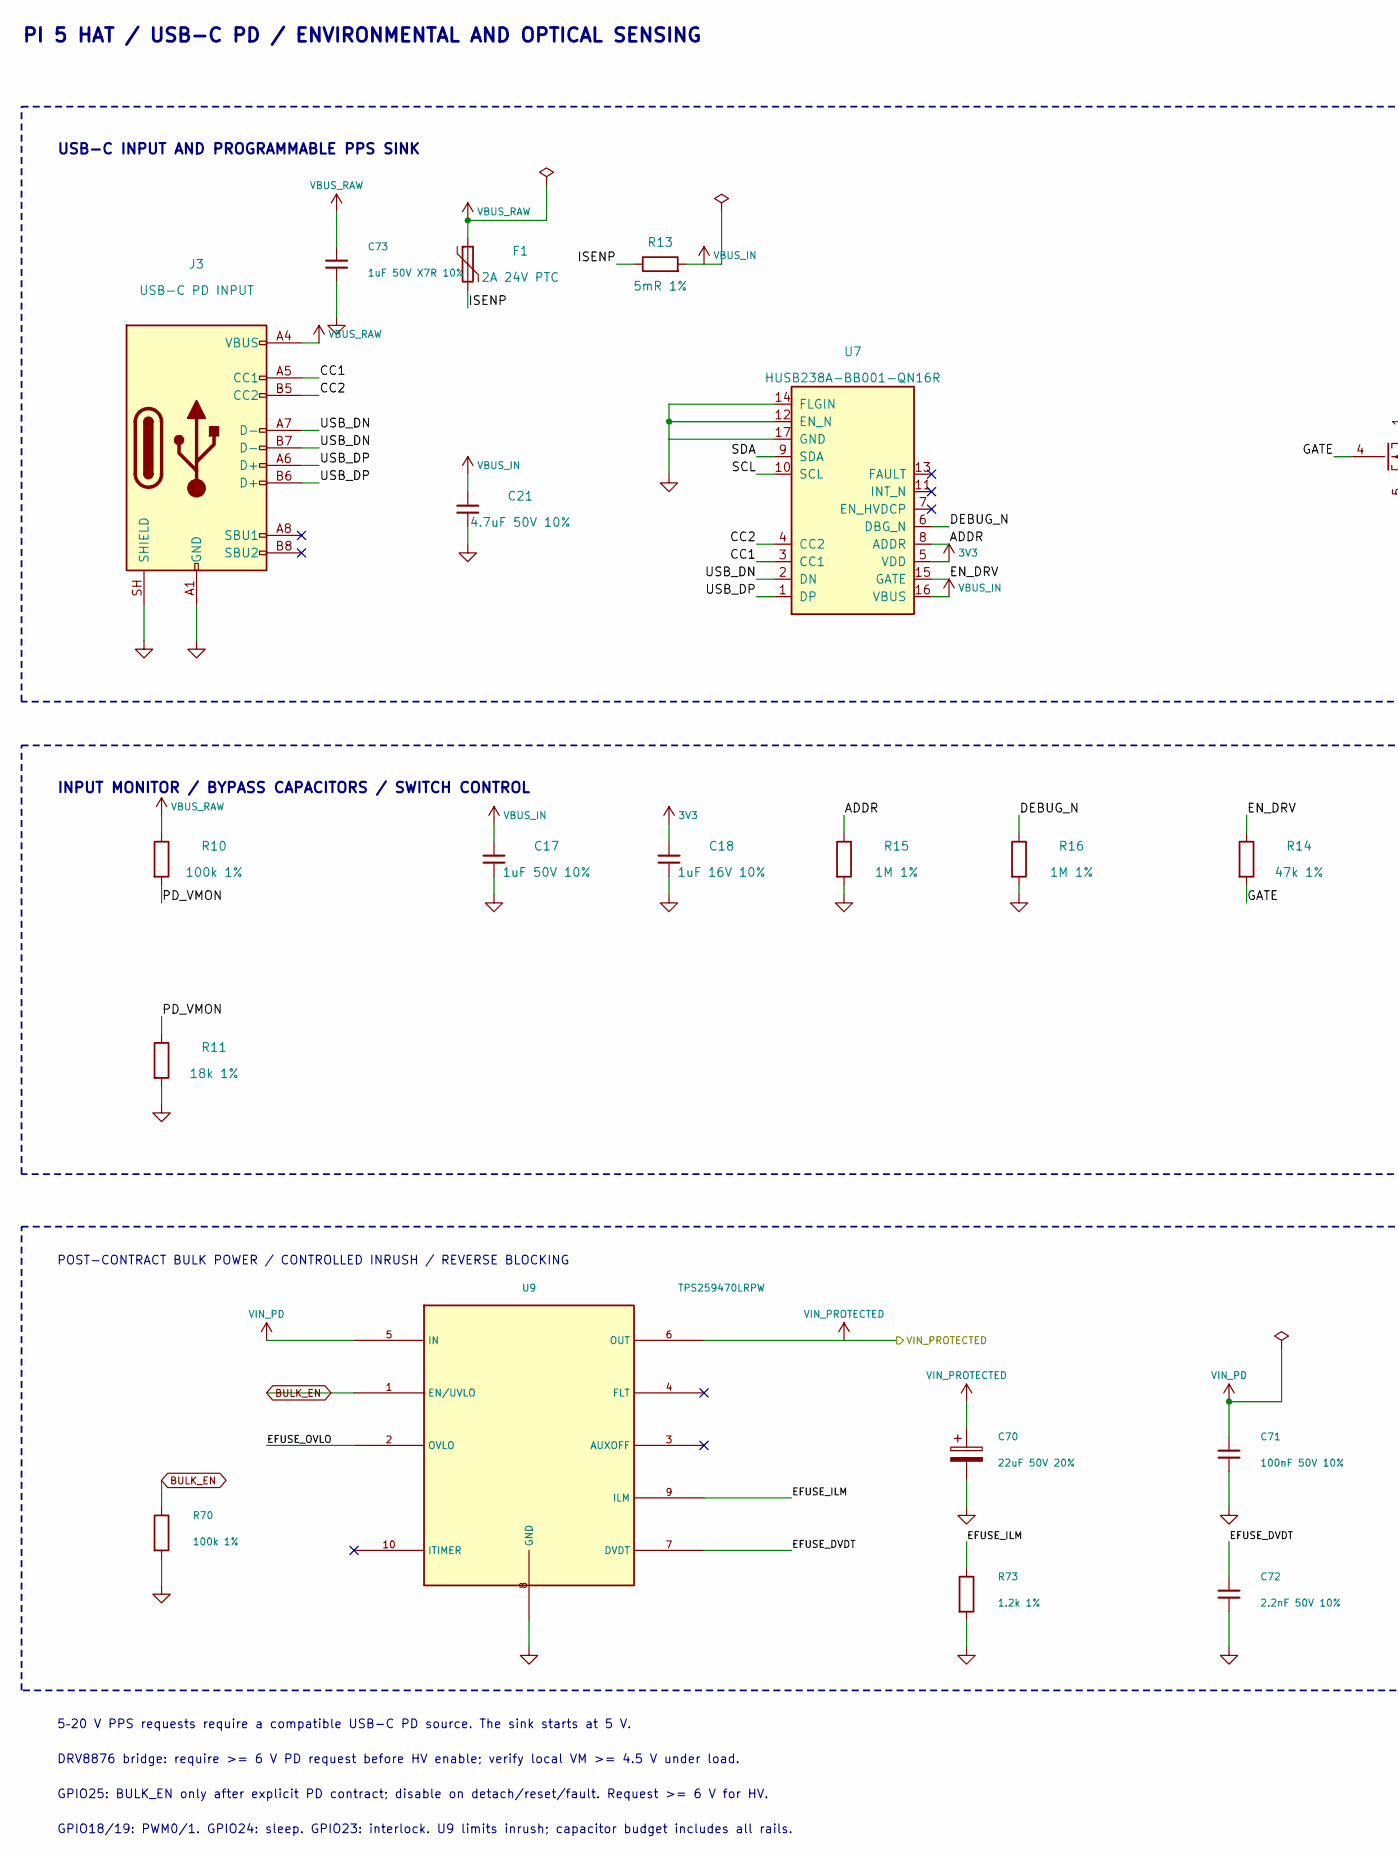
[picture p61: schematic 01_power_mcu.kicad_sch, 01 Power Input, Raspberry Pi 5 HAT & Sensors, part in row 1, column 1]

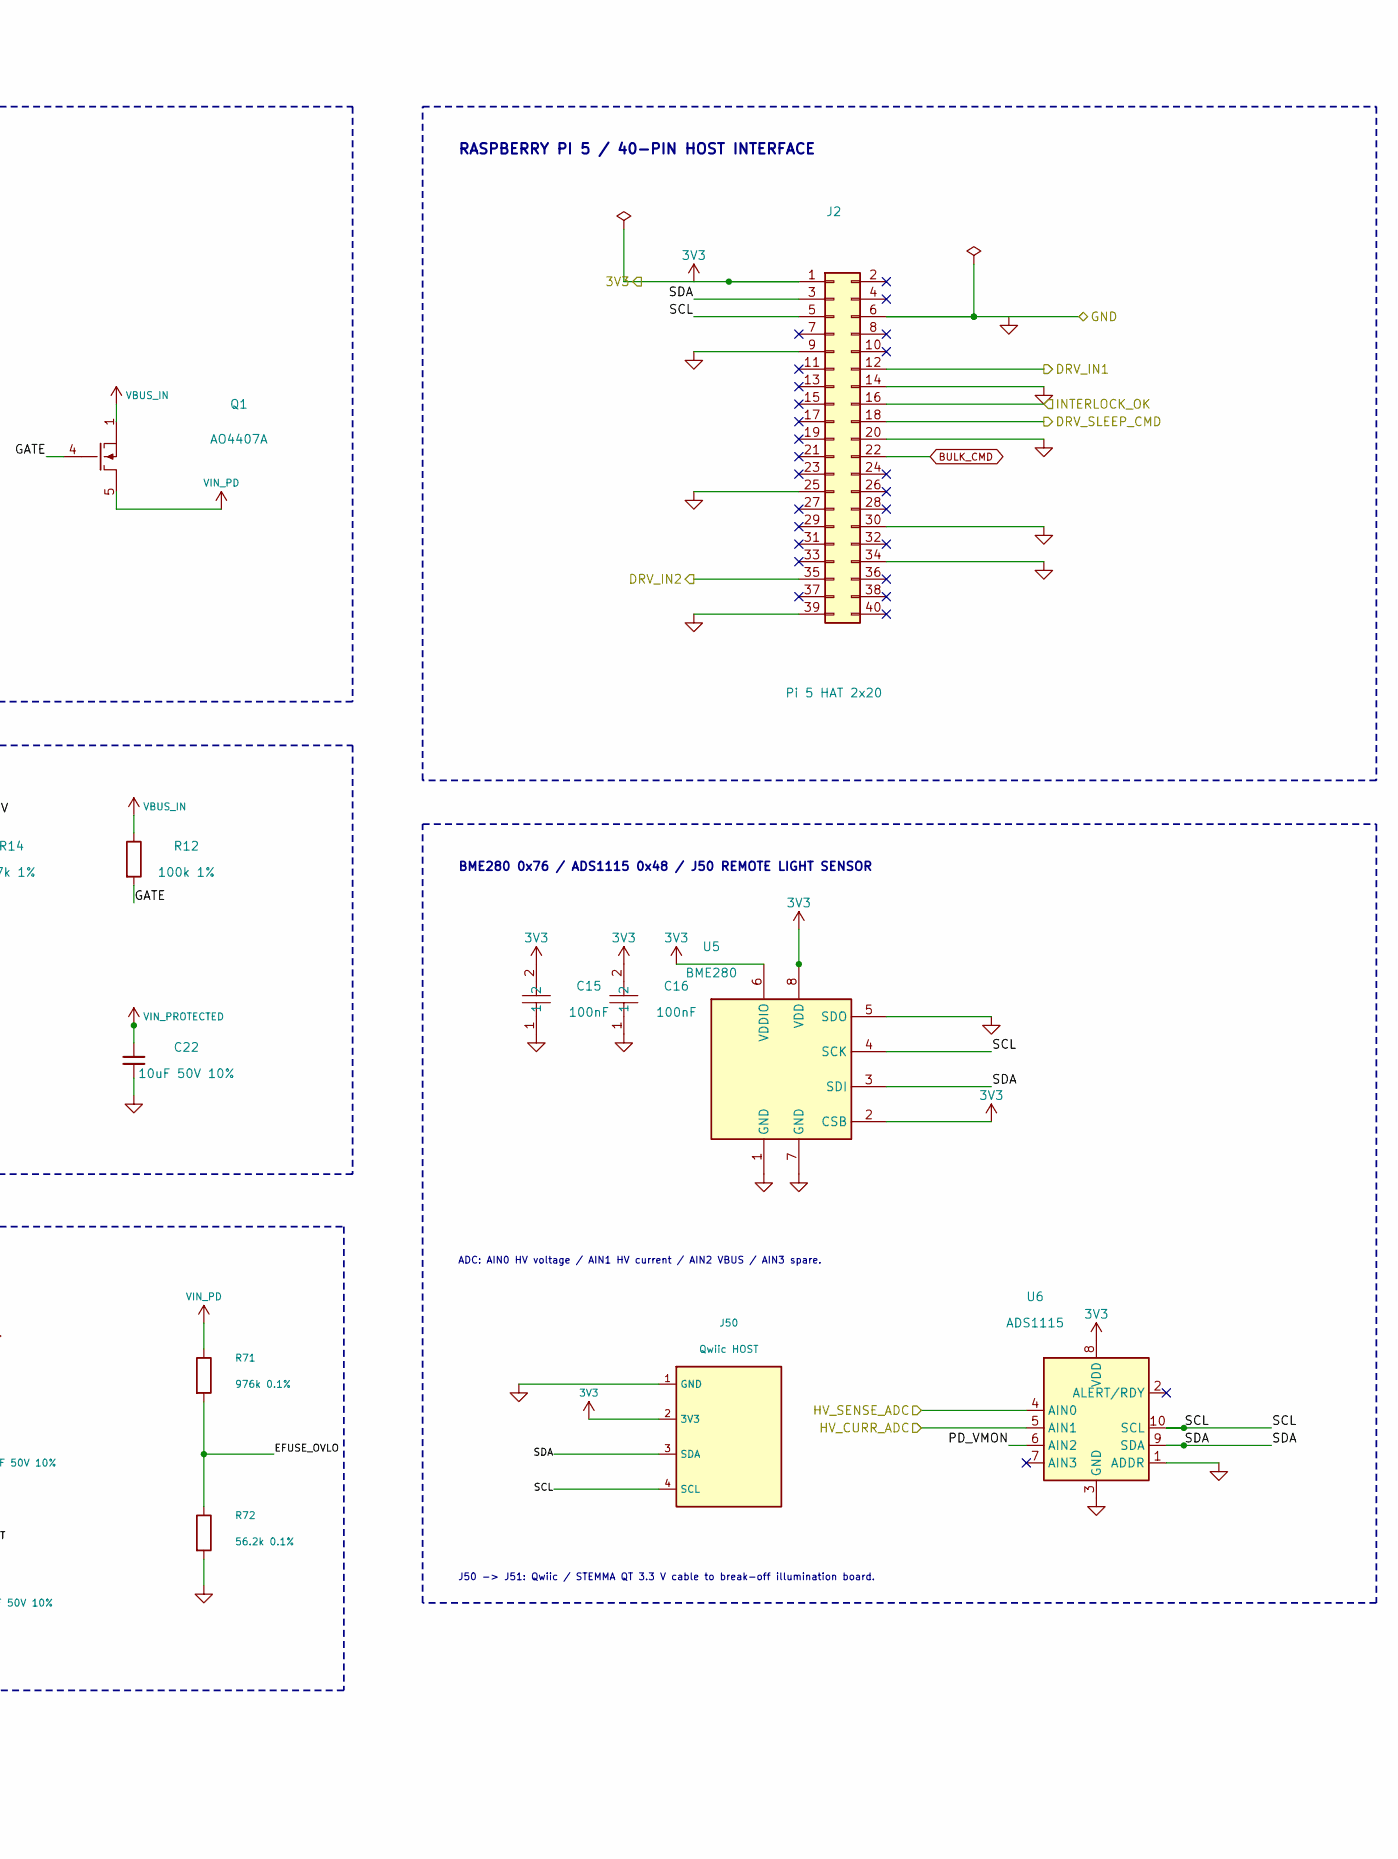
[picture p62: schematic 01_power_mcu.kicad_sch, 01 Power Input, Raspberry Pi 5 HAT & Sensors, part in row 1, column 2]

Parts:
C15, C16: 100nF; C0603; MPN CC0603KRX7R9BB104; LCSC C14663
C17: 1uF 50V 10%; C_0603_1608Metric; MPN CL10B105KB8NQNC; LCSC C5199872
C18: 1uF 16V 10%; C_0603_1608Metric; MPN CL10A105KA8NNNC; LCSC C15849
C21: 4.7uF 50V 10%; C_1210_3225Metric; MPN GCM32ER71H475KA55L; LCSC C126618
C22: 10uF 50V 10%; C_1210_3225Metric; MPN UMK325AB7106KMHP; LCSC C386166
C70: 22uF 50V 20%; CP_Radial_D5.0mm_P2.00mm; MPN 50YXF22MEFC5X11; LCSC C88755
C71: 100nF 50V 10%; C_0603_1608Metric; MPN CC0603KRX7R9BB104; LCSC C14663
C72: 2.2nF 50V 10%; C_0603_1608Metric; MPN 0603B222K500NT; LCSC C1604
C73: 1uF 50V X7R 10%; C_0603_1608Metric; MPN CL10B105KB8NQNC; LCSC C5199872
F1: 2A 24V PTC; Fuse_1206_3216Metric; MPN 1206L200/24NR; LCSC C42396578
J2: Pi 5 HAT 2x20; PinSocket_2x20_P2.54mm_Vertical; MPN 2.54-2*20; LCSC C2977589
J3: USB-C PD INPUT; USB_C_Receptacle_HRO_TYPE-C-31-M-12; MPN TYPE-C-31-M-12; LCSC C165948
J50: Qwiic HOST; JST_SH_SM04B-SRSS-TB_1x04-1MP_P1.00mm_Horizontal; MPN SM04B-SRSS-TB(LF)(SN); LCSC C160404
Q1: AO4407A; SO-8_3.9x4.9mm_P1.27mm; MPN AO4407A; LCSC C16072
R10, R12, R70: 100k 1%; R_0603_1608Metric; MPN 0603WAF1003T5E; LCSC C25803
R11: 18k 1%; R_0603_1608Metric; MPN 0603WAF1802T5E; LCSC C25810
R13: 5mR 1%; R_2512_6332Metric; MPN RLP25FEGMR005; LCSC C393074
R14: 47k 1%; R_0603_1608Metric; MPN 0603WAF4702T5E; LCSC C25816
R15, R16: 1M 1%; R_0603_1608Metric; MPN 0603WAF1004T5E; LCSC C22935
R71: 976k 0.1%; R_0805_2012Metric; MPN RT0805BRD07976KL; LCSC C865713
R72: 56.2k 0.1%; R_0603_1608Metric; MPN RT0603BRD0756K2L; LCSC C705784
R73: 1.2k 1%; R_0603_1608Metric; MPN 0603WAF1201T5E; LCSC C22765
U5: BME280; Bosch_LGA-8_2.5x2.5mm_P0.65mm_ClockwisePinNumbering; MPN BME280; LCSC C92489
U6: ADS1115; TSSOP-10_3x3mm_P0.5mm; MPN ADS1115IDGSR; LCSC C37593
U7: HUSB238A-BB001-QN16R; QFN-16-1EP_3x3mm_P0.5mm_EP1.7x1.7mm; MPN HUSB238A-BB001-QN16R; LCSC C24833806
U9: TPS259470LRPW; Texas_RPW0010A_VQFN-HR-10_2x2mm; MPN TPS259470LRPWR; LCSC C3662793

Connections:
3V3: C15.2, C16.2, C18.1, J2.1, J50.2 (3V3), U5.2 (CSB), U5.6 (VDDIO), U5.8 (VDD), U6.8 (VDD), U7.5 (VDD); also elsewhere on the board
/01_power_mcu/ADDR: R15.1, U7.8 (ADDR)
/01_power_mcu/CC1: J3.A5 (CC1), U7.3 (CC1)
/01_power_mcu/CC2: J3.B5 (CC2), U7.4 (CC2)
/01_power_mcu/DEBUG_N: R16.1, U7.6 (DBG_N)
/01_power_mcu/EFUSE_DVDT: C72.1, U9.7 (DVDT)
/01_power_mcu/EFUSE_FLT: J2.31, U9.4 (FLT); also elsewhere on the board
/01_power_mcu/EFUSE_ILM: R73.1, U9.9 (ILM)
/01_power_mcu/EFUSE_OVLO: R71.2, R72.1, U9.2 (OVLO)
/01_power_mcu/EN_DRV: R14.1, U7.15 (GATE)
/01_power_mcu/GATE: Q1.4 (G), R12.2, R14.2
/01_power_mcu/ISENP: F1.2, R13.1; also elsewhere on the board
/01_power_mcu/PD_VMON: R10.2, R11.1, U6.6 (AIN2)
/01_power_mcu/SCL: J2.5, J50.4 (SCL), U5.4 (SCK), U6.10 (SCL), U7.10 (SCL)
/01_power_mcu/SDA: J2.3, J50.3 (SDA), U5.3 (SDI), U6.9 (SDA), U7.9 (SDA)
/01_power_mcu/USB_DN: J3.A7 (D-), J3.B7 (D-), U7.2 (DN)
/01_power_mcu/USB_DP: J3.A6 (D+), J3.B6 (D+), U7.1 (DP)
/01_power_mcu/VBUS_IN: C17.1, C21.1, Q1.1 (S), Q1.2 (S), Q1.3 (S), R12.1, R13.2, U7.16 (VBUS); also elsewhere on the board
/01_power_mcu/VBUS_RAW: C73.1, F1.1, J3.A4 (VBUS), J3.A9 (VBUS), J3.B4 (VBUS), J3.B9 (VBUS), R10.1
/01_power_mcu/VIN_PD: C71.1, Q1.5 (D), Q1.6 (D), Q1.7 (D), Q1.8 (D), R71.1, U9.5 (IN)
/DRV_IN1: J2.12; also elsewhere on the board
/DRV_IN2: J2.35; also elsewhere on the board
/DRV_SLEEP_CMD: J2.18; also elsewhere on the board
/HV_CURR_ADC: U6.5 (AIN1); also elsewhere on the board
/HV_SENSE_ADC: U6.4 (AIN0); also elsewhere on the board
/INTERLOCK_OK: J2.16; also elsewhere on the board
/VIN_PROTECTED: C22.1, C70.1, U9.6 (OUT); also elsewhere on the board
BRIDGE_VMON: U6.7 (AIN3); also elsewhere on the board
BULK_CMD: J2.22; also elsewhere on the board
BULK_EN: R70.1, U9.1 (EN/UVLO); also elsewhere on the board
DRV_nFAULT: J2.29; also elsewhere on the board
GND: C15.1, C16.1, C17.2, C18.2, C21.2, C22.2, C70.2, C71.2, C72.2, C73.2, J2.6, J2.9, J2.14, J2.20, J2.25, J2.30, J2.34, J2.39, J3.A1 (GND), J3.A12 (GND), J3.B1 (GND), J3.B12 (GND), J3.SH (SHIELD), J50.1 (GND), R11.2, R15.2, R16.2, R70.2, R72.2, R73.2, U5.1 (GND), U5.5 (SDO), U5.7 (GND), U6.1 (ADDR), U6.3 (GND), U7.12 (EN_N), U7.14 (FLGIN), U7.17 (GND), U9.8 (GND); also elsewhere on the board
HV_OV_TRIP_GPIO: J2.37; also elsewhere on the board

Notes on the sheet:
DRV8876 bridge: require >= 6 V PD request before HV enable; verify local VM >= 4.5 V under load.
USB-C INPUT AND PROGRAMMABLE PPS SINK
RASPBERRY PI 5 / 40-PIN HOST INTERFACE
POST-CONTRACT BULK POWER / CONTROLLED INRUSH / REVERSE BLOCKING
GPIO18/19: PWM0/1. GPIO24: sleep. GPIO23: interlock. U9 limits inrush; capacitor budget includes all rails.
5–20 V PPS requests require a compatible USB-C PD source. The sink starts at 5 V.
PI 5 HAT / USB-C PD / ENVIRONMENTAL AND OPTICAL SENSING
ADC: AIN0 HV voltage / AIN1 HV current / AIN2 VBUS / AIN3 spare.
INPUT MONITOR / BYPASS CAPACITORS / SWITCH CONTROL
GPIO25: BULK_EN only after explicit PD contract; disable on detach/reset/fault. Request >= 6 V for HV.
BME280 0x76 / ADS1115 0x48 / J50 REMOTE LIGHT SENSOR
J50 -> J51: Qwiic / STEMMA QT 3.3 V cable to break-off illumination board.
