uge/ew-1/hardware/pi5_corona_hat_direct/pi5_corona_hv.kicad_pcb

## KiCad design hardware/pi5_corona_hat_direct/pi5_corona_hv.kicad_pcb (continued)

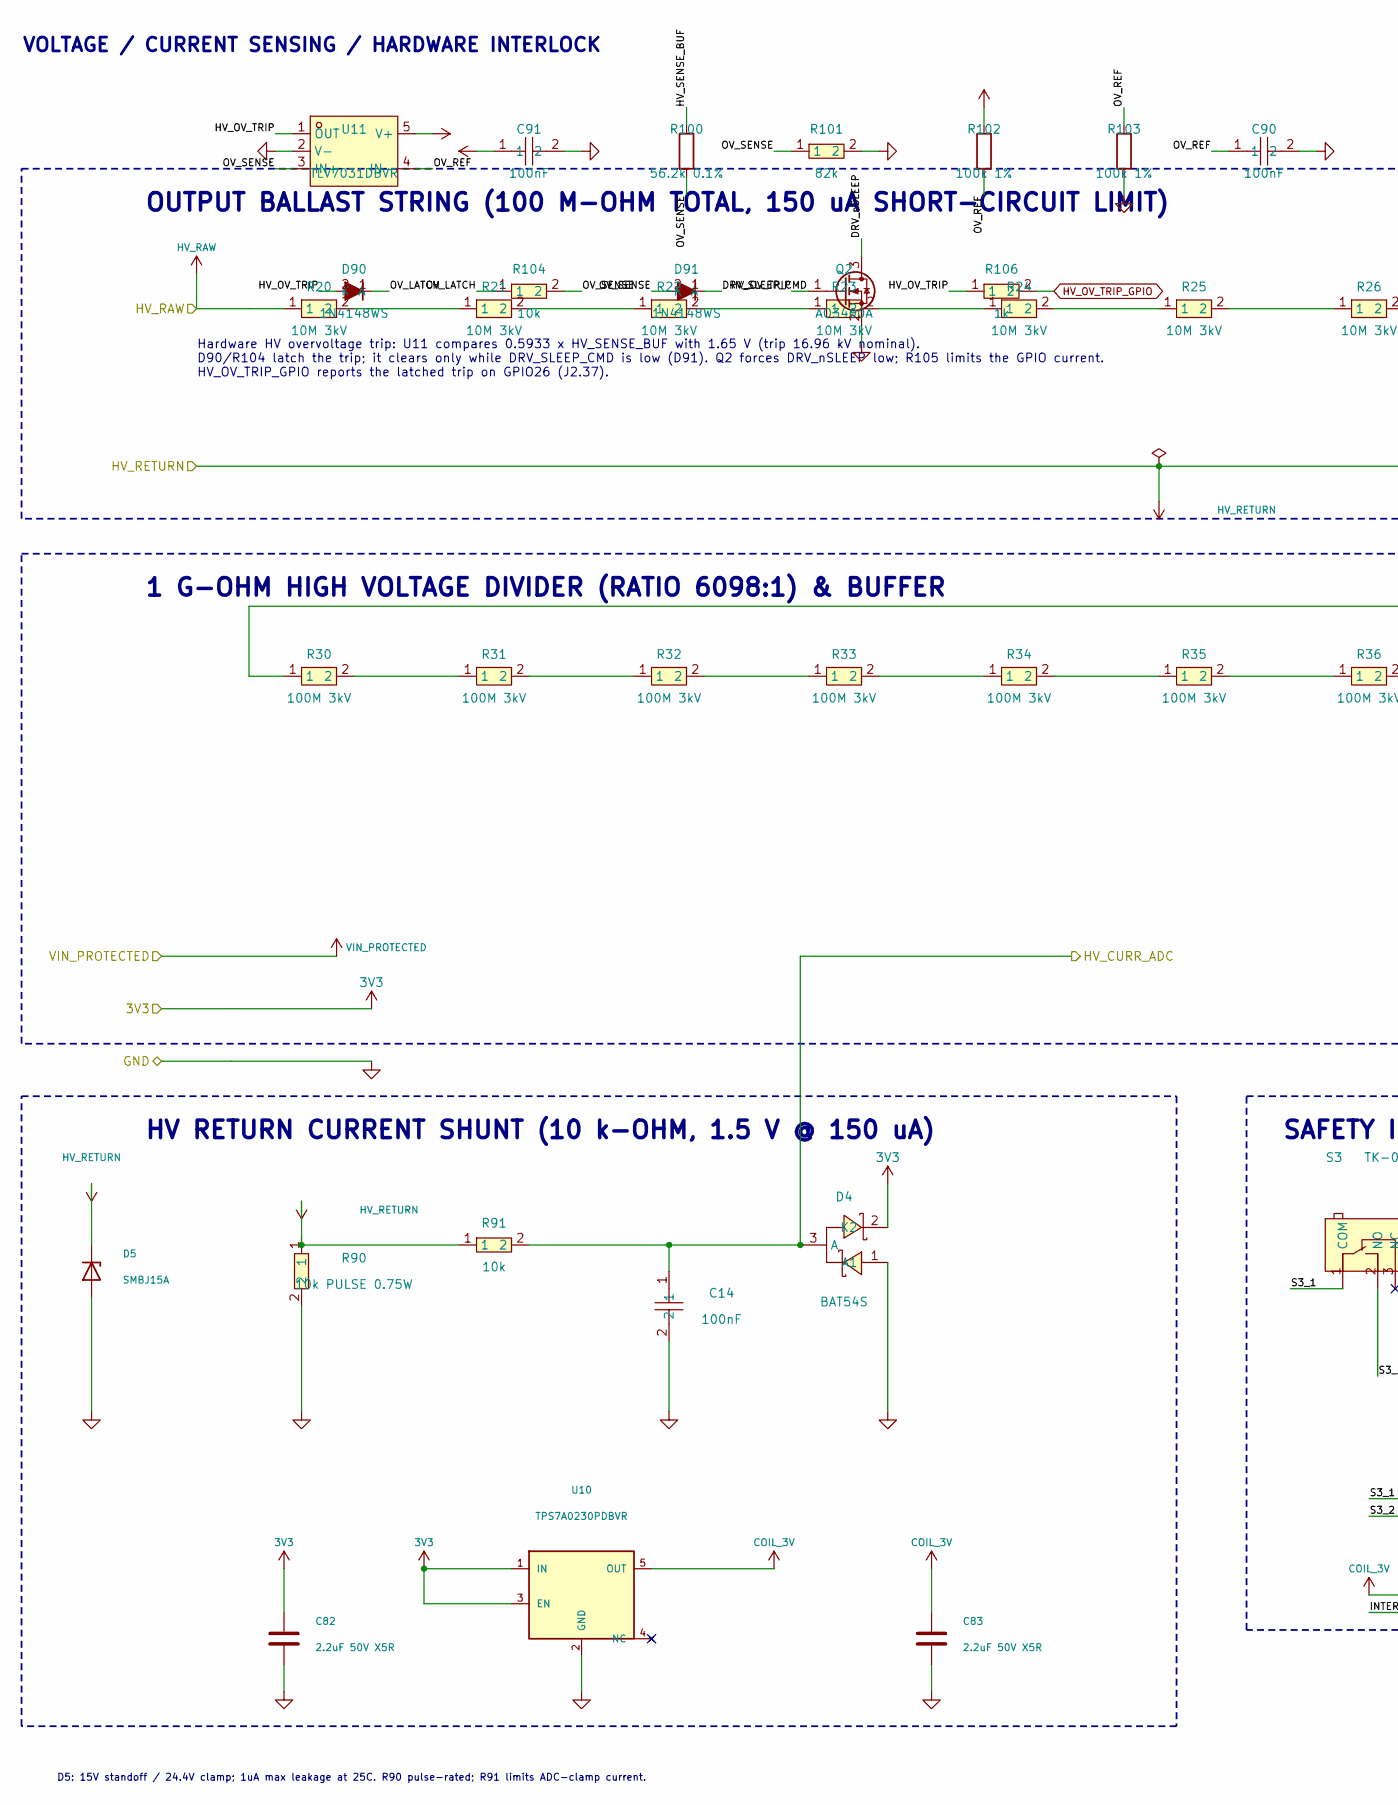
[picture p63: schematic 04_sense_safety.kicad_sch, 04 Ballast, Divider, Sensing & Hardware Interlock, part in row 1, column 1]

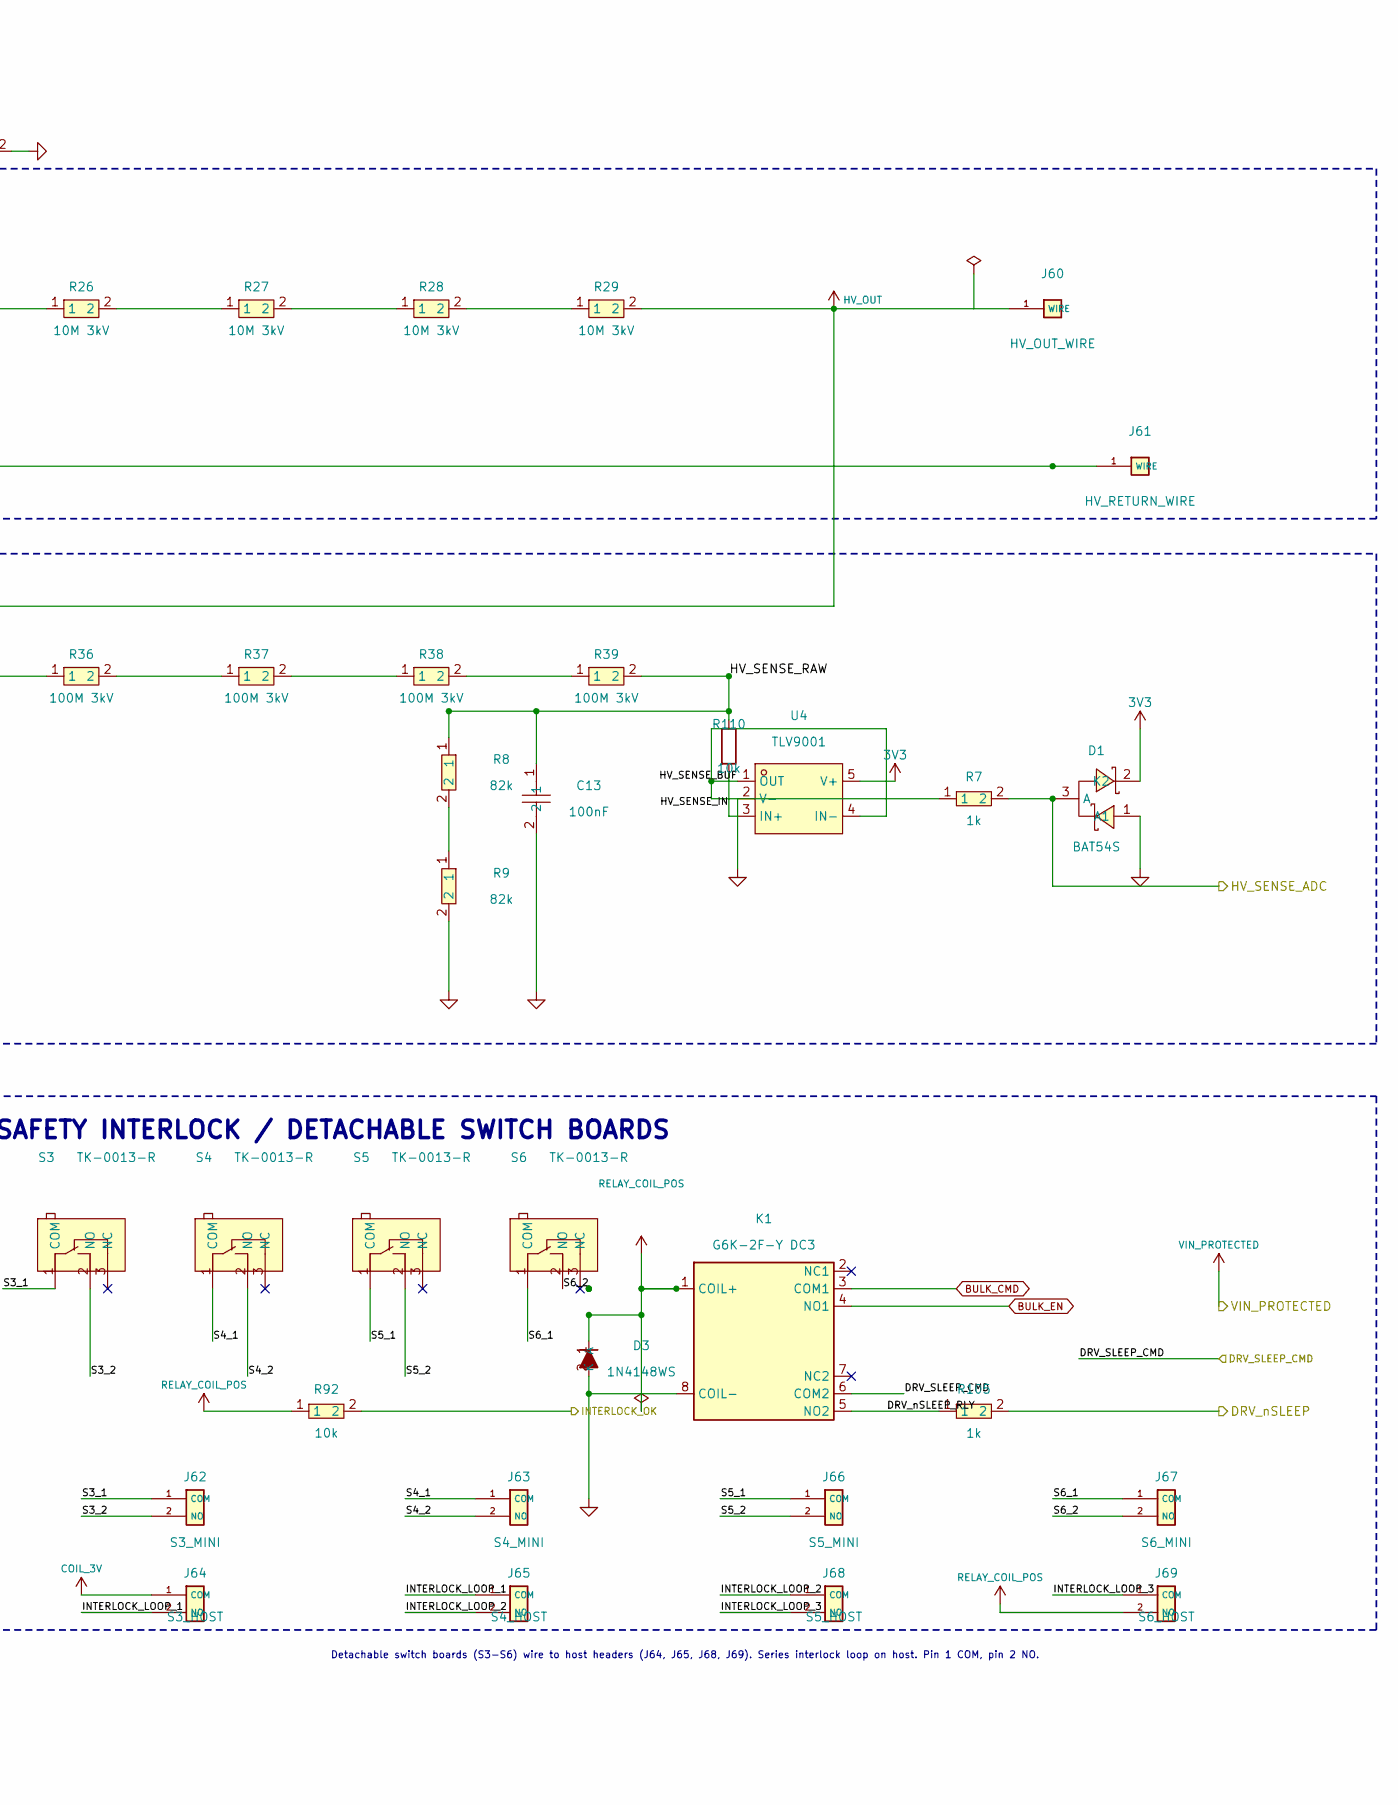
[picture p64: schematic 04_sense_safety.kicad_sch, 04 Ballast, Divider, Sensing & Hardware Interlock, part in row 1, column 2]

Parts:
C13, C14, C90, C91: 100nF; C0603; MPN CC0603KRX7R9BB104; LCSC Part C14663
C82, C83: 2.2uF 50V X5R; C_0805_2012Metric; MPN CL21A225KBQNNNE; LCSC C377773
D1, D4: BAT54S; SOT-23-3_L2.9-W1.3-P1.90-LS2.4-BR; MPN BAT54S; LCSC Part C83935
D3, D90, D91: 1N4148WS; D_SOD-323; MPN 1N4148WS; LCSC Part C2128
D5: SMBJ15A; D_SMB; MPN SMBJ15A; LCSC C2912077
J60: HV_OUT_WIRE; HV_Wire_Termination_1P; JLCPCB Library PCB feature
J61: HV_RETURN_WIRE; HV_Wire_Termination_1P; JLCPCB Library PCB feature
J62: S3_MINI; Solder_Pads_2P_P5.08; JLCPCB Library PCB feature
J63: S4_MINI; Solder_Pads_2P_P5.08; JLCPCB Library PCB feature
J64: S3_HOST; Solder_Pads_2P_P5.08; JLCPCB Library PCB feature
J65: S4_HOST; Solder_Pads_2P_P5.08; JLCPCB Library PCB feature
J66: S5_MINI; Solder_Pads_2P_P5.08; JLCPCB Library PCB feature
J67: S6_MINI; Solder_Pads_2P_P5.08; JLCPCB Library PCB feature
J68: S5_HOST; Solder_Pads_2P_P5.08; JLCPCB Library PCB feature
J69: S6_HOST; Solder_Pads_2P_P5.08; JLCPCB Library PCB feature
K1: G6K-2F-Y DC3; Relay_DPDT_Omron_G6K-2F-Y; MPN G6K-2F-Y DC3; LCSC Part C93168
Q2: AO3400A; SOT-23; MPN AO3400A; LCSC Part C20917
R7, R105, R106: 1k; R0603; MPN 0603WAF1001T5E; LCSC Part C21190
R8, R9, R101: 82k; R0603; MPN 0603WAF8202T5E; LCSC Part C23254
R20, R21, R22, R23, R24, R25, R26, R27, R28, R29: 10M 3kV; R_2512_6332Metric; MPN CHV2512-JW-106ELF; LCSC Part C2095568
R30, R31, R32, R33, R34, R35, R36, R37, R38, R39: 100M 3kV; R_2512_6332Metric; MPN CHV2512-JW-107ELF; LCSC Part C2089706
R90: 10k PULSE 0.75W; R_1206_3216Metric; MPN CRCW120610K0FKEAHP; LCSC Part C313977
R91, R92, R104: 10k; R0603; MPN 0603WAF1002T5E; LCSC Part C25804
R100: 56.2k 0.1%; R_0603_1608Metric; MPN RT0603BRD0756K2L; LCSC Part C705784
R102, R103: 100k 1%; R_0603_1608Metric; MPN 0603WAF1003T5E; LCSC Part C25803
R110: 10k; R_0603_1608Metric; MPN 0603WAF1002T5E; LCSC Part C25804
S3, S4, S5, S6: TK-0013-R; SW_TK-0013-R; MPN TK-0013-R; LCSC Part C19724218
U4: TLV9001; SOT-23-5_L3.0-W1.7-P0.95-LS2.8-BR; MPN TLV9001IDBVR; LCSC Part C398363
U10: TPS7A0230PDBVR; SOT-23-5; MPN TPS7A0230PDBVR; LCSC C3747031
U11: TLV7031DBVR; SOT-23-5_L3.0-W1.7-P0.95-LS2.8-BR; MPN TLV7031DBVR; LCSC Part C2869832

Connections:
3V3: C82.1, C91.1, D1.2 (K2), D4.2 (K2), R102.1, U4.5 (V+), U10.1 (IN), U10.3 (EN), U11.5 (V+); also elsewhere on the board
/04_sense_safety/DRV_nSLEEP_RLY: K1.5 (NO2), R105.1
/04_sense_safety/HV_OUT: J60.1, R29.2, R30.1
/04_sense_safety/HV_OV_TRIP: D90.2 (A), Q2.1 (G), R106.1, U11.1 (OUT)
/04_sense_safety/HV_SENSE_BUF: R7.1, R100.1, U4.1 (OUT), U4.4 (IN-)
/04_sense_safety/HV_SENSE_IN: R110.2, U4.3 (IN+)
/04_sense_safety/HV_SENSE_RAW: C13.1, R8.1, R39.2, R110.1
/04_sense_safety/INTERLOCK_LOOP_1: J64.2 (NO), J65.1 (COM)
/04_sense_safety/INTERLOCK_LOOP_2: J65.2 (NO), J68.1 (COM)
/04_sense_safety/INTERLOCK_LOOP_3: J68.2 (NO), J69.1 (COM)
/04_sense_safety/OV_LATCH: D90.1 (K), R104.1
/04_sense_safety/OV_REF: C90.1, R102.2, R103.1, U11.4 (IN-)
/04_sense_safety/OV_SENSE: D91.2 (A), R100.2, R101.1, R104.2, U11.3 (IN+)
/04_sense_safety/RELAY_COIL_POS: D3.1 (K), J69.2 (NO), K1.1 (COIL+), R92.1
/04_sense_safety/S3_1: J62.1 (COM), S3.1 (COM)
/04_sense_safety/S3_2: J62.2 (NO), S3.2 (NO)
/04_sense_safety/S4_1: J63.1 (COM), S4.1 (COM)
/04_sense_safety/S4_2: J63.2 (NO), S4.2 (NO)
/04_sense_safety/S5_1: J66.1 (COM), S5.1 (COM)
/04_sense_safety/S5_2: J66.2 (NO), S5.2 (NO)
/04_sense_safety/S6_1: J67.1 (COM), S6.1 (COM)
/04_sense_safety/S6_2: J67.2 (NO), S6.2 (NO)
/DRV_SLEEP_CMD: D91.1 (K), K1.6 (COM2); also elsewhere on the board
/DRV_nSLEEP: Q2.3 (D), R105.2; also elsewhere on the board
/HV_CURR_ADC: C14.1, D4.3 (A), R91.2; also elsewhere on the board
/HV_RAW: R20.1; also elsewhere on the board
/HV_RETURN: D5.1 (K), J61.1, R90.1, R91.1
/HV_SENSE_ADC: D1.3 (A), R7.2; also elsewhere on the board
/INTERLOCK_OK: R92.2; also elsewhere on the board
BULK_CMD: K1.3 (COM1); also elsewhere on the board
BULK_EN: K1.4 (NO1); also elsewhere on the board
COIL_3V: C83.1, J64.1 (COM), U10.5 (OUT)
GND: C13.2, C14.2, C82.2, C83.2, C90.2, C91.2, D1.1 (A1), D3.2 (A), D4.1 (A1), D5.2 (A), K1.8 (COIL-), Q2.2 (S), R9.2, R90.2, R101.2, R103.2, U4.2 (V-), U10.2 (GND), U11.2 (V-); also elsewhere on the board
HV_OV_TRIP_GPIO: R106.2; also elsewhere on the board
unnamed: R8.2, R9.1
unnamed: R20.2, R21.1
unnamed: R21.2, R22.1
unnamed: R22.2, R23.1
unnamed: R23.2, R24.1
unnamed: R24.2, R25.1
unnamed: R25.2, R26.1
unnamed: R26.2, R27.1
unnamed: R27.2, R28.1
unnamed: R28.2, R29.1
unnamed: R30.2, R31.1
unnamed: R31.2, R32.1
unnamed: R32.2, R33.1
unnamed: R33.2, R34.1
unnamed: R34.2, R35.1
unnamed: R35.2, R36.1
unnamed: R36.2, R37.1
unnamed: R37.2, R38.1
unnamed: R38.2, R39.1

Notes on the sheet:
VOLTAGE / CURRENT SENSING / HARDWARE INTERLOCK
HV RETURN CURRENT SHUNT (10 k-OHM, 1.5 V @ 150 uA)
1 G-OHM HIGH VOLTAGE DIVIDER (RATIO 6098:1) & BUFFER
Detachable switch boards (S3-S6) wire to host headers (J64, J65, J68, J69). Series interlock loop on host. Pin 1 COM, pin 2 NO.
SAFETY INTERLOCK / DETACHABLE SWITCH BOARDS
D5: 15V standoff / 24.4V clamp; 1uA max leakage at 25C. R90 pulse-rated; R91 limits ADC-clamp current.
OUTPUT BALLAST STRING (100 M-OHM TOTAL, 150 uA SHORT-CIRCUIT LIMIT)
Hardware HV overvoltage trip: U11 compares 0.5933 x HV_SENSE_BUF with 1.65 V (trip 16.96 kV nominal). D90/R104 latch the trip; it clears only while DRV_SLEEP_CMD is low (D91). Q2 forces DRV_nSLEEP low; R105 limits the GPIO current. HV_OV_TRIP_GPIO reports the latched trip on GPIO26 (J2.37).

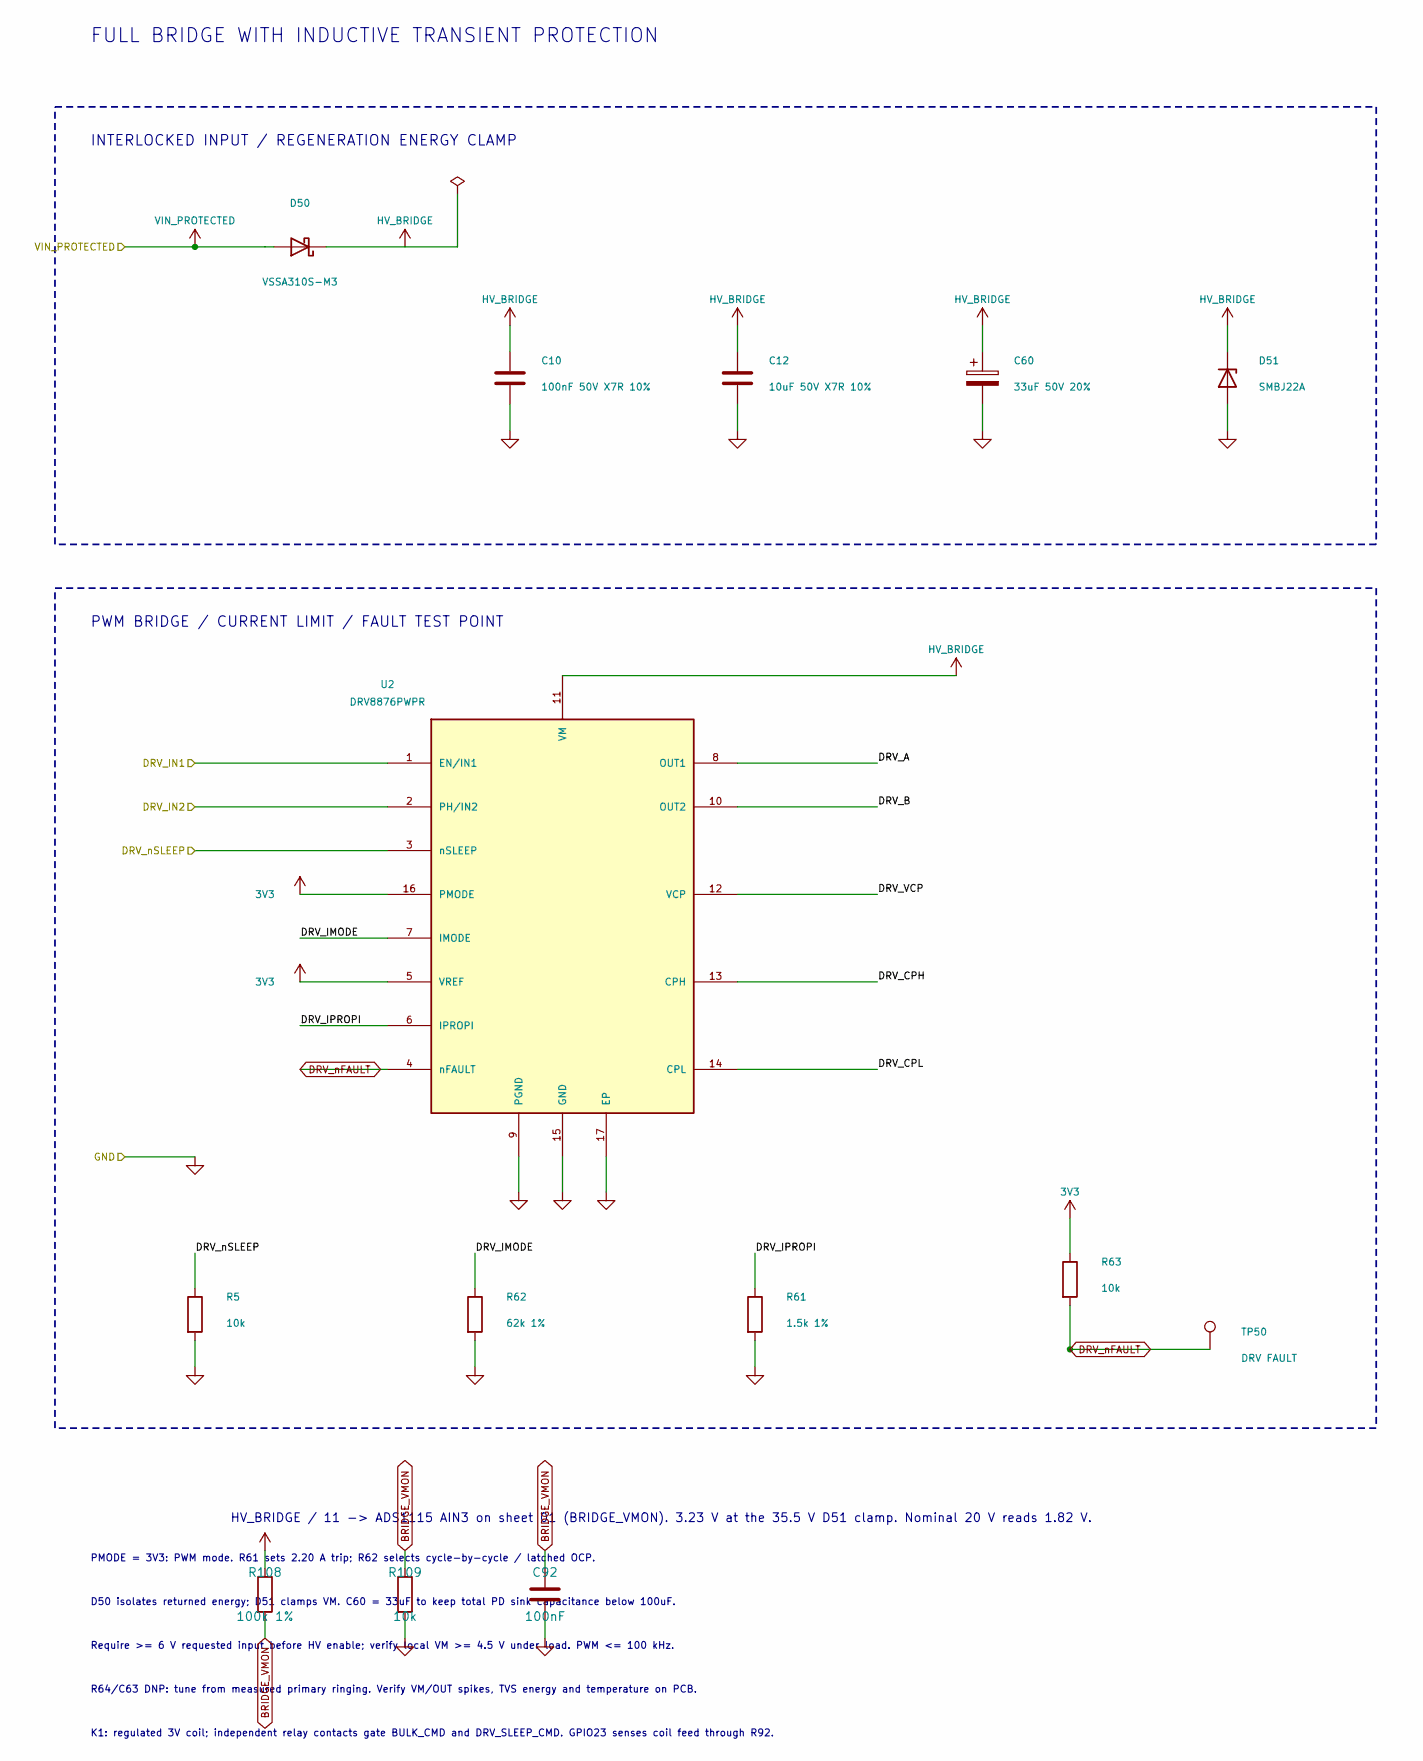
[picture p65: schematic 02_drive_transformer.kicad_sch, 02 Isolated AC Generation & Resonance Tank, part in row 1, column 1]

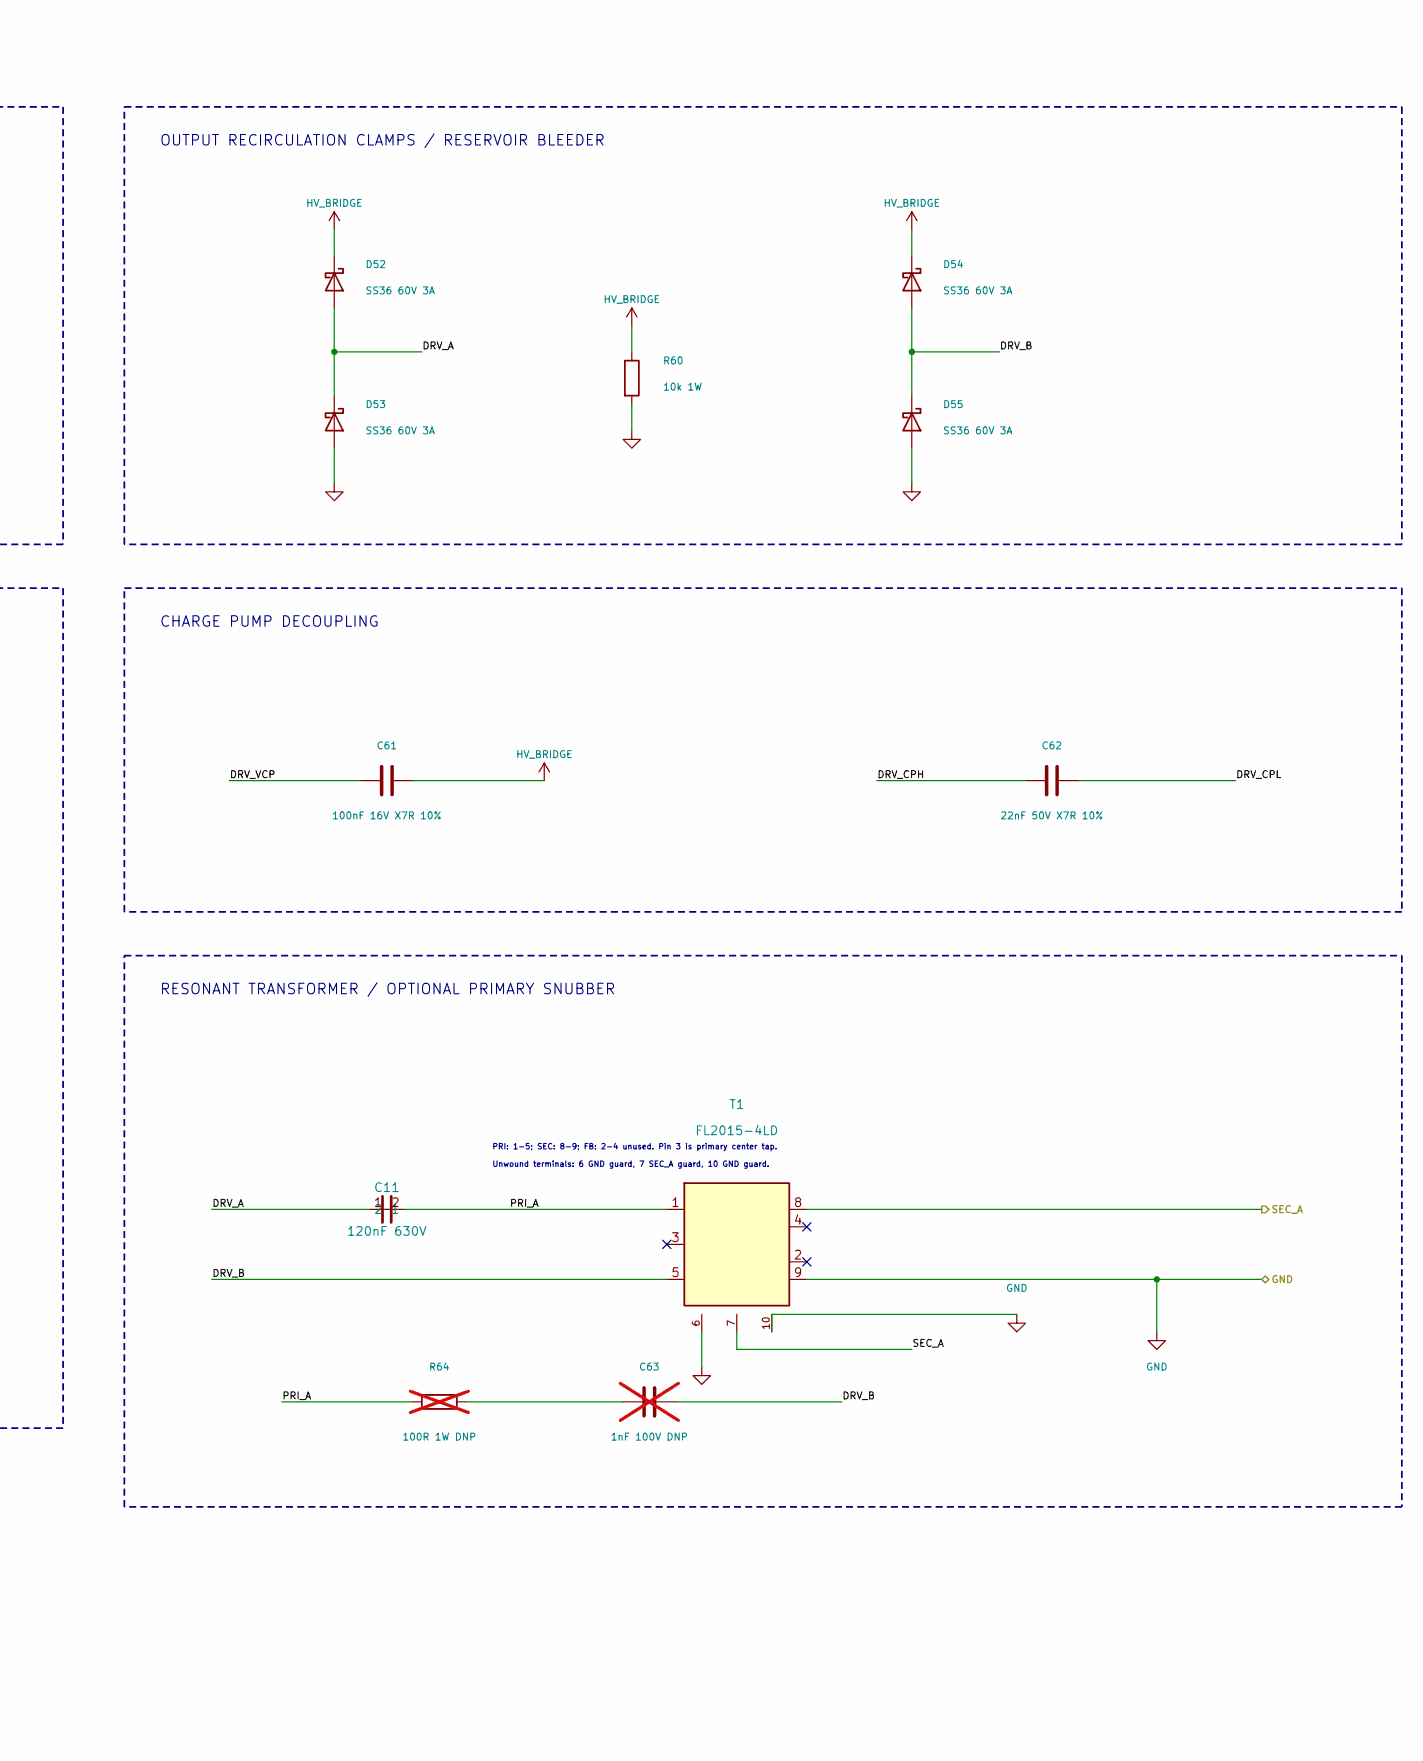
[picture p66: schematic 02_drive_transformer.kicad_sch, 02 Isolated AC Generation & Resonance Tank, part in row 1, column 2]

Parts:
C10: 100nF 50V X7R 10%; C_0603_1608Metric; MPN CC0603KRX7R9BB104; LCSC C14663
C11: 120nF 630V; Film_KYET_18x10mm_P15mm; MPN MMKP124J2J1501; LCSC Part C2991056
C12: 10uF 50V X7R 10%; C_1210_3225Metric; MPN UMK325AB7106KMHP; LCSC C386166
C60: 33uF 50V 20%; CP_Radial_D5.0mm_P2.00mm; MPN 50YXJ33M5X11; LCSC C2839476
C61: 100nF 16V X7R 10%; C_0603_1608Metric; MPN CC0603KRX7R9BB104; LCSC C14663
C62: 22nF 50V X7R 10%; C_0603_1608Metric; MPN CL10B223KB8NNNC; LCSC C21122
C63: 1nF 100V DNP; C_0805_2012Metric; MPN GRM2165C2A102JA01D; LCSC C162289; not fitted
C92: 100nF; C_0603_1608Metric; MPN CC0603KRX7R9BB104; LCSC Part C14663
D50: VSSA310S-M3; D_SMA; MPN VSSA310S-M3/61T; LCSC C145232
D51: SMBJ22A; D_SMB; MPN SMBJ22A; LCSC C49066946
D52, D53, D54, D55: SS36 60V 3A; D_SMC; MPN SS36C; LCSC C16237
R5, R63: 10k; R_0603_1608Metric; MPN 0603WAF1002T5E; LCSC C25804
R60: 10k 1W; R_2512_6332Metric; MPN 25121WF1002T4E; LCSC C270956
R61: 1.5k 1%; R_0603_1608Metric; MPN 0603WAF1501T5E; LCSC C22843
R62: 62k 1%; R_0603_1608Metric; MPN 0603WAF6202T5E; LCSC C23221
R64: 100R 1W DNP; R_2512_6332Metric; MPN 25121WF1000T4E; LCSC C35218; not fitted
R108: 100k 1%; R_0603_1608Metric; MPN 0603WAF1003T5E; LCSC Part C25803
R109: 10k; R_0603_1608Metric; MPN 0603WAF1002T5E; LCSC Part C25804
T1: FL2015-4LD; Coilcraft_FL2015_Package1_SMT; MPN FL2015-4LD; JLCPCB Library Unknown
TP50: DRV FAULT; TestPoint_Pad_D1.5mm; JLCPCB Library Unknown
U2: DRV8876PWPR; HTSSOP-16-1EP_4.4x5mm_P0.65mm_EP3.4x5mm_Mask3x3mm_ThermalVi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; MPN DRV8876PWPR; LCSC C575551

Connections:
3V3: R63.1, U2.5 (VREF), U2.16 (PMODE); also elsewhere on the board
/02_drive_transformer/DRV_A: C11.1, D52.2 (A), D53.1 (K), U2.8 (OUT1)
/02_drive_transformer/DRV_B: C63.2, D54.2 (A), D55.1 (K), T1.5 (PRI_B), U2.10 (OUT2)
/02_drive_transformer/DRV_CPH: C62.1, U2.13 (CPH)
/02_drive_transformer/DRV_CPL: C62.2, U2.14 (CPL)
/02_drive_transformer/DRV_IMODE: R62.1, U2.7 (IMODE)
/02_drive_transformer/DRV_IPROPI: R61.1, U2.6 (IPROPI)
/02_drive_transformer/DRV_VCP: C61.1, U2.12 (VCP)
/02_drive_transformer/HV_BRIDGE: C10.1, C12.1, C60.1, C61.2, D50.1 (K), D51.1 (K), D52.1 (K), D54.1 (K), R60.1, R108.1, U2.11 (VM)
/02_drive_transformer/PRI_A: C11.2, R64.1, T1.1 (PRI_A)
/DRV_IN1: U2.1 (EN/IN1); also elsewhere on the board
/DRV_IN2: U2.2 (PH/IN2); also elsewhere on the board
/DRV_nSLEEP: R5.1, U2.3 (nSLEEP); also elsewhere on the board
/SEC_A: T1.7 (UNUSED_GUARD), T1.8 (SEC_A); also elsewhere on the board
/VIN_PROTECTED: D50.2 (A); also elsewhere on the board
BRIDGE_VMON: C92.1, R108.2, R109.1; also elsewhere on the board
DRV_nFAULT: R63.2, TP50.1, U2.4 (nFAULT); also elsewhere on the board
GND: C10.2, C12.2, C60.2, C92.2, D51.2 (A), D53.2 (A), D55.2 (A), R5.2, R60.2, R61.2, R62.2, R109.2, T1.6 (UNUSED_GUARD), T1.9 (SEC_B), T1.10 (UNUSED_GUARD), U2.9 (PGND), U2.15 (GND), U2.17 (EP); also elsewhere on the board
unnamed: C63.1, R64.2

Notes on the sheet:
INTERLOCKED INPUT / REGENERATION ENERGY CLAMP
Require >= 6 V requested input before HV enable; verify local VM >= 4.5 V under load. PWM <= 100 kHz.
FULL BRIDGE WITH INDUCTIVE TRANSIENT PROTECTION
PRI: 1-5; SEC: 8-9; FB: 2-4 unused. Pin 3 is primary center tap.
CHARGE PUMP DECOUPLING
RESONANT TRANSFORMER / OPTIONAL PRIMARY SNUBBER
Unwound terminals: 6 GND guard, 7 SEC_A guard, 10 GND guard.
D50 isolates returned energy; D51 clamps VM. C60 = 33uF to keep total PD sink capacitance below 100uF.
K1: regulated 3V coil; independent relay contacts gate BULK_CMD and DRV_SLEEP_CMD. GPIO23 senses coil feed through R92.
PMODE = 3V3: PWM mode. R61 sets 2.20 A trip; R62 selects cycle-by-cycle / latched OCP.
R64/C63 DNP: tune from measured primary ringing. Verify VM/OUT spikes, TVS energy and temperature on PCB.
OUTPUT RECIRCULATION CLAMPS / RESERVOIR BLEEDER
PWM BRIDGE / CURRENT LIMIT / FAULT TEST POINT
HV_BRIDGE / 11 -> ADS1115 AIN3 on sheet 01 (BRIDGE_VMON). 3.23 V at the 35.5 V D51 clamp. Nominal 20 V reads 1.82 V.

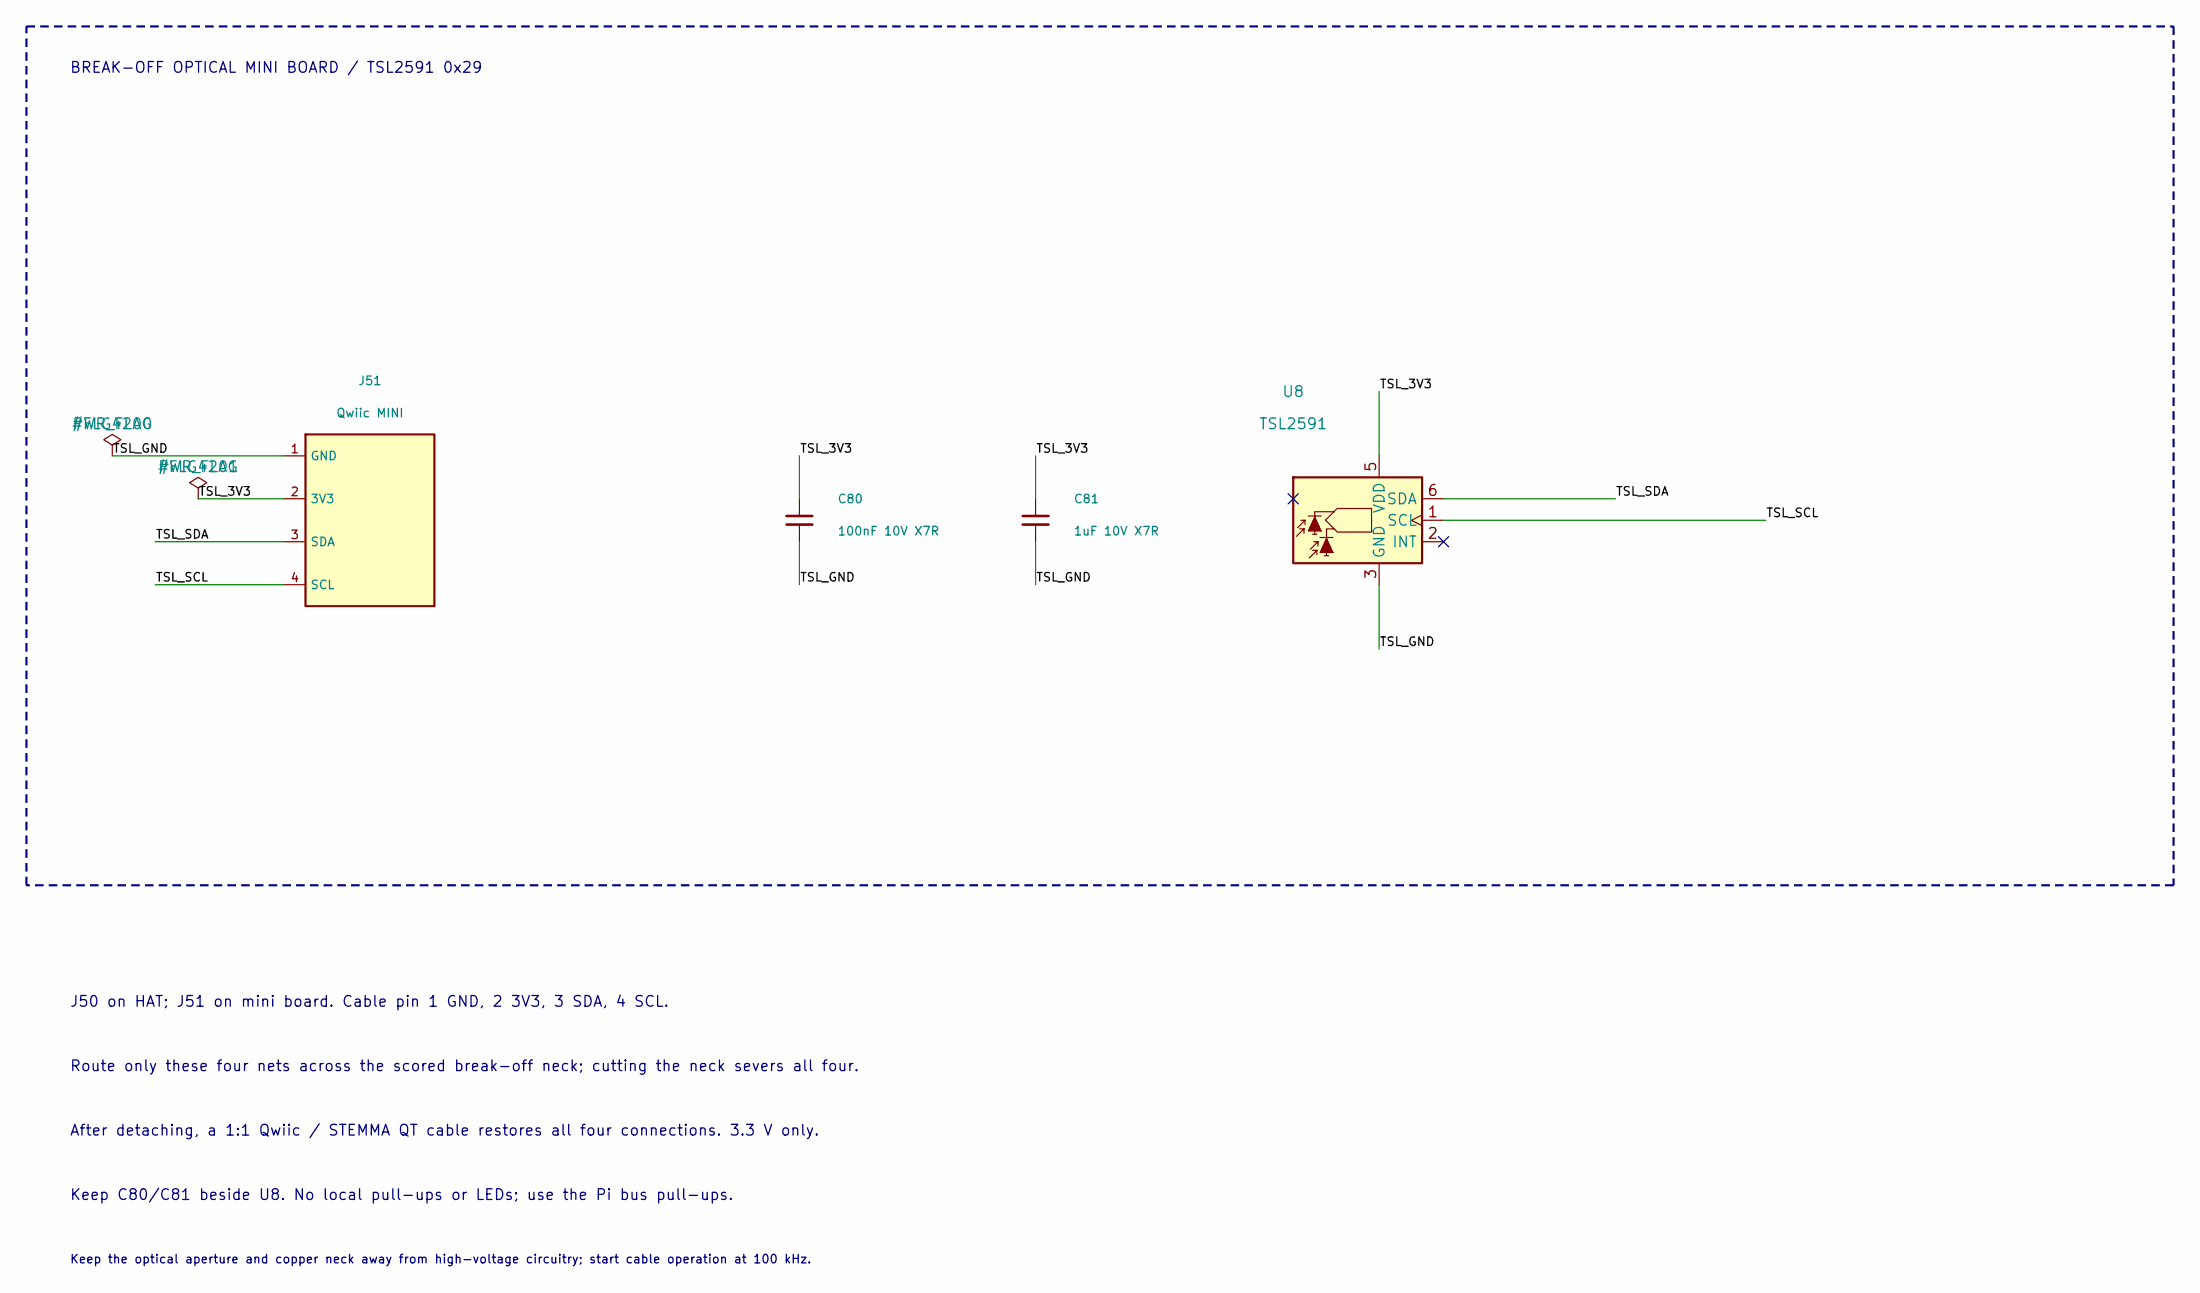
[picture p67: schematic 05_illumination.kicad_sch, 05 Illumination Break-off Mini Board]

Parts:
C80: 100nF 10V X7R; C_0603_1608Metric; MPN CC0603KRX7R9BB104; LCSC C14663
C81: 1uF 10V X7R; C_0603_1608Metric; MPN CL10B105KB8NQNC; LCSC C5199872
J51: Qwiic MINI; JST_SH_SM04B-SRSS-TB_1x04-1MP_P1.00mm_Horizontal; MPN SM04B-SRSS-TB(LF)(SN); LCSC C160404
U8: TSL2591; AMS_TSL25911FN; MPN TSL25911FN; LCSC C176812

Connections:
/05_illumination/TSL_3V3: C80.1, C81.1, J51.2 (3V3), U8.5 (VDD)
/05_illumination/TSL_GND: C80.2, C81.2, J51.1 (GND), U8.3 (GND)
/05_illumination/TSL_SCL: J51.4 (SCL), U8.1 (SCL)
/05_illumination/TSL_SDA: J51.3 (SDA), U8.6 (SDA)

Notes on the sheet:
BREAK-OFF OPTICAL MINI BOARD / TSL2591 0x29
Keep C80/C81 beside U8. No local pull-ups or LEDs; use the Pi bus pull-ups.
J50 on HAT; J51 on mini board. Cable pin 1 GND, 2 3V3, 3 SDA, 4 SCL.
Keep the optical aperture and copper neck away from high-voltage circuitry; start cable operation at 100 kHz.
After detaching, a 1:1 Qwiic / STEMMA QT cable restores all four connections. 3.3 V only.
Route only these four nets across the scored break-off neck; cutting the neck severs all four.

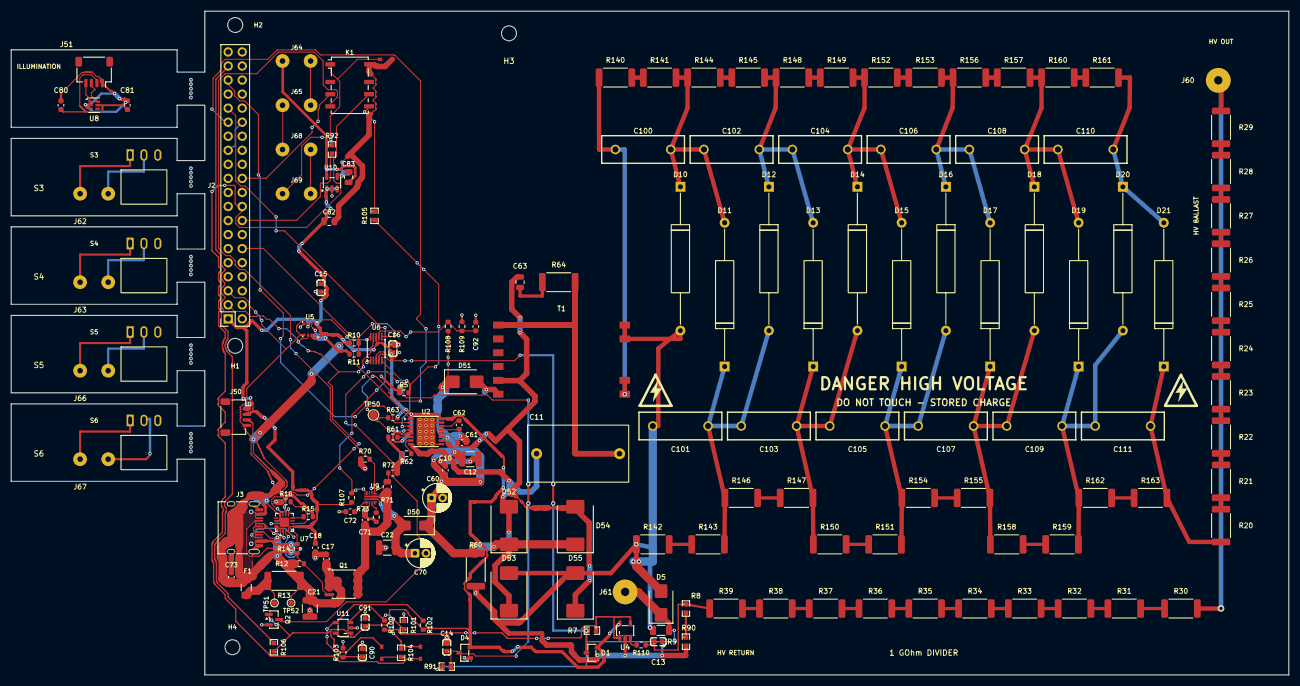
[picture p68: board pi5_corona_hv.kicad_pcb from above]

Board: 2 copper layers, 231.0 x 120.0 mm, 185 parts (0 on the bottom side), 115 nets.

Other parts of the board:
H1, H2, H3, H4: MountingHole_2.7mm_M2.5
MB1, MB2, MB3, MB4, MB5: Mousebite_5x0.5mm_P0.8mm
MP1: Raspberry Pi 5 — DNP MECHANICAL; Raspberry_Pi_5_Mechanical
R107: 10k; R_0603_1608Metric
TP51: ISENP KELVIN; TestPoint_Pad_D1.0mm
TP52: VBUS_IN KELVIN; TestPoint_Pad_D1.0mm

Their connections:
3V3: R107.1; also elsewhere on the board
/01_power_mcu/EFUSE_FLT: R107.2; also elsewhere on the board
/01_power_mcu/ISENP: TP51.1; also elsewhere on the board
/01_power_mcu/VBUS_IN: TP52.1; also elsewhere on the board
