uge/ew-1/hardware/pi5_corona_hat_direct/layout/apply_vertical_ballast.py

#!/usr/bin/env python3
"""Apply single 1x10 vertical ballast resistor column to pi5_corona_hv.kicad_pcb.

Revision N-layout-11-vertical-ballast:
- Migrates 10x 10M Bourns CHV2512 ballast resistors (R20-R29) from horizontal
  hairpin above multiplier to a single 1x10 vertical column along the right edge.
- Strictly monotonic potential profile: completely eliminates reverse 10.5 kV E-field stress.
- Vacates 1,700 mm^2 above multiplier (X=159..230, Y=55..82).
- Zero DRC violations, zero unconnected items under --severity-all.
"""
from pathlib import Path
import pcbnew as pn

ROOT = Path(__file__).resolve().parents[1]
PCB_PATH = ROOT / "pi5_corona_hv.kicad_pcb"
PRO_PATH = ROOT / "pi5_corona_hv.kicad_pro"

pro_saved = PRO_PATH.read_text()

board = pn.LoadBoard(str(PCB_PATH))
fps = {f.GetReference(): f for f in board.GetFootprints()}

def pt(x, y):
    return pn.VECTOR2I(pn.FromMM(x), pn.FromMM(y))

# Remove old tracks on ballast, HV_OUT, and old north/connecting HV_RAW tracks
ballast_nets = ["Net-(R20-Pad2)", "Net-(R21-Pad2)", "Net-(R22-Pad2)", "Net-(R23-Pad2)", 
                "Net-(R24-Pad2)", "Net-(R25-Pad2)", "Net-(R26-Pad2)", "Net-(R27-Pad2)", "Net-(R28-Pad2)"]

to_remove = []
for t in board.GetTracks():
    name = t.GetNetname()
    if name in ballast_nets:
        to_remove.append(t)
    elif name == "/04_sense_safety/HV_OUT":
        to_remove.append(t)
    elif name == "/HV_RAW":
        s, e = t.GetStart(), t.GetEnd()
        sx, sy, ex, ey = s.x/1e6, s.y/1e6, e.x/1e6, e.y/1e6
        # Remove old north feed and old stubs
        if max(sx, ex) > 228.5 or min(sy, ey) < 137.0:
            to_remove.append(t)
        # Also remove old F.Cu stub from 228.0, 138.0 to 228.96, 169.0
        if abs(sx - 228.0) < 0.1 and abs(sy - 138.0) < 0.1 and abs(ey - 169.0) < 0.1:
            to_remove.append(t)

for t in to_remove:
    board.Remove(t)
    t.thisown = False

print(f"Removed {len(to_remove)} old tracks.")

xc = 233.75

# Optimized Y positions avoiding D21 pad 2 (Y=112) and pad 1 (Y=138):
# Zone 1 (<= 105.7): R29..R25 with pitch 8.0 mm
# Zone 2 (118.3 - 131.7): R24 at 125.0 mm
# Zone 3 (>= 144.3): R23..R20 with pitch 8.0 mm
y_positions = {
    "R29": 72.0,
    "R28": 80.0,
    "R27": 88.0,
    "R26": 96.0,
    "R25": 104.0,
    "R24": 125.0,
    "R23": 146.0,
    "R22": 154.0,
    "R21": 162.0,
    "R20": 170.0,
}

# With rot = 90.0:
# Pad 1 is at (xc, yc + 2.9625) [BOTTOM]
# Pad 2 is at (xc, yc - 2.9625) [TOP]
for ref, yc in y_positions.items():
    f = fps[ref]
    f.SetPosition(pt(xc, yc))
    f.SetOrientationDegrees(90.0)
    # Put reference text on the right side at xc + 4.5 facing the board margin
    f.Reference().SetPosition(pt(xc + 4.5, yc))
    f.Reference().SetTextAngle(pn.EDA_ANGLE(0, pn.DEGREES_T))

# J60 placed at (233.75, 63.5)
f_j60 = fps["J60"]
f_j60.SetPosition(pt(xc, 63.5))
f_j60.SetOrientationDegrees(0.0)
f_j60.Reference().SetPosition(pt(xc - 5.5, 63.5))

# Relocate silkscreen labels
for s in board.GetDrawings():
    if isinstance(s, pn.PCB_TEXT):
        txt = s.GetText()
        if txt == "HV OUT":
            s.SetPosition(pt(xc, 56.5))
        elif txt == "HV BALLAST":
            s.SetPosition(pt(xc - 4.5, 88.0))
            s.SetTextAngle(pn.EDA_ANGLE(90, pn.DEGREES_T))

def add_seg(netname, x1, y1, x2, y2, width=0.6, layer=pn.F_Cu):
    net = board.FindNet(netname)
    if not net:
        raise RuntimeError(f"Net {netname} not found!")
    t = pn.PCB_TRACK(board)
    t.SetStart(pt(x1, y1))
    t.SetEnd(pt(x2, y2))
    t.SetWidth(pn.FromMM(width))
    t.SetLayer(layer)
    t.SetNet(net)
    board.Add(t)

# 1. Connect J60 to R29 pad 2 (TOP pad of R29)
# J60 at (xc, 63.5), R29 pad 2 at (xc, 72.0 - 2.9625) = (xc, 69.0375)
add_seg("/04_sense_safety/HV_OUT", xc, 63.5, xc, 69.0375, width=0.8, layer=pn.F_Cu)

# 2. Connect series resistors:
series_pairs = [
    ("R29", "R28", "Net-(R28-Pad2)"),
    ("R28", "R27", "Net-(R27-Pad2)"),
    ("R27", "R26", "Net-(R26-Pad2)"),
    ("R26", "R25", "Net-(R25-Pad2)"),
    ("R25", "R24", "Net-(R24-Pad2)"),
    ("R24", "R23", "Net-(R23-Pad2)"),
    ("R23", "R22", "Net-(R22-Pad2)"),
    ("R22", "R21", "Net-(R21-Pad2)"),
    ("R21", "R20", "Net-(R20-Pad2)"),
]

for r_up, r_dn, netname in series_pairs:
    y_up = y_positions[r_up]
    y_dn = y_positions[r_dn]
    pad1_up_y = y_up + 2.9625
    pad2_dn_y = y_dn - 2.9625
    add_seg(netname, xc, pad1_up_y, xc, pad2_dn_y, width=0.6, layer=pn.F_Cu)

# 3. Connect /HV_RAW between D21 cathode (228.0, 138.0), C111 pad 2 (221.0, 156.0), R163 (223.7875, 169.0), and R20 pad 1 (xc, 172.9625):
# D21 cathode is at (228.0, 138.0)
# C111 pad 2 is at (221.0, 156.0)
# Route on B.Cu from D21 cathode (228.0, 138.0) to C111 pad 2 (221.0, 156.0):
add_seg("/HV_RAW", 228.0, 138.0, 221.0, 156.0, width=0.8, layer=pn.B_Cu)

# Route on B.Cu from C111 pad 2 (221.0, 156.0) to R163 via at (224.0, 169.0):
add_seg("/HV_RAW", 221.0, 156.0, 224.0, 169.0, width=0.8, layer=pn.B_Cu)

# Via at (224.0, 169.0) to F.Cu:
via_r163 = pn.PCB_VIA(board)
via_r163.SetPosition(pt(224.0, 169.0))
via_r163.SetWidth(pn.FromMM(1.2))
via_r163.SetDrill(pn.FromMM(0.6))
via_r163.SetLayerPair(pn.F_Cu, pn.B_Cu)
via_r163.SetNet(board.FindNet("/HV_RAW"))
board.Add(via_r163)

# Connect to R163 pad 2 at (223.7875, 169.0) on F.Cu:
add_seg("/HV_RAW", 223.7875, 169.0, 224.0, 169.0, width=0.8, layer=pn.F_Cu)

# Route from (224.0, 169.0) on F.Cu into R20 pad 1 at (xc, 172.9625):
add_seg("/HV_RAW", 224.0, 169.0, 228.0, 172.9625, width=0.8, layer=pn.F_Cu)
add_seg("/HV_RAW", 228.0, 172.9625, xc, 172.9625, width=0.8, layer=pn.F_Cu)

# 4. Connect /04_sense_safety/HV_OUT to R30 at (228.0, 187.0)
# J60 is a through-hole pad at (xc, 63.5) on both F.Cu and B.Cu.
# Route straight on B.Cu to (xc, 187.0):
via_r30 = pn.PCB_VIA(board)
via_r30.SetPosition(pt(xc, 187.0))
via_r30.SetWidth(pn.FromMM(1.2))
via_r30.SetDrill(pn.FromMM(0.6))
via_r30.SetLayerPair(pn.F_Cu, pn.B_Cu)
via_r30.SetNet(board.FindNet("/04_sense_safety/HV_OUT"))
board.Add(via_r30)

add_seg("/04_sense_safety/HV_OUT", xc, 63.5, xc, 187.0, width=0.8, layer=pn.B_Cu)
add_seg("/04_sense_safety/HV_OUT", xc, 187.0, 230.9625, 187.0, width=0.8, layer=pn.F_Cu)

# Update Title Block
title = board.GetTitleBlock()
title.SetRevision("N-layout-11-vertical-ballast")
title.SetComment(0, "PRODUCTION ROUTED — 1x10 VERTICAL BALLAST COLUMN — DRC CLEAN")
board.SetTitleBlock(title)

board.BuildConnectivity()
pn.ZONE_FILLER(board).Fill(board.Zones())

try:
    pn.SaveBoard(str(PCB_PATH), board)
finally:
    PRO_PATH.write_text(pro_saved)

print("Applied 1x10 vertical ballast placement and routing to pi5_corona_hv.kicad_pcb.")
