uge/ew-1/(commit log)

2026-10-03 Checkpoint KiCad 10 Pi 5 HV redesign and routing trials
    Initial project snapshot including native schematics, PCB placements, component libraries, procurement records, documentation, and mechanical models.
    Includes the in-progress counterclockwise Pi rotation, separated HV wire terminations, detachable microswitch boards, compact two-layer placement, and KiCadRoutingTools control-net trials. Routing and final documentation/export refresh remain incomplete.
2026-10-11 feat: add break-away tab mousebites and consolidate 1-line-per-part BOM
2026-10-11 feat: generate clean JLCPCB gerbers, bom, and cpl
2026-10-11 feat(hw): migrate USB-PD sink controller to HUSB238A with PPS and AO4407A P-MOSFET
    - Replace out-of-stock AP33772S with Hynetek HUSB238A-BB001-QN16R (QFN-16 3x3mm, LCSC C24833806) with PPS support
    - Replace high-side P-MOSFET with Alpha & Omega AO4407A (SO-8, -30V, -12A, LCSC C16072)
    - Update gate control network with R12 (100k pull-up, C25803) and R14 (47k series, C25816)
    - Add R15 (1M ADDR, C22935) for 0x42 I2C address and R16 (1M DEBUG_N pulldown, C22935)
    - Add C18 (1uF 16V 10% 0603, C15849) for HUSB238A VDD decoupling
    - Re-route low-voltage USB-PD section with 0 DRC violations and 0 unconnected items
    - Maintain 100% KiCad 10 format compliance (110/110 files verified)
    - Pass native schema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
2026-10-11 fix(cpl): export CPL in millimeters with standard 5-column JLCPCB format
    - Re-export raw positions with '--units mm' to eliminate 25.4x scaling discrepancy
    - Update CPL format to strict JLCPCB 5-column standard (Designator, Mid X, Mid Y, Layer, Rotation)
    - Normalize all rotation angles to [0.0, 360.0) range to prevent negative degree parsing errors
    - Retain accurate centroid override for J2 header (55.5000, -82.5000) and rotation offset (90.0 deg)
2026-10-11 fix(dfm): correct component rotations and centroids for JLCPCB SMT and migrate J3 to TYPE-C-31-M-12
    - Audit all 120 assembled components against JLCPCB/EasyEDA SMT tape conventions:
    - Correct rotation offsets for Q1 (270°), U2 (270°), U5 (90°), U6 (270°), U7 (270°), U8 (270°), U10 (180°), K1 (270°), and D52-D55 (180°)
    - Apply physical centroid overrides for J2 (55.5, 82.5), J3 (88.0, 56.173), C11 (117.5, 131.0), C60 (98.0, 147.0), and C70 (98.0, 104.0)
    - Migrate USB-C receptacle J3 to Korean Hroparts TYPE-C-31-M-12 (LCSC C165948) with 3D model and verified footprint
    - Re-export clean Gerbers, drill files, jlcpcb-bom.csv, and jlcpcb-cpl.csv
    - Re-render high-resolution top and iso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
2026-10-19 fix(pi5_corona_hat_direct): remediate T1 pinout, HUSB238A 5V-20V I2C, current-limit hierarchy, and HV hole clearances
    - Correct Coilcraft FL2015-4LD (T1) primary-side pad numbering (Pads 1-6)
    to match Document 293-2 counter-clockwise pinout (Pad 1 opposite Pad 10,
    Pad 6 opposite Pad 7), embed its 3D STEP model on the PCB, and re-route
    PRI_A, DRV_B, and GND (T1.6).
    - Restore U7 (HUSB238A-BB001-QN16R) Pin 5 (VDD) to 3V3 on schematic and PCB
    for safe 5V USB-C PD startup default while preserving 5-20V I2C
    programmability at address 0x42.
    - Set R61 (DRV8876 IPROPI) to 1.5k 1% (C22843, I_TRIP = 2.20A) and R73
    (TPS259470 ILM) to 1.2k 1% (C22765, I_LIM = 2.78A) for proper current-limit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
2026-10-19 Alternate top/bottom CW multiplier stage routing and redesign LV power spine
    - Alternate F.Cu and B.Cu across all 10 Cockcroft-Walton multiplier stages
    (CW_P1..CW_P5 and CW_S1..CW_S5) plus /SEC_A, Net-(D20-K), GND, and /HV_RAW
    in a 2D checkerboard across the 1.6mm FR-4 substrate, eliminating all 11
    internal HV multiplier vias.
    - Shift top bleeder rows R140..R161 from Y=(61,69) to Y=(56,64) (+5.0mm clearance
    to C100..C110).
    - Reposition R10, R11, D50, D51, C10, C12, C61, C62, R61, R62, R63, and TP50
    around U2 to establish a straight 1.50mm East power delivery spine
    (/VIN_PROTECTED and /02_drive_transformer/HV_BRIDGE) with 0 vias on HV_BRIDGE,
    1.00mm DRV_A/DRV_B trunks, and thick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
2026-10-20 Archive N-layout-14-surge and save optimized PCB routing
    Optimize LV placement and complete two-layer routing with wider power
    trunks. Shorten the HV return clamp path to 8.219 mm and the shunt path
    to 11.625 mm, both with no intervening layer changes. Preserve the prior
    working revisions and document the current placement and qualification
    limits.
    Archive all 542 versioned/nonignored project files, including working-tree
    changes, libraries, models, reports and revision history. Include a per-file
    SHA-256 manifest and an archive checksum; verify all archived payloads.
    Validation: saved native KiCad 10.0.7 DRC/ERC reports show zero violations,
    open connections and schematic parity issues; 1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
2026-10-21 fix(pi5_corona_hat_direct): apply design-review fixes (HV edge rules, hardware OV trip, telemetry)
    H1: move pumping-column bleeders R140-R161 into one row at y=63 so every HV
    pad is >=10 mm from Edge.Cuts; add "HV_STAGE to board edge" DRU rule.
    H2: add latched hardware overvoltage trip (U11 TLV7031, 16.96 kV nominal):
    Q2 pulls DRV_nSLEEP low via R105, D90/R104 latch, D91 resets from
    DRV_SLEEP_CMD, trip reported on GPIO26 (J2.37).
    H3: add voltage-tiered HV stage-to-LV clearance rules (4/6/8/10 mm).
    M1: route DRV_nFAULT to GPIO5, U9 FLT to GPIO6 (R107 pull-up), and
    HV_BRIDGE/11 (R108/R109/C92) to ADS1115 AIN3; reroute PD_VMON, DRV_IN2,
    EFUSE_DVDT, DRV_nSLEEP and move C72 to make room; rejoin G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
2026-10-21 fix(pi5_corona_hat_direct): correct R14/C18 part numbers and clear HV insulation criticals
    Part numbers:
    - R14: C25816 -> C25819 (0603WAF4702T5E, 47k). C25816 is a 383k part and
    would have under-driven Q1's gate.
    - C18: keep C15849, correct MPN to CL10A105KB8NNNC (1uF 50V X5R, Basic).
    Insulation (IPC-2221 B4 0.00305 mm/V screening):
    - map_board_voltages.py: add opt-in --coherent CW model (pump nodes =
    DC + k*SEC_A); write voltage_audit_report_coherent.json alongside the
    envelope report. 27 of 51 envelope criticals were model artifacts.
    - Stagger D10-D21 +/-3.25 mm so adjacent stage pads are >=7.63 mm apart
    (was 6.2 mm); D21 0.6 mm left of the ballast column; reroute one CW_S5
    B.Cu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
